SeanEZhou/slender-biped/README.md

# Slender-leg biped: can an ankle-less, footless robot leg balance and walk?

<table>
<tr>
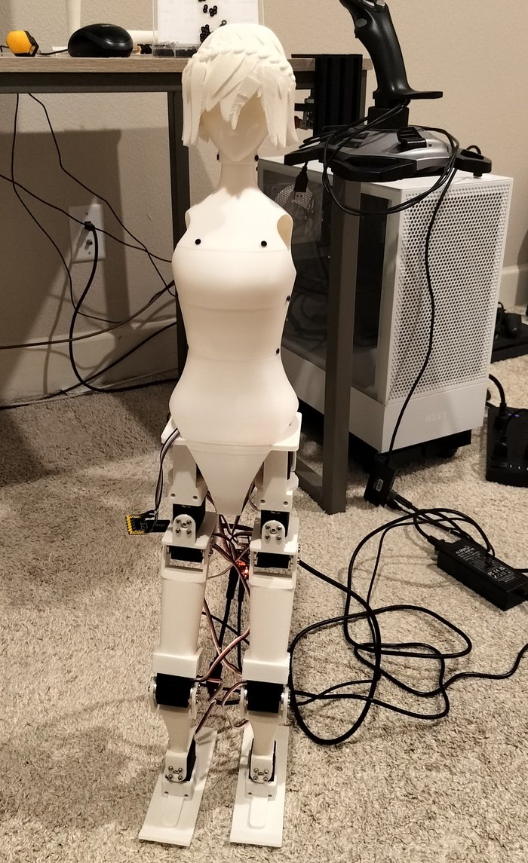
[picture p1: assets/photos/robot_standing.jpg]
The assembled robot standing on its snowboard pads
<td valign="top"><br><sub>The robot today: two printed legs with ankle roll, ten hobby servos, torso and head.</sub></td>
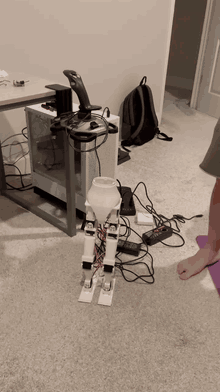
[picture p2: assets/gifs/real_legs_walk.gif]
The legs walking on their own
<td valign="top"><br><sub>First walk on the robot: legs and pelvis, policy <code>c3m_T12</code>, 10+ steps in most trials (§16).</sub></td>
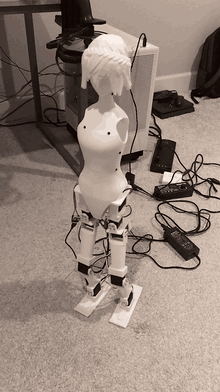
[picture p3: assets/gifs/real_full_body_1.gif]
The full robot marching under its own balance
<td valign="top"><br><sub>Full body, policy <code>c3f_T12</code>: balancing on its own while it marches, mostly in place.</sub></td>
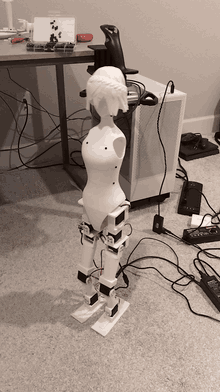
[picture p4: assets/gifs/real_full_body_2.gif]
The full robot marching, side view
<td valign="top"><br><sub>The same policy from another angle. No hand steadying it: every step is closed-loop on the IMU.</sub></td>
</tr>
</table>

### Where this project stands, and the pivot to ankles

The study began with a question: can a leg with **no ankle and no foot** (a slender shin ending in a tip) balance
and walk? **In simulation, yes.** The tip and small-pad designs stand, walk and stop on command (§3–8). **On the real
robot, no.** Every ankle-less design we built could stand, but none could walk:

- **The tip foot** (§14) stood still for minutes once set down in balance. But any step or push tipped it, because it
  balances only by correcting constantly, and the real servos react 4–9× later than the simulator first assumed.
- **Big snowboard pads without an ankle** (§15–16) stand almost passively. But each step began a sideways fall toward
  the lifted foot, even with a hip-roll weight shift first.

**The lesson: a frame that works in simulation only through precise, constant small corrections won't transfer.** The
real robot has servo lag, backlash, a slow motion profile, IMU error and a floor the model doesn't capture. A design
that needs every correction on time is flipped over by the first late one. A frame that transfers needs room for
error: a stance that holds while the controller is late or wrong.

So the design pivoted to **one ankle roll servo per leg** (§16). The hips and ankles lean both legs together, so the
weight moves over one flat board, and lifting the other foot is no longer a fall. With that, plus a calmer gait
trained by imitation and against wobble, the robot took its first real walks: 10+ steps in most trials with the legs
alone, and stable marching with the torso and head on.

Everything the project has learned, from servo modelling to reward weights to robot bring-up, is collected in
**[docs/lessons.md](docs/lessons.md)**.

**Contents**
- **The study:** [1. Concept](#1-concept) · [2. Design](#2-design-before-any-training) · [3. Training](#3-training) · [4. Results](#4-results)
- **Toward the real robot:** [5. P0 printable leg](#5-toward-hardware-the-p0-printable-leg) · [6. Training on the as-built model](#6-training-on-the-as-built-model) · [7. Real steps](#7-walking-with-real-steps-round-4) · [8. Walking on a line](#8-walking-on-a-line-round-5)
- **Building the body:** [9. Torso](#9-torso-design) · [10. Head](#10-head-design) · [11. Power delivery](#11-power-delivery) · [12. Full-body assembly and load test](#12-full-body-assembly-and-load-test) · [13. IMU](#13-imu)
- **On the robot:** [14. Sim to real: standing and recovering](#14-sim-to-real-standing-and-recovering-on-the-robot) · [15. Big feet for soft rugs](#15-big-feet-for-soft-rugs) · [16. Walking on the big pads](#16-walking-on-the-big-pads)
- **Reference:** [Lessons learned](docs/lessons.md) · [Engineering practices](#engineering-practices) · [Reproduce](#reproduce) · [Repository map](#repository-map) · [Limitations and next steps](#limitations-and-next-steps)

An end-to-end robotics design study:
1. **Concept:** a novel leg concept from character art.
2. **Physical model:** built from off-the-shelf servos with realistic mass, packaging and motor
   limits.
3. **Training:** GPU-trained reinforcement-learning policies.
4. **Validation:** an independent evaluation that tests whether the design actually works.

<table>
<tr><th></th><th>Stand (zero command)</th><th>Walk (0.15 m/s command)</th></tr>
<tr>
<th>Ball tip<br><sub>original concept</sub></th>
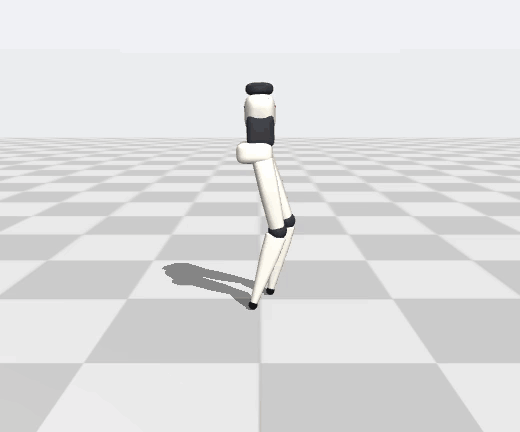
[picture p5: assets/gifs/stand.gif]
<td valign="top"><br><sub>balances by micro-stepping</sub></td>
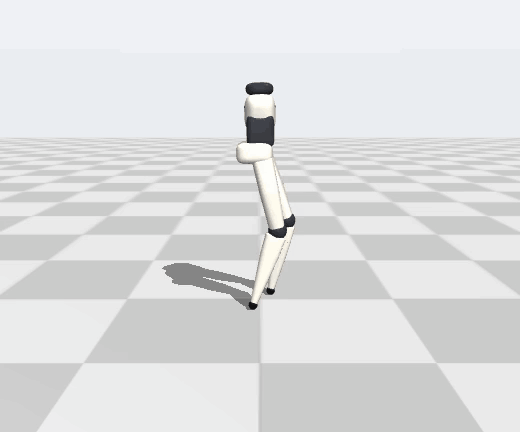
[picture p6: assets/gifs/walk.gif]
<td valign="top"></td>
</tr>
<tr>
<th>30 mm flat pad<br><sub>same leg, flat tip</sub></th>
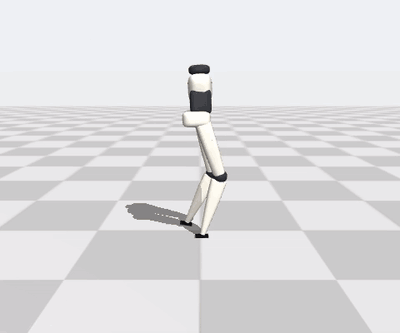
[picture p7: assets/gifs/pad30_stand.gif]
<td valign="top"><br><sub>stands still</sub></td>
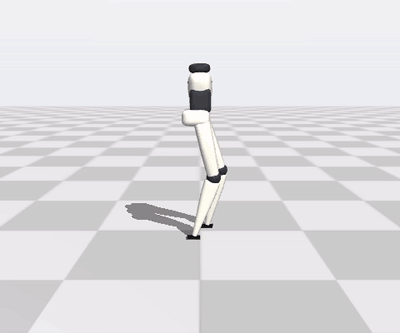
[picture p8: assets/gifs/pad30_walk.gif]
<td valign="top"></td>
</tr>
<tr>
<th>As built<br><sub>model from the printed CAD<br>and the real servos (§6)</sub></th>
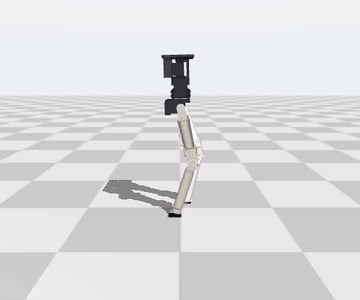
[picture p9: assets/gifs/hw_p0_stand_push.gif]
<td valign="top"><br><sub>stands still and recovers from 0.3 m/s shoves</sub></td>
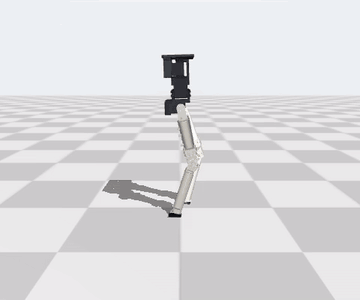
[picture p10: assets/gifs/hw_p0_walk_r5.gif]
<td valign="top"><br><sub>real steps on a straight, narrow "catwalk" line (§7–8)</sub></td>
</tr>
</table>

<p><b>Real hardware:</b> the printed P0 left leg (§5), bench-tested on a 5 V supply: sit-up on its own pad, kick, hip yaw.</p>
<p>
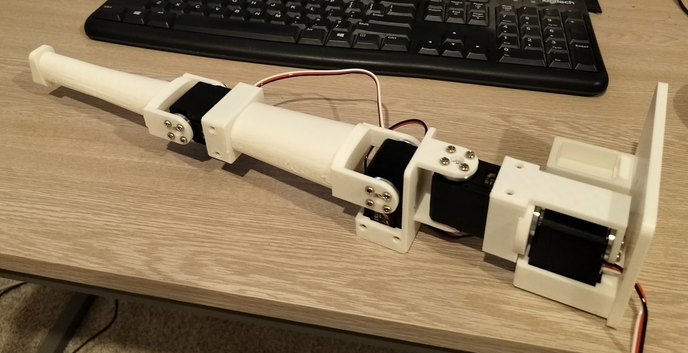
[picture p11: assets/photos/p0_leg_assembled.jpg]
Assembled P0 leg

</p>
<p>
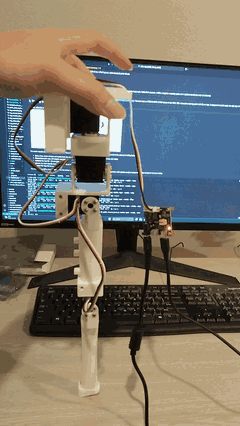
[picture p12: assets/gifs/bench_sit_up.gif]
Sit-up on the pad

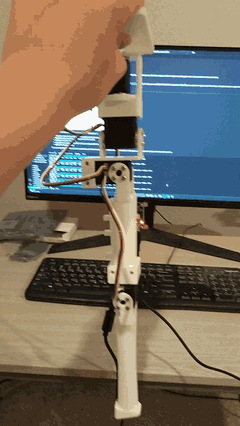
[picture p13: assets/gifs/bench_kick.gif]
Kick

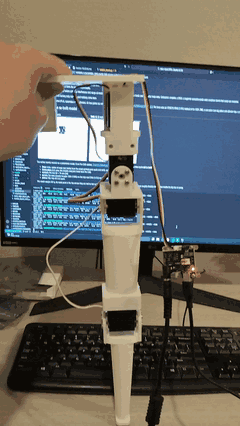
[picture p14: assets/gifs/bench_yaw.gif]
Hip yaw

</p>

**TL;DR**
- **The ball-tip design works dynamically.** A 38 cm, 0.85 kg biped on two 16 mm rubber balls,
  driven by eight off-the-shelf hobby servos (~$180 in total), stands indefinitely, walks straight and stops on command in
  simulation, with every servo inside its ratings.
- **It can never stand still.** It balances by micro-stepping about 6 times a second, under every
  reward and control variant I tried, including ideal sensors and 100 Hz control.
- **Feet are not the whole story.** Control experiments show that any flat contact removes the
  stepping. An ankle is not needed. Feet did not, however, fix the short walking steps.
- **A 30 × 18 mm flat pad at the shin tip is a viable compromise.** It keeps the silhouette and
  stood without lifting a tip in 85 % of runs. Training found that stance on 1 of 2 seeds.
- **The as-built robot works too (§6).** Retrained on a model generated from the printable CAD and the servos
  actually bought, it stands still (98 % without lifting a pad), survives shoves, and walks at 0.18 m/s while
  stopping on command 98 % of the time. Walking draws about 1.5 A at 7.4 V, with ~9 A peaks.
- **Real steps instead of a skitter (§7).** Every earlier walker took 5–7 tiny hops a second (2 cm, 60 ms in the
  air). Imitating a reference gait, with more double support, gives a walk with 6 cm steps, 160 ms of
  swing and 2 cm of foot clearance at 0.16 m/s, reproduced on 2 of 2 seeds; a curriculum narrows it into an
  elegant catwalk line. The cost: ~2.2 A instead of 1.5 A, with the hip servos at their rated torque.
- **Walking on a line, not drifting sideways (§8).** Those walkers held their heading but crabbed off it, and only
  ~20 % of walks passed 2 m within 0.2 m of the line: the policy had no way to sense sideways drift. Feeding it a
  path-offset estimate and rewarding the true offset fixes most of it. With leg odometry alone 40–78 % of walks stay on
  the line (depending on the training seed); with a ~$15 downward optical-flow sensor **100 %, with a median offset of
  4 cm**, a 61 mm catwalk track, and better stops (walk → stop → walk 98 %, no falls).

> **Status: walking on the robot, early.** With an ankle roll servo per leg (10 servos), trained walking policies run
> on the robot. The legs and pelvis take 10+ steps in most trials (`c3m_T12`). With the torso and head on, the robot
> balances and marches, mostly in place, and its servos buzz (`c3f_T12`, §16). The ankle-less designs that the
> earlier sections study work in simulation but not on the robot (§14, §16). Quiet standing on the IMU transfers (§14).
> The other standing and walking numbers come from held-out evaluation seeds in an independent simulator. Simulated
> feasibility is not validated hardware capability.

---

## 1. Concept

Android characters like [Aigis](https://hero.fandom.com/wiki/Aigis) and
[Elster](https://signalis.fandom.com/wiki/Elster_(LSTR-512)) have legs that taper to a narrow point:
no visible ankle and little or no foot. Real bipeds almost never look like this. They rely on wide
feet and ankle torque to move their centre of pressure.

<table>
<tr><th>Concept</th><th>My physical model (baseline A)</th></tr>
<tr>
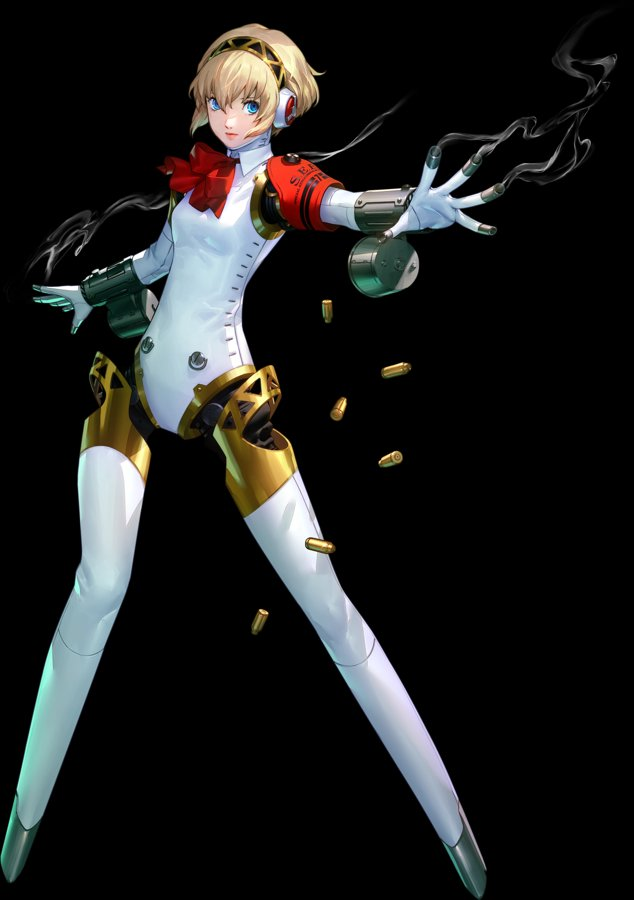
[picture p15: assets/concept/aigis_small.jpg]
<td></td>
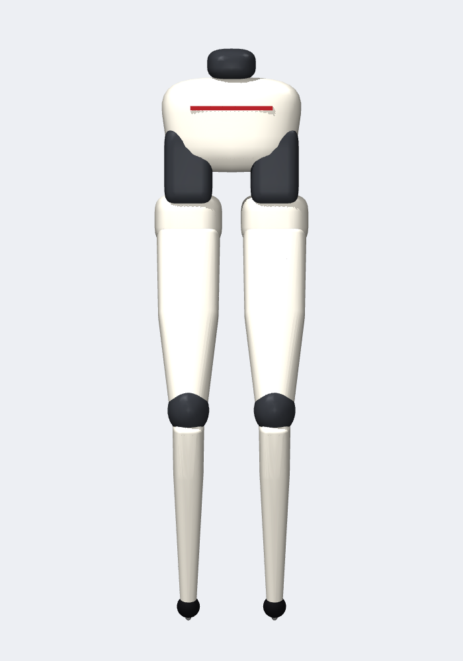
[picture p16: assets/renders/baseline_A_8dof/front_ortho.png]
<td></td>
</tr>
</table>
<sub>Concept art: Aigis, official artwork from <i>Persona 3</i> (© ATLUS), via the
<a href="https://hero.fandom.com/wiki/Aigis">Aigis wiki page</a>. Not my work; shown as design
reference for a non-commercial project and will be removed on request.</sub>
<br><br>

**The question:** can a hobby-scale biped with narrow hips, slender tubular legs, **no ankle and
no foot** learn to balance and walk, using parts anyone can buy? If not, what is the smallest
change to the silhouette that makes it work?

Why it is hard:
- **No support polygon.** A ball-tipped leg touches the floor at a single point. Two point
  contacts give no area to keep the centre of mass over, so the robot can tip about the line
  between them.
- **Weak, slow actuators.** Hobby servos are slow and torque-limited. A policy that only works with
  ideal actuators would be meaningless here.

## 2. Design (before any training)

### 2.1 Size and proportions

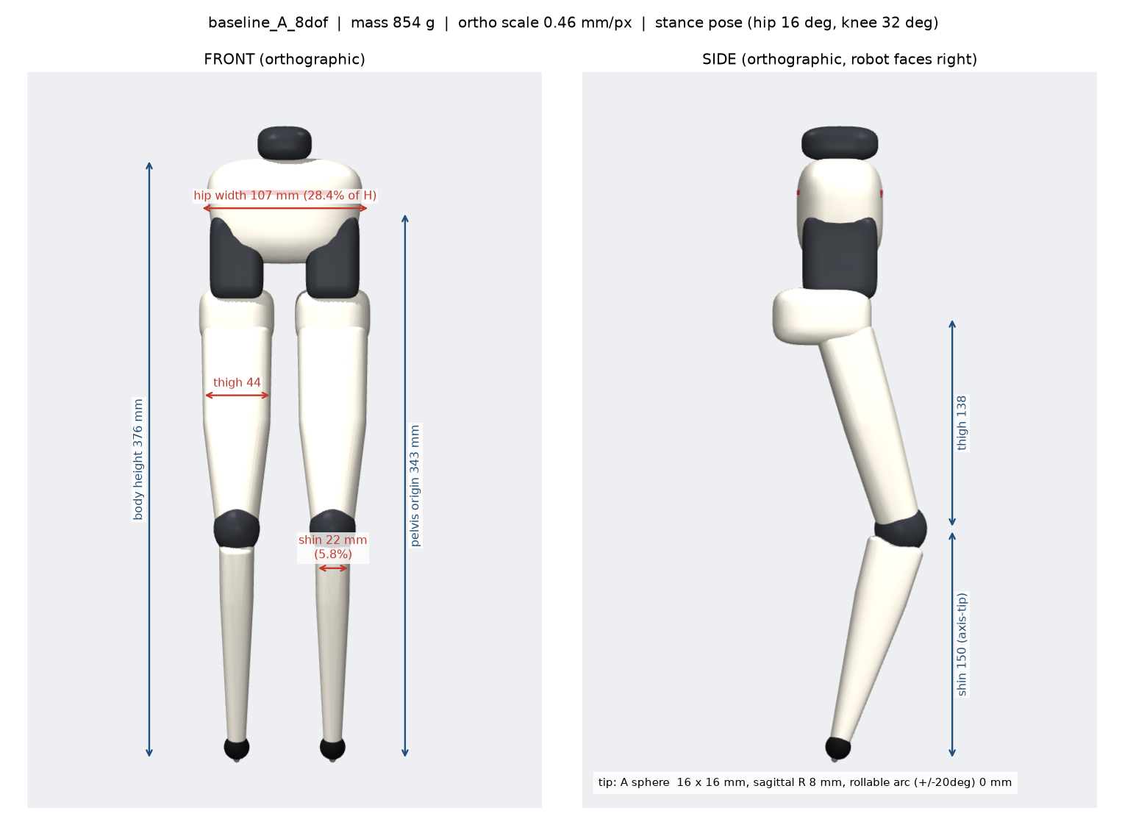
[picture p17: assets/renders/baseline_A_8dof/silhouette_dimensioned.png]


- **Scale:** I wanted a narrow pelvis and long, slim legs to get the slender, graceful form factor,
  at a hobby scale where cheap servos are credible: pelvis about 0.30–0.35 m off the ground and a
  0.6–1.0 kg lower body. The result is 38 cm tall and 0.85 kg.
- **Leg lengths:** thigh 138 mm, shin 150 mm (a long shin for the slender look).
- **Slimness targets:** hip width ≤ 24–28 % of height and shin width ≤ 9–12 %.
  - The shin reached **5.8 %**.
  - The hips reached **28.4 %**, just over the target: the 25 mm-thick servo cases set the floor.
- **Parametric generator:** the whole body comes from [`configs/geometry.yaml`](configs/geometry.yaml)
  as superellipse shells. Every part carries its real mass and inertia (servos, printed shells,
  brackets, electronics, battery), so the simulated centre of mass matches the CAD estimate.

### 2.2 Choosing off-the-shelf actuators

| candidate | stall torque | no-load speed | price | verdict |
|---|---|---|---|---|
| Feetech STS3215-C018 (12 V) | 2.94 N·m | 4.7 rad/s (45 rpm) | $32 | ✗ the knee can't swing faster than ~1 step/s |
| **Feetech STS3215-C046 (7.4 V)** | 1.41 N·m | 11.1 rad/s (106 rpm) | $25 | ✓ **roll, pitch and knee**, same 45 × 25 × 35 mm case |
| **Feetech STS3032 (6 V)** | 0.44 N·m | 11.6 rad/s | $15 | ✓ **hip yaw** (low load, small case) |
| ROBOTIS XC330 / XL330 | 0.92 / 0.52 N·m | 6.8 / 10.8 rad/s | $103 / $24 | slimmer hips, but speed-limited and ~3.4× the cost |

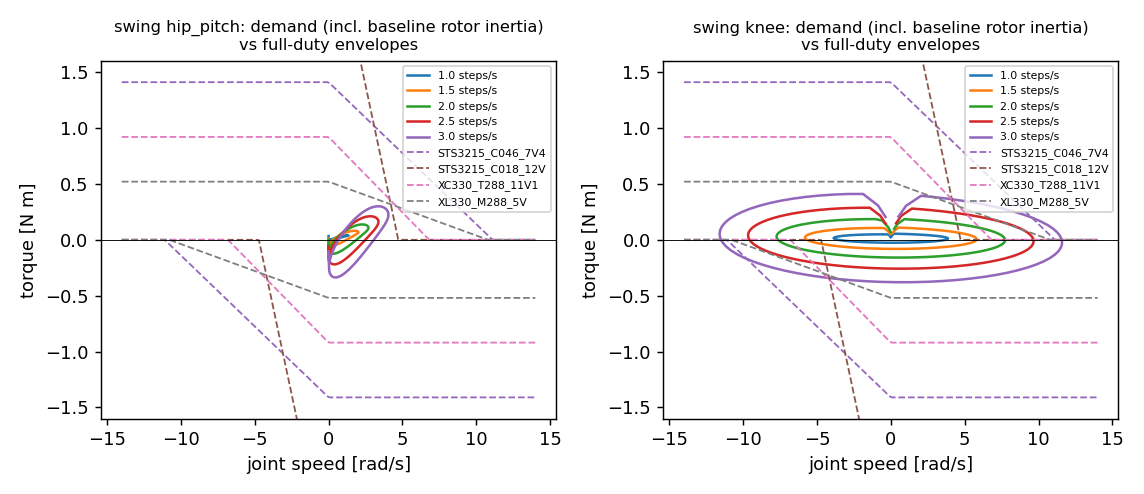
[picture p18: results/plots/swing_torque_speed_baseline_A_8dof.png]


The torque-speed audit above (`scripts/torque_audit.py`) runs before any learning. It overlays
the torque and speed that leg swing demands at 1–3 steps/s on each servo's DC-motor envelope:
- **Speed binds, not torque.** The 12 V servo has twice the torque, but its envelope collapses
  above ~4.7 rad/s, so it was rejected without spending any GPU time.
- **Choice:** the 7.4 V variant in the same case. Eight servos cost about **$180**.
- **Servo model:** every servo is simulated with its torque-speed curve, current limit, 4 ms bus
  latency, deadband, slew limit and reflected rotor inertia.

### 2.3 Servo placement and motion

<table>
<tr>
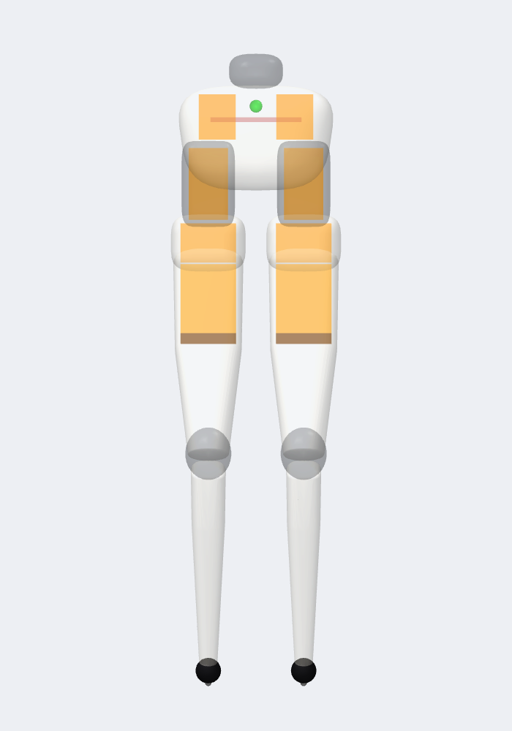
[picture p19: assets/renders/baseline_A_8dof/xray_front_ortho.png]
<td></td>
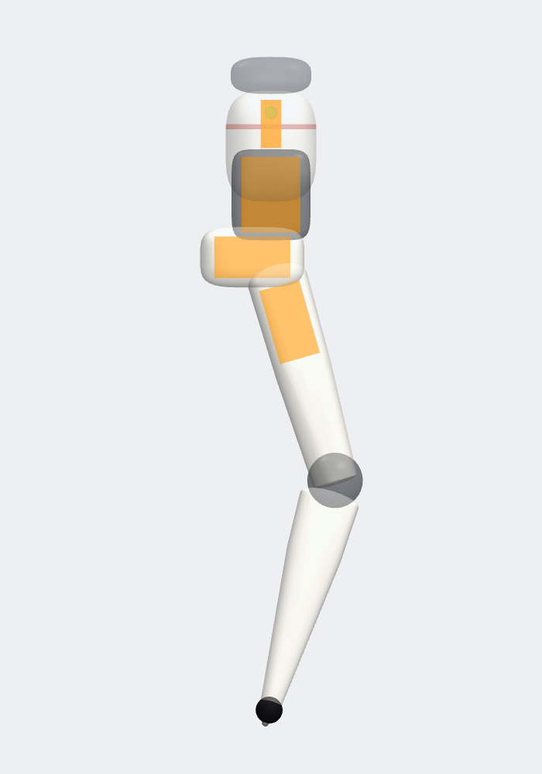
[picture p20: assets/renders/baseline_A_8dof/xray_side_ortho.png]
<td></td>
</tr>
</table>

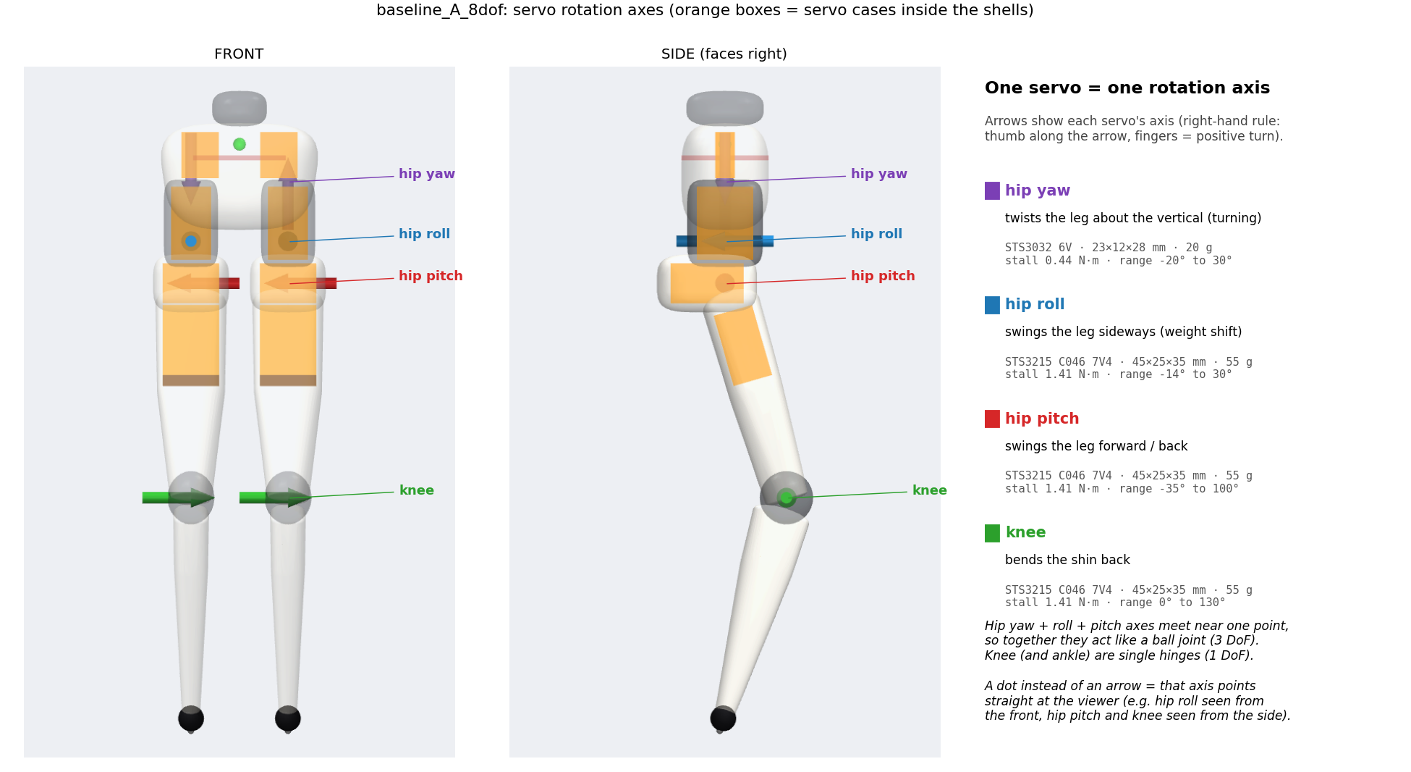
[picture p21: assets/renders/baseline_A_8dof/joint_axes.png]


- **Four servos per leg.** Hip yaw, roll and pitch sit stacked at the pelvis with their axes meeting
  near one point, so together they act like a ball joint. The knee is a single hinge.
- **Remote knee drive.** The knee servo lives in the upper thigh and drives the knee through a 1:1
  GT2 belt. That keeps the knee joint as slim as the concept art.
- **Packaging check.** It verifies that every servo case fits inside its printed shell with a
  1.2 mm wall.

### 2.4 Design candidates and pre-training screening

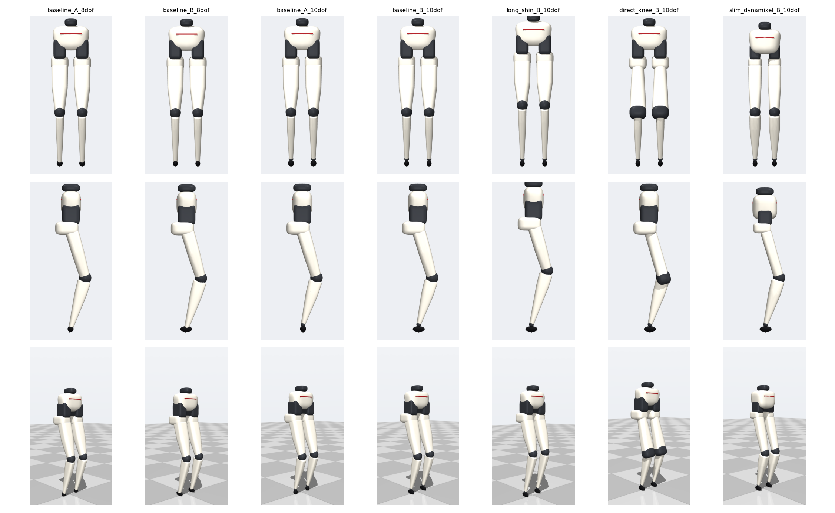
[picture p22: assets/renders/gate_A_variants.png]


Seven variants were generated and screened with three cheap checks before training:

| gate | what it checks | outcome |
|---|---|---|
| A: packaging & silhouette | servo cases inside shells, slimness ratios | `direct_knee` and `slim_dynamixel` flagged |
| B: torque/speed audit | static and swing demand vs servo envelopes | 12 V servo rejected; slim Dynamixel speed-limited |
| C: passive sanity | hold the standing pose with no balance policy | every variant falls within 0.7–1.1 s |

Two tip shapes went forward, a 16 mm ball (**A**) and a 32 × 13 mm elongated rocker (**B**), at
8 DoF. The 10-DoF ankle variant was dropped: an ankle can't shift the centre of pressure on a
point contact, so it adds mass for nothing. **Baseline A (ball tip, 8 DoF)** became the preferred
design.

## 3. Training

### 3.1 Pipeline

- **Simulation:**
  - MuJoCo 3.17 with **MJX on the GPU** for training: 4,096 parallel robots, 2 ms physics,
    50 Hz control.
  - An **independent CPU MuJoCo evaluator** for testing: full contact set, more accurate solver,
    and a NumPy re-implementation of the policy (identical to training inference).
- **Learning:** PPO (Brax) with an asymmetric actor-critic.
  - The **actor** sees only what the real robot can sense: IMU gravity and gyro, joint
    positions and velocities, last action, command and gait clock.
  - The **critic** also sees privileged state.
  - **Domain randomization:** friction, masses, CoM, rotor inertia, gear friction, servo
    strength, speed and gain, latency, and backlash.
- **Evaluation:**
  - **Acceptance gates:** stand 30 s, walk ≥ 2 m, walk → stop → walk, and servo load within
    ratings, each tested on **100 held-out seeds**.
  - **Checkpoint selection:** a rule declared in advance (highest in-training eval reward), never
    hand-picked from test results.
  - **Behaviour metrics:** lift-offs, foot sliding, step length, airborne vs sliding foot travel.

### 3.2 Iterating on the policies: challenges and fixes

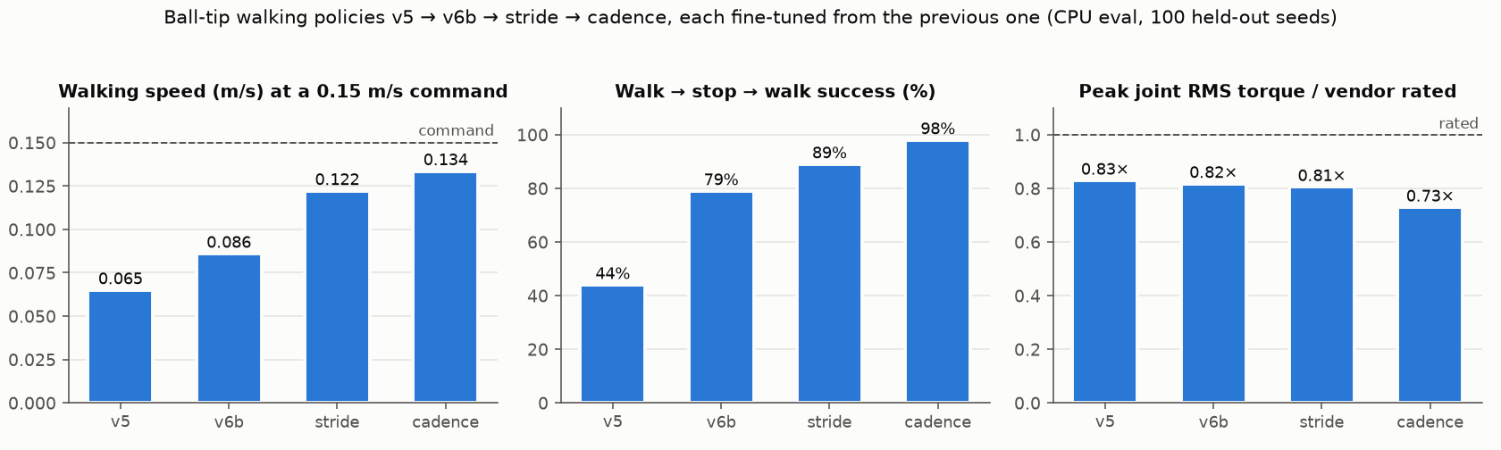
[picture p23: results/plots/policy_progression.png]


| problem I hit | diagnosis | fix |
|---|---|---|
| **Standing:** a quiet-stand reward taught the robot to *fall slowly* | with point feet, stepping is required; the reward fought the physics | reward stepping in place (v1) |
| **Standing:** v1 ran hip roll at 1.29 × rated torque | the simulator clipped torque, but nothing discouraged sustained load | sustained-torque, saturation and over-speed penalties (v2): ≤ 0.88 × rated, survival *up* 96 → 99 % |
| **Walking:** v2 stepped in place forever | reward exploit: alive + gait rewards paid more than tracking | stronger, wider velocity tracking (v3) |
| **Walking:** v3 walked but drifted 80° off course | yaw-rate tracking had no gradient through the micro-stepping jitter | heading command plus a direct heading-hold reward (v5) |
| **Walking:** v5 couldn't stop | a 0.09 m/s creep barely lost any tracking reward | sharp zero-command stop reward (v6) |
| **Walking:** v6 collapsed within 10 M steps | warm start re-initialized the **critic** at full learning rate | restore the critic, lr 1e-4 (v6b) |
| **Walking:** long runs regressed after their peak | forgetting and reward exploitation | declared checkpoint rule; short low-lr fine-tunes |
| **Walking:** speed only 57 % of command | — | stride and cadence fine-tunes: **0.134 m/s, 98 % start/stop, 0.73 × rated** |

Things I tried that **did not** work:
- **Domain-randomization fine-tune:** no robustness gain.
- **Push-recovery training:** pushes still break it.
- **Ball-tip stillness:**
  - quiet-stand fine-tunes and lift-off penalties never stopped the stepping;
  - nor did **ideal 100 Hz, zero-latency control**.
- **Strides:**
  - stride rewards from scratch: the ball falls within 3 s;
  - a hard cadence clock: the policy ignored it.
- **20 mm pad:** too small to stand still.

### 3.3 Training curves

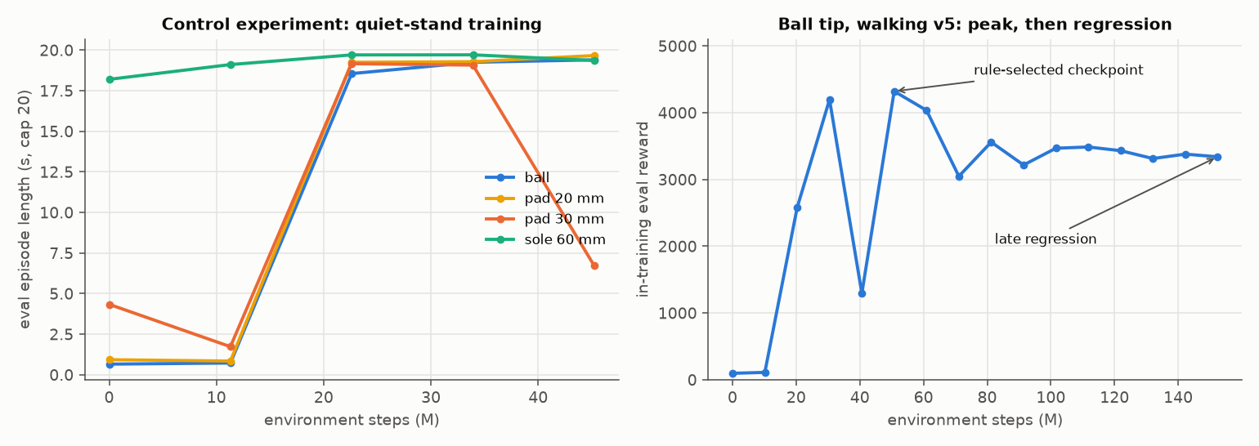
[picture p24: results/plots/training_curves.png]


- **Left:** in the control experiment, flat soles start out standing (their untrained policy
  already survives about 18 s). The ball and the small pads must first learn to step. The 30 mm
  pad run collapsed after its peak, and the declared rule picked the peak.
- **Right:** a typical walking run peaks and then regresses. This is why checkpoints are selected
  by a rule declared in advance.

### 3.4 Control experiments: is footlessness really the problem?

The ball robot never stood still. To find out whether that was the missing feet or something else
(reward, servos, control rate), I built **separate control frames**: the same legs, servos and
training recipe, but a different ground contact. Baseline A was not modified.

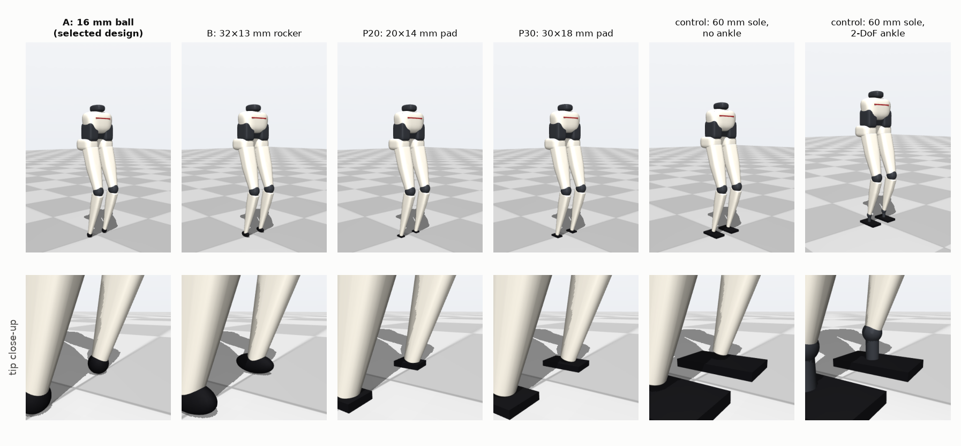
[picture p25: assets/renders/contact_candidates.png]


**Passive test, no policy** (servos hold the standing pose, clean start, 10 s):

| contact | survives |
|---|---|
| ball 16 mm | falls in **0.76 s** |
| flat pad 20 mm, pad 30 mm | **10 s** |
| flat soles 40–90 mm, with or without ankle | **10 s** |

Any flat contact has a static equilibrium; a ball has none.

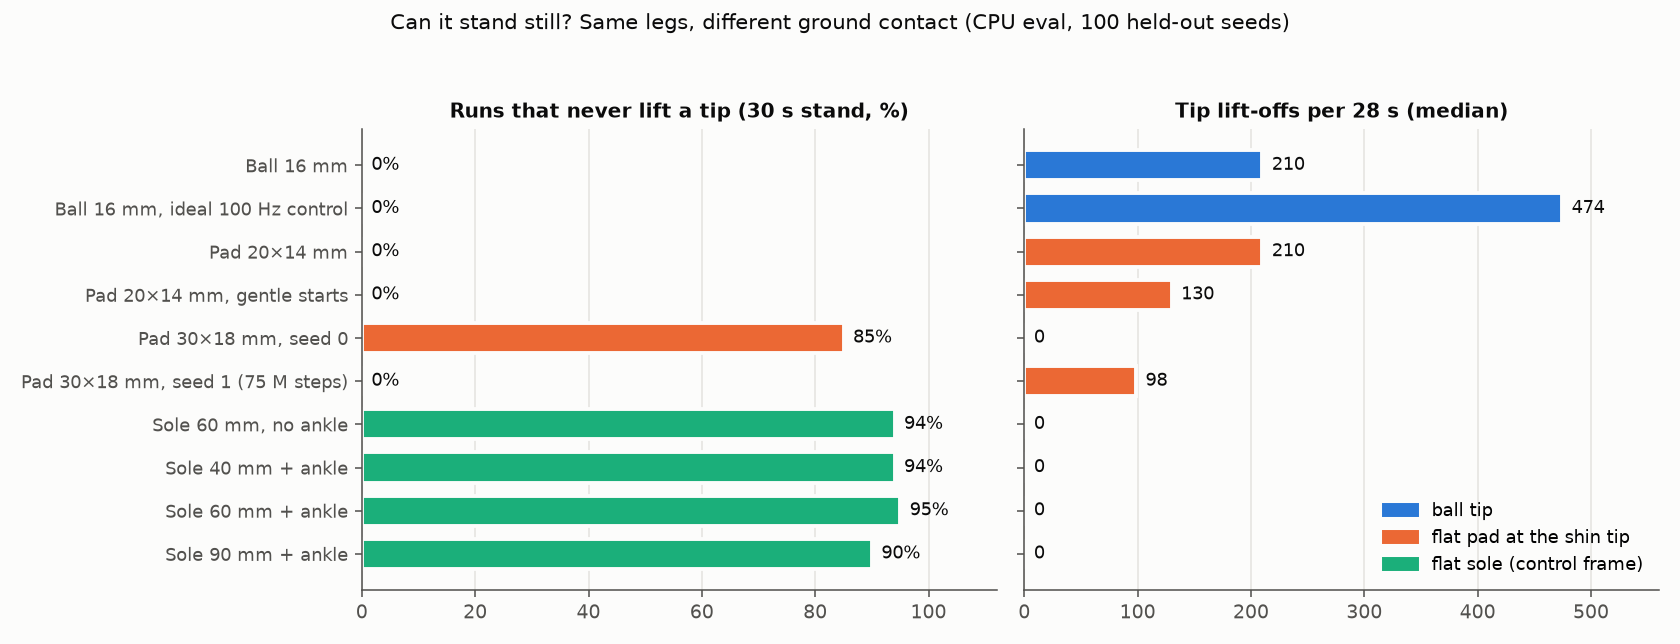
[picture p26: results/plots/contact_comparison.png]


Findings:

| contact type | stand still? | walk |
|---|---|---|
| **round ball** (16 mm) | never: ~6 steps/s, 210 lift-offs per run | dynamic, ~1.8 cm steps |
| **elongated rocker** (32 × 13 mm, round 1) | never: 7.6 steps/s | same as the ball (92 % vs 85 % reach 2 m) |
| **flat pad at the shin tip**, 20 mm | no: 5.3 steps/s | — |
| **flat pad at the shin tip**, 30 mm | **yes, 85 % no-lift** (1 of 2 seeds) | **3.6 cm steps**, 2× the ball |
| **flat soles** 40 / 60 / 90 mm with ankle | **yes, 94 / 95 / 90 %**; bigger soles slide less | skated or marched in place |
| **flat sole 60 mm without ankle** | **yes, 94 %**, the same as with an ankle | — |

What this shows:
1. **Point contacts force stepping.** Same reward, same legs: every flat contact large enough
   stops the stepping; the ball never does. Two point contacts leave a tip-over direction that no
   joint can resist.
2. **The ankle doesn't matter for standing.** A rigid sole stood as well as one on a 2-DoF ankle.
   The hip and knee can tilt a rigid flat contact well enough.
3. **Size threshold.** For this 0.86 kg robot, the threshold lies between a 20 mm pad (no) and a
   30 mm pad (yes).
4. **Feet do not fix short steps.** Under the ball's walking reward the footed robot *skated* its
   soles forward. Under a stride reward it *marched in place*. Short steps come from reward design
   and training, not the contact alone. Even so, the 30 mm pad doubled step length over the ball
   at an identical reward and initialization.

## 4. Results

### Ball tip (the original concept): balances and walks, but only dynamically

<table>
<tr><th>Stand (zero command): micro-steps</th><th>Walk (0.15 m/s command, heading hold)</th></tr>
<tr>
<td></td>
<td></td>
</tr>
<tr><th colspan="2">Walk → stop → walk</th></tr>
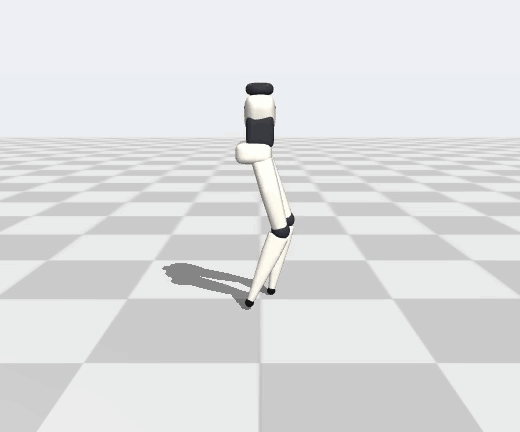
[picture p27: assets/gifs/start_stop.gif]
<tr><td colspan="2" align="center"></td></tr>
</table>

| gate (100 held-out seeds) | target | result (`cadence_A8_ft`) |
|---|---|---|
| free stand 30 s | ≥ 70 % | **100 %** |
| walk ≥ 2 m without falling | ≥ 70 % | **100 %** (40 s test, median 5.3 m, 1.5° heading drift) |
| walk → stop → walk | ≥ 50 % | **98 %** (0.14 → 0.01 → 0.14 m/s) |
| servo load | within ratings | RMS **0.46–0.73 × vendor rated**; peak joint speed 0.79 × no-load; 0 over-speed events |
| **stand still** | — | **never**: micro-steps ~6 times/s |

The ball-tip leg *can* balance and walk with cheap servos, which answers the original question.
But it can never stand still. A robot that must constantly step to stay up is not good enough for
the robot I want to build.

### 30 × 18 mm flat pad: a viable compromise

<table>
<tr><th>Stands without stepping</th><th>Walks (2× longer steps than the ball)</th></tr>
<tr>
<td></td>
<td></td>
</tr>
</table>

- **Same robot otherwise:** same 8 servos, no ankle, no foot. The pad is rigid at the shin tip, and
  the hip and knee servos keep it flat.
- **Standing:** 94 % survive 30 s, and **85 % never lift a tip**. Body motion is about 2 cm in
  30 s, in a split stance with one pad ahead of the other.
- **Walking:** 100 % reach 2 m. It reaches the full commanded speed (0.157 m/s) in **3.6 cm steps
  at 4.25 steps/s**; the ball takes 1.8 cm steps at 7 steps/s.
- **Caveats:**
  - Quiet stance was found on 1 of 2 training seeds; the second was still slowing its stepping
    after 75 M steps.
  - Standing and walking are separate policies, and the walking policy stops poorly (44 %).

### Footed control frames: why feet alone are not the answer

<table>
<tr><th>60 mm soles: stands still</th><th>Same robot "walking": skates its soles</th></tr>
<tr>
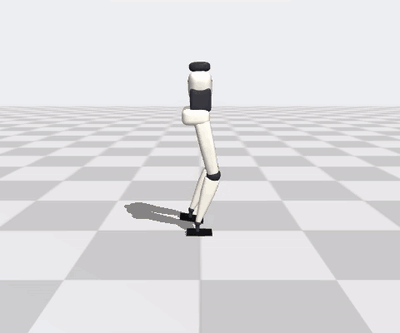
[picture p28: assets/gifs/footed60_stand.gif]
<td></td>
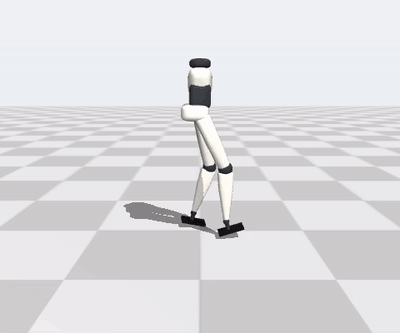
[picture p29: assets/gifs/footed60_skate.gif]
<td></td>
</tr>
</table>

### Verdict

| | ball tip | **30 mm pad** | flat feet (control) |
|---|---|---|---|
| silhouette | ✓ concept-faithful | ✓ almost unchanged | ✗ |
| balance and walk | ✓ dynamic | ✓ | ✓ stands; walking degenerate |
| stand still | ✗ never | **✓ 85 %** (1 of 2 seeds) | ✓ 90–95 % |
| step length | 1.8 cm | **3.6 cm** | skates / marches |

**The 30 mm flat pad gives up a little of the concept's needle-point look for quiet standing, and
is the design to take forward.**

## Engineering practices

- **Pre-training gates:** packaging, torque/speed and passive checks killed bad designs before any
  GPU time was spent.
- **Independent evaluation:**
  - a separate CPU simulator with the full contact model and policy re-implementation;
  - 100 held-out seeds;
  - a declared checkpoint rule, amended once and openly.
- **Honest reporting:** every run is logged in [`docs/experiments.md`](docs/experiments.md) (E0–E39,
  about 15 GPU-hours), including failures, collapses, a post-hoc pick I caught and relabelled, and a
  seed that did not reproduce.
- **Unattended GPU safety:** a one-job-at-a-time queue with a stall watchdog and a 30-minute
  health check (`scripts/queue_runner.sh`, `scripts/health_watch.sh`).
- **Tests:** 36 tests for model integrity, actuator limits, contacts and reproducibility.

## Reproduce

```bash
uv venv -p 3.12 .venv && uv pip install --python .venv/bin/python -r requirements.txt
.venv/bin/python models/generate_model.py && .venv/bin/python scripts/regen_train_models.py
.venv/bin/python -m pytest -q tests

# evaluate the included policies on CPU (100 held-out seeds)
.venv/bin/python scripts/evaluate.py cadence_A8_ft --test walk40 --params params_0020M.pkl
.venv/bin/python scripts/evaluate.py q2_stand_P30 --test stand --params params_0022M.pkl
.venv/bin/python scripts/gait_anatomy.py stride_P30_ft --params params_0020M.pkl
.venv/bin/python scripts/make_readme_figures.py   # regenerates the charts above

# train on a GPU (one job at a time)
scripts/gpu_python.sh scripts/train.py --name my_walk --model baseline_A_8dof --task walk --steps 150e6 --dr
```

## Repository map

| path | contents |
|---|---|
| `configs/` | parametric morphology including the control frames (`geometry.yaml`); servo catalogue with sources (`actuators.yaml`) |
| `models/generate_model.py` | MJCF generator: exterior shells, servo envelopes, collision primitives, training and evaluation contact sets; `models/ref/` reference-gait tables |
| `slender_biped/` | servo model, MJX training env, CPU evaluator, reference gait (`ref_gait.py`), morphology tools, renderer |
| `scripts/` | training, evaluation, gait quality and sideways drift (`drift_eval.py`, `drift_mjx.py`), walker/stander hand-over, audits, renders, figures, GPU queue and watchdogs |
| `hardware/torso_p0/` | printable torso: shape file, build script, thread test, renders, parts list |
| `hardware/head_p0/` | printable head: build script, print files, fit report, renders, paint previews |
| `hardware/head_p1/` | second head, H2, with sticker face: four design versions, each with build script, print files, fit report, renders |
| `hardware/leg_p0/power.md` | power requirements per servo, wiring layouts and component sizing |
| `hardware/leg_p0/software/` | servo bench tools: per-leg calibration configs, `feetech_bench.py` (one leg: zero, jog, sweep, routines, current), `biped_bench.py` (both legs together) |
| `hardware/imu/` | IMU test script for the RP2040 + MPU6050/6500 (MicroPython) |
| `runs/` | config and learning curve of every run; weights of the selected policies |
| `results/` | evaluation JSONs behind every number; plots |
| `docs/` | [spec](docs/project_spec.md) · [morphology](docs/morphology.md) · [actuator research](docs/actuator_research.md) · [feasibility](docs/actuator_feasibility.md) · [experiment log](docs/experiments.md) · [sim-to-real risks](docs/sim2real_risks.md) |

## 5. Toward hardware: the P0 printable leg

<br>
<sub>The assembled P0 left leg, printed in PLA: pelvis fixture and hip yaw (right), hip roll and pitch, thigh, knee and shin with the pad (left).</sub>

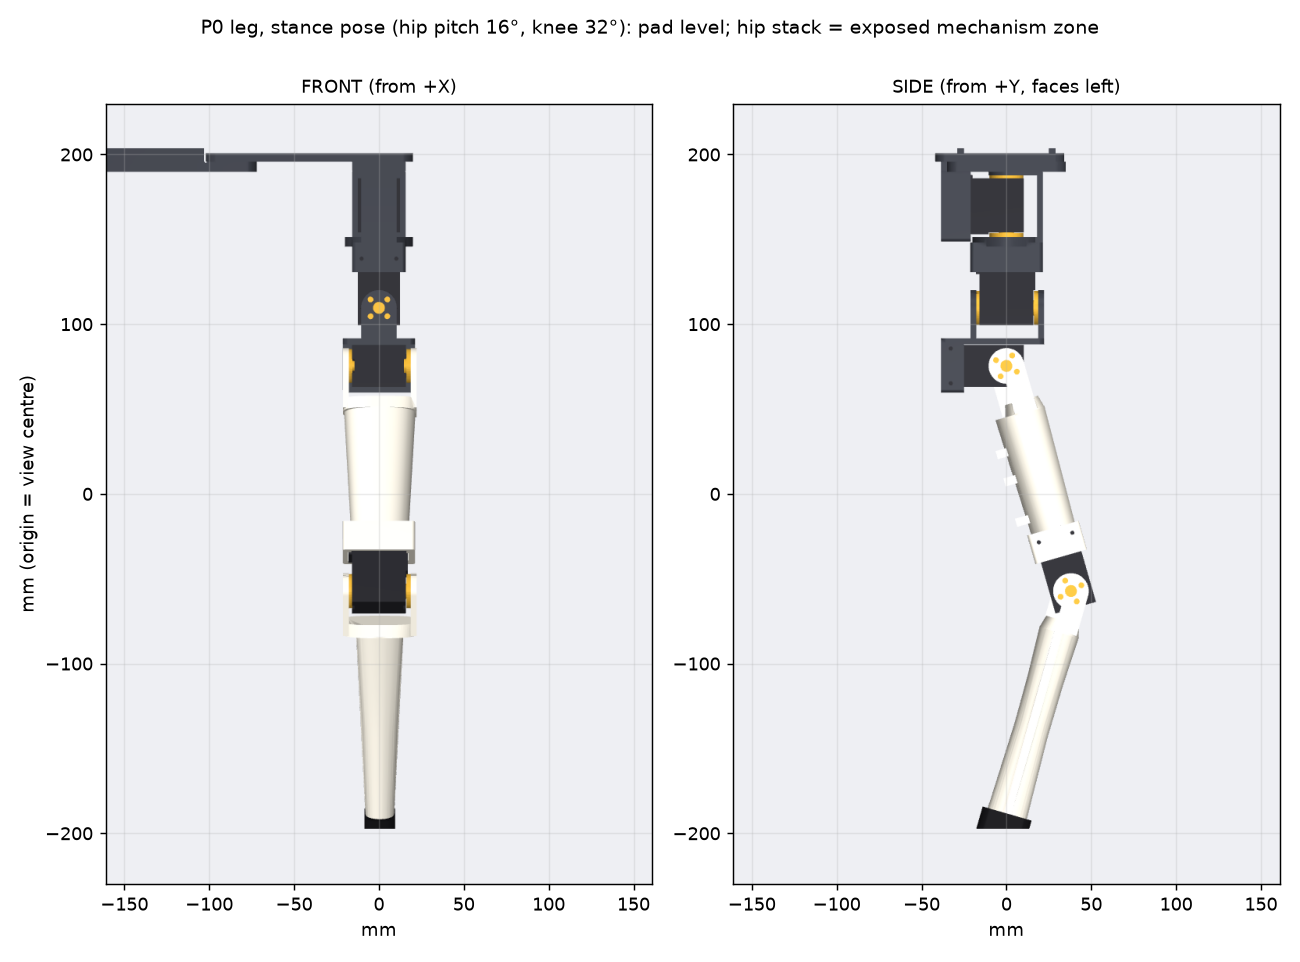
[picture p30: hardware/leg_p0/renders/leg_silhouette_dimensioned.png]


The next step is a real leg. [`hardware/leg_p0/`](hardware/leg_p0/) contains a parametric,
print-ready CAD of one 4-DoF leg on a desk-clamped pelvis fixture:
- **Build123d source:** regenerate with one command.
- **Exports:** STL, 3MF and STEP for every part, plus mirrored right-leg parts and print-oriented copies.
- **Servos:** Feetech STS3215s with a **direct-drive knee** (no belt): C001 (1:345) at the hips and a
  faster C044 (1:191) at the knee.
- **Pad:** the 30 × 18 mm flat pad from the control experiments.

The CAD is checked automatically before printing: interference and range-of-motion sweeps include
servo dummies, screw heads and connector keep-outs. Calibration coupons, a BOM, a beginner assembly
guide and a bench tool ([`software/feetech_bench.py`](hardware/leg_p0/software/feetech_bench.py)) are
included.

### 5.1 From a first print that didn't fit to a full leg

**The first test print didn't fit.** The yaw bracket was built from the servo's datasheet drawing, and:
- **Screws:** the horn screw holes were sized for M2, but the STS3215 horns take M3, so no screw went in.
- **Pocket:** the case pocket was the wrong shape. The recess for the bump around the idler horn was too
  narrow and jammed the servo.
- **Counterbores:** one bracket arm was counterbored all the way through, which left the screw heads
  nothing to bear on.

**The fix was to borrow from an arm that already works.** The open-source
[SO-101 / SO-ARM100](https://github.com/TheRobotStudio/SO-ARM100) robot arm uses the same STS3215 servo.
Its follower-arm STEP files give the real case geometry, and its build guide gives the screw sizes.
- **Pocket:** I measured the case-bump widths from that STEP (horn side 7.0 mm, idler side 9.1 mm
  half-width) and checked every joint against the real servo shape: zero overlap in all four.
- **Screws:** M3×6 horn screws through 3.4 mm holes, and M2×6 self-tappers into the case, as on the
  SO-101. Each counterbore leaves 2 mm of wall under the head.

After that one correction, every part printed afterwards (P03–P07, the pad and the P08 pelvis) fit the
servos and screws first time, and the full leg went together without rework. The only other print change
was a solid shin: the hollow version let the pad socket break into the cavity.

### 5.2 Bench tests

Each servo was zeroed with the leg square, given its direction, and then swept on its own and with its
neighbours. After that, the whole leg ran keyframe routines. In the clips below, the hand only steadies the
pelvis fixture.

<p>
Sit-up on the pad
Kick
Hip yaw
</p>

- **Sit-up (left):** the leg stands on its pad, squats and rises under its own power, without being lifted.
- **Kick (middle):** hip pitch and knee swing the shin through a kick.
- **Hip yaw (right, the `look` routine):** turns the leg to both yaw limits while it stands on the pad.

**The leg is ready to bear load.** P0 was designed for unloaded bench motion, with weak brackets as a flagged
risk. In practice the PLA parts are strong enough to stand on: in the sit-up the leg carries the hip and
pelvis fixture on its pad and pushes back up to standing by itself, with no visible flex at the brackets
and no slipping at the horns. That is on a 5 V bench supply, where the servos are slower and weaker than at their
rated 7.4 V.

**Status:**
- **Left leg:** printed in PLA, assembled, calibrated (all four joints) and load-tested.
- **P08 pelvis:** a one-piece two-leg pelvis with 80 mm hips, printed and in use.
- **Right leg:** the mirrored part set, printed, assembled and calibrated (§12).

### 5.3 Unexpected setbacks

Build problems that weren't design or training issues, and what they taught us. (The first-print misfit
in §5.1 was the earliest.)

**One pair of servo horns short.** The servos arrived one main/idler horn pair short. Rather than wait,
we tried printing replacements on a Bambu A1 (PLA, 0.4 mm nozzle).
[`cad/horns.py`](hardware/leg_p0/cad/horns.py) builds them from the horn drawing in the
[STS3215 spec sheet](https://files.seeedstudio.com/products/Feetech/108090023_STS3215-C001_Datasheet.pdf)
(section 10, Accessories). The outputs are in
[`exports/stl/print_ready/horns/`](hardware/leg_p0/exports/stl/print_ready/horns/).

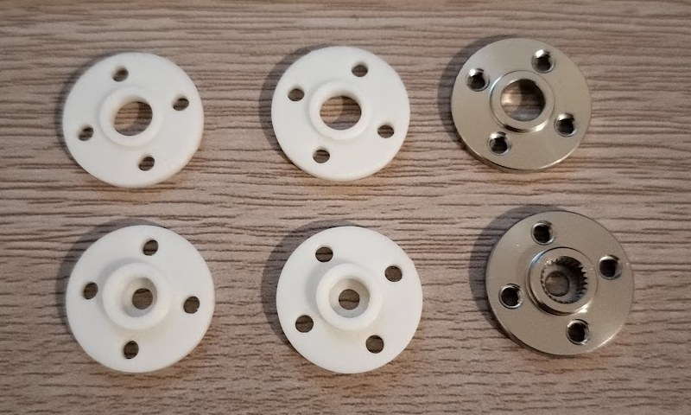
[picture p31: assets/unexpected_setbacks/3d_printed_horns_crop.jpg]
Printed and stock STS3215 horns


<sub>Top: idler horns, two printed and the stock one (right). Bottom: main horns, two printed and the stock
splined one (right).</sub>

- **Idler (passive) horn: printing worked.** The first attempt took its size from a 3D model rather than the
  drawing, and its centre hole was far too small. The drawing shows a 6.05 mm bore that turns on the servo's
  rear shaft. Printed from the drawing, the 6.25 mm variant spins freely and is in use. The M3 mounting holes
  also needed 2.8 mm instead of 2.5 mm before an M3 machine screw would thread into PLA.
- **Main (driven) horn: printing didn't work.** The output shaft has 25 teeth only about 0.3 mm tall. That is
  smaller than the 0.4 mm nozzle's line, so the slicer smooths the teeth into a plain round hole; layer
  height plays no part. Plain bores meant for the shaft's teeth to bite into (5.7 and 5.8 mm) were still too
  tight to press on. Replacement horns were ordered.

**Lesson:** a smooth bore (the idler horn) can be printed straight from the manufacturer's drawing. A fine
spline (the main horn) can't be made with teeth on an A1 with a 0.4 mm nozzle; a 0.2 mm nozzle or a resin
print might manage it, but for a load-bearing joint a stock metal horn is the right part anyway. Keep a few
spare main horns on hand.

## 6. Training on the as-built model

<table>
<tr><th>Stand, with 0.3 m/s shoves</th><th>Walk (0.15 m/s command)</th></tr>
<tr>
<td></td>
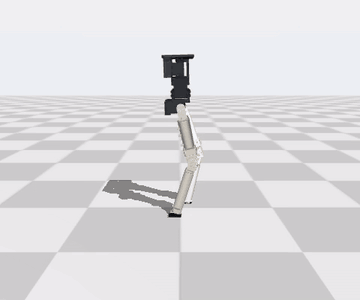
[picture p32: assets/gifs/hw_p0_walk.gif]
<td></td>
</tr>
</table>

The earlier rounds trained on a parametric model. Once the CAD existed,
[`cad/sim_model.py`](hardware/leg_p0/cad/sim_model.py) generated a MuJoCo model of the robot **as it will be
built**:
- **links:** mass, centre of mass and inertia from the actual printed parts (walls and infill), servo cases,
  horns, screws and cables;
- **kinematics:** joint axes, link lengths and joint limits from the CAD;
- **contact:** the real 30 × 18 mm pad;
- **servos:** the ones actually bought, C001 (1:345) on the hips and C044 (1:191) on the knee;
- **pelvis:** P08, hips 80 mm apart.

The result weighs 907 g. Its weak point is the hip servos: they are half as fast as the servo the earlier
rounds assumed, and their 1:345 gearbox roughly doubles the effective inertia the hip has to swing.

| as-built model, 100 held-out seeds | result |
|---|---|
| stand 30 s (`hw_stand_push2`) | 98 % up, 98 % without lifting a pad; survives 20 s of 0.3 m/s shoves |
| walk at a 0.15 m/s command (`hw_walk_scratch_stride2`) | 98 % reach 2 m, **0.178 m/s**, stops and restarts on command 98 % of the time |
| same walker, push-trained (`hw_walk_best_push`) | 87 % keep walking under 0.2 m/s shoves |
| supply current at 7.4 V | quiet stand 0.4–0.7 A; walking ~1.5 A mean, ~9 A peaks over 20 ms ([power and wiring](hardware/leg_p0/power.md)) |

What the 23 runs showed ([experiment log](docs/experiments.md), E40–E45):
- **Training mattered more than hardware.** Transferring the earlier walker capped the as-built robot at
  about 0.09 m/s. A gait learned from scratch on the new model, then refined, reached 0.178 m/s on the
  same servos. That walker was found on 1 of 2 training seeds.
- **Cheap changes didn't help.** A fully charged 8.4 V pack, 40 mm pads and 60–70 mm hips stayed within
  the seed-to-seed spread.
- **The one reliable hardware gain needs two changes together:** faster C046 servos on roll/pitch/knee
  *and* 60 mm hips (0.15–0.17 m/s on 3 of 3 seeds). Either alone did nothing: narrower hips only pay off
  once the hips are fast enough.

## 7. Walking with real steps (round 4)

<table>
<tr><th>Before: the round-3 walker</th><th>After: side</th><th>After: facing (catwalk line)</th></tr>
<tr>
<td></td>
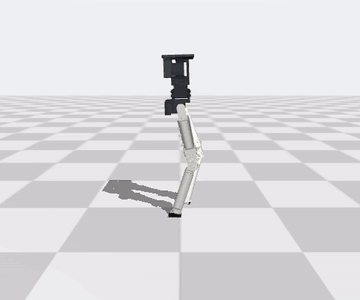
[picture p33: assets/gifs/hw_p0_walk_r4.gif]
<td></td>
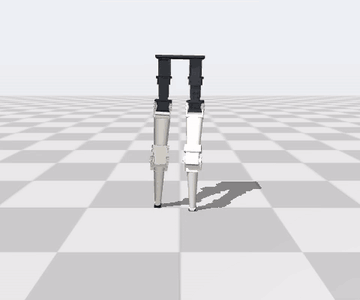
[picture p34: assets/gifs/hw_p0_walk_r4_front.gif]
<td></td>
</tr>
</table>

The round-3 walker reached 0.178 m/s, but it **skittered**: 5–7 tiny hops a second, 60 ms in the air, 2 cm per
step and ~5 mm of foot clearance. Reward shaping alone kept finding that gait. Round 4 (11 GPU-hours, 28 runs,
[E46–E56](docs/experiments.md)) gives the policy a *reference gait* to imitate instead:
[`ref_gait.py`](slender_biped/ref_gait.py) computes a walking pattern for the as-built leg by inverse kinematics on
the CAD model, and the policy outputs corrections around it.

| at a 0.15 m/s command, as-built model | round-3 best (skitter) | **round 4, catwalk** (`r4k_cat2_ft`) |
|---|---|---|
| foot travel per step | 2.4 cm | **6.2 cm** |
| time in the air per step | 60 ms | **160 ms** |
| swing clearance | 5 mm | **19 mm** |
| share of foot travel spent sliding | 22 % | **9 %** |
| step width (feet side to side) | 189 mm | **72 mm** (inside the 80 mm hips) |
| reach 2 m in 40 s / speed | 98 % / 0.178 m/s | **100 % / 0.162 m/s** |
| supply current, mean | 1.5 A | 2.2 A |
| hip servos, RMS torque / rated | 0.83 | **1.0** |

> **Correction (round 5):** "straight" in this section means the walkers *held their heading*. They still crabbed off
> it and drifted up to 2 m sideways in 20 s, which none of the round-4 metrics measured. §8 fixes most of it.

What made it work, and what didn't:
- **Imitation gives real steps; it does not move an existing gait.** From scratch, the reference produced
  real 200 ms swings within 20 M steps. Fine-tuning the skitter with the same rewards kept the skitter.
- **The "marching in place" was walking in circles.** The first imitation walkers moved forward at
  0.09 m/s but turned 3–4° a second, so they went nowhere. With 80 % of the time on one small, edge-loaded
  pad, a footless leg has almost no grip in yaw. Stronger heading rewards and freeing the hip-yaw joints
  didn't help; **more double support did** (both pads down ~30 % of the cycle), and so did a faster
  3.6–4.2 steps/s reference.
- **A modelling fix:** the pad's twisting friction was defined in the CAD-derived model but switched off by a
  contact setting. Turning it on halved stop failures and cut hip overspeed 10× for the same recipe; the
  round-3 walker is unaffected.
- **Elegance by curriculum.** A narrow track can't be learned from scratch. Narrowing the reference in stages,
  then penalizing wide feet, took the stance from 116 mm (the skitter: 189 mm) to 72 mm, with a slight pelvis
  twist and a higher swing.
- **Standing:** no walker learned to stand still at zero command. Handing over to the round-3 standing
  policy does: walk → stop → walk succeeds 85–88 % of the time with 0–5 % falls
  ([`switch_eval.py`](scripts/switch_eval.py)).
- **Didn't help:** sharper tracking or slip penalties from scratch (no learning), push training (more robust,
  but the gait reverted to a skitter), stronger torque penalties and 60 mm hips (the hip servos stay at
  their rated torque). **Real steps on the C001 hip servos mean warm hips**; see
  [power and wiring](hardware/leg_p0/power.md).

## 8. Walking on a line (round 5)

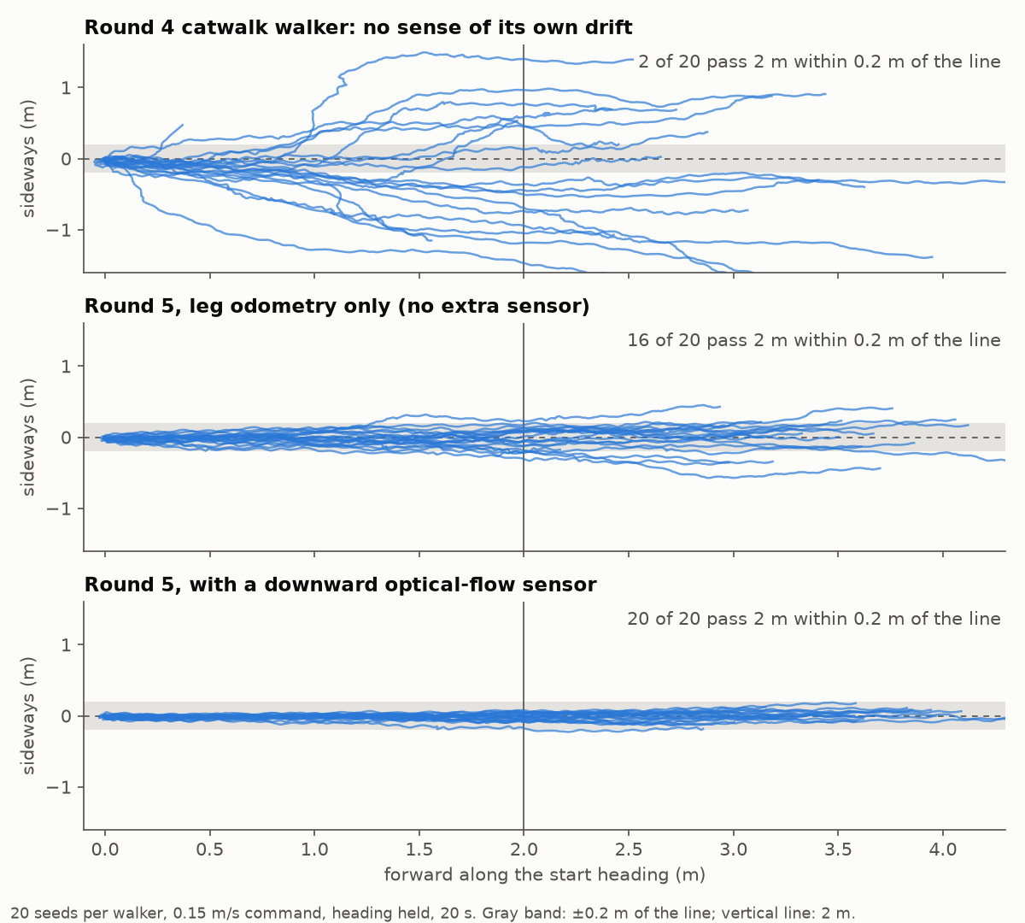
[picture p35: results/plots/walk_paths_r5.png]


<table>
<tr><th>Side</th><th>Facing (61 mm catwalk line)</th></tr>
<tr>
<td></td>
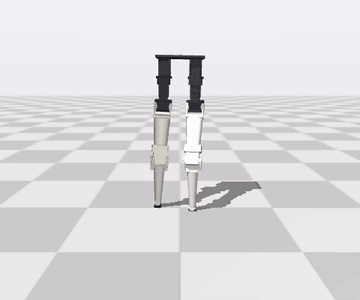
[picture p36: assets/gifs/hw_p0_walk_r5_front.gif]
<td></td>
</tr>
</table>

With the heading loop on, the round-4 catwalk walker kept facing forward but walked several degrees off that
direction, a crab, and only 22 % of runs passed 2 m within 0.2 m of the start line. It ignored sideways commands and had no
input that could tell it it was drifting. Round 5 (7 GPU-hours, 21 runs, [E57–E63](docs/experiments.md)) closed
that loop; [`drift_eval.py`](scripts/drift_eval.py) is the new measure.

| 0.15 m/s command, heading held, 50 seeds | round 4 catwalk | **leg odometry**¹ (`r5q_legs_path`) | **+ optical flow** (`r5p_flow`) |
|---|---|---|---|
| passes 2 m within 0.2 m of the line | 22 % | **78 %** | **100 %** |
| sideways offset at 2 m, median | 0.46 m | 0.12 m | **0.04 m** |
| crab angle, median | 8.5° | 3.8° | **1.9°** |
| step / air time / width | 6.4 cm / 160 ms / 72 mm | 5.8 cm / 170 ms / 63 mm | 5.3 cm / 140 ms / **61 mm** |
| walk → stop → walk (with the stander, 100 seeds) | 85 %, 5 % falls | 95 %, 1 % falls | **98 %, no falls** |
| supply current, mean | 2.2 A | 2.2 A | **1.8 A** |

¹ Seed 0. On seed 1 the same recipe gives 40 %, so 40–78 % across seeds. The flow result is also seed 0; on seed 1 the
flow walker gets much straighter (24 → 58 %, median offset 9 cm) but slows to 0.10 m/s.

What it took, and what didn't help:
- **Velocity feedback is not enough.** Giving the policy its velocity (leg odometry, accelerometer + history,
  even the true velocity) and rewarding sideways speed reached 20–42 % at best. Like a proportional-only
  controller, it leaves a small steady error that adds up to drift.
- **Position feedback works.** The policy sees its offset from the commanded path, integrated from its own
  odometry, and is rewarded on the true offset. It now follows sideways commands too (±0.05 m/s for 20 s →
  ±1.0 m).
- **Reward design mattered twice.** A sideways-speed reward that was too narrow gave no gradient at the errors
  that mattered, and a smoothed speed still contained the gait's own ±0.2 m/s sway. Averaging over exactly
  one gait cycle cancels the sway.
- **Train with the sensor you will deploy.** Swapping a better estimate into a trained policy changed little;
  fine-tuning with it did. Leg odometry jumps up to ~10 cm whenever a planted pad slides, which no encoder can see.
  A downward-facing optical-flow sensor measures the floor directly; even at twice the modelled error it keeps
  94 % of walks on the line.
- **Didn't help:** wider sideways-speed rewards alone (the gait shrank to 3 cm shuffles), mirror-symmetry
  augmentation (no gain in three runs), a normal-width stance (straighter in metres, but only because it walked at
  half speed), and simply training longer (steps shrink again after ~20–30 M steps, so checkpoints are chosen on
  gait as well as drift).

## 9. Torso design

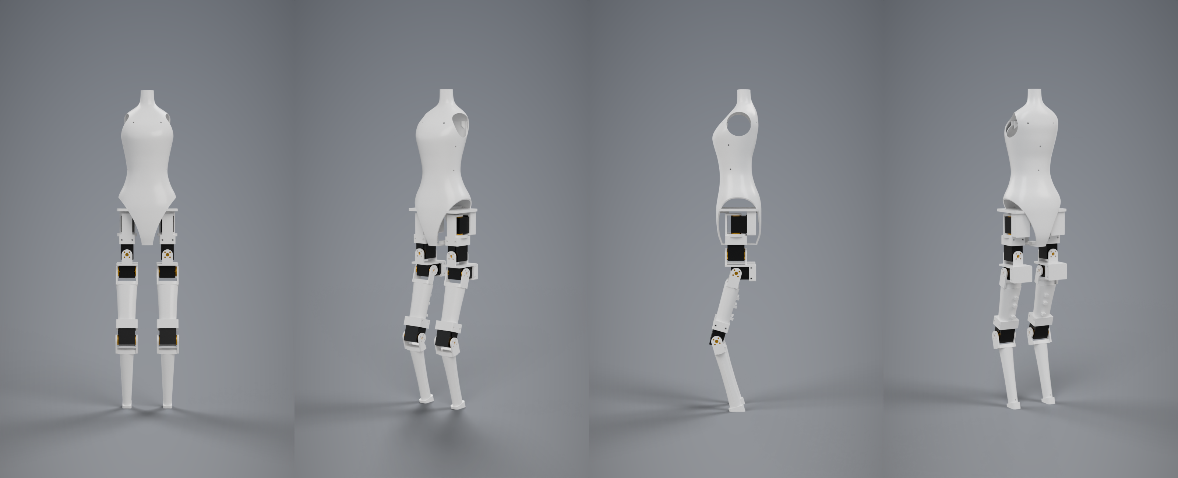
[picture p37: hardware/torso_p0/renders/torso_whole.png]


The legs needed a body. I designed a torso that carries their slender look upward, with a narrow waist, a soft rounded
chest and a slim neck in one smooth white surface, while the bare black servos stay as the only dark accents. The hard
part was mechanical: the shell had to look effortless while wrapping a wide hip plate, staying out of the way of four
moving joints per leg, and fitting on a small printer.

### 9.1 Keeping the hips slim

The legs need 80 mm between the hips to avoid colliding, which makes the hip plate 120 mm wide. A body that enclosed
the plate came out about 150 mm across the hips. It looked heavy and hid the top of the legs, working against the
long-legged look the whole project is built around.

So I stopped trying to enclose it. Below the plate, the hips narrow to a triangular panel that passes between the legs,
with a large opening on each side where the plate and hip-yaw servos stick out. That took the hips down to 115 mm and
turned the mechanism into part of the look.

### 9.2 Proving form didn't cost function

A shell this close to the joints is only useful if it never limits the legs that the walking policies depend on. I
scripted a collision check of the printable parts against the leg CAD instead of judging clearance by eye, and every
check came back with no interference (one leg tested, relying on the robot's mirror symmetry):

- 29 leg poses across the yaw, roll, pitch and knee bench ranges;
- the fixed hip plate and yaw servos;
- neighbouring torso pieces;
- the hip panels along their full slide-in path, with the legs attached.

### 9.3 Designing for the printer and for future access

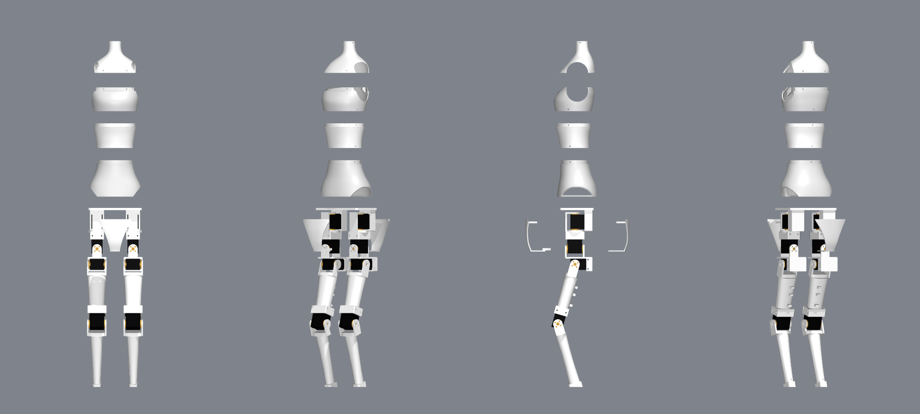
[picture p38: hardware/torso_p0/renders/torso_exploded.png]


The torso is too tall for my Bambu A1, so I split it into horizontal sections. That solved a second problem too: the
hip plate stays reachable for future electronics. Taking out a few screws and lifting off the upper sections opens up
the whole body, with no glued joints to break.

The seams follow the shape: one sits at the waist, the narrowest point, and another runs through the centre of the arm
openings, so they nearly disappear in the assembled body. The hips were the one place a simple stack
couldn't work, because a one-piece hip would trap the plate between its upper ring and the part that passes between the
legs. Splitting it into front and rear panels means they can be fitted or removed with the legs still attached.

### 9.4 Status

The torso is designed and checked in CAD and is ready to print, but hasn't been built yet, so its fits are still
unproven. It adds about 213 g, against roughly 408 g per leg, with its centre of mass about 80 mm above the plate.
That's a significant change to the robot's balance, so the walking policies will need retraining with it before
walking with the torso on.

### 9.5 Build notes

For anyone recreating this. Full assembly steps are in the [torso README](hardware/torso_p0/README.md), and the parts
list is in [`BOM.csv`](hardware/torso_p0/BOM.csv).

| part | role |
|---|---|
| T01, T02 hip panels | slide in from the front and rear; one screw joins them between the legs |
| T03 pelvis ring | bolts through a small floor to the plate's existing M3 holes, clamping the panels' ears under the plate |
| T04 midriff, T05 chest, T06 shoulders | stack on 8 mm sleeves, each held by 3–4 M3x8 screws; the arm openings are 48 mm |

- **Print first:** the [thread test plate](hardware/torso_p0/fit_tests/m3_thread_test_print.stl) (under 5 g, holes
  from 2.2 to 2.9 mm). Printed holes don't come out at their nominal size, so use it to set `M3_PILOT` in
  [`cad/torso.py`](hardware/torso_p0/cad/torso.py), then rerun the script. 2.9 mm held firm on a Bambu A1, and that's
  the current value.
- **Then:** T03 and T04, to test the sleeve fit before printing the rest.
- **Print setup:** files in [`exports/print_ready/`](hardware/torso_p0/exports/print_ready/) are already oriented for
  a 256 mm bed. Walls are 2.4 mm, and each part is at most 81 mm tall.
- **Changing the design:** [`T1_shape.json`](hardware/torso_p0/T1_shape.json) defines the shape. Arm openings and seams
  are constants at the top of `cad/torso.py`.

## 10. Head design

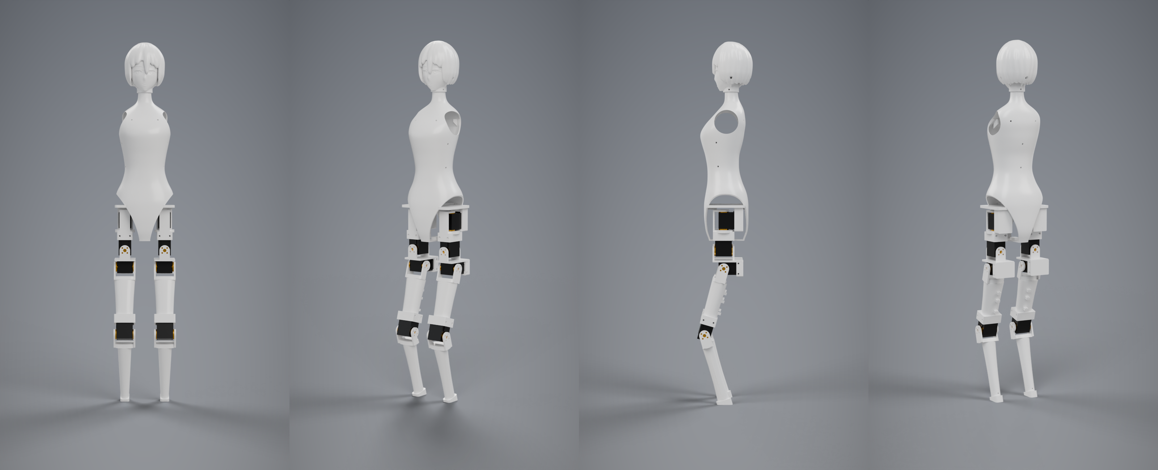
[picture p39: hardware/head_p0/renders/head_whole.png]


The robot needed a face that gave it some personality. I wanted a cute anime-style head that feels elegant and warm, with
rounded hair and a soft face that continue the body's smooth surfaces. These renders show it unpainted. It also had to be
practical: printable on the same small printer, quick to take apart, and with room inside for parts such as a micro
camera later.

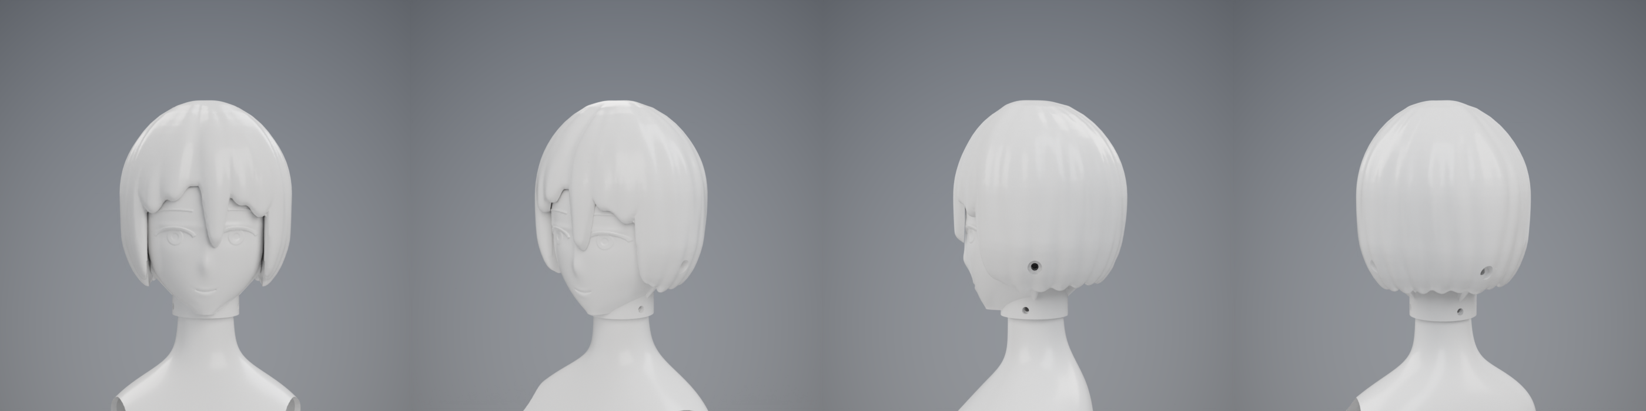
[picture p40: hardware/head_p0/renders/head_views.png]


### 10.1 Keeping it round

My early hair models came out angular, and they looked wrong against the body. So I rebuilt the hair as a blended
distance field, a round cap with soft locks melted into it, which removes hard edges by construction. Every lock starts at
the crown, which stops the sides looking bald, and the top of the head is a completely smooth dome.

The eyes, brows, nose and mouth are low relief (under 1 mm), so they read on bare plastic and also guide the paint. The
smile needed a second pass: a 0.36 mm rise at the corners of the mouth looked fine with paint in the renders, but didn't
show on the unpainted model. It's now about 0.95 mm, with a wider, deeper groove and lips that follow the curve.

### 10.2 From a hollow shell to two parts

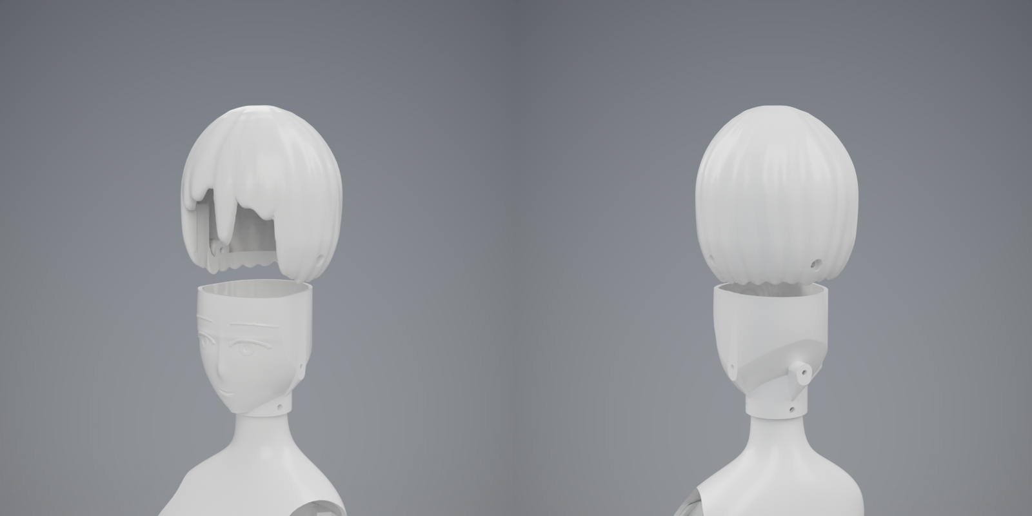
[picture p41: hardware/head_p0/renders/head_parts.png]


The first version was one hollow piece. It looked right, but a closed shell is awkward to print: any support inside
would be hard to remove, and nothing inside could be reached afterwards.

So I split the head into a face part that bolts to the neck and a hair cap that fits over it. They meet on a vertical bore,
which means the cap lifts straight off and the outer shape barely changes. The face prints as an open bowl, and the
cap's inside roofs are 45° apart from a small flat patch at the top, so neither needs supports inside. Removing three
screws opens up the head.

### 10.3 Screws as part of the look

I first tried to hide the cap's screws by angling them up from under the hair. Measuring the built parts showed what that
cost: the slanted holes left a sliver across each pilot's mouth, thread that was only partly surrounded by plastic, and just
0.1 mm of spare depth for the screw.

So I changed the question. The body already shows its screws on the connecting plates, and that helps say "robot". Three
horizontal screws at the back and sides are simpler to print and drive, give about 5.4 mm of full thread, and match the
torso. The build now measures each screw's path, thread and head seat every time it runs, so these numbers can't quietly
go stale.

### 10.4 Status

The head is designed and checked in CAD and is ready to print, but hasn't been built yet, so its fits are still unproven.
In CAD, the two parts don't overlap, the cap lifts 70 mm without touching the face, neither part touches the torso, a
driver can reach all six screws with the head on the robot, and the neck's cable opening stays clear.

It adds at most about 160 g, the model's weight if every part were solid, with its centre of mass about 55 mm above the
neck rim. Real prints should be lighter, but that's still a lot of mass at the very top of the robot, so the walking
policies will need retraining with it, as they will for the torso.

### 10.5 Build notes

For anyone recreating this. Print settings and fit details are in the [head README](hardware/head_p0/README.md), and
colour ideas are in [`renders/paint/`](hardware/head_p0/renders/paint/).

| part | role |
|---|---|
| H01 face | slides over the top 8 mm of the T06 neck and stops on a seat at the rim; 3 M3x6 screws at the back and sides |
| H02 hair | lifts on and off the face part; 3 M3x12 screws at the back and sides, with their heads recessed in the hair |

- **Print setup:** files in [`exports/print_ready/`](hardware/head_p0/exports/print_ready/) are already oriented for a
  256 mm bed. Use tree supports under the chin and hair hem, and block them inside the hair cap.
- **Screw holes:** the face part's pilots are 2.9 mm, the size set by the torso's thread test.
- **Changing the design:** the shape and screw positions are constants in
  [`cad/head.py`](hardware/head_p0/cad/head.py), which also writes the fit checks to
  [`head_report.json`](hardware/head_p0/head_report.json).

### 10.6 A second head: H2

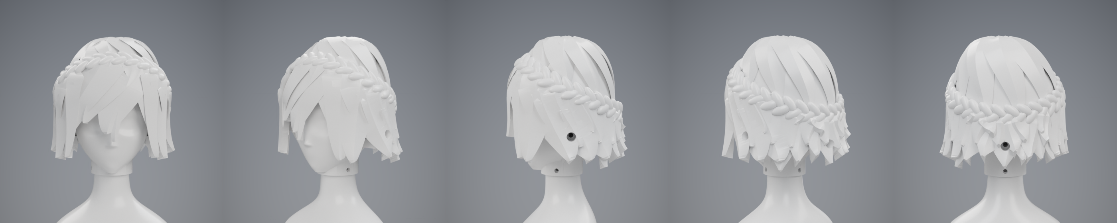
[picture p42: hardware/head_p1/versions/v4/renders/head_views.png]


H2 comes from my own "Rebel Princess" concept: short layered hair with broad, pointed locks and a braid around the crown.
It reuses H1's mounting: the face part slides over the neck, and the hair cap lifts straight off it on three screws.

This time the eyes, brows and mouth are stickers, not relief. A flat sticker on a flat face looks like a mask once you turn
the head, so the bone structure is modelled instead: brow ridge, nose bridge and tip, cheekbones and chin, with eye
sockets that have flat floors for the stickers to sit in.

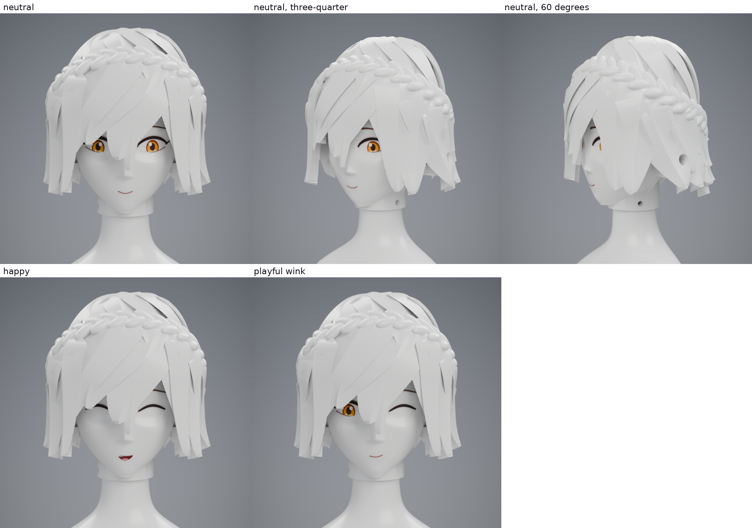
[picture p43: hardware/head_p1/versions/v4/renders/stickers.png]


The hair took four passes, all kept in [`versions/`](hardware/head_p1/versions/):

- **v1** had the concept's ear units, but they didn't look good in print.
- **v2** dropped them and covered the sides with hair. I also replaced v1's narrow locks, which read as rectangular strips
  from the front, with broad triangles. But v2's back locks drew in to a V at the nape.
- **v3** kept v2's crown and bangs and took v1's sides and back.
- **v4** has v2's broad locks at the sides and v1's straight-hanging back.

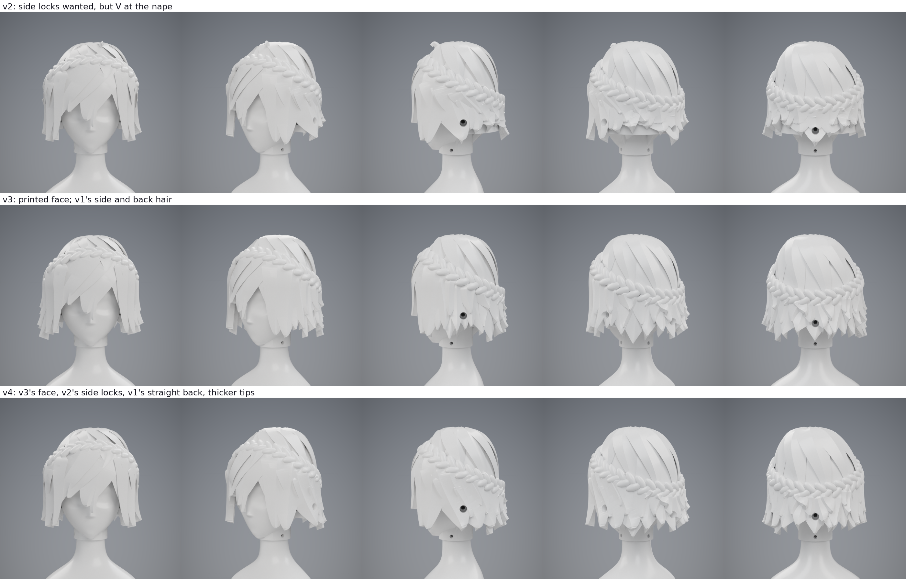
[picture p44: hardware/head_p1/versions/compare_v2_v3_v4.png]


The hanging locks are the part most likely to break when the robot falls, so v4 also raises the minimum tip width from 1.3
to 2.5 mm. A tip's weakest cross-section 3 mm above its end grew from 2.3 to 3.8 mm², and 5 mm up from 2.5 to 13 mm².

**Status:** the face part is printed. v4's face file is byte-identical to v3's, so its hair, not yet printed, fits that
face. In CAD the parts don't overlap each other or the torso, the cap lifts off cleanly, and each hair screw gets about
5.3 mm of full thread. H2 is heavier than H1: 229 g if solid, or about 134 g as printed, with its centre of mass about
50 mm above the neck rim. Print and assembly notes are in the [H2 README](hardware/head_p1/README.md).

## 11. Power delivery

Hobby serial-bus servos are designed to be daisy-chained, with power and data sharing one thin 3-pin lead. That's
convenient for a slow robot arm, but walking is different. This robot averages only about 2 A, but each step produces peaks
of 9 A or more as the knees and hips briefly reach their stall currents (2.5 A per hip servo, 3.8 A per knee).

I simulated the current through every link of the wiring, using my trained walking policies. On a single chain, the
last servo would spend more than half of a walk over 10 % below supply voltage, with drops above 3 V at the worst moments.
These servos are already speed-limited, so that matters: in simulation, a 13 % higher supply voltage made one walker 46 % faster.

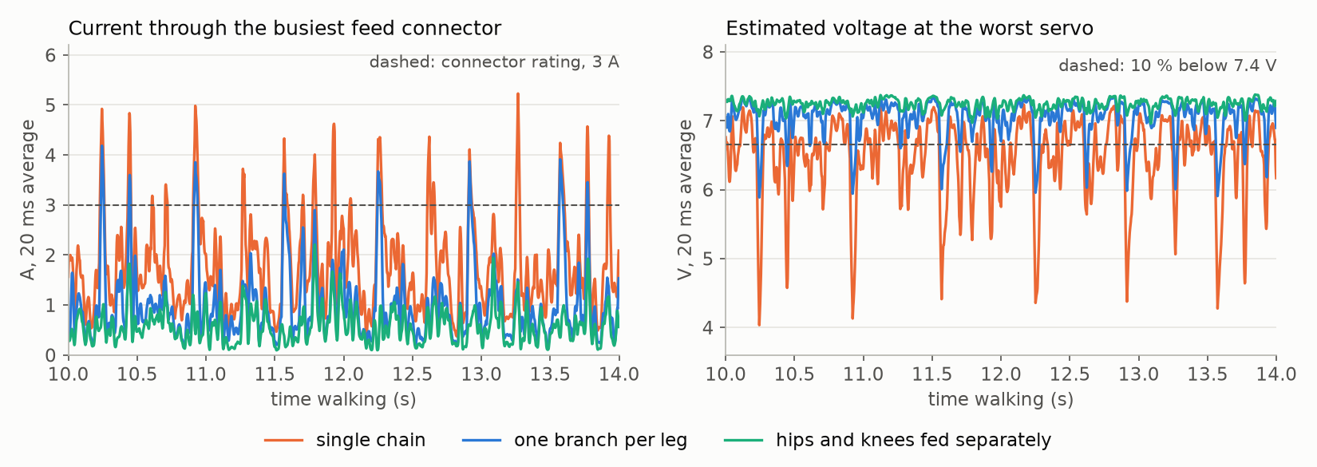
[picture p45: assets/power_wiring.png]


| layout | busiest feed, 20 ms peak | voltage drop, 99th percentile | time more than 10 % low |
|---|---|---|---|
| single daisy chain | 9–14.6 A | 3.1–3.3 V | 51–69 % |
| one branch per leg | 6.3–7.9 A | 1.4 V | 5.9–7.5 % |
| **hips and knees fed separately** | 4.0–4.7 A | 0.4–0.5 V | under 0.1 % |

The obvious fix, one branch per leg, isn't enough, because the knee is both the hungriest servo and the furthest from the
supply. So my design keeps the data on the daisy chain and takes the power off it: a pelvis power board with a 15 A supply and a bulk
capacitor feeds the hips and each knee separately.

**Status:** this is the planned design, not yet built. The currents come from simulation, and the wiring resistance (0.1 Ω
per lead) is an estimate that I'll replace with measurements on the robot. Per-servo requirements, component sizing and limits
are in [power and wiring](hardware/leg_p0/power.md).

The first currents measured on the assembled robot, standing and marching, are in §12.3.

## 12. Full-body assembly and load test

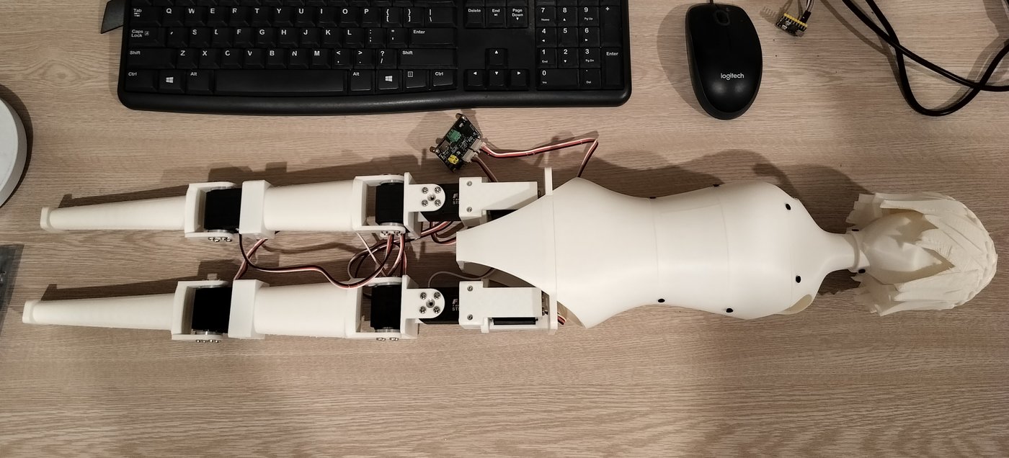
[picture p46: assets/photos/full_body_small.jpg]
The assembled robot: both legs, torso and head


Both legs are now built and hang from the P08 pelvis under the printed torso and head. This is the first time the
whole robot has been on its feet, carrying its full weight.

### 12.1 Bringing up the right leg

The right leg went up the same way as the left (§5.2), one servo on the bus at a time. Each servo got its own ID: 5–8
for yaw, roll, pitch and knee, so both legs can share one bus with the left leg's 1–4. Then each was jogged until its
joint was square and zeroed there. The mirrored pockets hold every servo turned 180°, so **all four right-leg joint
directions come out opposite to the left's**. Each was checked with a small move before any sweep, then confirmed with
a one-joint-at-a-time check routine. Keeping the same joint names and sign conventions on both legs
(yaw + = toe out, roll + = leg out to the side, pitch + = leg forward, knee + = foot back) means one routine definition
drives either leg. The right leg's calibration lives in its own
[`bench_config_right.yaml`](hardware/leg_p0/software/bench_config_right.yaml).

The left knee servo was also replaced during this round. The new one was given the old ID, zeroed straight and swept
clean before it carried load.

### 12.2 Moving both legs together

[`biped_bench.py`](hardware/leg_p0/software/biped_bench.py) runs both legs from one bus as eight joints and plays
whole-body keyframe routines, with every servo arriving at each pose at the same time. The routines are stand, squat,
sway, turn, march and an in-the-air walk. Before anything moves, every pose, and the motion between poses, is checked
against each joint's limits and against the pelvis collision rule: the legs collide if both swing inward by more than
about 5° (from the CAD check in the [leg README](hardware/leg_p0/README.md#two-leg-bench-p08)). One leg in while the other goes out is allowed, which is how the pelvis sways side to side.

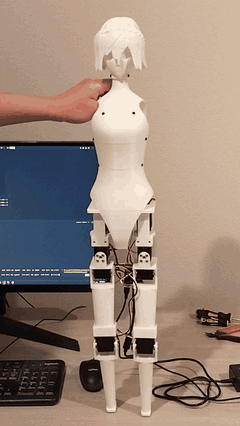
[picture p47: assets/gifs/full_body_march.gif]
The full robot marching in place


**Marching in place (`march`).** From the standing pose (hip 16°, knee 32°), each leg in turn lifts to hip 45° / knee 80°,
so the robot spends half of each cycle on one leg. The legs carry the whole robot: torso and head on top, running on a
5 V bench supply. The hand on the head only keeps it upright. These are open-loop keyframes with no balance control
yet, so nothing else would stop it tipping.

### 12.3 Measured current

Running any routine with `--current` logs every servo's current while it moves. These are full-body numbers for the
complete robot, torso and head included, on the 5 V supply: the sum over all 8 servos.

| activity | mean | peak (all 8 servos at once) | busiest servo | bus voltage |
|---|---|---|---|---|
| standing, holding the stance pose (10 s) | 55 mA | ~100 mA | right hip roll, 16 mA mean | 5.2 V |
| marching in place on the ground (27 s) | 123 mA | 273 mA | knees, 160–180 mA peak | 5.0–5.2 V |

Holding a stance and slow single-leg balance cost almost nothing: well under 0.5 A even after adding about 10–20 mA per
servo for its own electronics, which the register leaves out. As expected, the knees do the work, peaking during
single-leg stance. These numbers don't change the walking estimate in §11. Each bench move takes about a second with
gentle acceleration, while the simulated walk steps several times a second and strikes the ground. The register also
reads only in 6.5 mA steps, and sampling every ~50 ms can miss short spikes. Faster routines and a meter on the supply
are next.

### 12.4 First policy on the robot, and what the servos really do

The first stand policy run on the robot (legs and pelvis, IMU on the pelvis) fell within about a second. Step tests
showed why: the servos' firmware drives every move along a slow motion profile (about 400 deg/s^2 on the hips), so
small corrections start 4-9x later than the simulator's servo model assumed. A servo model fitted to those tests
matches the measured joints 4x better; retrained on it, stand policies hold a quiet stance in 96 % of randomized
simulated runs and ride out light (~0.05 m/s) shoves, but not yet on the robot. Simulation also says the hip servos'
profile, not the supply voltage, limits push recovery. Details: [servo identification and retraining](docs/servo_identification.md); continued in §14.

## 13. IMU

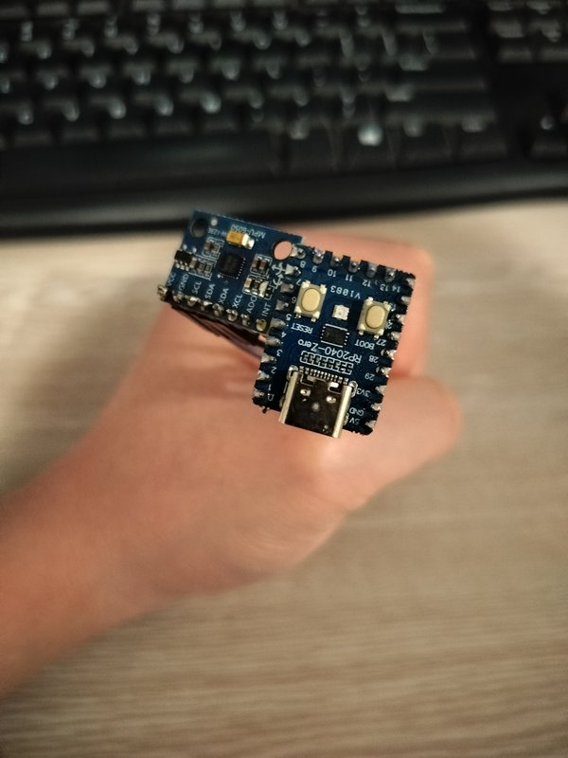
[picture p48: assets/photos/imu_small.jpg]
MPU6050 breakout soldered to an RP2040-Zero


The walking policies balance on gravity direction and turn rate from a 6-axis IMU (§8), so the next sensor on the
bench is an MPU6050-class IMU. I soldered an MPU6050 breakout to an RP2040-Zero, wired over I2C (SDA on GP0, SCL on
GP1), and tested it from MicroPython over USB.

What the first test found:
- **The chip is really an MPU6500.** It answers at address 0x68, but its ID register reads 0x70, which is an MPU6500's
  ID; a genuine MPU6050 reads 0x68. Boards sold as "MPU6050" often carry one. The accelerometer and gyro registers are
  the same, so the readings don't change.
- **The RP2040's hardware I2C fails every transfer on this wiring, but software I2C on the same pins is fully reliable.**
  That points to weak pull-ups. Adding 2.2–4.7 kΩ pull-ups to 3.3 V should bring back hardware I2C, which the faster
  sampling for balance control will need.
- **At rest it reads correctly.** Gravity measures 0.998 g. Accelerometer noise is about 0.003 g. The raw gyro
  offsets are about 1 °/s, which the script measures at startup and subtracts. Gyro noise is 0.14–0.18 °/s on two
  axes and 0.87 °/s on the third, possibly desk vibration.

[`hardware/imu/imu_live.py`](hardware/imu/imu_live.py) is the test script. It runs on the RP2040 and shows a single
live line of acceleration, rotation rate, roll, pitch and yaw (`mpremote connect /dev/ttyACM0 run
hardware/imu/imu_live.py`). Roll and pitch come from a complementary filter, which integrates the gyro and keeps
nudging the angle toward the accelerometer's gravity direction. Yaw uses the gyro alone, so it drifts: there's no
magnetometer.

**Status:** mounted on the pelvis and feeding the stand policies on the robot (§14), via a firmware that streams
gravity and turn rate at ~92 Hz with ~5 ms latency ([`imu_stream.py`](hardware/imu/imu_stream.py)). Tape doesn't hold
it steady, so a small printed slab bolts it to the hip plate instead
([`imu_slab.py`](hardware/imu/cad/imu_slab.py)). Still to do: pull-ups and hardware I2C, and measuring the gyro bias
stability that the straight-walking result depends on. That result needs the bias held to about 0.05 °/s by
re-zeroing at every stop (§8).

## 14. Sim to real: standing and recovering on the robot

The first stand policy run on the robot fell within a second. This section tracks the fixes, run on the legs and
pelvis only (no torso or head), on the 5 V supply. Full detail, with numbers and the policies kept for each phase:
[docs/sim_to_real.md](docs/sim_to_real.md).

1. **Measure what the servos really do.** Step tests showed that the servo firmware drives every move along a slow
   constant-acceleration ramp: ~400 °/s² on the 1:345 hips, ~1900 °/s² on the 1:191 knees. Small corrections
   started 4–9× later than the simulator assumed. A servo model fitted to the tests matches the hips 4× better
   ([servo identification](docs/servo_identification.md)).
2. **Retrain on the fitted model.** The original policy was fragile in exactly the ways hardware differs: in
   simulation, 1° of backlash took it from 75 % to 6 % of quiet stands. Policies retrained with the measured servo
   behaviour, randomized around it, hold a quiet stance in 96 % of simulated runs. On the robot, the retrained policy
   stood on its own for up to 5 minutes once it was in balance.
3. **Get the balance point right.** With no ankles and a 30 mm pad, ~2° of forward lean puts the weight past the
   pad's edge. The robot actually balances 1–2.5° away from where the IMU says upright, so the runner now takes a
   pitch trim.
4. **Recovering needs a step, and a step needs fast hips.** Standing with both feet down absorbs only ~0.05–0.09 m/s.
   When disturbed, the policy started steps the slow hips couldn't finish, and fell. Recovery training on the real
   hips plateaued. With both hip-pitch servos swapped to 1:191, simulated recovery from a 0.15 m/s sudden speed went
   from 0–33 % to 100 %, and from 0.1 m/s repeated shoves from 17 % to 83 %. More voltage didn't help; the ramp is the
   limit.
5. **The swap on the robot.** With the spare 1:191 servos on the hip pitches, the robot now steps in reaction to a
   fall, and sensibly. Whether the steps catch it is still open, partly because only the left new servo is fast; the
   right one ramps like the old hips and is being checked.

**Status:** quiet standing works on the robot. Recovery stepping has started but doesn't yet reliably catch a fall.

<table>
<tr><th>Tip-foot legs, released from the hand</th><th>Tip-foot legs, trying to step</th></tr>
<tr>
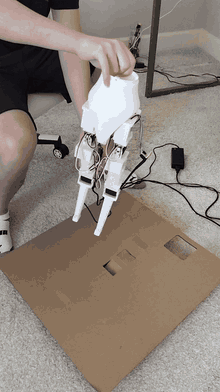
[picture p49: assets/gifs/real_fail_tip_foot_1.gif]
Tip-foot legs falling once released
<td></td>
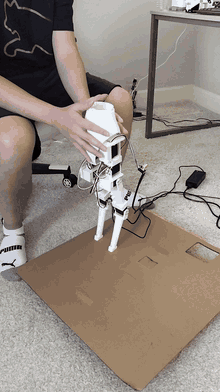
[picture p50: assets/gifs/real_fail_tip_foot_2.gif]
Tip-foot legs stumbling
<td></td>
</tr>
</table>

**What the tip foot taught us about sim to real.** In simulation the 30 × 18 mm tip pads stand, shrug off shoves and
walk (§4, §6–8). On the robot (above) the legs stumble the moment the hand lets go. The simulated balance came from
correcting all the time: a small step or a pitch nudge every fraction of a second, each one needed on time. The tip
gives almost no support area (~2° of lean puts the weight past its edge), so there is no slack: one late correction
and the frame is already past recovery. The real servos start small corrections 4–9× later than the first model
assumed, backlash and IMU error add more, so corrections arrived late, and late is a fall. Fitting the servo model
(§12.4) closed part of the gap for quiet standing, not for stepping. **A design has to leave room for error.** That
led first to the big pads (§15), then to the ankle (§16).

## 15. Big feet for soft rugs

On the furry rugs at home the robot couldn't stand at all on its 30 × 18 mm pads, even set down carefully. The
simulator agreed once it had a rug in it: with the original pads, the robot holding its stance falls over on every rug
from any tilt. This round changes only the foot pads. Full detail: [docs/foot_pads.md](docs/foot_pads.md); printable
pads: [hardware/feet_p1](hardware/feet_p1/README.md).

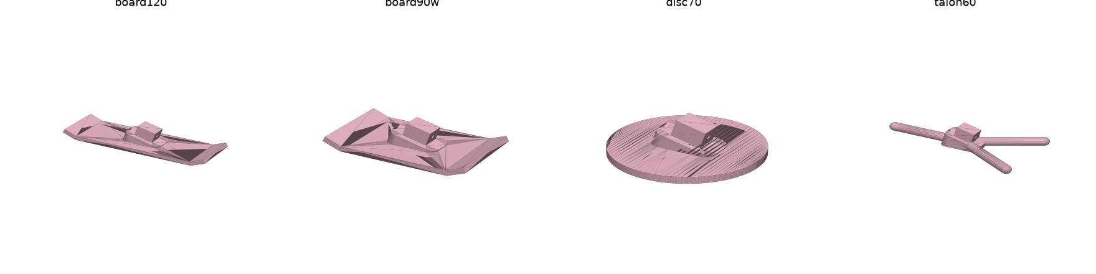
[picture p51: hardware/feet_p1/renders/pads.png]


1. **A rug in the simulator.** A soft contact tuned to sink ~3–10 mm under the original pad, softer per unit force
   for smaller pads (sinkage scales with pressure, as for real fur).
2. **Thirteen pad designs**, from snowboards to round pads, three-claw and bird feet, built on the same stem so they
   plug into the unchanged shins. Fore-aft is the weak direction (no ankles, centre of mass 27–35 cm up), so length
   matters most; width matters on deep fur. Claws and talons sink into fur; domes roll.
3. **Recommendation: `F_board150w`**, a 150 × 50 mm snowboard with upturned ends. Holding its stance with no
   balance control, the robot rights itself from 8–10° off vertical on every simulated rug, so it doesn't depend on
   the policy transferring well. For the robot as tested (legs and pelvis), its policy `pad_board150w_legs` catches
   100 % of simulated hand placements up to 7° and 95–98 % at 9°, already tipping, with the robot's IMU filter in
   the loop, and stands with 0.2° of sway. With torso and head on (1.26 kg, centre of mass 8 cm higher) it is
   ~95 % at 3° (`pad_board150w`).
4. **The IMU gap, modelled.** The robot's tilt reading was off by ~5° during its own wobble: the gyro saturated at
   ±250 °/s and the filter trusted an accelerometer that feels the pelvis accelerate. The firmware now runs the gyro
   at ±1000 °/s and ignores the accelerometer during hard motion; the simulator can emulate the filter. With big
   pads the policies barely notice it.

**Status:** printed and on the robot: it stands on the rug and takes a firm push to tip over.

## 16. Walking on the big pads

<table>
<tr><th>RL walker, legs only (simulation)</th><th>Step-and-settle walker (simulation)</th><th>Safe walker, torso and head on (simulation)</th></tr>
<tr>
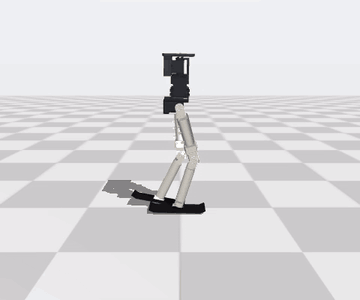
[picture p52: assets/gifs/b150_walk_L.gif]
<td></td>
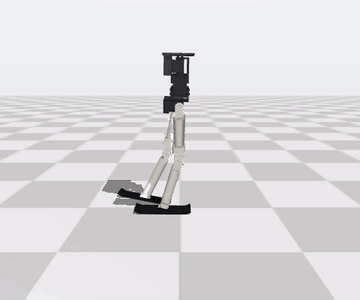
[picture p53: assets/gifs/b150_step_L.gif]
<td></td>
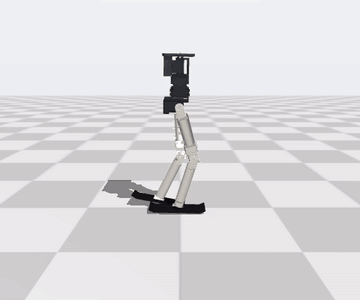
[picture p54: assets/gifs/b150_walksafe_F.gif]
<td></td>
</tr>
</table>

With the big pads, standing on a rug is nearly passive; walking is not. Simulated walkers walk (the RL walker survives
20 s on simulated rugs 80–100 % of the time at ~3 cm/s), but on the robot every approach so far falls on the first
or second step. In simulation, adding an **ankle roll servo per leg** fixes it. Full record:
[docs/walking.md](docs/walking.md); the RL walker round: [docs/walking_b150.md](docs/walking_b150.md).

<table>
<tr><th colspan="3">Big pads, no ankle, on the robot: every step starts a sideways fall</th></tr>
<tr>
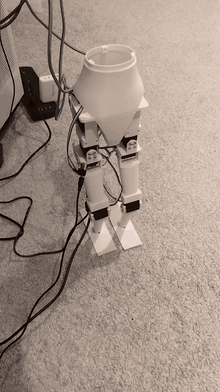
[picture p55: assets/gifs/real_fail_ankless_1.gif]
Ankle-less legs falling sideways on carpet
<td></td>
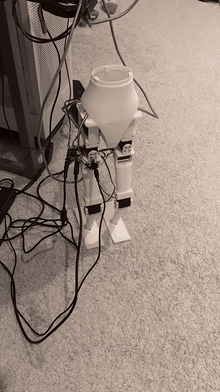
[picture p56: assets/gifs/real_fail_ankless_2.gif]
Ankle-less legs falling sideways on lifting a foot
<td></td>
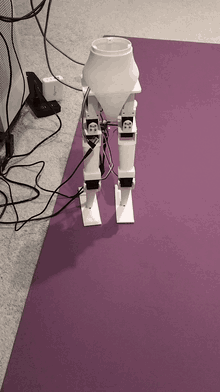
[picture p57: assets/gifs/real_fail_ankless_3.gif]
Ankle-less legs falling sideways on a mat
<td></td>
</tr>
</table>

**How we found the ankle mattered.** On the robot, the ankle-less legs couldn't get one foot off the ground without
falling toward it: ~70 % of falls came on the first step, mostly toward the lifted foot. A hip-roll weight shift
before the step was the natural fix, and it helped only partly. In 27 robot trials the shift and the step cancelled
during the swing, but the robot still fell after touchdown about half the time. The analysis showed why the shift
can't be enough. A flat board fixes its shin's sideways tilt, so rolling the hips only slides the pelvis while both
boards roll onto their edges. With both boards down, the centre of mass sits 15.5 mm outside either board's inner
edge, and no pose within the joint limits puts it over one board. Single support was a knife edge, the same lack of
slack as the tip foot. One ankle roll servo per leg removes the edge. The ankles keep the boards flat while the hips
lean both legs, so the weight moves over the stance board and the robot can stand on one foot for seconds. In
simulation that one change took the same shift-and-step RL walker from six steps in a quarter of hard-floor walks
(falling in 40 %) to six steps or more in 16 of 16, with no falls.

<table>
<tr><th>With ankle roll: one foot, scripted (simulation)</th><th>With ankle roll: six-plus steps, RL (simulation)</th></tr>
<tr>
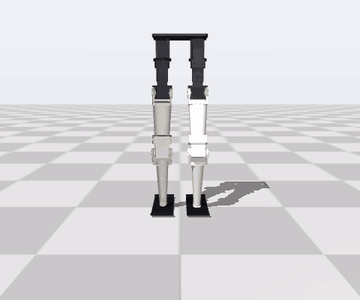
[picture p58: assets/gifs/ankle_one_foot.gif]
<td></td>
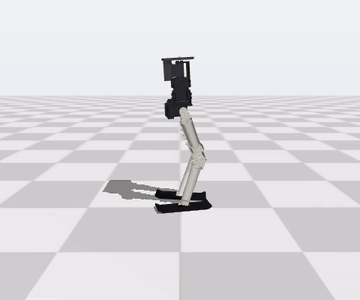
[picture p59: assets/gifs/ankle_walk.gif]
<td></td>
</tr>
</table>

**What we tried:**

1. **RL walkers on a level-sole reference gait.** Good in simulation; on the robot ~70 % of falls came on the first
   step, toward the lifted foot. Only a softer simulated rug reproduced that.
2. **Deterministic baselines.** A toy-walker side-to-side rock (floor-dependent: falls on hard floors, no lift on
   rugs); one quick step from the stance (falls on the robot before the step finishes); a hip-roll weight shift before
   the step (cancels the fall during the swing; the robot falls after touchdown, about half the time).
3. **Step-and-settle RL walkers** (short steps with a pause; a slower version leaning back and waiting for the frame
   to settle). Far fewer first-step falls in simulation; on the robot they got stuck in place.
4. **Shift and step together, slowly** (a hip-roll weight shift built into every step, a full rebalance in between),
   played open loop and as RL residuals, aiming for six steps without falling. On the frame as built the best policy
   takes six steps in a quarter of simulated hard-floor walks and falls in 40 %; one-foot balance lasts 0.2 s.
5. **An ankle roll design study** (one STS3215 1:345 servo per leg, simulation only): the robot balances on one foot
   for 2–3 s and the RL walker takes six or more steps in 16 of 16 hard-floor walks and 14 of 16 on a firm rug
   without a fall, also with torso and head on, and with the robot's IMU filter and a tilt-reading offset in the
   loop (10 of 10 on both).

**What we learned:**

- **No ankle roll is the root cause.** With both boards down the centre of mass sits 15.5 mm outside either board's
  inner edge, and a flat board can't tilt its leg sideways, so every step starts a sideways fall. It grows by e every
  0.16 s, while a swing takes ≥ 0.3–0.4 s on the servos (acceleration-limited, ~0.1 s lag). With ankle roll the hips
  and ankles lean both legs together, the weight moves over one flat board, and the step stops being a fall.
- **No static one-foot pose exists within the joint limits** (best: the centre of mass 0.3 mm outside the standing
  board). A hip-roll "parallelogram" shift moves the weight over one board but leaves both boards on edges.
- **Flat boards fix the shin angle**: no skiing, no level staggered stance without moving the pelvis 38 mm, and
  lifting a board needs far more knee travel than a quick swing allows.
- **Rewards that pay for standing still win** (velocity kernels, contact imitation); progress and foot-lift terms
  that are zero when standing fixed that.

**The ankle-roll leg as designed** ([docs/walking_ankle.md](docs/walking_ankle.md)): the servo's socket in the foot, a
straight shin with the roll fork angled 16° at its end, the usual bent stance. Retrained in simulation on that leg:

<table>
<tr><th>Quick step (0.35 s swing), 150 mm board</th><th>Slow step: lift, swing on one foot, lower slowly</th></tr>
<tr>
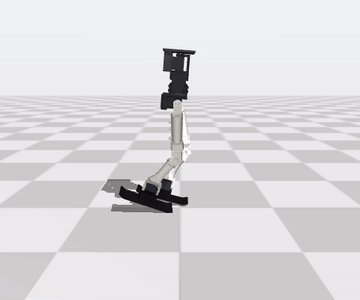
[picture p60: assets/gifs/ank3_quick_b150.gif]
<td></td>
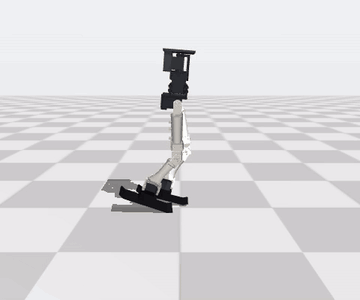
[picture p61: assets/gifs/ank3_slow_b150.gif]
<td></td>
</tr>
</table>

- Standing straight doesn't work: without ankle pitch a flat foot can't be lifted from straight legs (a singular pose).
  The fork angle keeps the bent stance, where a little hip and knee lifts a level foot.
- Long boards beat small pads: the 150 × 50 board walks six steps or more on hard floors and rugs with no falls; a
  foot-shaped 96 mm pad is next; 80 mm and smaller, and round pads, fall. Without ankle pitch the board's length is
  the fore-aft support. The feet never touched each other.
- The slow step lands at 30–90 mm/s instead of ~140 and wobbles less; its quick-step landings couldn't be softened
  with a penalty.

**Clean, steady steps** ([docs/walking_clean.md](docs/walking_clean.md), 2026-11-10): trained against body wobble,
scuffing, toe-first landings and sliding boards, with the stepping anchored by imitation (as Open Duck Mini does) and
faster, continuous steps with more lift:

<table>
<tr><th>Continuous 1.2 s steps (c3i_T12)</th><th>Calmer 1.5 s steps (c6m_T15)</th><th>Big step: 5 cm lift (c5i_big)</th></tr>
<tr>
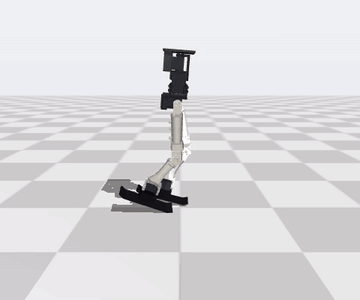
[picture p62: assets/gifs/ank3_cont_T12.gif]
<td></td>
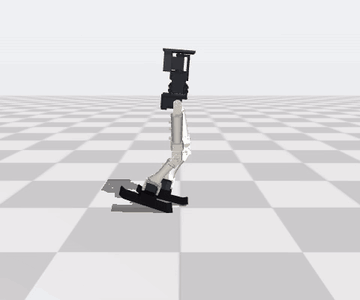
[picture p63: assets/gifs/ank3_cont_T15_steady.gif]
<td></td>
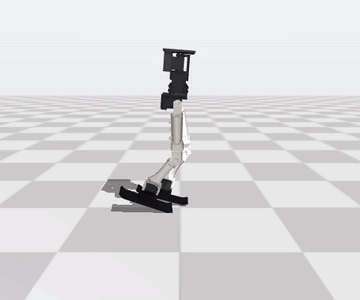
[picture p64: assets/gifs/ank3_big_step.gif]
<td></td>
</tr>
</table>

- Continuous 1.2–1.5 s steps walk 2–3× as fast as the old quick step (25–55 cm in 30 s), lift the boards 2–3 cm
  instead of ~1, slide them half as much, and don't fall on hard floors or rugs (0 of 16 walks each); the calmest
  land at ~100 mm/s with 3–4° of tilt after each landing (before: ~140 mm/s, 6–7°).
- Higher steps land more gently: the big step lifts 5 cm and lands toe-first in a few percent of steps.
- Penalties alone made the policy step less and slide; they work once the stepping is anchored by imitation.
- Every policy still falls on the softest rug; a deterministic walker with IMU feedback falls in 8 of 24 walks.

### 16.1 On the robot: the first walks (2026-11-10)

<table>
<tr><th>Legs and pelvis, <code>c3m_T12</code></th><th>Full body, <code>c3f_T12</code></th><th>Full body, <code>c3f_T12</code></th></tr>
<tr>
<td>The legs walking</td>
<td>The full robot marching</td>
<td>The full robot marching, another angle</td>
</tr>
</table>

With the A01 shins, A02 feet and two more STS3215 servos (IDs 9 and 10) printed and installed, three of the clean-step
policies went onto the robot, legs and pelvis only:

| policy | in simulation (hard floor / rug) | on the robot |
|---|---|---|
| `c6_T15` (1.5 s steps) | 0/16 falls, boards never touched | stepped on its own foot right away |
| `c5i_big` (5 cm lift, 7 cm stride) | 0/16 falls, gentlest landings | tipped about every other step |
| **`c3m_T12`** (1.2 s steps, 2 cm lift) | 0/16 falls, boards never touched | **walks: 10+ steps in most trials** |

**What changed to make it walk.** Compared with the ankle-less walkers that fell on their first robot step:

1. **The ankle roll servo** (hardware). The weight now moves over one flat board before the other lifts, so a step
   is no longer a fall. This is the change that made the rest possible.
2. **A continuous gait** (`c_T12`): a 1.2 s step where the weight shift and the swing overlap. Before, it was a 2.5 s
   step-settle-step with a 0.35 s dash of a swing. The ankle rolls keep the boards flat, and equal hip and knee bends
   lift each board level rather than toe-down.
3. **Imitation anchoring.** Contact-schedule and joint-tracking rewards (weight 3 each, as Open Duck Mini uses) keep
   the policy stepping. Without them, penalties alone made it step less and slide its boards.
4. **Training for clean steps:** penalties on scuffing, tilted landings, body wobble and angular acceleration, jerky
   actions and too little lift. `c3m` is the "steadiness ×2" variant, the sweet spot: ×4 fell or stalled.
5. **What carried over:** the fitted servo model (§12.4), the robot's IMU filter, the settle gate (the clock waits at
   each lift-off until the body turns slower than 0.3 rad/s), and randomized floors.

All three passed in simulation, so why `c3m` alone transferred isn't proven. It has the shortest time on one foot of
the three (0.45 s swing, against 0.55 s for `c6` and 0.7 s for `c5i`) and the lowest lift (2 cm, against 3 and
5 cm). The same lesson as the tip foot applies: the less time spent balancing on one board, the less a late servo
matters.

**With the torso and head (`c3f_T12`).** The legs-only `c3m` falls in 13 of 16 simulated walks once the 0.57 kg torso
and head sit on the pelvis, so it was fine-tuned on the full-body model (25 M steps, same recipe). In simulation it
doesn't fall (0/16) and walks 36–38 cm in 30 s. On the robot it is more stable than the legs alone, the extra inertia
up top damping the wobble, but it **mostly marches in place**, and its servos buzz. The robot logs show the buzz
follows the policy's step-to-step command jitter (correlation +0.7–0.8). The supply sags only a little (5.2 V at rest, 5.1 V median, brief
dips to 4.7 V), and the sag follows the shake rather than causing it: in simulation a 5.1 V supply didn't shake
more than 7.4 V. Smoother actions (stronger action-rate penalties or an action filter) are the next retraining.

**Retraining against the robot's problems (2026-11-11, simulation).** The robot logs showed the buzz is a 4.8 Hz
sideways oscillation: the policy's hip- and ankle-roll commands feed the roll rate back in phase, and the real servos
pass about twice as much 5 Hz motion as the simulated ones, so training never saw it. Nineteen fine-tunes followed:
- An action low-pass filter halves the shake: at 7.4 V the new policies shake less than `c3f_T12` did at 5 V.
- A doubled stride reward lengthens the steps, up to ~4 cm with the full body.
- Mirrored training evens out the two feet.
- Strong random pulls in training let the robot ride out a 0.5 N cable-like pull. About 1 N sideways tips the robot
  on one foot whatever the policy does, so the cables need to hang from above.

Policies to try, from calmest to most ambitious: [docs/walking_clean.md §12](docs/walking_clean.md#12-robot-feedback-round-shake-stepping-in-place-cables-2026-11-11).

**Round 3: knee twitch, feet together, leaning over (2026-11-11, simulation).** None of those policies walked more
than a step on the robot, so the robot logs were read again, with the policy replayed against them:
- The knee twitch is the policy's own command jitter, driven by noisy joint-speed readings. A Lipschitz gradient
  penalty in training ([Chen et al. 2024](https://arxiv.org/abs/2410.11825)) cut it 4× without any filter lag.
- The real hip rolls are about 2.5× stiffer than the model's. The soft model hip had done part of the weight shift
  for the policy, and the robot lifts each foot with its weight 44–59 mm inside the standing board (sim: 21–31 mm).
  Training with the stiffer hip makes the policies shift their own weight and keep their steps at 7.4 V.
- A wider gait (hips abducted 0.06 rad, ankles keeping the boards flat) keeps the boards at least 104–118 mm apart,
  against `c3m`'s 82.
- The runner now starts the policy fully engaged: most of the day's near-falls came at the first step after its
  1 s blend-in.

Policies to try: [docs/walking_clean.md §13.6](docs/walking_clean.md#136-what-to-try-on-the-robot).

**Why they fell (2026-11-11 evening).** On the robot every round-3 policy fell sideways over the standing leg within
a few steps, while `c3m_T12` walked up to 84 s at `--vx 0.015`. The logs, played open-loop into the simulator and used
as starting states for it, show the real hips give sideways under load by ~5° where the servo encoders can't see it.
With that give in the simulator, every round-3 policy falls outward and `c3m` survives, as on the robot:
[docs/walking_clean.md §14](docs/walking_clean.md#14-why-13s-policies-fell-sideways-the-legs-give-where-the-encoders-cant-see-2026-11-11-evening).

The runner ([`policy_stand.py`](hardware/leg_p0/software/policy_stand.py)) now drives 10 joints. It logs each servo's
voltage, temperature and load. On a bus or IMU error it rides through a few missed reads, then holds the stance pose
with torque on instead of going limp. Details, commands and every policy: [docs/walking_clean.md](docs/walking_clean.md)
§8 and §10–11. What led to the walk, including the techniques borrowed from Open Duck Mini and
which worked: [docs/lessons.md §2](docs/lessons.md#2-what-led-to-the-first-walk).

### 16.2 Closing the gap with measurements (2026-11-12)

After `c3m_T12` walked, about fifteen fine-tunes tried to improve on it: smoother actions, longer strides, mirrored
gaits, stiffer hips, wider stances. Every one scored as well as or better than `c3m` in simulation, and every one fell
on the robot, most within the first steps. `c3m` had been lucky: the training recipe didn't reliably produce a policy
that transfers, because the simulator was wrong where it mattered, and policies that exploited the error looked best.

So the robot was measured instead of guessed at ([docs/measuring.md](docs/measuring.md)). Tilted by hand from its
stance, it tips sideways at 6–7°; the rigid model said 14.9°. Fore-aft matched. The hips give sideways under load where
the servo encoders can't see it: the lifted leg swings inward as the robot tips, the feet slip together from 4–5°, and
each sway narrows the stance (85 → 70 → 65 mm) and lowers the next limit. The simulator had assumed rigid hips.

That give, as a spring behind each hip-roll encoder, was fitted to the tilt test (4 N·m/rad) and checked against the
robot's history: with it, the simulator passes the two policies that walk on the robot and fails the ones that don't,
for the first time. Policies trained on it, with a reward for real forward progress and a penalty for letting the
stance narrow, all walked on the robot from the first step and outlast `c3m`:

| policy | on the robot (4 trials, 0.015 m/s) | fell |
|---|---|---|
| `c3m_T12` | 7–28 s, mean 14 | 2 of 4 sideways |
| `s7_narrow` | 7–27 s, mean 18 | backward |
| `s8_push` | 8–26 s, mean 15; the longest steps | mostly backward |
| **`s10_robust`** | **19–28 s, mean 24; one walk of 93 s** | mostly backward |

The sideways falls that ended every earlier policy are mostly gone. The new failure is a slow backward lean: the
robot stands 3.7° further back than the model and drifts further back as it walks, where the simulated robot leans
slightly forward. That, and the outer-edge strips for the feet designed this round, are the next measurements to bring
into the model. Details: [docs/walking_clean.md §15–16](docs/walking_clean.md#15-robot-round-4-the-measured-give-in-training-and-outer-strips-2026-11-12-night).

## Limitations and next steps

- **Sim-to-real transfer is under way (§14, §16.1–16.2).** Quiet standing transfers. With ankle roll and the
  measured hip give in the simulator, every walking policy trained on it now transfers (legs only, 15–28 s walks),
  where before only one of ~15 did; the robot still falls backward after 15–30 s. With torso and head the robot marches mostly in
  place, its servos buzzing, and every policy still falls on the softest simulated rug. The main gaps to close:
  - The servo model is fitted to 5 V step tests on the hips and knees; 7.4 V and the swapped hip-pitch servos still
    need measuring. Rotor inertia, gear friction and thermal behaviour are estimates.
  - Real rubber pads, floor compliance and belt backlash will differ from MuJoCo's soft contacts.
- **Seeds.** Most results come from one training seed per configuration. The pad's quiet stance
  reproduced on 1 of 2; the round-4 walking and catwalk results on 2 of 2; round 5's gain in straightness on 2 of 2
  (its size, speed and step length on 1 of 2).
- **Robustness.** Large pushes (0.5 m/s) and slippery floors (μ ≤ 0.35) still break walking.
  Turning works only through an outer heading loop.
- **Staying on a line depends on sensing.** Without an extra sensor, leg odometry keeps 40–78 % of walks within 0.2 m
  of the line at 2 m; the 100 % result assumes a downward optical-flow sensor on a textured floor, and on the second
  seed that walker is just as straight but slower.
- **Torso and head.** Printed and assembled (§12). The full-body walker `c3f_T12` balances with them on but barely
  moves forward on the robot, and needs smoother actions to stop the servo buzz.
- **First, keep closing the sim-to-real gap with measurements** ([docs/measuring.md](docs/measuring.md)): fit the
  simulator to each before training on it: the backward lean (stance offsets, cable pull), the outer-edge strips, the
  hip give directly (E6), landings and foot clearance (E3–E5).
- **Next steps:**
  0. retrain the full-body walker for smoother actions and real forward progress; move to the 7.4 V supply;
  1. merge standing and walking into one policy (today: a hand-over between two);
  2. walking under pushes without losing the stepping gait (push training reverted it to a skitter);
  3. hip load: the imitation gait runs the C001 hip servos at rated torque; faster hip servos (C046) or
     shorter walking bouts with temperature monitoring;
  4. bench-test servo torque-speed curves, pad friction (including twisting friction) and IMU noise;
     add a downward optical-flow sensor (PMW3901-class) to the pelvis and measure its drift against the model.
     A 6-axis IMU (MPU6050 class, gyro-only heading) is enough if its gyro bias is re-zeroed at every stop: at
     ≤0.05 °/s the straight walkers match true-yaw results over 2 m (E64);
  5. keep step length and speed while training for straightness (late fine-tuning slowly trades them away, and the
     second seed's straight walker is slow);
  6. print P08 and the right leg, build the power wiring (§11), then measure on the real robot (knee torque, servo
     current and voltage, joint speeds under load) and refit the as-built model before trying a trained policy on it.
