SeanEZhou/slender-biped/hardware/head_p1/versions/v4/README.md

# Head P1: H2 "Rebel Princess", version 4

Version 4 keeps version 3's face part unchanged: `H11_face_print.stl` is byte for byte the version 3 file, so a face already printed from version 3 takes this hair.
The hair has version 2's broad triangular locks at the sides, swept back, with their tips on a level hem. The back keeps version 1's straight-hanging layers (no V at the nape).
Every lock tip is at least 2.5 mm wide and about 2.5 mm deep (1.3 mm wide before), so the hem is less likely to snap in a fall. The crown, bangs, face framing, braid and screws are as in version 3. The face
carries only shape (brow ridge, flat-floored eye sockets, nose bridge and tip, cheekbones, chin), because the eyes, brows
and mouth are stickers. `cad/head.py` builds both parts from parameters and writes `head_report.json`. `cad/render.py`
renders `renders/`.

Turnaround, unpainted

## Parts

| file | part | print |
|---|---|---|
| `H11_face_print.stl` | face and skull; slides over the T06 neck like H1 | upright on the socket ring; tree supports under the chin |
| `H12_hair_print.stl` | hair cap with the crown braid | upright on the hem; tree supports under the lock tips and across the face window; block them inside |

Both are already oriented for a 256 mm bed. The concept's ear units are left out: the sides are covered by hair.

## Assembly

| joint | screws |
|---|---|
| face to neck | 3 x M3x6 through the collar, as H1 |
| hair cap to face | 3 x M3x12 straight in at the back and both sides, heads recessed in the hair |

All pilots are 2.9 mm, the torso's thread-test size.

## Checks (`head_report.json`)

The parts don't overlap each other or T06, and the cap lifts 70 mm straight off the face. Each screw passes untouched
through the hair, gets about 5.3 mm of full thread with 1.1 mm spare depth, seats its whole head, and leaves a clear 60 mm
driver path. The neck's cable opening stays clear. Both saved files reload as single closed solids.

The model weighs 229 g if solid (face 30 g, hair 199 g). With three perimeters and 15 % infill the estimate is about 134 g.

Slicing the hanging locks horizontally, each tip's cross-section 3 mm above its end is at least 3.8 mm² (2.3 mm² in version 3), and 5 mm above its end at least 13 mm² (2.5 mm²).

## Not verified

- Nothing has been printed. The cap fit, the braid lobes and the lock tips are untested; the last 1-2 mm of a tip may still chip.
- Stickers need a gently curved surface: the eye sockets have flat floors for this, but sticker size and fit are untested.
- The walking policies include neither the torso nor a head.
