SeanEZhou/slender-biped/assets/renders/baseline_A_8dof/foot_closeup.png

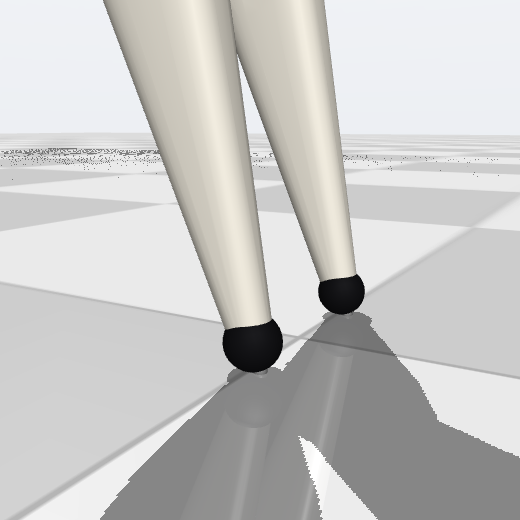
assets/renders/baseline_A_8dof/foot_closeup.png
