SeanEZhou/slender-biped/assets/renders/baseline_A_8dof/joint_motion.png

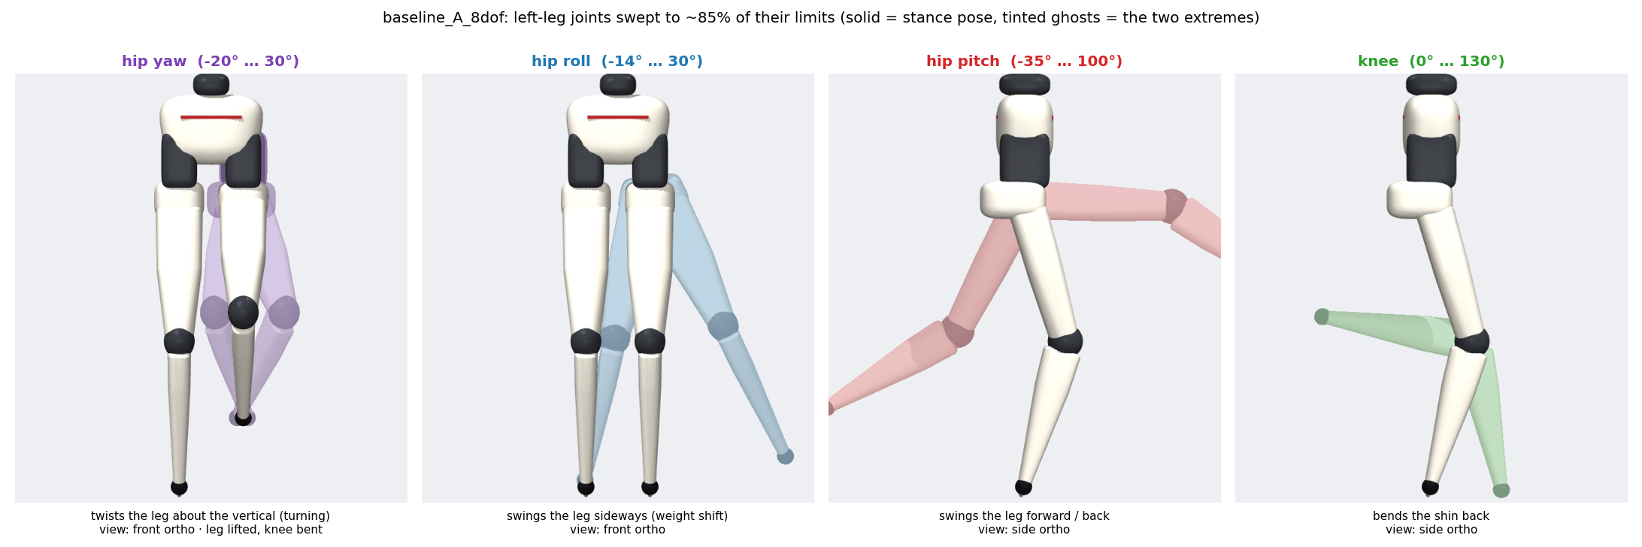
assets/renders/baseline_A_8dof/joint_motion.png
