SeanEZhou/slender-biped/assets/renders/baseline_A_8dof/three_quarter_back.png

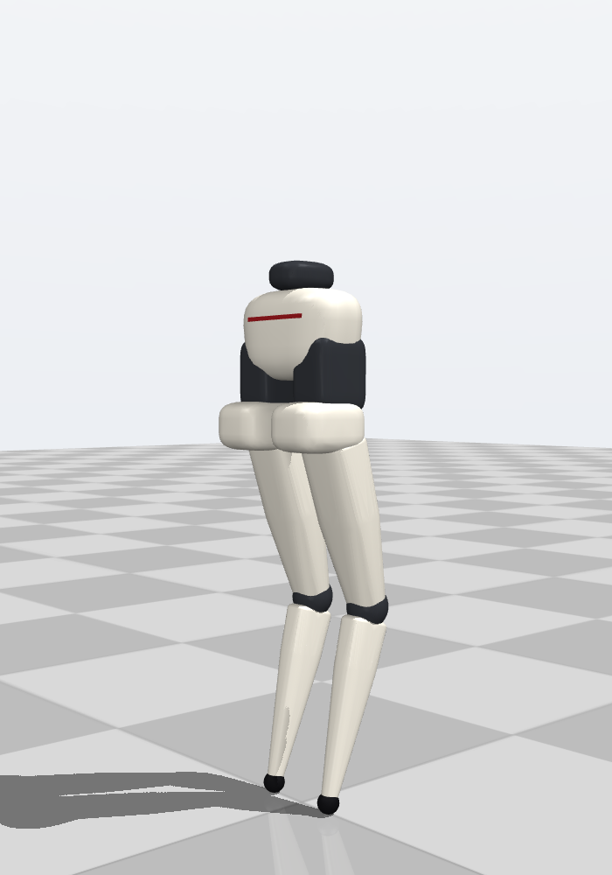
assets/renders/baseline_A_8dof/three_quarter_back.png
