SeanEZhou/slender-biped/assets/renders/baseline_A_10dof/foot_closeup.png

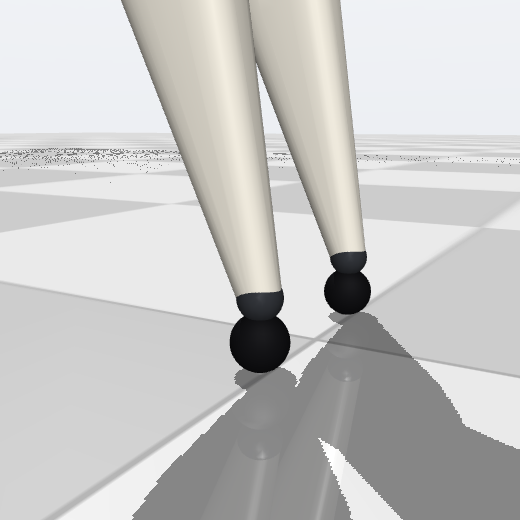
assets/renders/baseline_A_10dof/foot_closeup.png
