SeanEZhou/slender-biped/assets/renders/foot_closeups.png

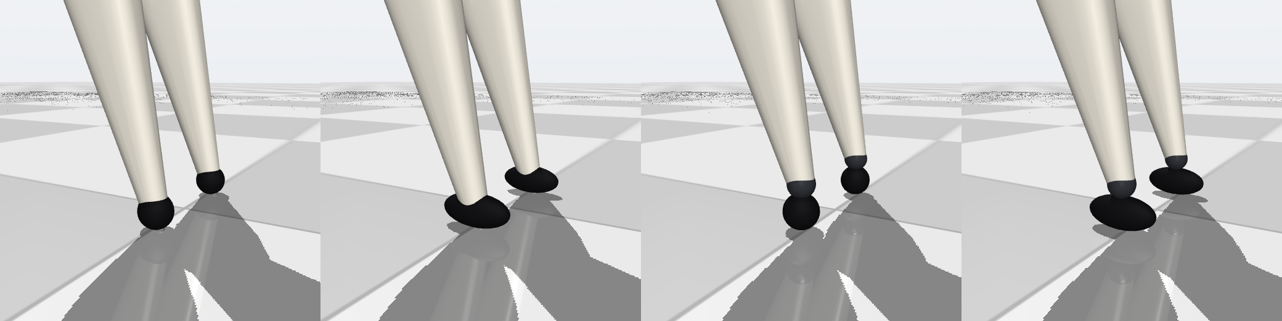
assets/renders/foot_closeups.png
