SeanEZhou/slender-biped/hardware/feet_p1/renders/outer_strip15_on_foot.png

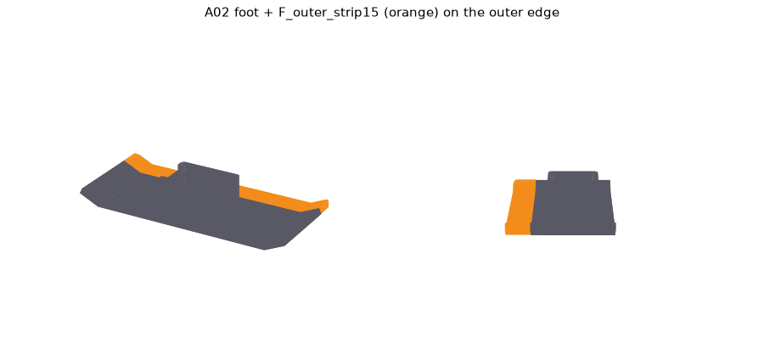
hardware/feet_p1/renders/outer_strip15_on_foot.png
