SeanEZhou/slender-biped/hardware/head_p0/renders/paint/colour_schemes.png

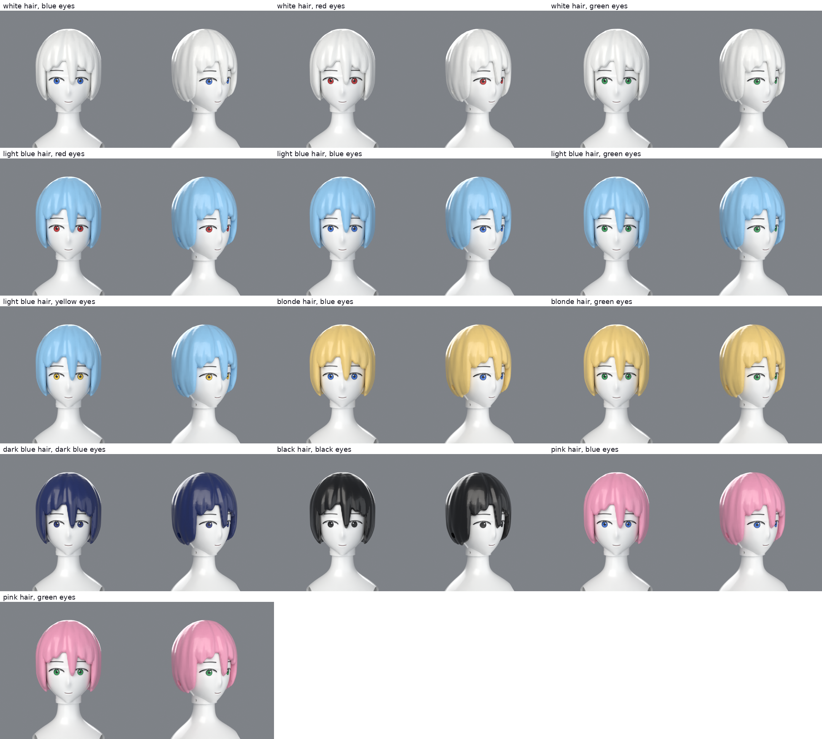
hardware/head_p0/renders/paint/colour_schemes.png
