SeanEZhou/slender-biped/hardware/head_p0/renders/paint/face_markings.png

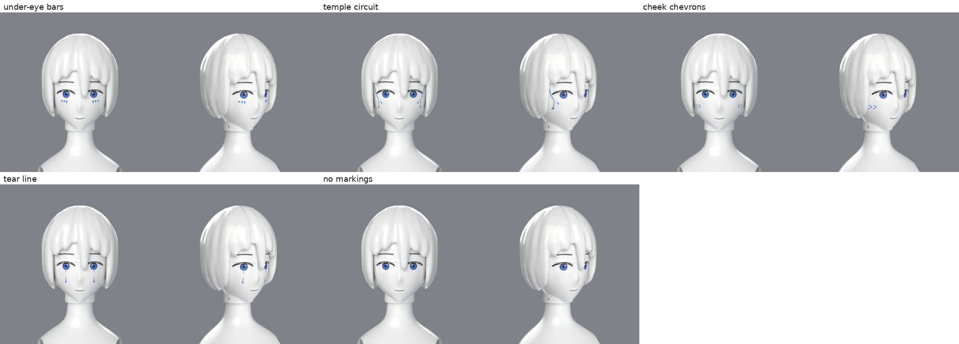
hardware/head_p0/renders/paint/face_markings.png
