SeanEZhou/slender-biped/hardware/head_p0/renders/paint/full_body.png

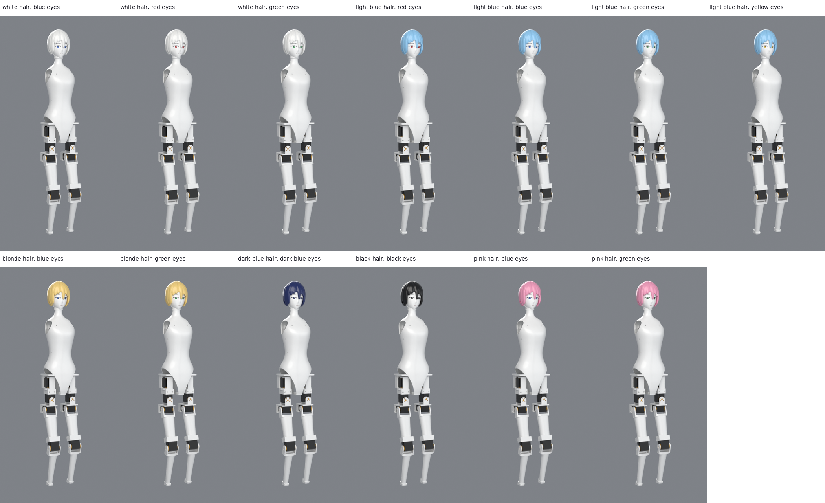
hardware/head_p0/renders/paint/full_body.png
