SeanEZhou/slender-biped/hardware/head_p1/versions/v4/renders/stickers_whole.png

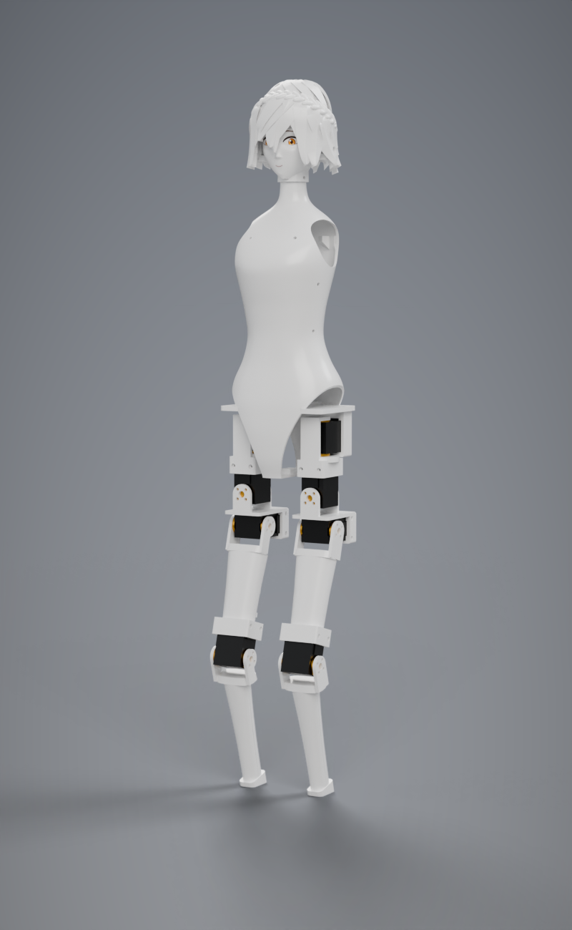
hardware/head_p1/versions/v4/renders/stickers_whole.png
