SeanEZhou/slender-biped/hardware/leg_p0/renders/biped_stance_front.png

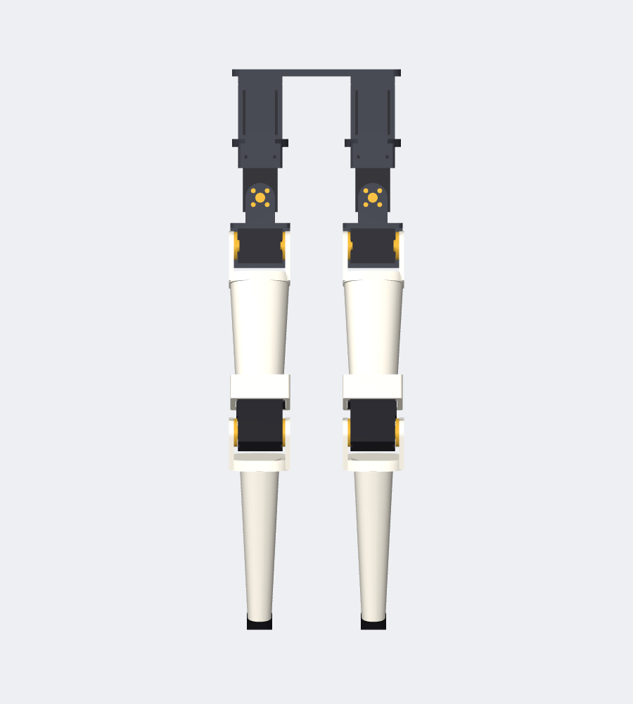
hardware/leg_p0/renders/biped_stance_front.png
