SeanEZhou/slender-biped/hardware/leg_p0/renders/biped_stance_three_quarter.png

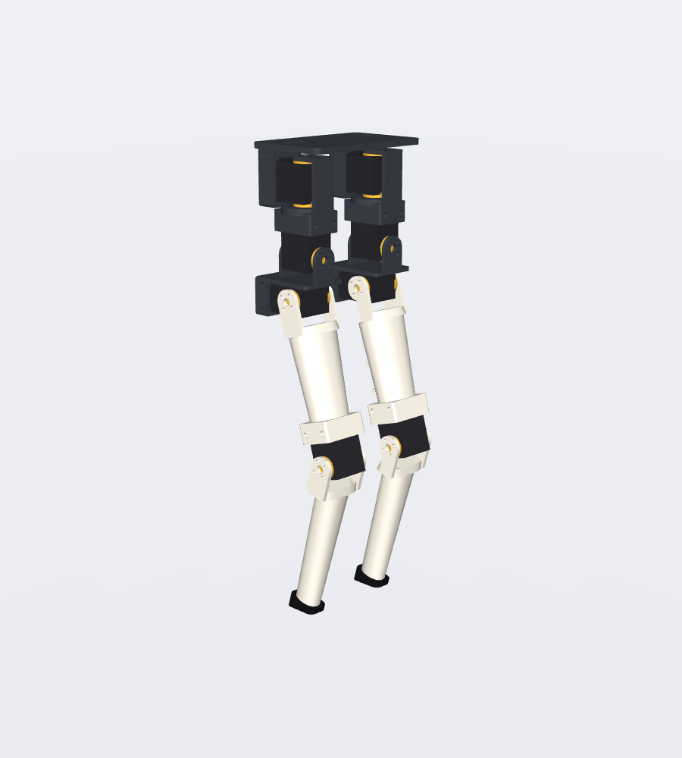
hardware/leg_p0/renders/biped_stance_three_quarter.png
