SeanEZhou/slender-biped/hardware/leg_p0/renders/leg_neutral_front.png

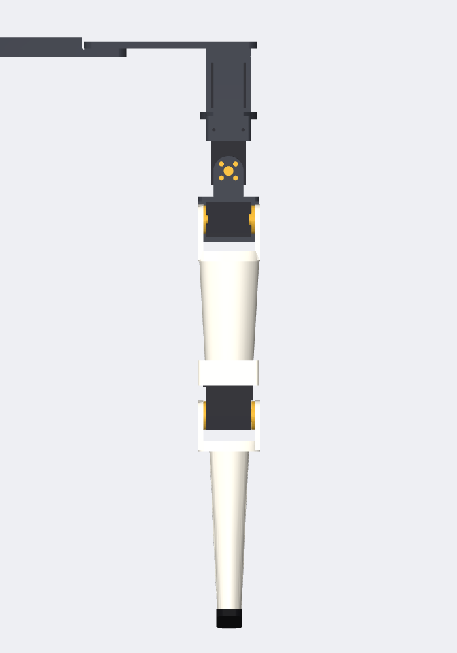
hardware/leg_p0/renders/leg_neutral_front.png
