SeanEZhou/slender-biped/hardware/leg_p0/renders/leg_neutral_side.png

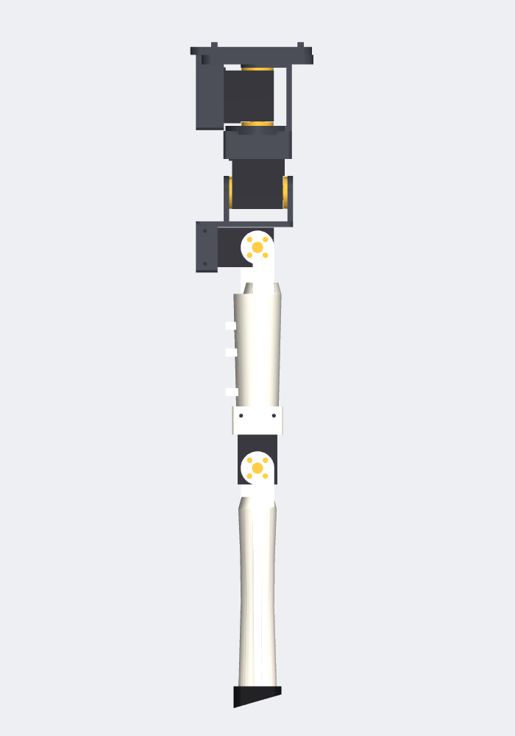
hardware/leg_p0/renders/leg_neutral_side.png
