SeanEZhou/slender-biped/hardware/leg_p0/exports/step/assembly_stance.step

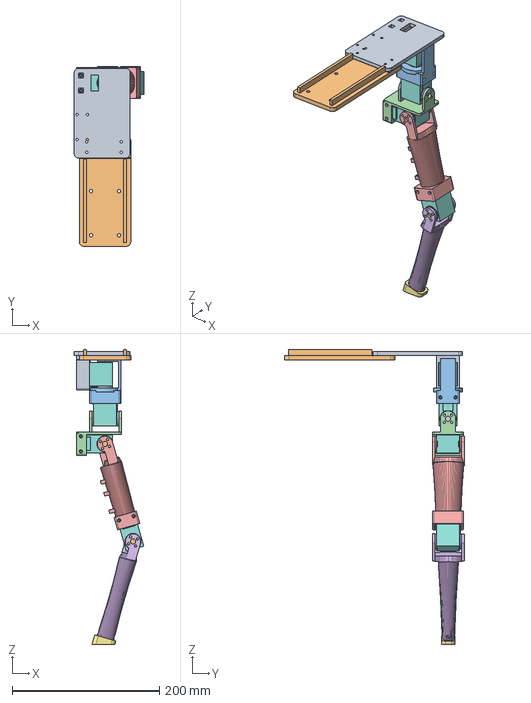
[picture p90: CAD file, 2026-11-09]
hardware/leg_p0/exports/step/assembly_stance.step
94.8 x 244.2 x 401.0 mm
