SeanEZhou/slender-biped/hardware/ankle_p1/exports/step/ankle_assembly_rest.step

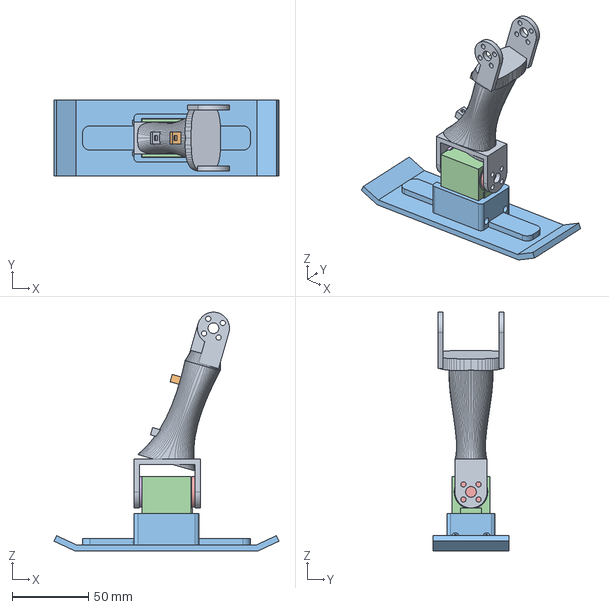
[picture p91: CAD file, 2026-11-10]
hardware/ankle_p1/exports/step/ankle_assembly_rest.step
147.2 x 50.0 x 156.2 mm
