SeanEZhou/slender-biped/hardware/leg_p0/exports/step/assembly_neutral.step

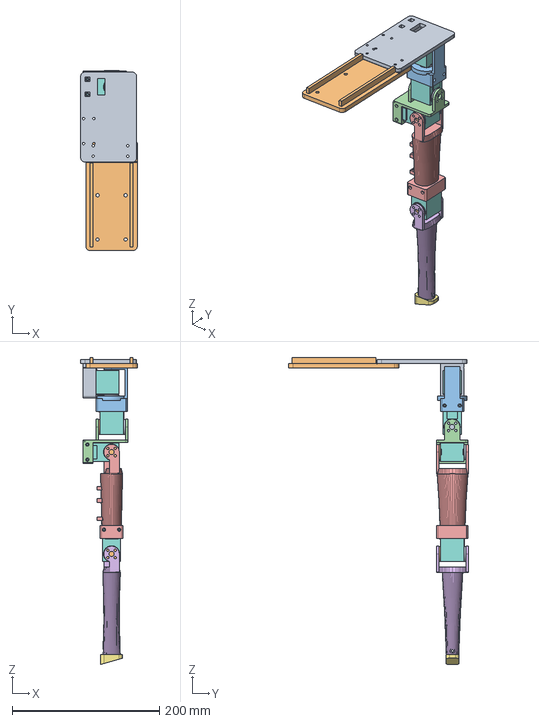
[picture p92: CAD file, 2026-11-09]
hardware/leg_p0/exports/step/assembly_neutral.step
77.0 x 244.2 x 416.3 mm
