SeanEZhou/slender-biped/hardware/ankle_p1/exports/step/A01_shin_ankle.step

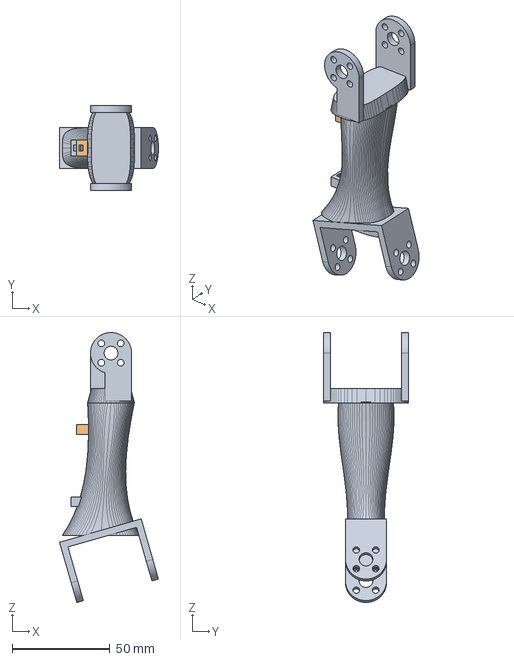
[picture p93: CAD file, 2026-11-10]
hardware/ankle_p1/exports/step/A01_shin_ankle.step
50.5 x 43.4 x 137.9 mm
