SeanEZhou/slender-biped/hardware/ankle_p1/exports/stl_right_mirror/A02_foot_ankle_RIGHT.stl

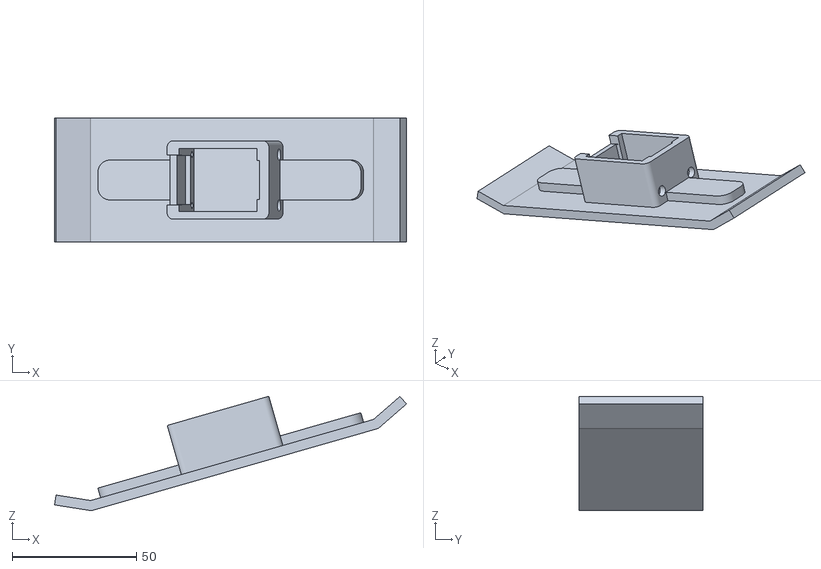
[picture p94: CAD file, 2026-11-10]
hardware/ankle_p1/exports/stl_right_mirror/A02_foot_ankle_RIGHT.stl
141.5 x 50.0 x 46.0
