SeanEZhou/slender-biped/hardware/feet_p1/exports/F_outer_strip15.3mf

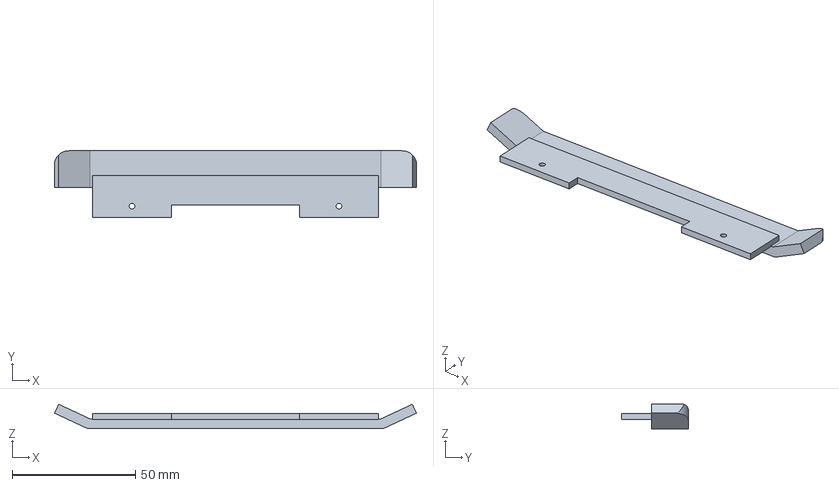
[picture p95: CAD file, 2026-11-12]
hardware/feet_p1/exports/F_outer_strip15.3mf
146.9 x 27.0 x 9.96 mm
