SeanEZhou/slender-biped/hardware/head_p0/exports/print_ready/H01_face_print.stl

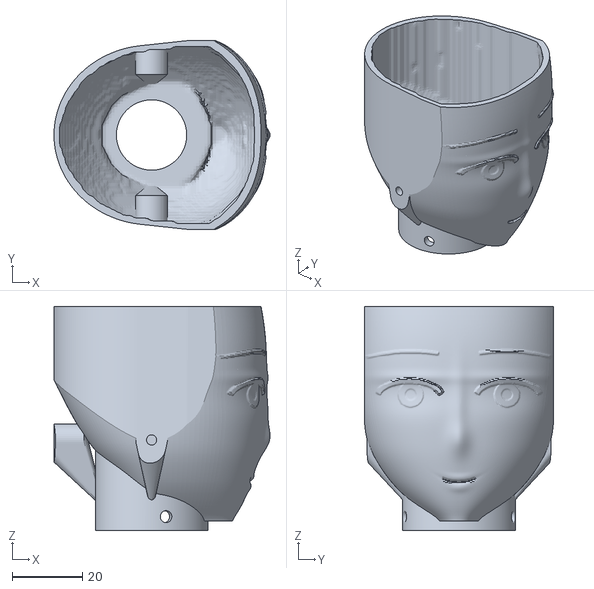
[picture p96: CAD file, 2026-11-02]
hardware/head_p0/exports/print_ready/H01_face_print.stl
61.4 x 53.7 x 63.8
