SeanEZhou/slender-biped/hardware/head_p1/versions/v4/exports/print_ready/H12_hair_print.stl

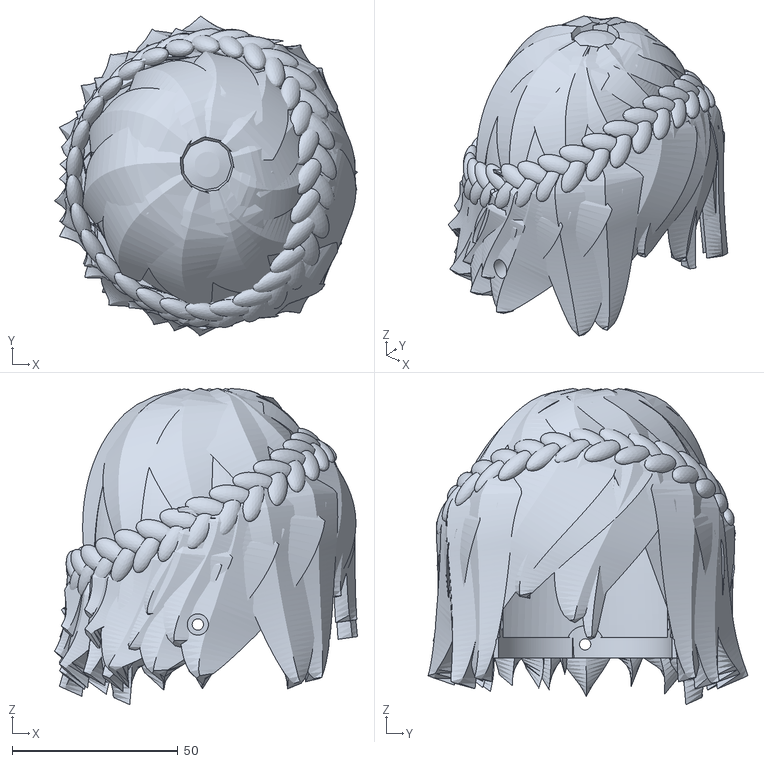
[picture p97: CAD file, 2026-11-03]
hardware/head_p1/versions/v4/exports/print_ready/H12_hair_print.stl
91.5 x 96.6 x 95.6
