SeanEZhou/slender-biped/hardware/imu/exports/imu_slab.3mf

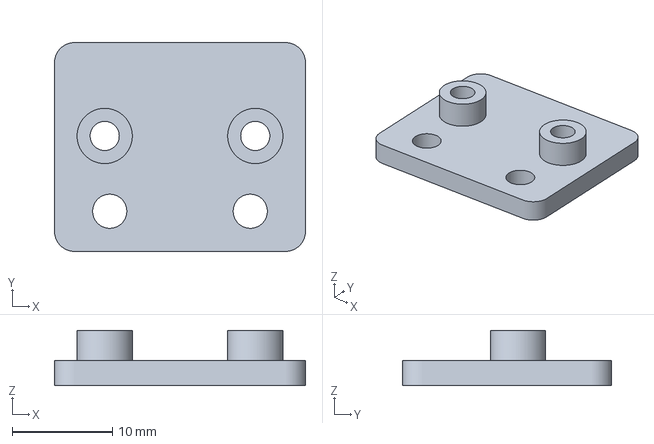
[picture p98: CAD file, 2026-11-12]
hardware/imu/exports/imu_slab.3mf
25.0 x 20.8 x 5.50 mm
