SeanEZhou/slender-biped/hardware/leg_p0/exports/step/horns/STS3215_passive_6p35.step

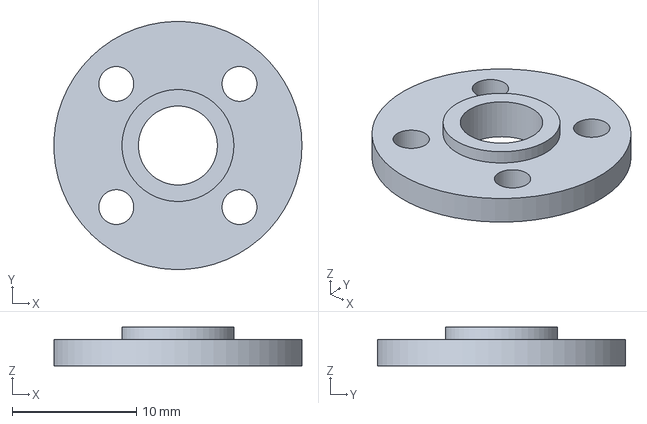
[picture p99: CAD file, 2026-10-31]
hardware/leg_p0/exports/step/horns/STS3215_passive_6p35.step
19.9 x 19.9 x 3.10 mm
