SeanEZhou/slender-biped/hardware/leg_p0/exports/step/P07_pad.step

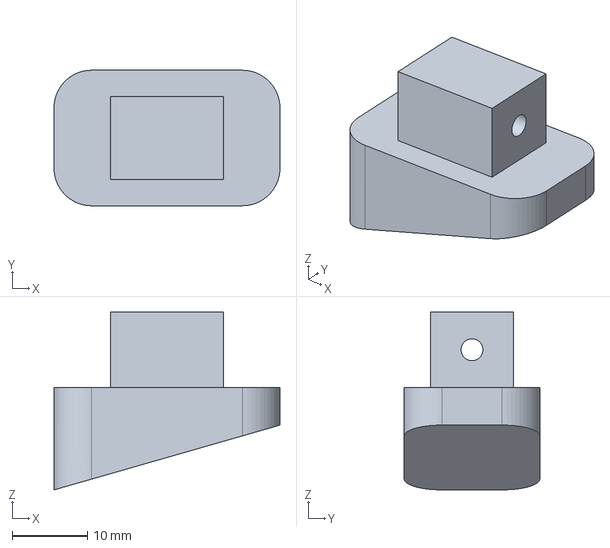
[picture p100: CAD file, 2026-11-09]
hardware/leg_p0/exports/step/P07_pad.step
30.0 x 18.0 x 23.6 mm
