SeanEZhou/slender-biped/hardware/leg_p0/exports/stl/print_ready/horns/STS3215_driven_tight.stl

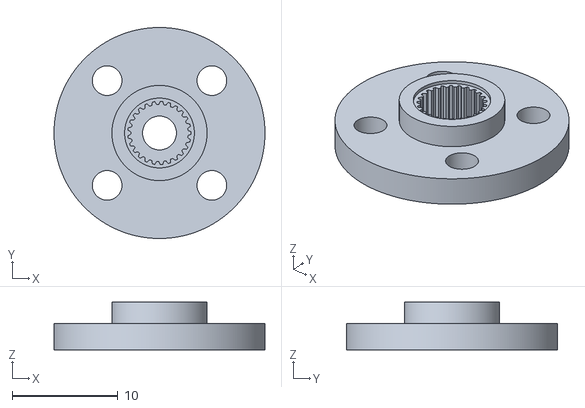
[picture p101: CAD file, 2026-10-31]
hardware/leg_p0/exports/stl/print_ready/horns/STS3215_driven_tight.stl
20.0 x 20.0 x 4.50
