SeanEZhou/slender-biped/hardware/leg_p0/exports/stl/print_ready/P07_pad_RIGHT_print.stl

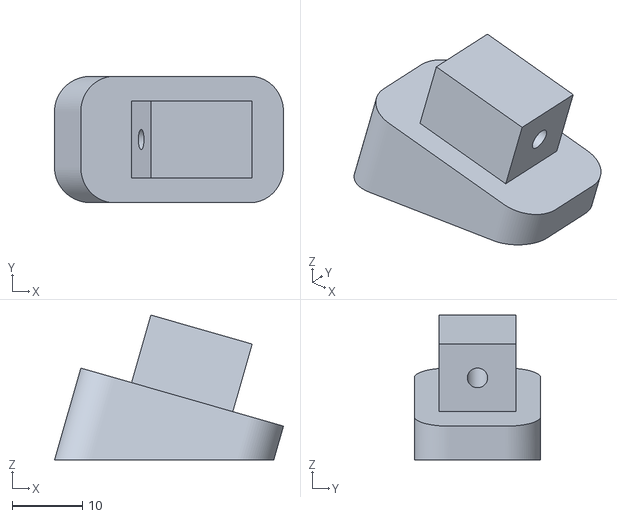
[picture p102: CAD file, 2026-11-09]
hardware/leg_p0/exports/stl/print_ready/P07_pad_RIGHT_print.stl
32.6 x 18.0 x 20.6
