SeanEZhou/slender-biped/hardware/leg_p0/exports/stl_right_mirror/P06_shin_RIGHT.stl

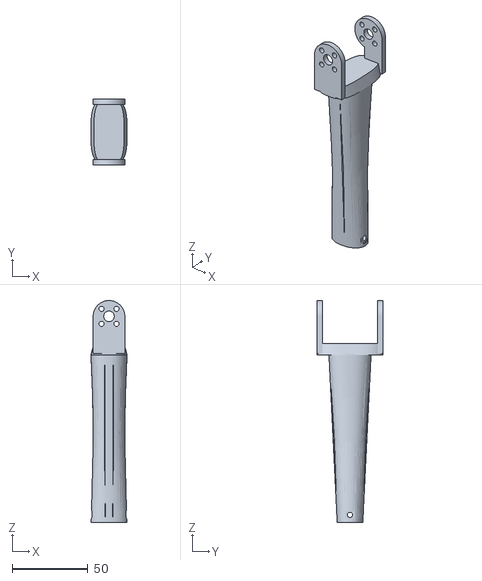
[picture p103: CAD file, 2026-11-09]
hardware/leg_p0/exports/stl_right_mirror/P06_shin_RIGHT.stl
24.0 x 43.4 x 146.9
