SeanEZhou/slender-biped/hardware/leg_p0/fit_tests/E_pad_socket_coupon.step

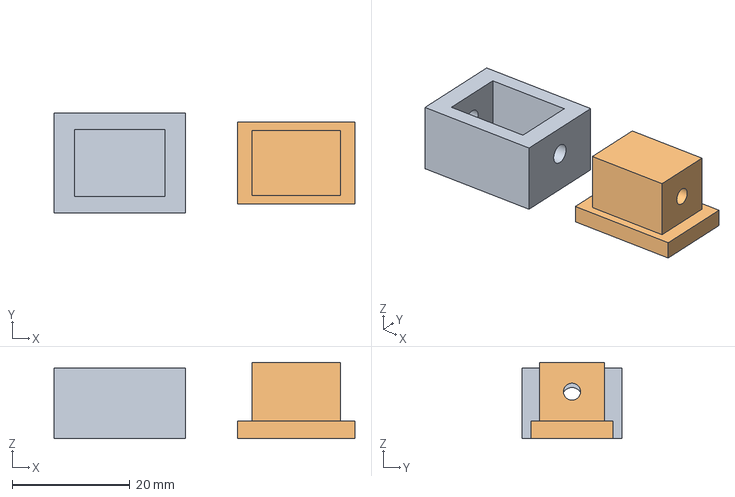
[picture p104: CAD file, 2026-11-09]
hardware/leg_p0/fit_tests/E_pad_socket_coupon.step
51.2 x 17.0 x 13.0 mm
