SeanEZhou/slender-biped/hardware/torso_p0/exports/print_ready/T01_hip_front_print.stl

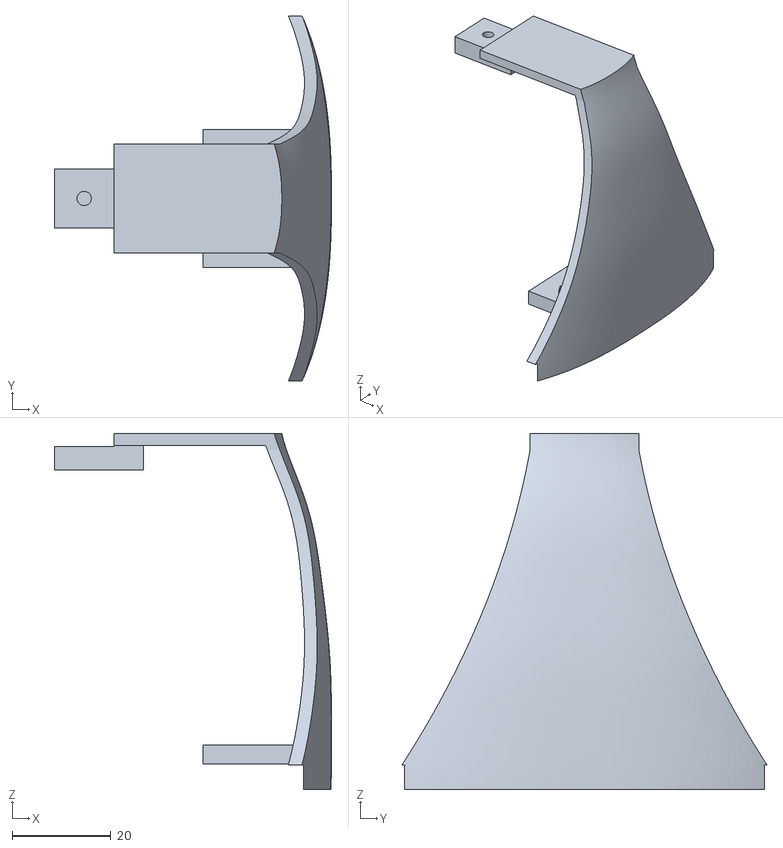
[picture p105: CAD file, 2026-11-01]
hardware/torso_p0/exports/print_ready/T01_hip_front_print.stl
56.0 x 73.8 x 72.0
