SeanEZhou/slender-biped/hardware/torso_p0/fit_tests/m3_thread_test_print.stl

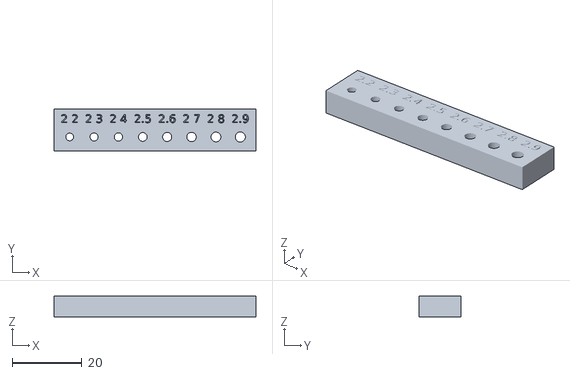
[picture p106: CAD file, 2026-10-31]
hardware/torso_p0/fit_tests/m3_thread_test_print.stl
58.0 x 12.0 x 6.00
