SeanEZhou/slender-biped/models/meshes/ankle2/R_foot.stl

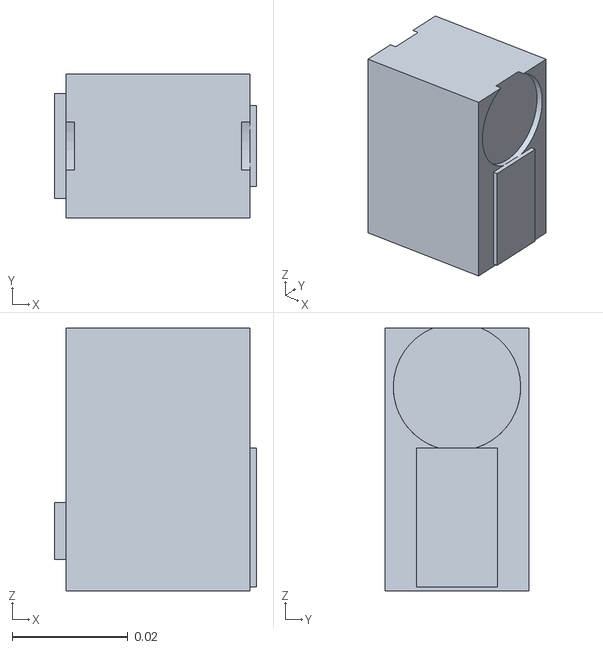
[picture p107: CAD file, 2026-11-10]
models/meshes/ankle2/R_foot.stl
0.0349 x 0.0248 x 0.0454
