SeanEZhou/slender-biped/models/meshes/hw_p0_60mm/R_yaw.stl

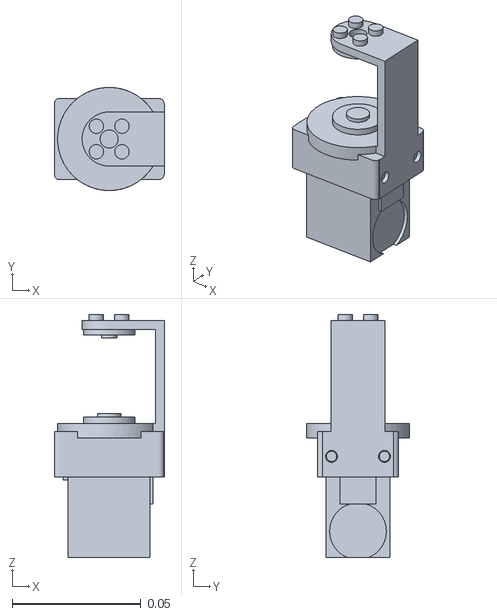
[picture p108: CAD file, 2026-10-30]
models/meshes/hw_p0_60mm/R_yaw.stl
0.0428 x 0.04 x 0.0942
