SeanEZhou/slender-biped/models/meshes/hw_p0_70mm/L_thigh.stl

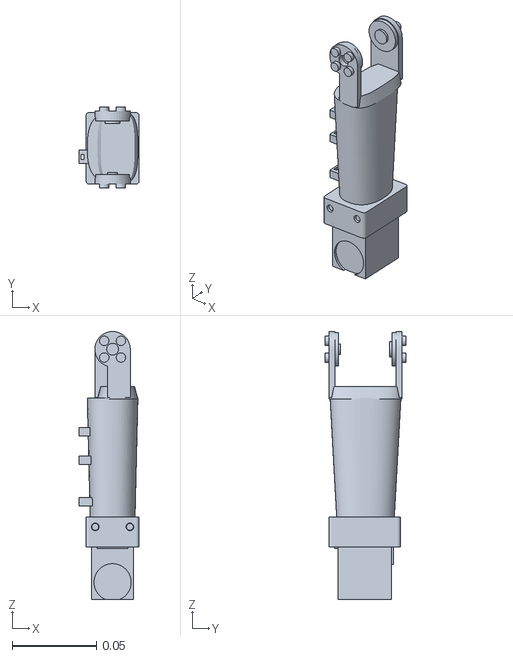
[picture p109: CAD file, 2026-10-30]
models/meshes/hw_p0_70mm/L_thigh.stl
0.0357 x 0.0482 x 0.159
