SeanEZhou/slender-biped/hardware/feet_p1/exports/F_outer_strip25.3mf

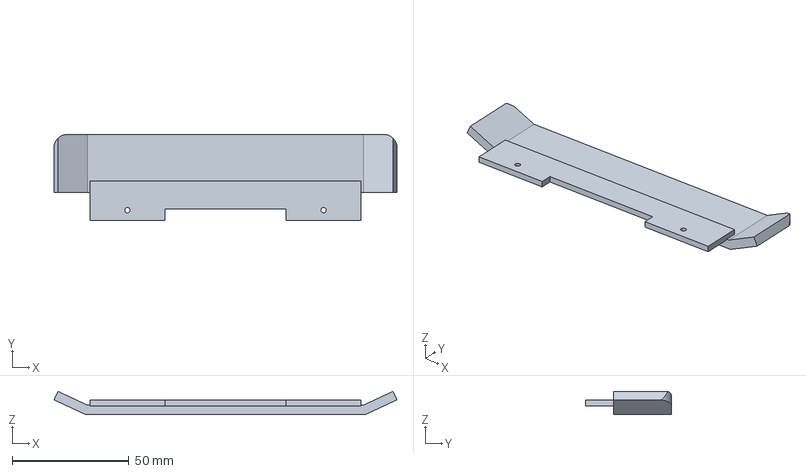
[picture p110: CAD file, 2026-11-12]
hardware/feet_p1/exports/F_outer_strip25.3mf
146.9 x 37.0 x 9.96 mm
