SeanEZhou/slender-biped/hardware/head_p0/exports/print_ready/H02_hair_print.stl

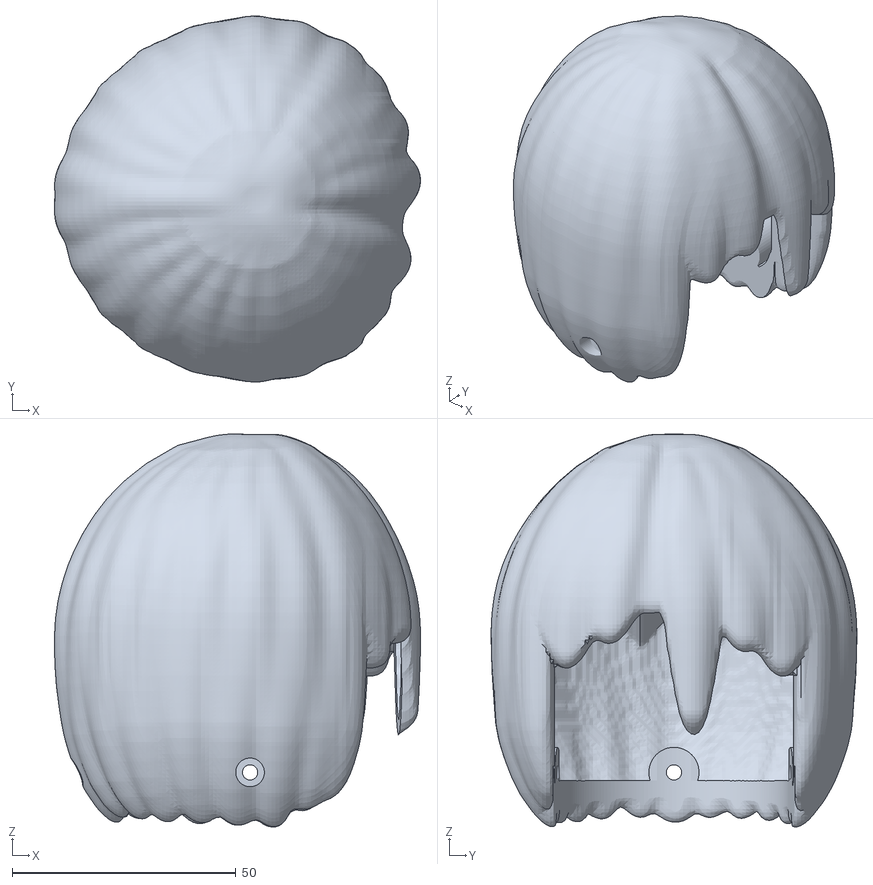
[picture p111: CAD file, 2026-11-02]
hardware/head_p0/exports/print_ready/H02_hair_print.stl
81.8 x 81.7 x 87.8
