SeanEZhou/slender-biped/hardware/leg_p0/fit_tests/B_C_horn_and_idler_arms.step

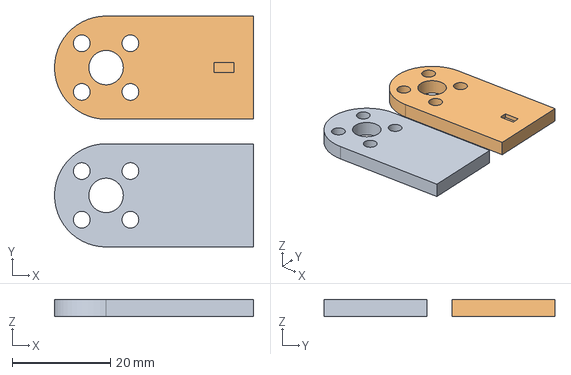
[picture p112: CAD file, 2026-10-27]
hardware/leg_p0/fit_tests/B_C_horn_and_idler_arms.step
40.5 x 47.0 x 3.50 mm
