SeanEZhou/slender-biped/hardware/torso_p0/exports/print_ready/T04_midriff_print.stl

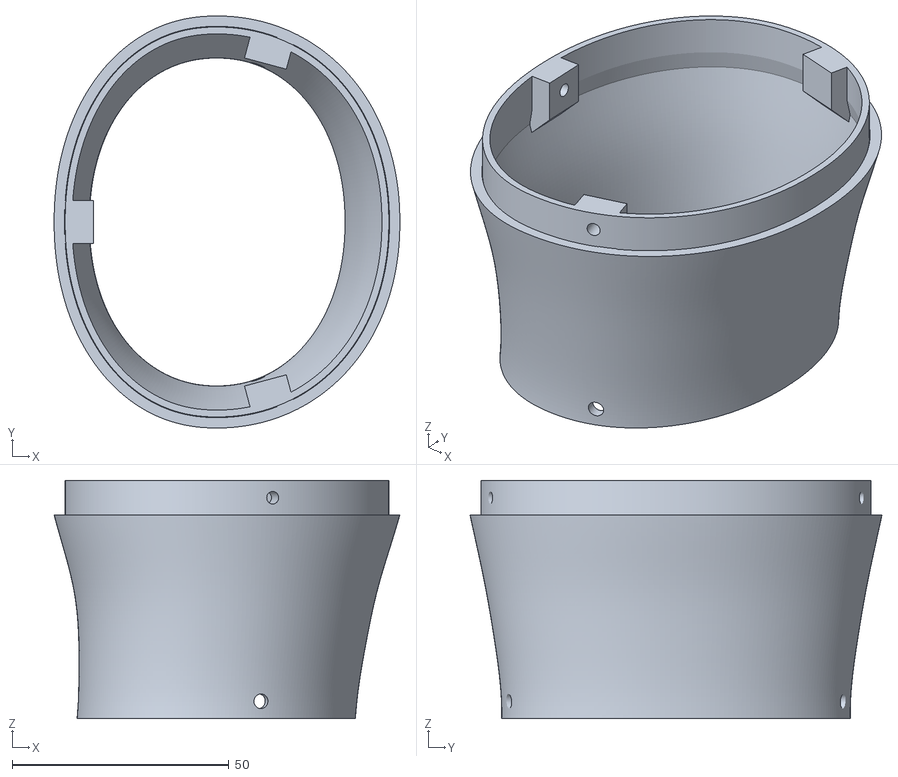
[picture p113: CAD file, 2026-11-01]
hardware/torso_p0/exports/print_ready/T04_midriff_print.stl
79.8 x 95.1 x 55.0
