SeanEZhou/slender-biped/models/meshes/ankle2/L_shin.stl

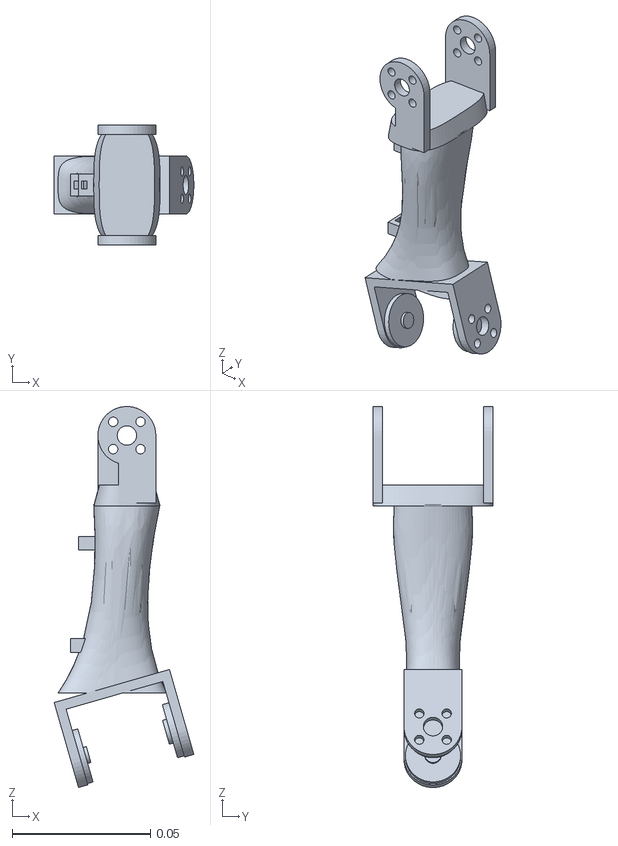
[picture p114: CAD file, 2026-11-10]
models/meshes/ankle2/L_shin.stl
0.0505 x 0.0434 x 0.138
