SeanEZhou/slender-biped/models/meshes/hw_p0_60mm/R_roll.stl

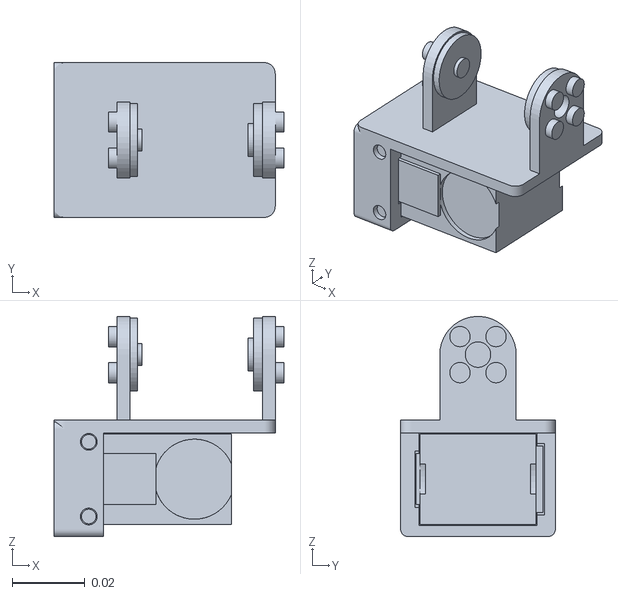
[picture p115: CAD file, 2026-10-30]
models/meshes/hw_p0_60mm/R_roll.stl
0.0632 x 0.0425 x 0.0604
