SeanEZhou/slender-biped/models/meshes/hw_p0_80mm_pad40/R_shin.stl

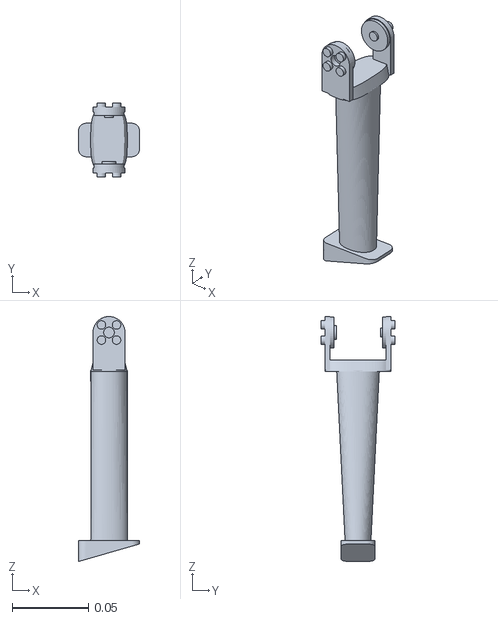
[picture p116: CAD file, 2026-10-30]
models/meshes/hw_p0_80mm_pad40/R_shin.stl
0.04 x 0.0482 x 0.16
