SeanEZhou/slender-biped/hardware/ankle_p1/exports/stl/print_ready/A02_foot_ankle_print.stl

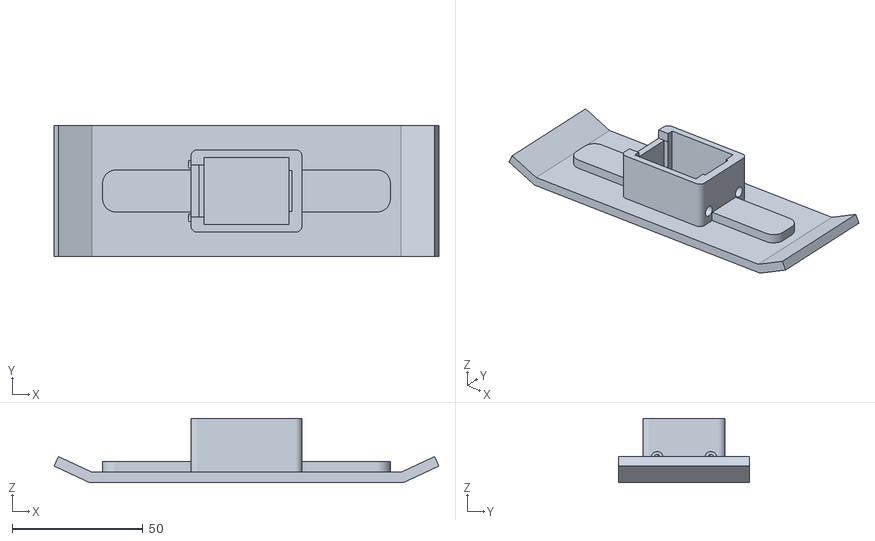
[picture p117: CAD file, 2026-11-10]
hardware/ankle_p1/exports/stl/print_ready/A02_foot_ankle_print.stl
147.2 x 50.0 x 24.6
