SeanEZhou/slender-biped/hardware/feet_p1/exports/F_claw60.3mf

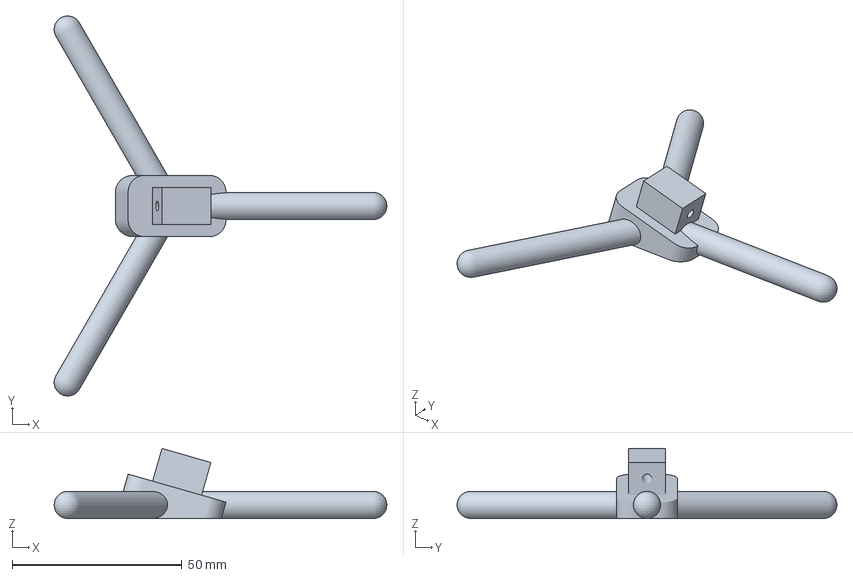
[picture p118: CAD file, 2026-11-09]
hardware/feet_p1/exports/F_claw60.3mf
98.0 x 111.9 x 20.6 mm
