SeanEZhou/slender-biped/hardware/leg_p0/exports/step/horns/STS3215_driven_round_5p8.step

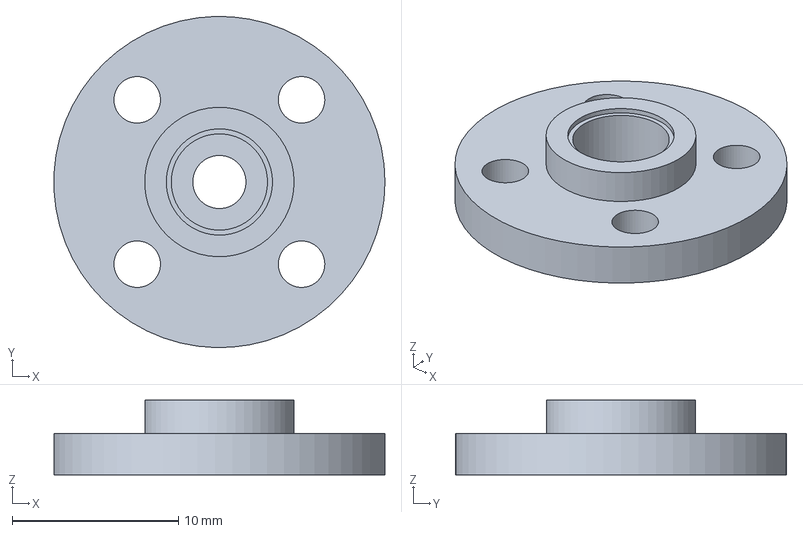
[picture p119: CAD file, 2026-10-31]
hardware/leg_p0/exports/step/horns/STS3215_driven_round_5p8.step
19.9 x 19.9 x 4.50 mm
