SeanEZhou/slender-biped/hardware/leg_p0/exports/stl_right_mirror/P04_roll_bracket_RIGHT.stl

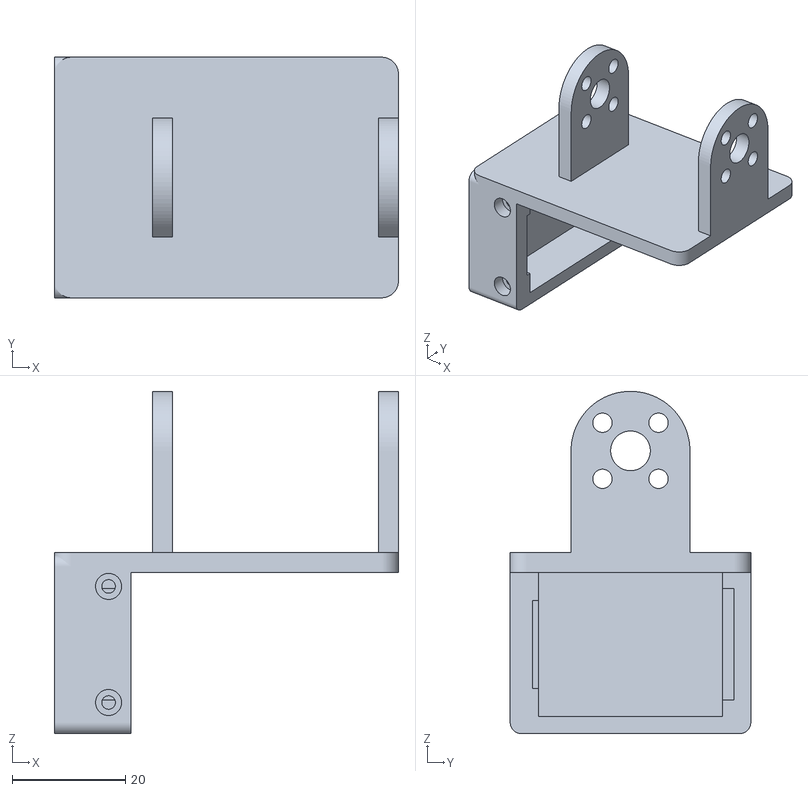
[picture p120: CAD file, 2026-10-27]
hardware/leg_p0/exports/stl_right_mirror/P04_roll_bracket_RIGHT.stl
60.8 x 42.5 x 60.4
