SeanEZhou/slender-biped/hardware/torso_p0/exports/print_ready/T05_chest_print.stl

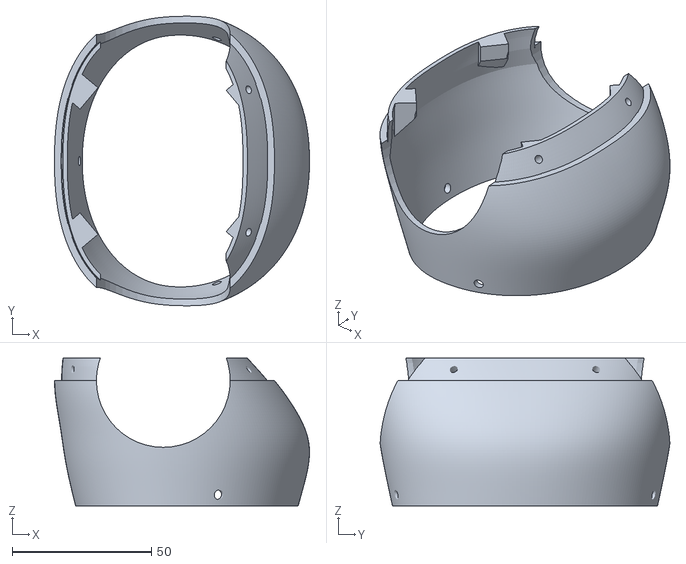
[picture p121: CAD file, 2026-11-01]
hardware/torso_p0/exports/print_ready/T05_chest_print.stl
91.5 x 103.9 x 53.0
