SeanEZhou/slender-biped/models/meshes/hw_p0_70mm/R_shin.stl

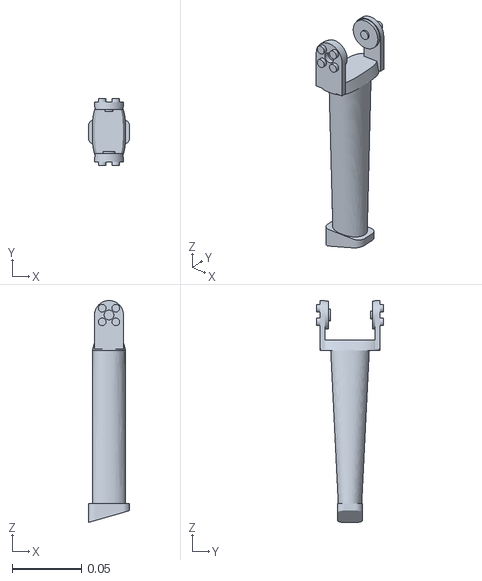
[picture p122: CAD file, 2026-10-30]
models/meshes/hw_p0_70mm/R_shin.stl
0.03 x 0.0482 x 0.16
