SeanEZhou/slender-biped/hardware/feet_p1/exports/F_board60.3mf

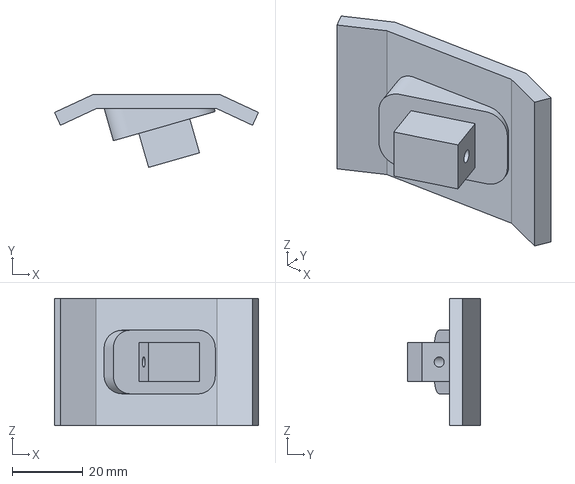
[picture p123: CAD file, 2026-11-09]
hardware/feet_p1/exports/F_board60.3mf
57.8 x 20.6 x 36.0 mm
