SeanEZhou/slender-biped/hardware/leg_p0/exports/stl_right_mirror/P05_thigh_RIGHT.stl

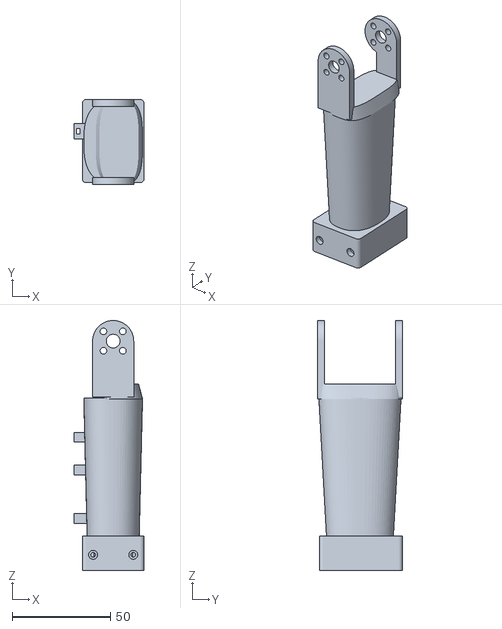
[picture p124: CAD file, 2026-10-27]
hardware/leg_p0/exports/stl_right_mirror/P05_thigh_RIGHT.stl
35.8 x 43.5 x 127.5
