SeanEZhou/slender-biped/hardware/leg_p0/fit_tests/A_case_pocket_gauge.step

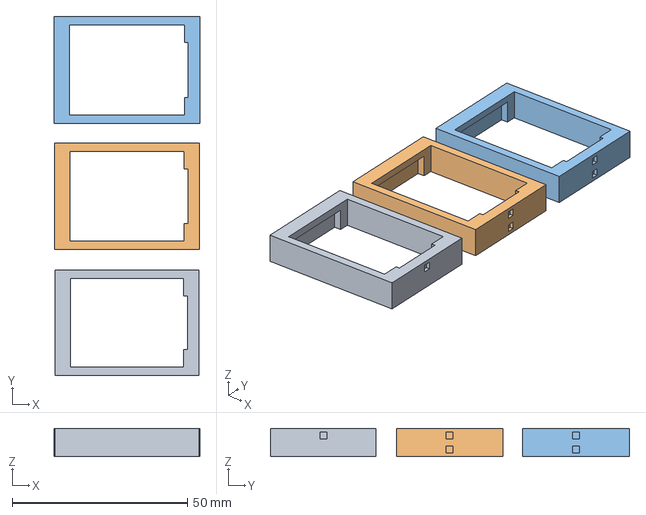
[picture p125: CAD file, 2026-10-27]
hardware/leg_p0/fit_tests/A_case_pocket_gauge.step
41.5 x 102.3 x 8.00 mm
