SeanEZhou/slender-biped/hardware/torso_p0/exports/print_ready/T03_pelvis_ring_print.stl

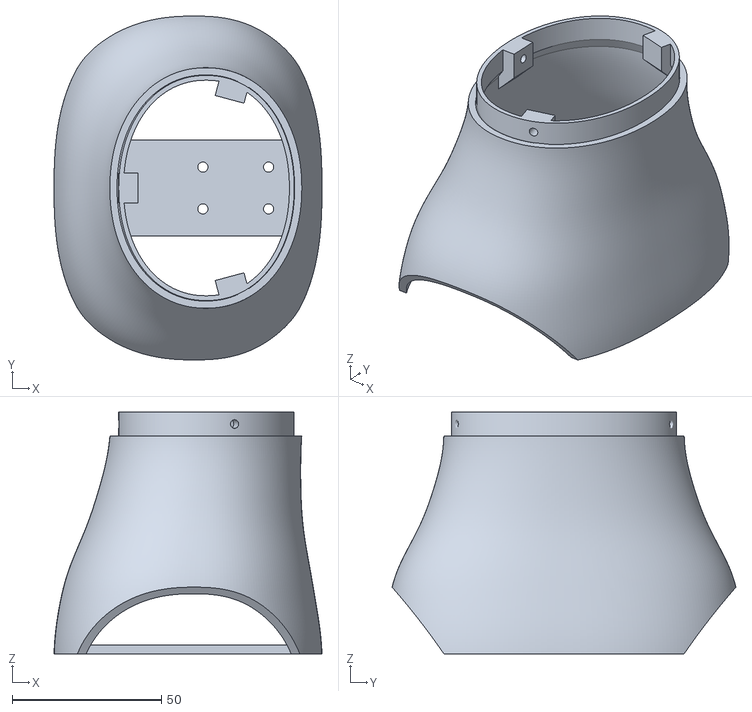
[picture p126: CAD file, 2026-11-01]
hardware/torso_p0/exports/print_ready/T03_pelvis_ring_print.stl
89.8 x 115.2 x 81.0
