SeanEZhou/slender-biped/models/meshes/hw_p0_60mm/L_pelvis.stl

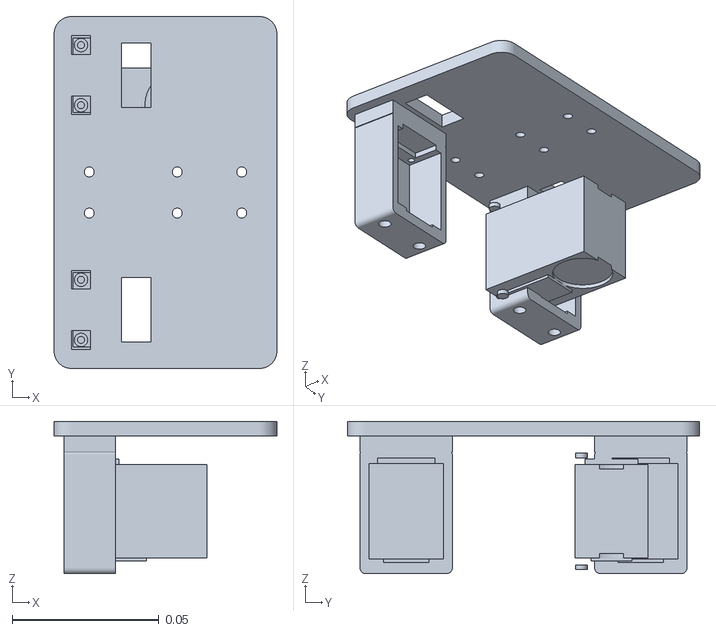
[picture p127: CAD file, 2026-10-30]
models/meshes/hw_p0_60mm/L_pelvis.stl
0.076 x 0.12 x 0.052
