SeanEZhou/slender-biped/hardware/leg_p0/exports/step/P08_pelvis_biped.step

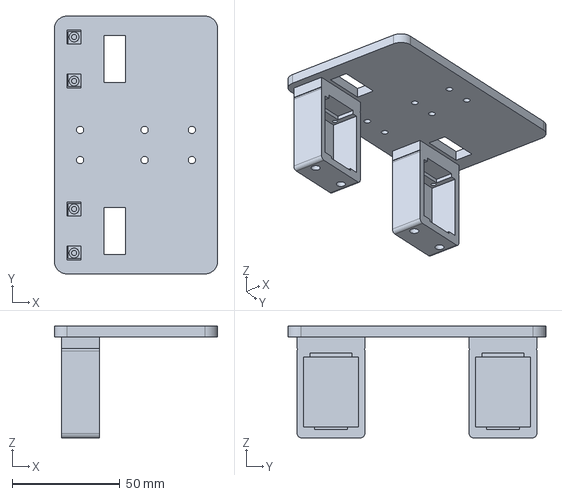
[picture p129: CAD file, 2026-10-30]
hardware/leg_p0/exports/step/P08_pelvis_biped.step
76.0 x 120.0 x 52.0 mm
