SeanEZhou/slender-biped/hardware/leg_p0/exports/stl/print_ready/P03_yaw_bracket_RIGHT_print.stl

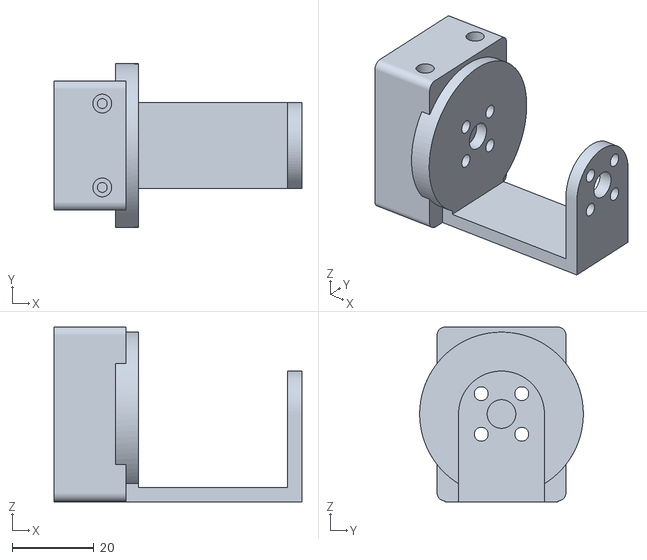
[picture p130: CAD file, 2026-10-30]
hardware/leg_p0/exports/stl/print_ready/P03_yaw_bracket_RIGHT_print.stl
60.6 x 40.0 x 42.8
