SeanEZhou/slender-biped/hardware/torso_p0/exports/print_ready/T06_shoulders_print.stl

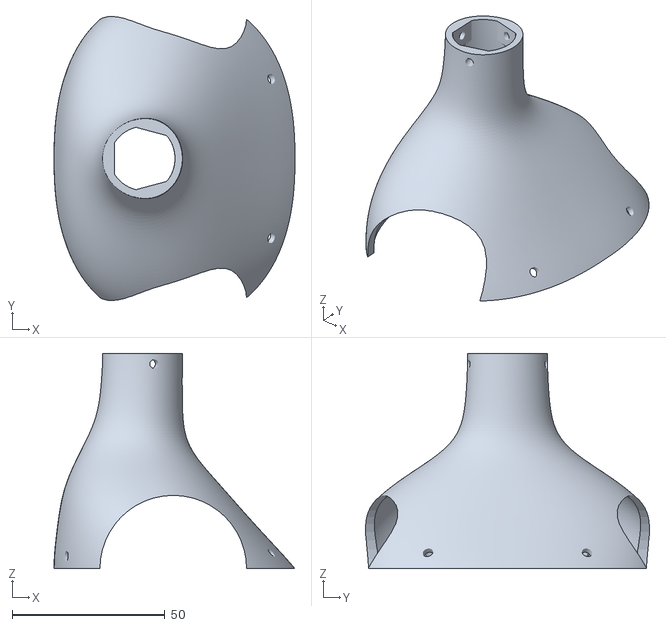
[picture p131: CAD file, 2026-11-01]
hardware/torso_p0/exports/print_ready/T06_shoulders_print.stl
78.9 x 93.0 x 70.5
