SeanEZhou/slender-biped/hardware/feet_p1/exports/F_talon45.3mf

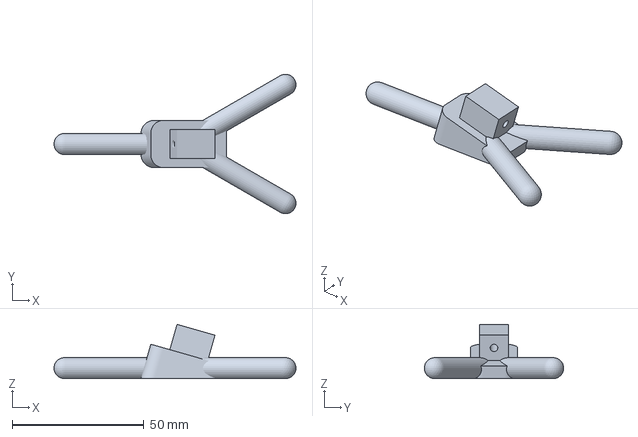
[picture p132: CAD file, 2026-11-09]
hardware/feet_p1/exports/F_talon45.3mf
92.0 x 53.0 x 20.6 mm
