SeanEZhou/slender-biped/hardware/leg_p0/exports/stl_right_mirror/P01_pelvis_plate_RIGHT.stl

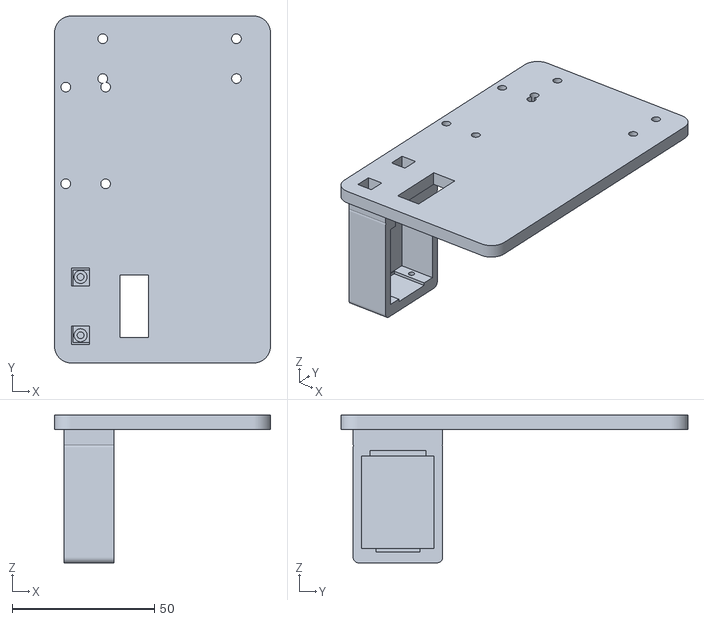
[picture p133: CAD file, 2026-10-27]
hardware/leg_p0/exports/stl_right_mirror/P01_pelvis_plate_RIGHT.stl
76.0 x 122.0 x 52.0
