SeanEZhou/slender-biped/hardware/torso_p0/exports/print_ready/T02_hip_rear_print.stl

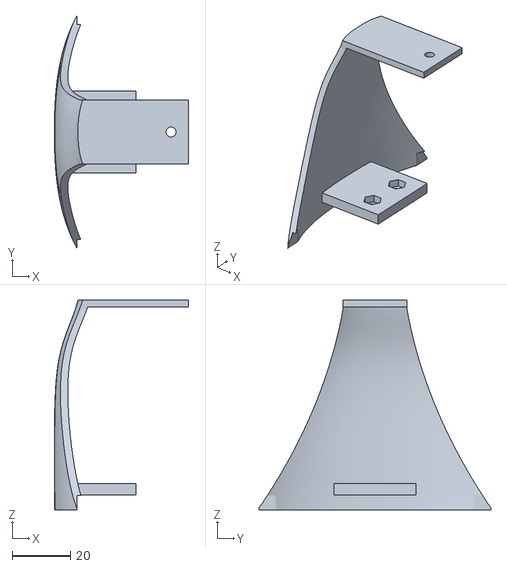
[picture p134: CAD file, 2026-10-31]
hardware/torso_p0/exports/print_ready/T02_hip_rear_print.stl
46.0 x 79.5 x 72.0
