SeanEZhou/slender-biped/hardware/feet_p1/exports/F_talon60.3mf

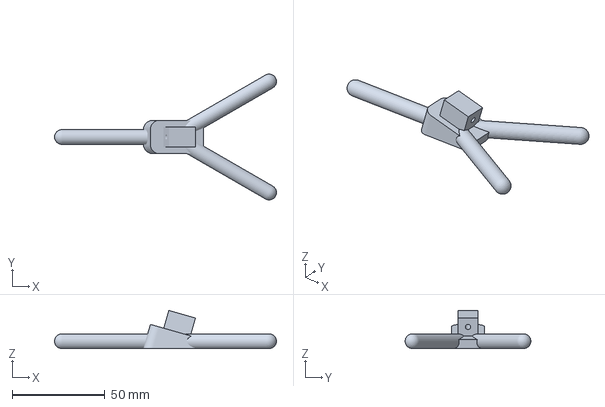
[picture p135: CAD file, 2026-11-09]
hardware/feet_p1/exports/F_talon60.3mf
120.0 x 68.0 x 20.6 mm
