SeanEZhou/slender-biped/hardware/feet_p1/exports/F_disc50.3mf

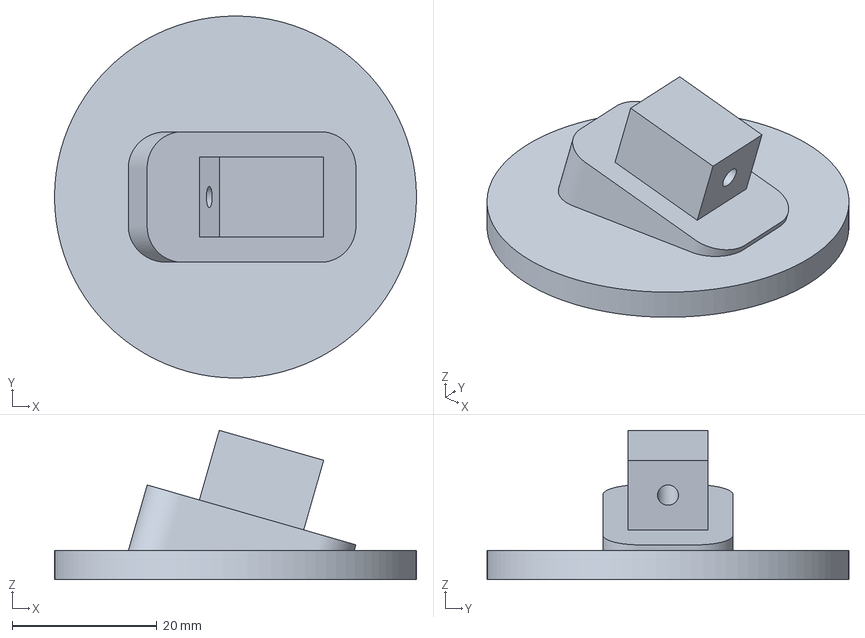
[picture p137: CAD file, 2026-11-09]
hardware/feet_p1/exports/F_disc50.3mf
50.0 x 50.0 x 20.6 mm
