SeanEZhou/slender-biped/hardware/leg_p0/exports/step/P05_thigh.step

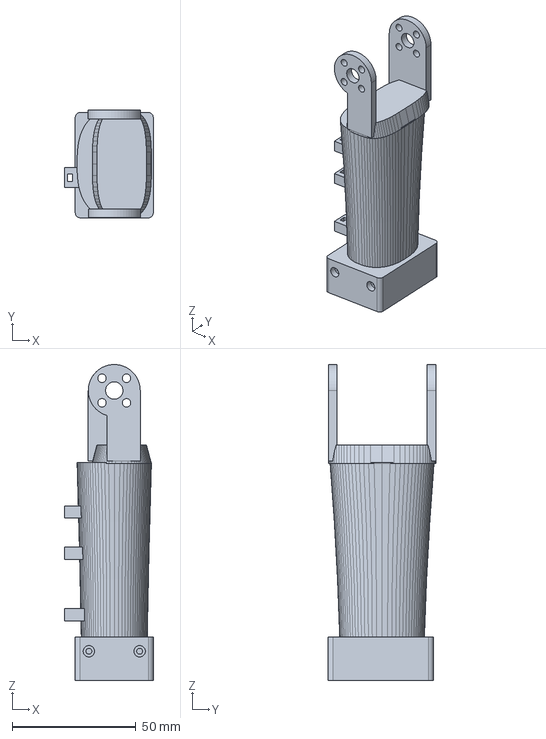
[picture p138: CAD file, 2026-10-29]
hardware/leg_p0/exports/step/P05_thigh.step
35.8 x 43.5 x 127.5 mm
