SeanEZhou/slender-biped/hardware/leg_p0/exports/stl/print_ready/P02_clamp_tongue_print.stl

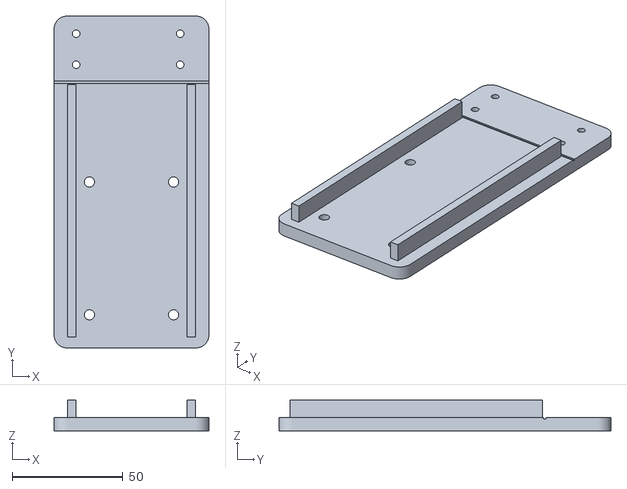
[picture p139: CAD file, 2026-10-30]
hardware/leg_p0/exports/stl/print_ready/P02_clamp_tongue_print.stl
70.0 x 150.0 x 14.0
