SeanEZhou/slender-biped/hardware/feet_p1/exports/F_claw45.3mf

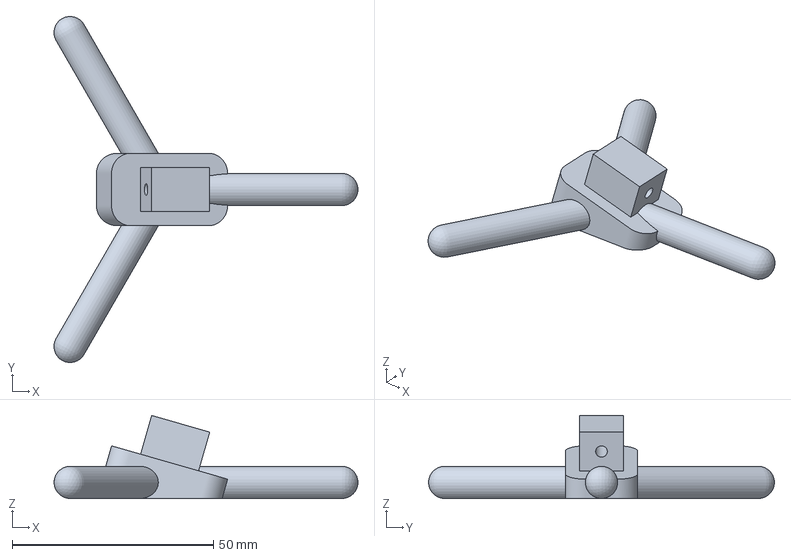
[picture p140: CAD file, 2026-11-09]
hardware/feet_p1/exports/F_claw45.3mf
75.5 x 85.9 x 20.6 mm
