SeanEZhou/slender-biped/hardware/leg_p0/exports/step/NOT_PRINTABLE_servo_dummy_STS3215.step

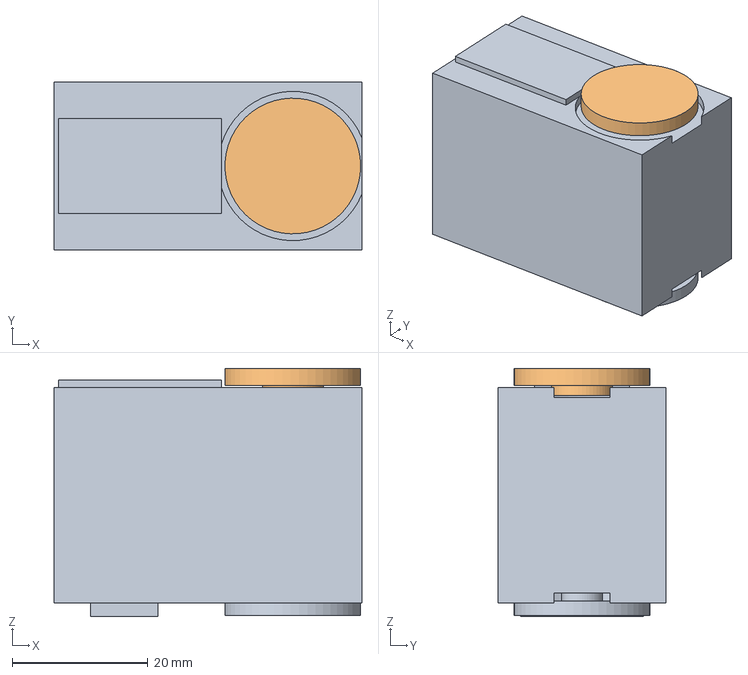
[picture p141: CAD file, 2026-10-29]
hardware/leg_p0/exports/step/NOT_PRINTABLE_servo_dummy_STS3215.step
45.4 x 24.8 x 36.6 mm
