SeanEZhou/slender-biped/hardware/feet_p1/exports/F_disc70.3mf

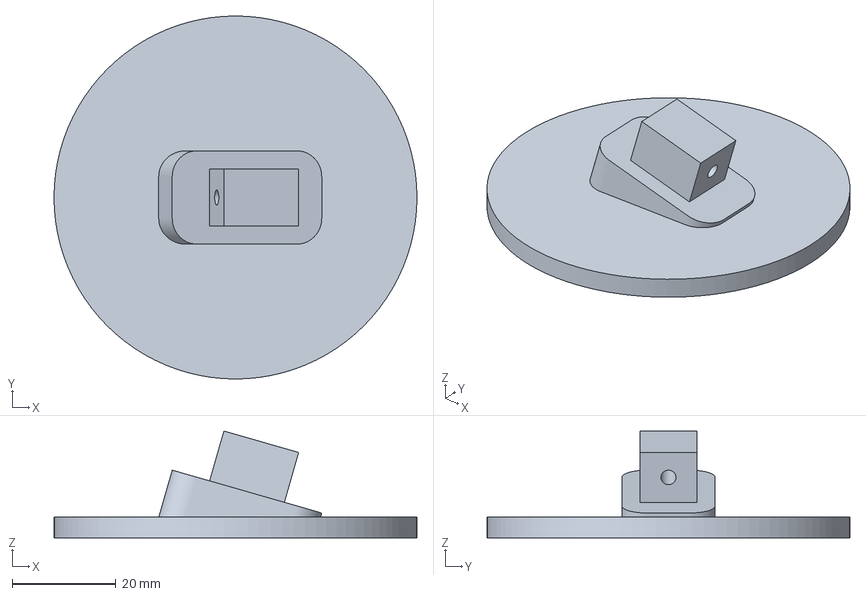
[picture p142: CAD file, 2026-11-09]
hardware/feet_p1/exports/F_disc70.3mf
70.0 x 70.0 x 20.6 mm
