SeanEZhou/slender-biped/hardware/feet_p1/exports/F_board120w.3mf

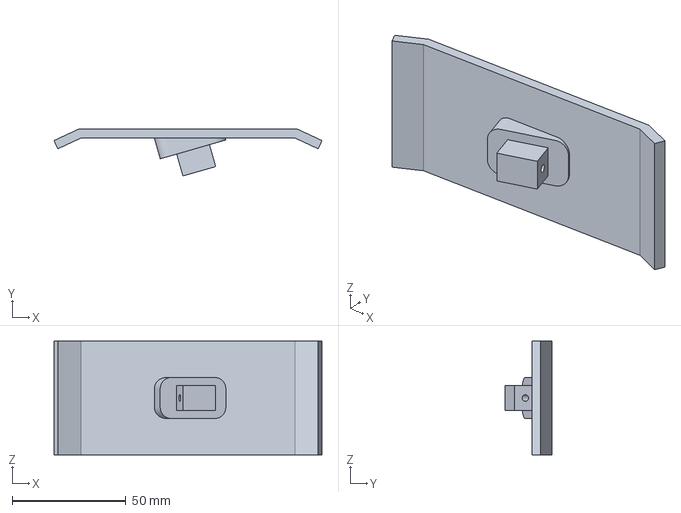
[picture p143: CAD file, 2026-11-09]
hardware/feet_p1/exports/F_board120w.3mf
117.8 x 20.6 x 50.0 mm
