SeanEZhou/slender-biped/hardware/feet_p1/exports/F_board150.3mf

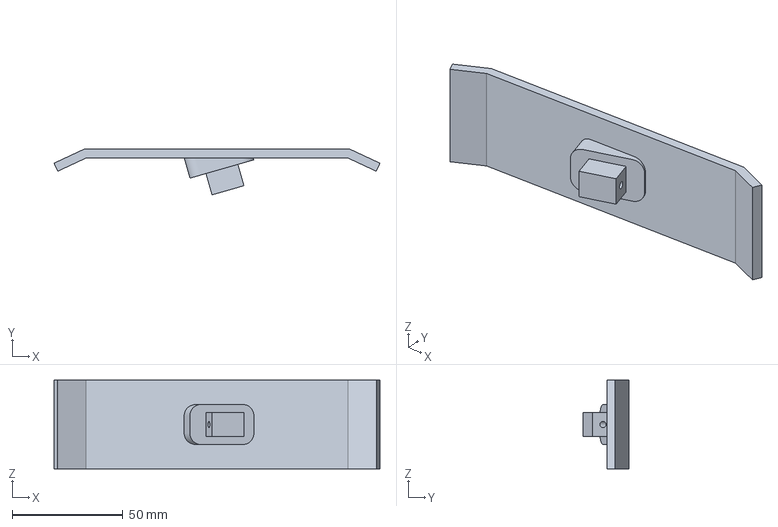
[picture p145: CAD file, 2026-11-09]
hardware/feet_p1/exports/F_board150.3mf
147.2 x 20.6 x 40.0 mm
