SeanEZhou/slender-biped/hardware/feet_p1/exports/F_board90w.3mf

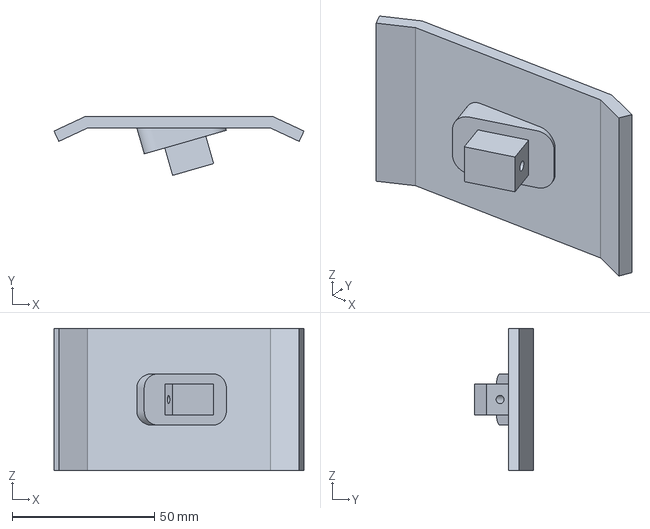
[picture p146: CAD file, 2026-11-09]
hardware/feet_p1/exports/F_board90w.3mf
87.8 x 20.6 x 50.0 mm
