SeanEZhou/slender-biped/hardware/feet_p1/exports/F_board150w.3mf

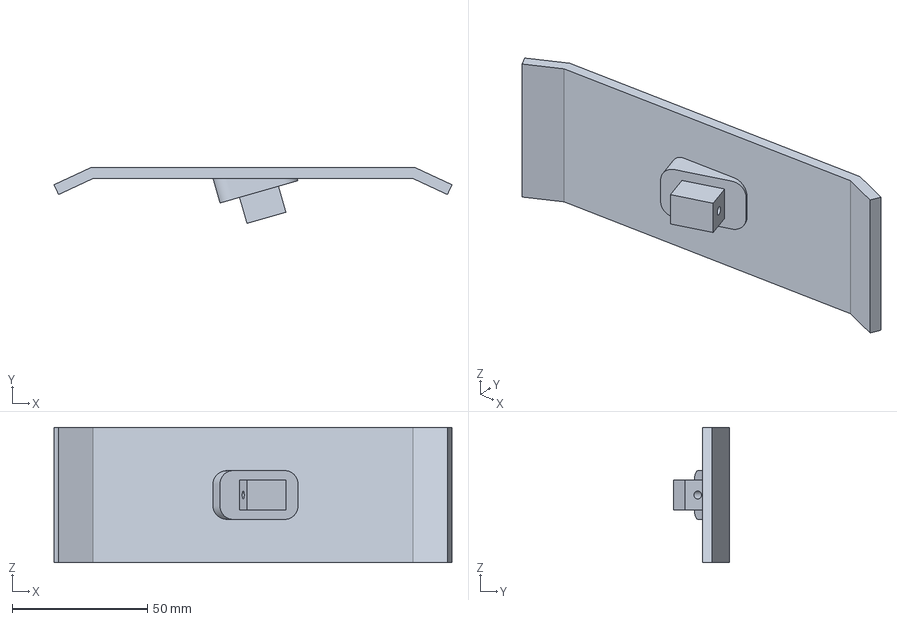
[picture p147: CAD file, 2026-11-09]
hardware/feet_p1/exports/F_board150w.3mf
147.2 x 20.6 x 50.0 mm
