SeanEZhou/slender-biped/(list of files, cad)

Other CAD files:
hardware/ankle_p1/exports/stl/print_ready/A01_shin_ankle_RIGHT_print.stl
models/meshes/hw_p0_80mm/R_thigh.stl
models/meshes/hw_p0_80mm_pad40/R_thigh.stl
hardware/ankle_p1/exports/step/A02_foot_ankle.step
hardware/ankle_p1/exports/stl/print_ready/A01_shin_ankle_print.stl
hardware/ankle_p1/exports/stl_right_mirror/A01_shin_ankle_RIGHT.stl
hardware/head_p1/versions/v4/exports/print_ready/H11_face_print.stl
hardware/leg_p0/exports/step/horns/STS3215_passive_6p15.step
hardware/leg_p0/exports/stl/print_ready/horns/STS3215_passive_6p05.stl
hardware/leg_p0/exports/stl/print_ready/P06_shin_RIGHT_print.stl
hardware/leg_p0/exports/stl_right_mirror/P07_pad_RIGHT.stl
models/meshes/hw_p0_70mm/L_yaw.stl
hardware/leg_p0/exports/step/P06_shin.step
hardware/leg_p0/exports/stl/print_ready/horns/STS3215_driven_loose.stl
hardware/leg_p0/exports/stl/print_ready/P07_pad_print.stl
models/meshes/ankle2/R_shin.stl
models/meshes/hw_p0_60mm/L_roll.stl
models/meshes/hw_p0_80mm/L_shin.stl
hardware/ankle_p1/exports/stl/print_ready/A02_foot_ankle_RIGHT_print.stl
hardware/leg_p0/exports/step/horns/STS3215_driven_nominal.step
hardware/leg_p0/exports/stl/print_ready/horns/STS3215_driven_round_5p7.stl
hardware/leg_p0/exports/stl/print_ready/P06_shin_print.stl
models/meshes/ankle2/L_foot.stl
models/meshes/hw_p0_70mm/L_pelvis.stl
models/meshes/hw_p0_80mm/L_pelvis.stl
hardware/leg_p0/exports/step/horns/STS3215_driven_loose.step
hardware/leg_p0/exports/stl/print_ready/horns/STS3215_passive_6p15.stl
hardware/leg_p0/exports/stl_right_mirror/P03_yaw_bracket_RIGHT.stl
models/meshes/hw_p0_60mm/L_yaw.stl
models/meshes/hw_p0_70mm/L_shin.stl
models/meshes/hw_p0_80mm_pad40/L_shin.stl
hardware/leg_p0/exports/step/horns/STS3215_passive_6p05.step
hardware/leg_p0/exports/step/P03_yaw_bracket.step
hardware/leg_p0/exports/stl/print_ready/horns/STS3215_passive_6p35.stl
hardware/leg_p0/exports/stl/print_ready/P04_roll_bracket_RIGHT_print.stl
models/meshes/hw_p0_70mm/R_thigh.stl
models/meshes/hw_p0_80mm_pad40/L_roll.stl
hardware/leg_p0/exports/step/P04_roll_bracket.step
hardware/leg_p0/exports/stl/print_ready/horns/STS3215_driven_nominal.stl
hardware/leg_p0/exports/stl/print_ready/P01_pelvis_plate_print.stl
models/meshes/hw_p0_60mm/R_thigh.stl
models/meshes/hw_p0_70mm/L_roll.stl
models/meshes/hw_p0_80mm_pad40/L_yaw.stl
hardware/leg_p0/exports/step/horns/STS3215_driven_tight.step
hardware/leg_p0/exports/stl/print_ready/horns/STS3215_passive_6p25.stl
models/meshes/hw_p0_60mm/L_shin.stl
models/meshes/hw_p0_80mm/L_roll.stl
models/meshes/hw_p0_80mm_pad40/L_pelvis.stl
hardware/leg_p0/exports/step/horns/STS3215_passive_6p25.step
hardware/leg_p0/exports/stl/print_ready/horns/STS3215_driven_round_5p8.stl
hardware/leg_p0/exports/stl/print_ready/P08_pelvis_biped_print.stl
models/meshes/hw_p0_80mm/L_yaw.stl
hardware/leg_p0/exports/step/P01_pelvis_plate.step
hardware/leg_p0/exports/stl/print_ready/P05_thigh_RIGHT_print.stl
hardware/leg_p0/exports/step/P02_clamp_tongue.step
hardware/leg_p0/exports/stl/print_ready/P05_thigh_print.stl
hardware/leg_p0/exports/stl/print_ready/P04_roll_bracket_print.stl
hardware/leg_p0/exports/stl/print_ready/P03_yaw_bracket_print.stl
hardware/ankle_p1/exports/3mf/A01_shin_ankle.3mf
hardware/ankle_p1/exports/3mf/A02_foot_ankle.3mf
hardware/ankle_p1/exports/stl/A01_shin_ankle.stl
hardware/ankle_p1/exports/stl/A02_foot_ankle.stl
hardware/feet_p1/exports/F_board120.stl
hardware/feet_p1/exports/F_board120w.stl
hardware/feet_p1/exports/F_board150.stl
hardware/feet_p1/exports/F_board150w.stl
hardware/feet_p1/exports/F_board60.stl
hardware/feet_p1/exports/F_board90.stl
hardware/feet_p1/exports/F_board90w.stl
hardware/feet_p1/exports/F_claw45.stl
hardware/feet_p1/exports/F_claw60.stl
hardware/feet_p1/exports/F_disc50.stl
hardware/feet_p1/exports/F_disc70.stl
hardware/feet_p1/exports/F_outer_strip15.stl
hardware/feet_p1/exports/F_outer_strip25.stl
hardware/feet_p1/exports/F_talon45.stl
hardware/feet_p1/exports/F_talon60.stl
hardware/head_p1/versions/v1/exports/print_ready/H11_face_print.stl
hardware/head_p1/versions/v1/exports/print_ready/H12_hair_print.stl
hardware/head_p1/versions/v1/exports/print_ready/H13_ear_left_print.stl
hardware/head_p1/versions/v1/exports/print_ready/H13_ear_right_print.stl
hardware/head_p1/versions/v2/exports/print_ready/H11_face_print.stl
hardware/head_p1/versions/v2/exports/print_ready/H12_hair_print.stl
hardware/head_p1/versions/v3/exports/print_ready/H11_face_print.stl
hardware/head_p1/versions/v3/exports/print_ready/H12_hair_print.stl
hardware/imu/exports/imu_slab.stl
hardware/leg_p0/exports/3mf/P01_pelvis_plate.3mf
hardware/leg_p0/exports/3mf/P02_clamp_tongue.3mf
hardware/leg_p0/exports/3mf/P03_yaw_bracket.3mf
hardware/leg_p0/exports/3mf/P04_roll_bracket.3mf
hardware/leg_p0/exports/3mf/P05_thigh.3mf
hardware/leg_p0/exports/3mf/P06_shin.3mf
hardware/leg_p0/exports/3mf/P07_pad.3mf
hardware/leg_p0/exports/3mf/P08_pelvis_biped.3mf
hardware/leg_p0/exports/stl/NOT_PRINTABLE_servo_dummy_STS3215.stl
hardware/leg_p0/exports/stl/P01_pelvis_plate.stl
hardware/leg_p0/exports/stl/P02_clamp_tongue.stl
hardware/leg_p0/exports/stl/P03_yaw_bracket.stl
hardware/leg_p0/exports/stl/P04_roll_bracket.stl
hardware/leg_p0/exports/stl/P05_thigh.stl
hardware/leg_p0/exports/stl/P06_shin.stl
hardware/leg_p0/exports/stl/P07_pad.stl
hardware/leg_p0/exports/stl/P08_pelvis_biped.stl
hardware/leg_p0/fit_tests/A_case_pocket_gauge.stl
hardware/leg_p0/fit_tests/B_C_horn_and_idler_arms.stl
hardware/leg_p0/fit_tests/D_hole_and_nut_gauge.step
hardware/leg_p0/fit_tests/D_hole_and_nut_gauge.stl
hardware/leg_p0/fit_tests/E_pad_socket_coupon.stl
