SeanEZhou/slender-biped/assets/unexpected_setbacks/3d_printed_horns.jpg

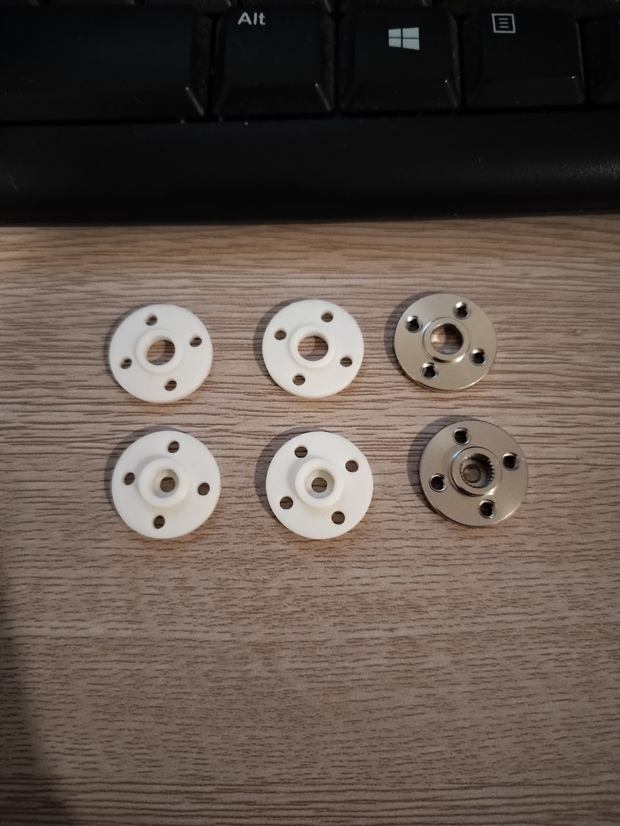
assets/unexpected_setbacks/3d_printed_horns.jpg
