SeanEZhou/slender-biped/results/compare_stand_v2.md

### stand

| metric | stand_A8_v2_nodr_s0 | stand_B8_v2_nodr_s0 |
|---|---|---|
| alive @15 s | 99% | 100% |
| alive @30 s | 99% | 99% |
| median survival [s] | 30.0 | 30.0 |
| steps / s | 7.9 | 8.3 |
| stationary (0 steps) | 0% | 0% |
| drift [m] | 0.71 | 1.02 |
| mean vx [m/s] | 0.065 | -0.040 |
| duty saturation frac | 0.007 | 0.011 |
| over-speed events | 1 | 0 |
| median peak tilt [deg] | 7.7 | 8.3 |

`stand_A8_v2_nodr_s0` peak |τ|/stall per joint [0.89, 1.0, 1.0, 1.0, 1.0, 1.0, 1.0, 1.0], RMS |τ| [N·m] [0.078, 0.396, 0.375, 0.412, 0.077, 0.373, 0.381, 0.396], RMS/rated [0.529, 0.842, 0.798, 0.876, 0.522, 0.793, 0.811, 0.843], peak speed / no-load [0.718, 0.872, 0.937, 1.003, 0.699, 0.867, 0.868, 0.968]

`stand_B8_v2_nodr_s0` peak |τ|/stall per joint [1.0, 1.0, 1.0, 1.0, 1.0, 1.0, 1.0, 1.0], RMS |τ| [N·m] [0.083, 0.413, 0.362, 0.446, 0.071, 0.398, 0.371, 0.401], RMS/rated [0.561, 0.88, 0.77, 0.95, 0.482, 0.846, 0.79, 0.853], peak speed / no-load [0.702, 0.914, 0.887, 0.996, 0.618, 0.904, 0.863, 0.906]
