SeanEZhou/slender-biped/results/compare_walk_v5.md

### walk_best

| metric | walk_A8_v5_dr_s0 | walk_B8_v5_dr_s0 |
|---|---|---|
| alive @15 s | 99% | 99% |
| alive @30 s | 0% | 0% |
| median survival [s] | 20.0 | 20.0 |
| steps / s | 5.0 | 6.8 |
| stationary (0 steps) | 0% | 0% |
| drift [m] | 1.39 | 1.51 |
| walk ≥1 m | 79% | 86% |
| walk ≥2 m | 0% | 6% |
| mean vx [m/s] | 0.065 | 0.073 |
| duty saturation frac | 0.003 | 0.007 |
| over-speed events | 1 | 3 |
| median peak tilt [deg] | 9.1 | 10.6 |

`walk_A8_v5_dr_s0` peak |τ|/stall per joint [0.847, 1.0, 1.0, 1.0, 0.888, 1.0, 1.0, 1.0], RMS |τ| [N·m] [0.091, 0.365, 0.322, 0.366, 0.117, 0.335, 0.303, 0.391], RMS/rated [0.621, 0.776, 0.685, 0.778, 0.797, 0.713, 0.644, 0.832], peak speed / no-load [0.735, 0.832, 0.902, 1.008, 0.769, 0.829, 0.799, 0.943]

`walk_B8_v5_dr_s0` peak |τ|/stall per joint [1.0, 1.0, 1.0, 1.0, 0.949, 1.0, 1.0, 1.0], RMS |τ| [N·m] [0.114, 0.341, 0.328, 0.406, 0.077, 0.35, 0.307, 0.375], RMS/rated [0.773, 0.727, 0.698, 0.864, 0.523, 0.745, 0.654, 0.798], peak speed / no-load [0.761, 0.807, 0.841, 1.164, 0.638, 0.84, 0.824, 1.047]

### startstop_best

| metric | walk_A8_v5_dr_s0 | walk_B8_v5_dr_s0 |
|---|---|---|
| alive @15 s | 100% | 100% |
| alive @30 s | 0% | 0% |
| median survival [s] | 18.0 | 18.0 |
| steps / s | 4.6 | 6.5 |
| stationary (0 steps) | 0% | 0% |
| drift [m] | 0.69 | 1.13 |
| mean vx [m/s] | 0.034 | 0.061 |
| start/stop ok | 44% | 38% |
| duty saturation frac | 0.003 | 0.006 |
| over-speed events | 1 | 0 |
| median peak tilt [deg] | 9.5 | 10.3 |

`walk_A8_v5_dr_s0` peak |τ|/stall per joint [0.892, 1.0, 1.0, 1.0, 0.888, 1.0, 1.0, 1.0], RMS |τ| [N·m] [0.092, 0.349, 0.314, 0.352, 0.116, 0.328, 0.302, 0.39], RMS/rated [0.629, 0.742, 0.667, 0.749, 0.791, 0.697, 0.642, 0.829], peak speed / no-load [0.735, 0.81, 0.891, 1.091, 0.776, 0.85, 0.702, 0.943]

`walk_B8_v5_dr_s0` peak |τ|/stall per joint [0.943, 1.0, 1.0, 1.0, 0.949, 1.0, 1.0, 1.0], RMS |τ| [N·m] [0.114, 0.343, 0.321, 0.404, 0.078, 0.346, 0.304, 0.369], RMS/rated [0.779, 0.73, 0.684, 0.859, 0.528, 0.737, 0.646, 0.785], peak speed / no-load [0.759, 0.807, 0.809, 0.933, 0.688, 0.867, 0.809, 0.881]

### stand_best

| metric | walk_A8_v5_dr_s0 | walk_B8_v5_dr_s0 |
|---|---|---|
| alive @15 s | 99% | 100% |
| alive @30 s | 99% | 98% |
| median survival [s] | 30.0 | 30.0 |
| steps / s | 4.7 | 5.5 |
| stationary (0 steps) | 0% | 0% |
| drift [m] | 0.30 | 0.36 |
| mean vx [m/s] | -0.019 | 0.000 |
| duty saturation frac | 0.003 | 0.005 |
| over-speed events | 0 | 4 |
| median peak tilt [deg] | 9.7 | 10.2 |

`walk_A8_v5_dr_s0` peak |τ|/stall per joint [0.88, 1.0, 1.0, 1.0, 0.957, 1.0, 1.0, 1.0], RMS |τ| [N·m] [0.093, 0.341, 0.333, 0.34, 0.117, 0.334, 0.318, 0.41], RMS/rated [0.636, 0.726, 0.708, 0.723, 0.794, 0.711, 0.676, 0.873], peak speed / no-load [0.726, 0.8, 0.895, 0.819, 0.742, 0.829, 0.751, 0.992]

`walk_B8_v5_dr_s0` peak |τ|/stall per joint [0.999, 1.0, 1.0, 1.0, 0.965, 1.0, 1.0, 1.0], RMS |τ| [N·m] [0.115, 0.346, 0.308, 0.396, 0.075, 0.341, 0.288, 0.36], RMS/rated [0.783, 0.735, 0.656, 0.842, 0.511, 0.727, 0.614, 0.765], peak speed / no-load [0.73, 0.744, 0.756, 0.886, 0.726, 0.907, 0.849, 1.462]
