SeanEZhou/slender-biped/results/compare_stand_v1.md

### stand

| metric | stand_A8_step_nodr_s0 | stand_B8_step_nodr_s0 |
|---|---|---|
| alive @15 s | 98% | 94% |
| alive @30 s | 96% | 85% |
| median survival [s] | 30.0 | 30.0 |
| steps / s | 11.1 | 10.5 |
| stationary (0 steps) | 0% | 0% |
| drift [m] | 1.53 | 2.51 |
| mean vx [m/s] | 0.033 | 0.119 |
| duty saturation frac | 0.041 | 0.047 |
| over-speed events | 85 | 62 |
| median peak tilt [deg] | 15.0 | 15.9 |

`stand_A8_step_nodr_s0` peak |τ|/stall per joint [1.0, 1.0, 1.0, 1.0, 1.0, 1.0, 1.0, 1.0], RMS |τ|/stall [0.085, 0.608, 0.5, 0.463, 0.097, 0.625, 0.508, 0.482], peak speed / no-load [0.658, 1.086, 0.974, 1.29, 0.747, 1.087, 0.998, 1.062]

`stand_B8_step_nodr_s0` peak |τ|/stall per joint [1.0, 1.0, 1.0, 1.0, 1.0, 1.0, 1.0, 1.0], RMS |τ|/stall [0.091, 0.644, 0.507, 0.491, 0.08, 0.661, 0.498, 0.475], peak speed / no-load [1.023, 1.056, 0.984, 1.104, 0.694, 1.052, 0.967, 1.117]
