SeanEZhou/slender-biped/results/compare_stand_v1.png

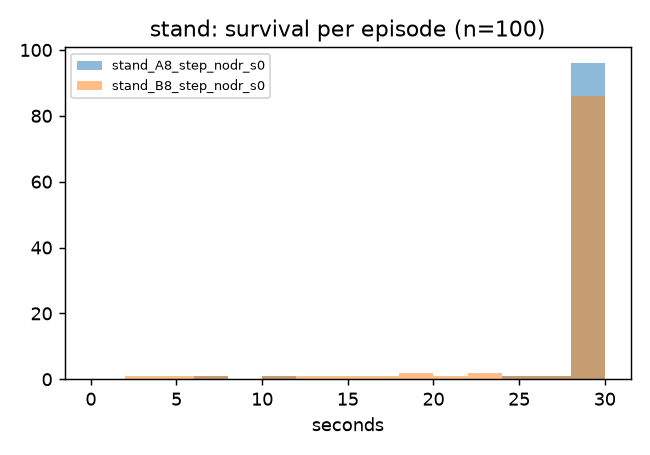
results/compare_stand_v1.png
