SeanEZhou/slender-biped/results/compare_walk_v5.png

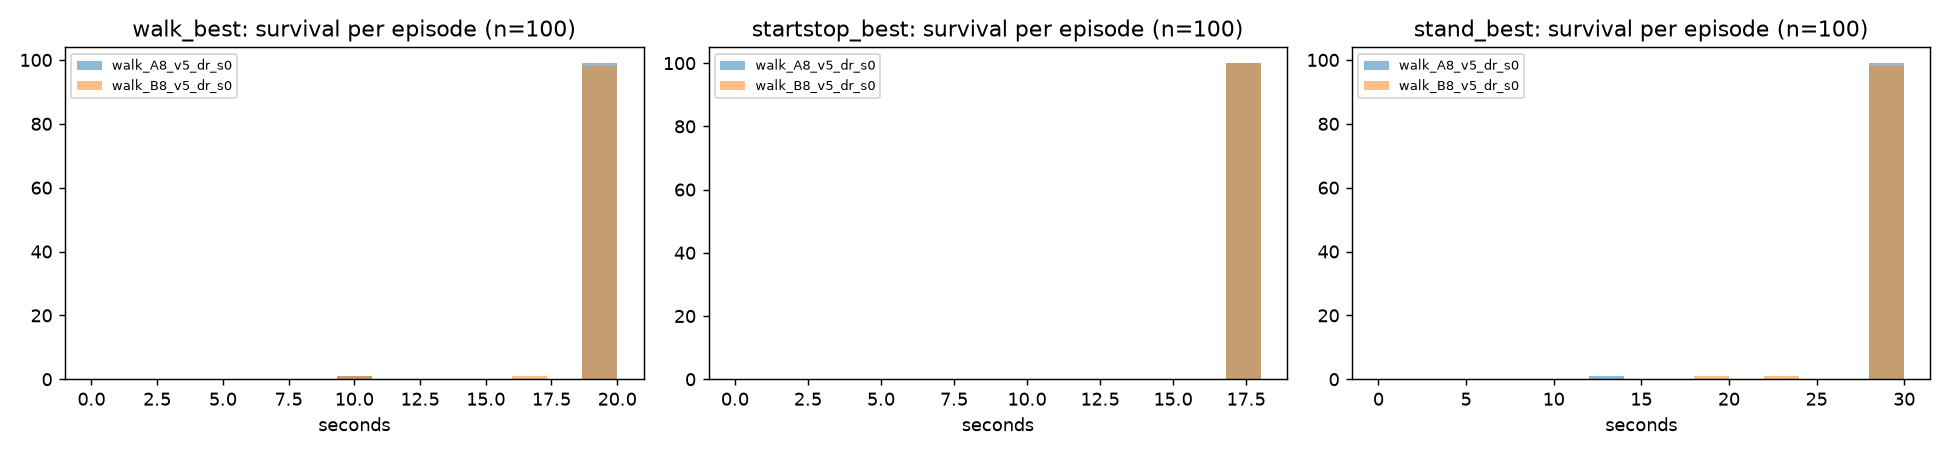
results/compare_walk_v5.png
