SeanEZhou/slender-biped/results/plots/curves_stand.png

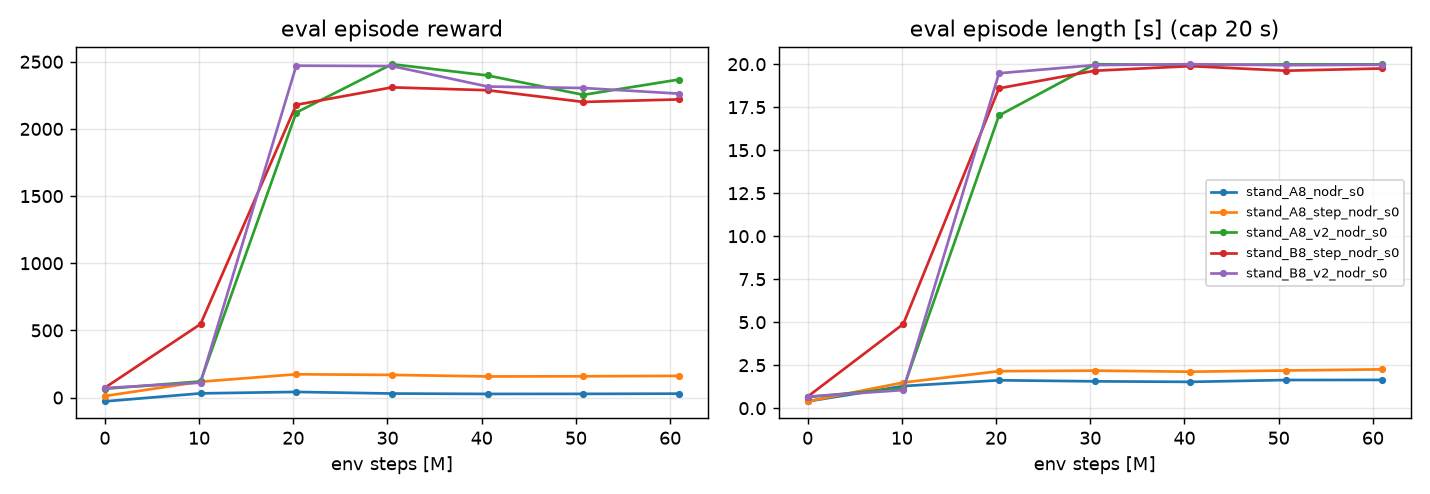
results/plots/curves_stand.png
