SeanEZhou/slender-biped/results/plots/curves_walk.png

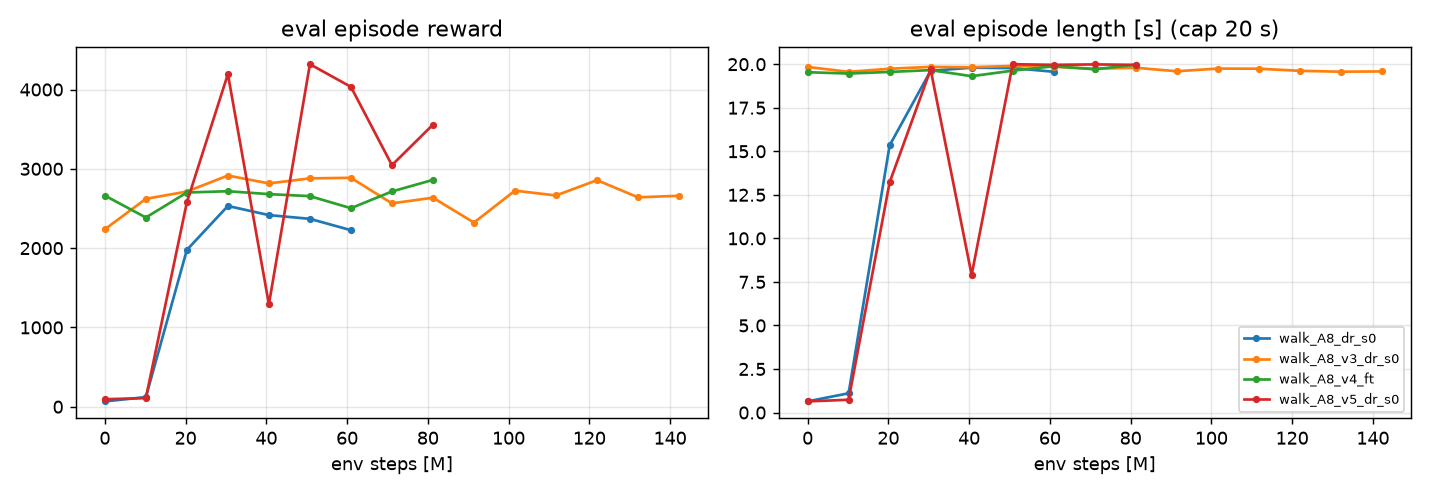
results/plots/curves_walk.png
