SeanEZhou/slender-biped/results/plots/rig_crouch_to_stand_baseline_A_10dof_xl330_only.png

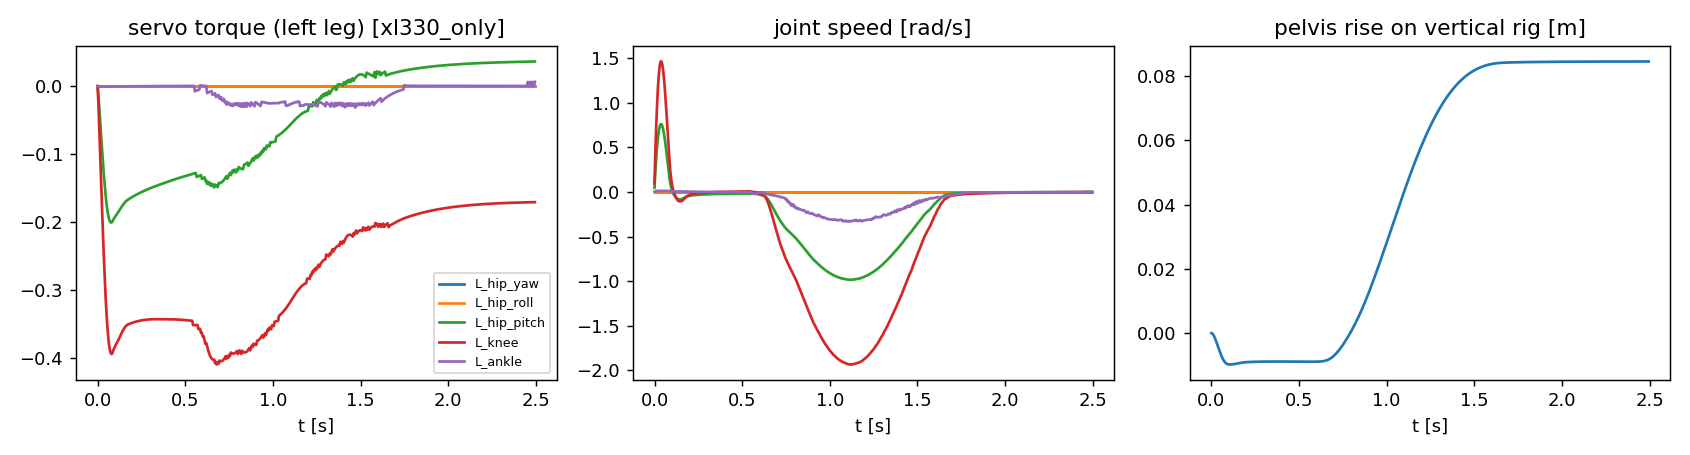
results/plots/rig_crouch_to_stand_baseline_A_10dof_xl330_only.png
