SeanEZhou/slender-biped/results/plots/rig_crouch_to_stand_baseline_B_8dof_torque_feetech_12v.png

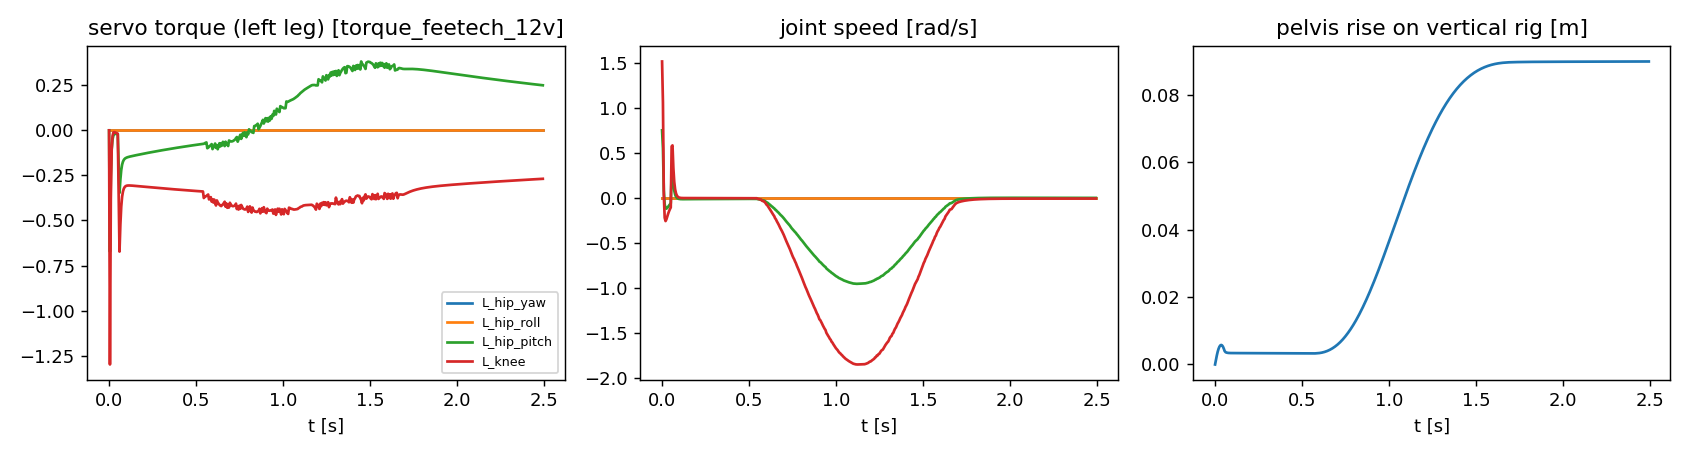
results/plots/rig_crouch_to_stand_baseline_B_8dof_torque_feetech_12v.png
