SeanEZhou/slender-biped/results/plots/robustness_stand.png

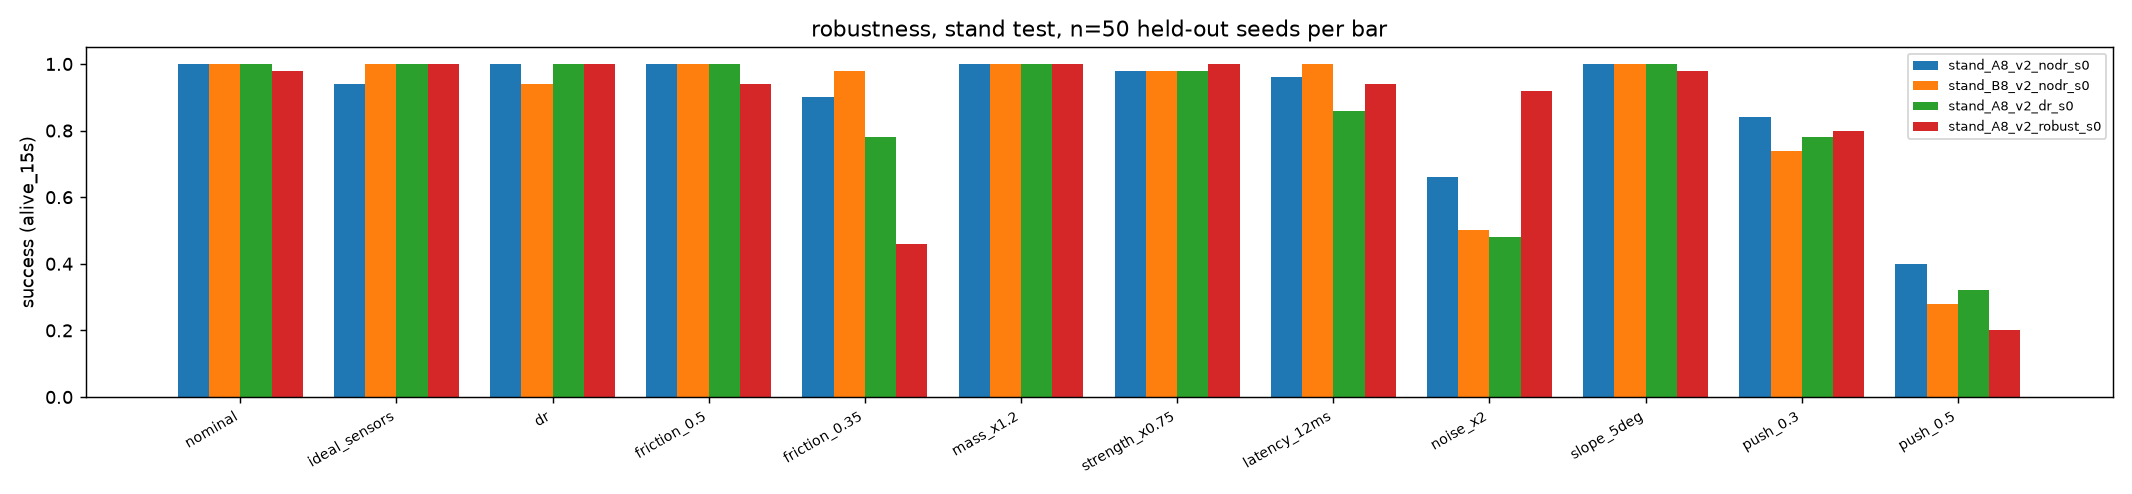
results/plots/robustness_stand.png
