SeanEZhou/slender-biped/results/plots/robustness_walk.png

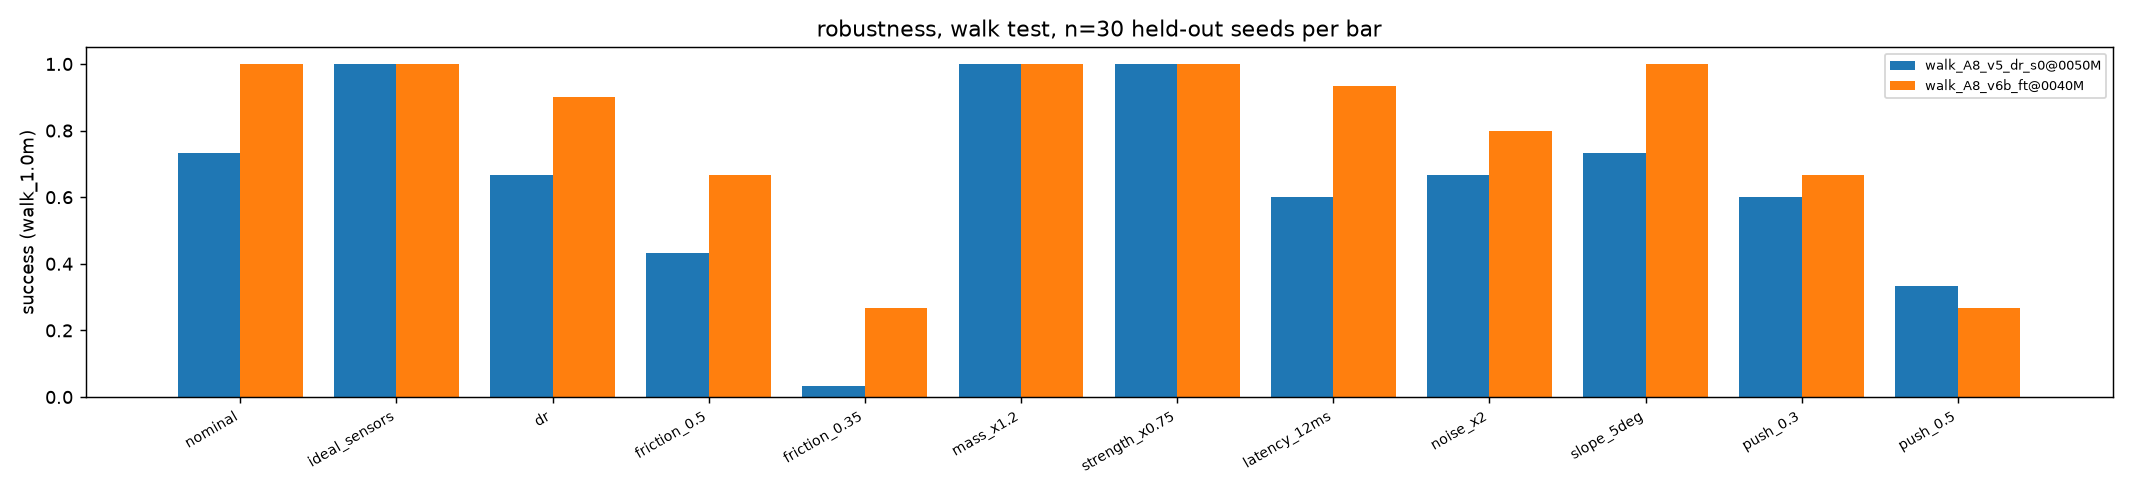
results/plots/robustness_walk.png
