SeanEZhou/slender-biped/results/plots/static_torque_baseline_A_10dof.png

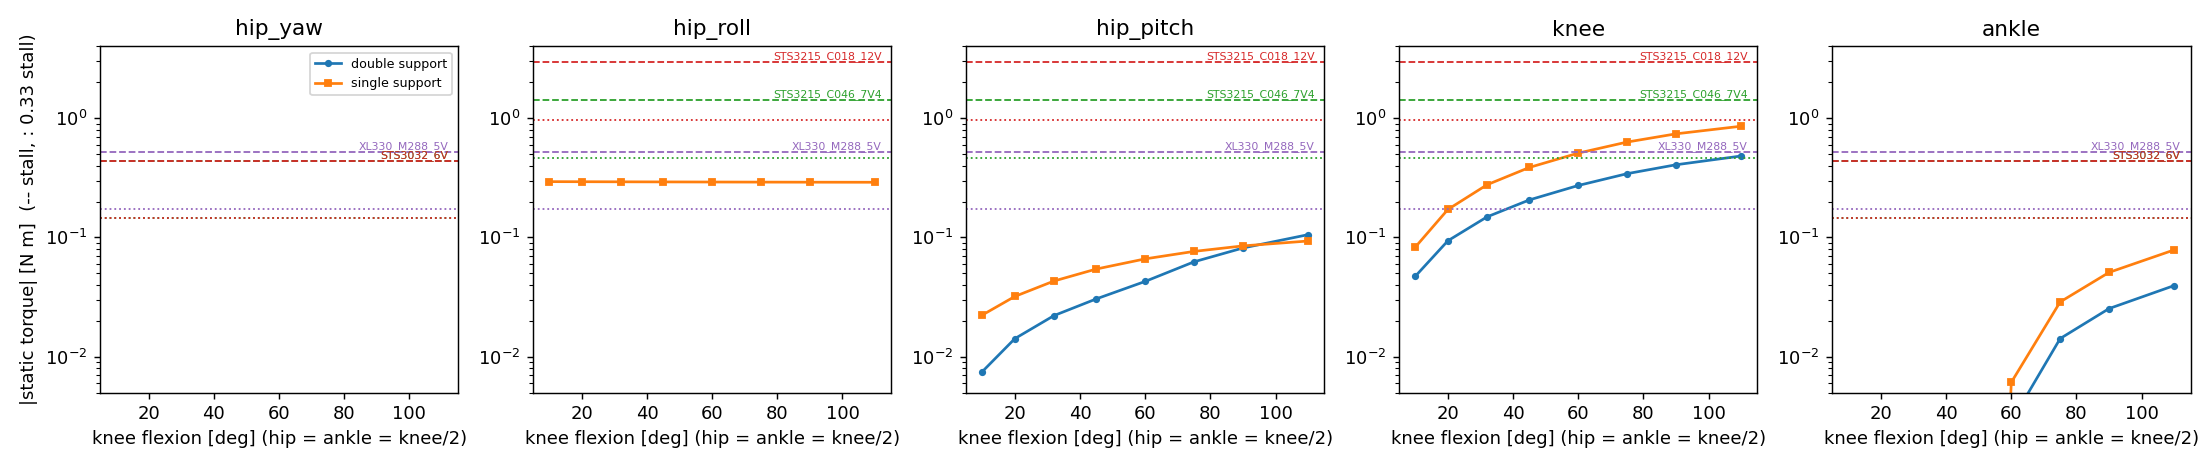
results/plots/static_torque_baseline_A_10dof.png
