SeanEZhou/slender-biped/results/plots/swing_torque_speed_baseline_A_10dof.png

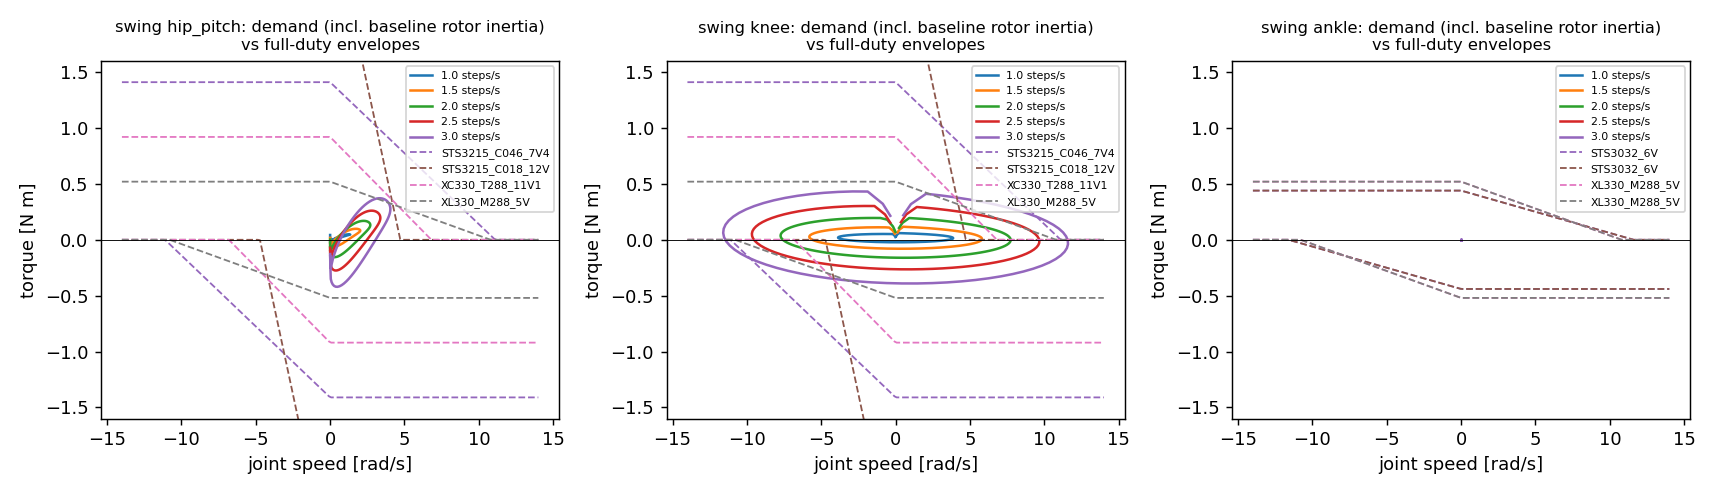
results/plots/swing_torque_speed_baseline_A_10dof.png
