SeanEZhou/slender-biped/results/power/hw_stand_ft__stand.png

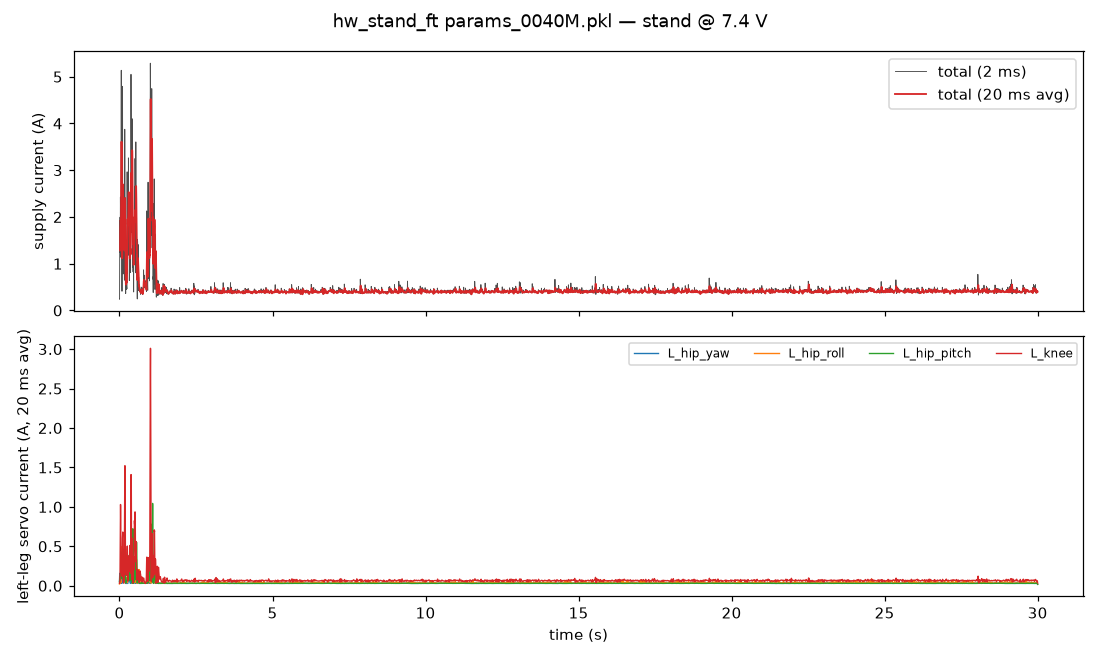
results/power/hw_stand_ft__stand.png
