SeanEZhou/slender-biped/results/power/hw_stand_push2__stand.png

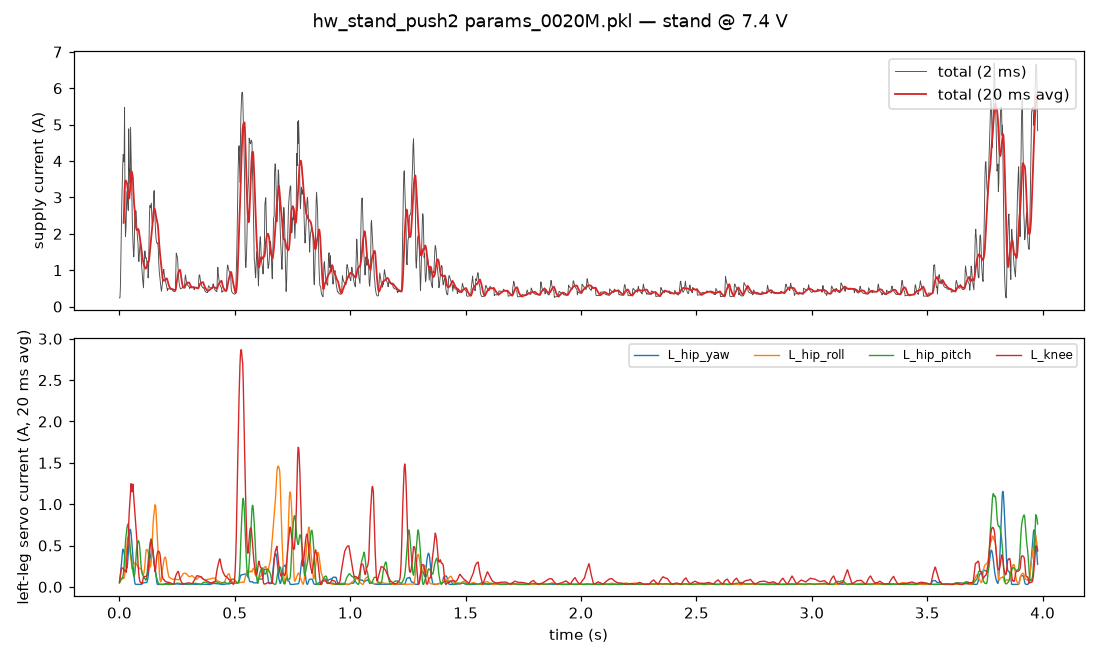
results/power/hw_stand_push2__stand.png
