SeanEZhou/slender-biped/results/power/hw_stand_push__stand.png

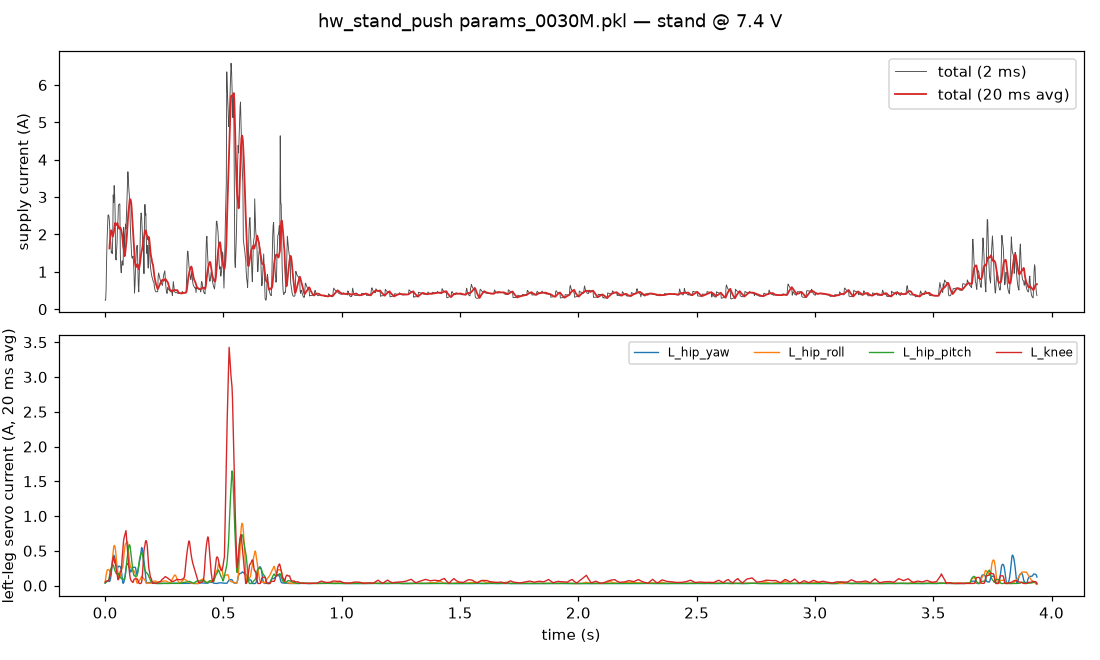
results/power/hw_stand_push__stand.png
