SeanEZhou/slender-biped/results/power/hw_stand_scratch__stand.png

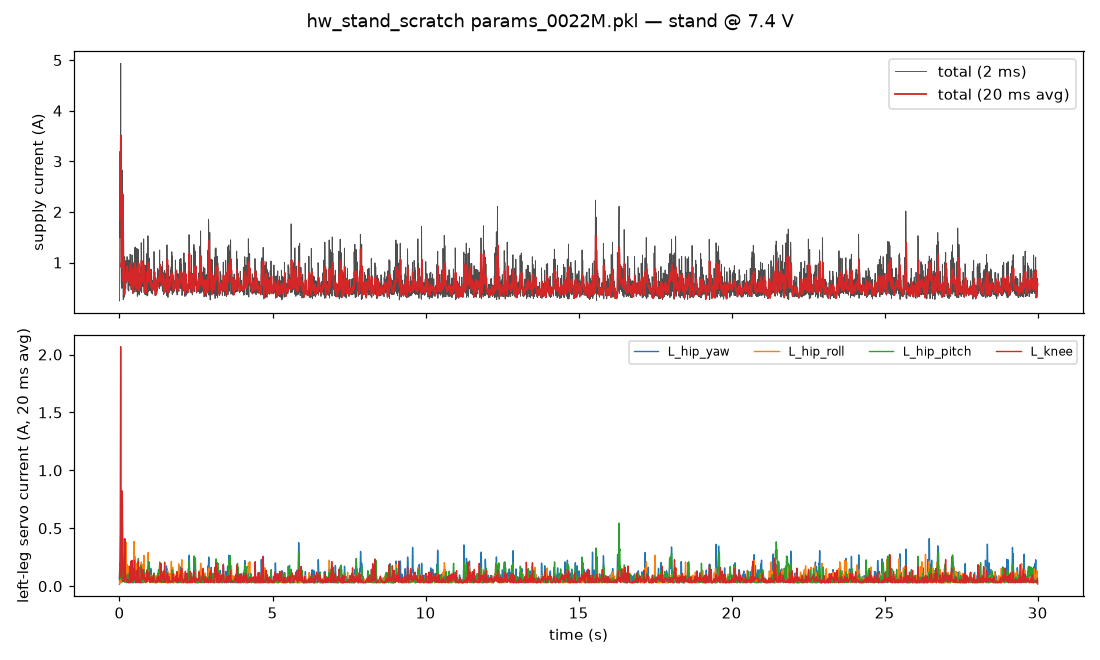
results/power/hw_stand_scratch__stand.png
