SeanEZhou/slender-biped/results/power/hw_walk_best_push__stand.png

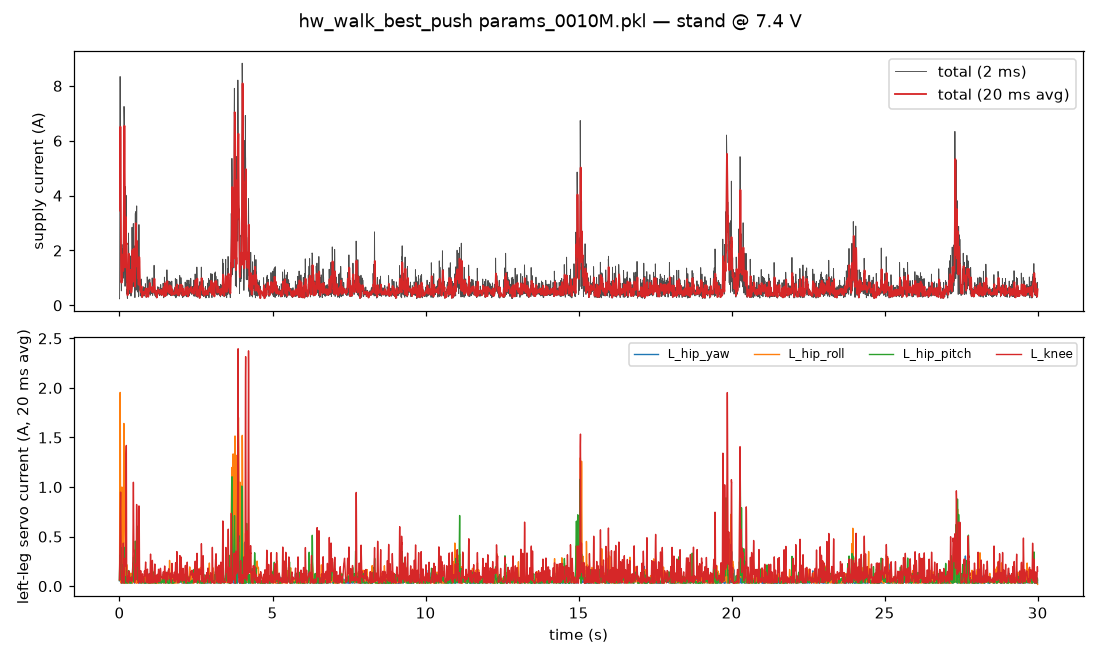
results/power/hw_walk_best_push__stand.png
