SeanEZhou/slender-biped/results/power/hw_walk_best_push__walk40.png

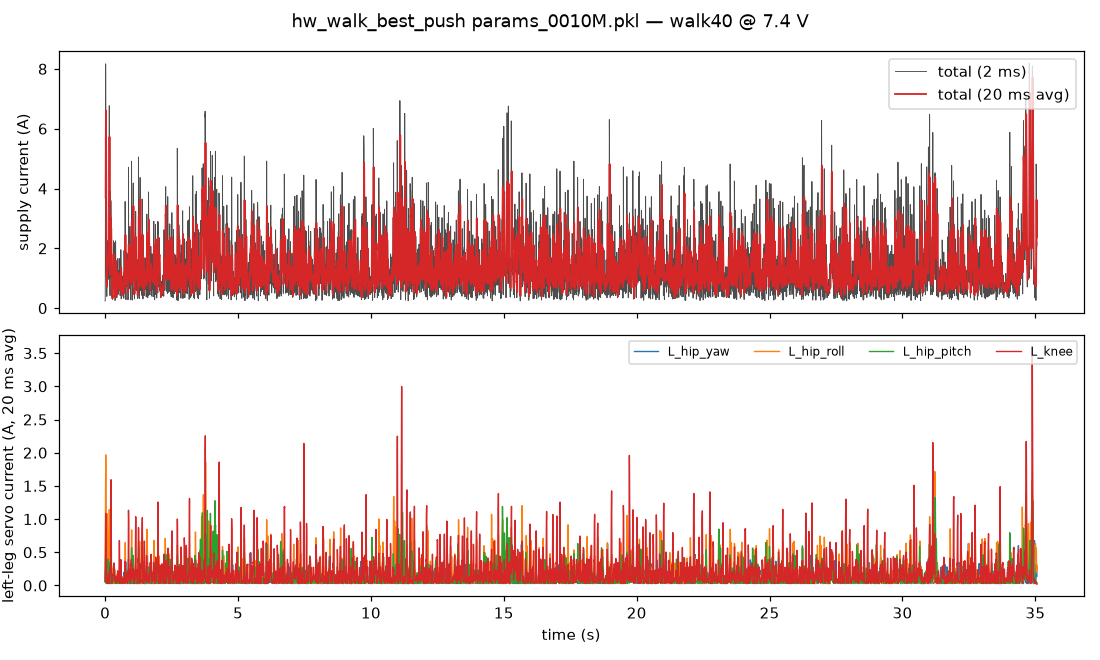
results/power/hw_walk_best_push__walk40.png
