SeanEZhou/slender-biped/results/power/hw_walk_c044_ft__stand.png

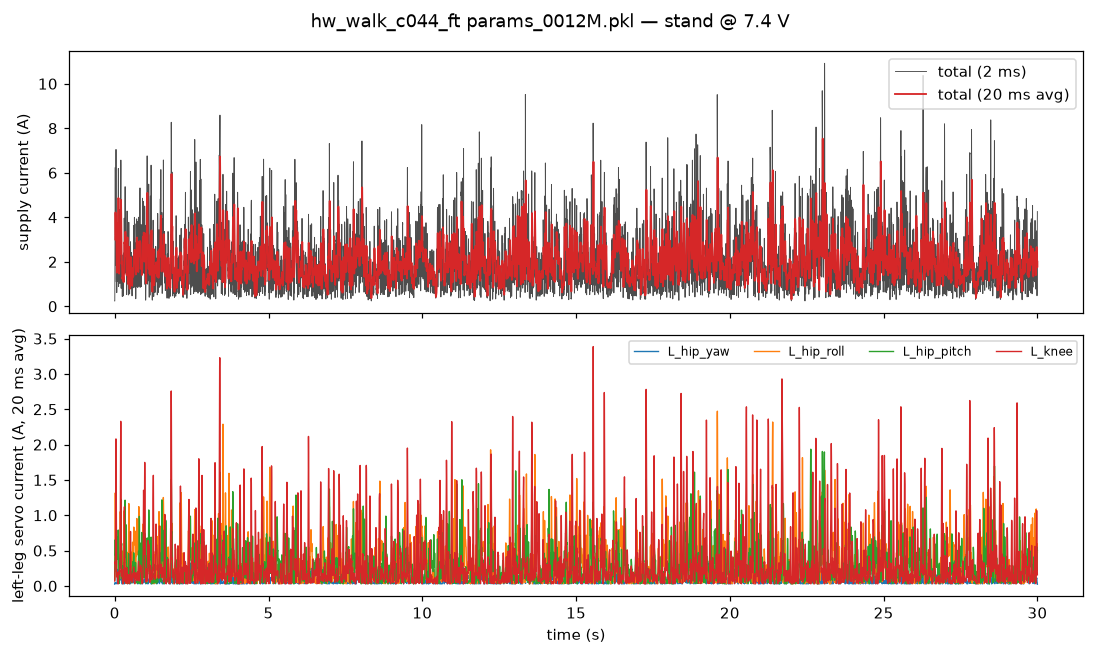
results/power/hw_walk_c044_ft__stand.png
