SeanEZhou/slender-biped/results/power/hw_walk_c044_ft__walk40.png

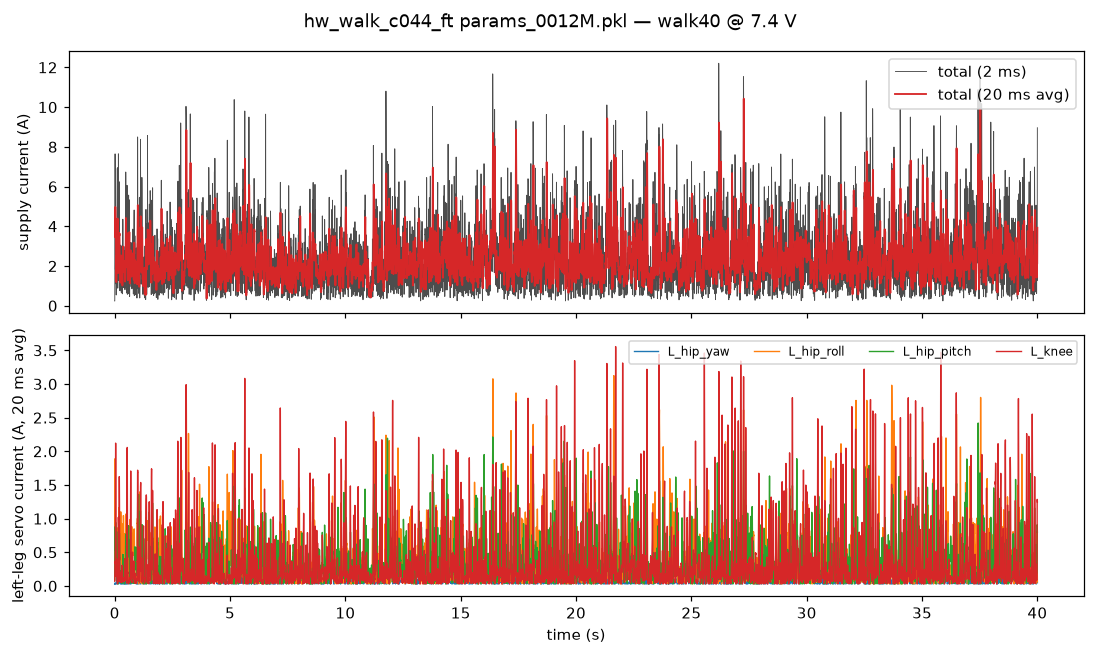
results/power/hw_walk_c044_ft__walk40.png
