SeanEZhou/slender-biped/results/power/hw_walk_c046_ft__stand.png

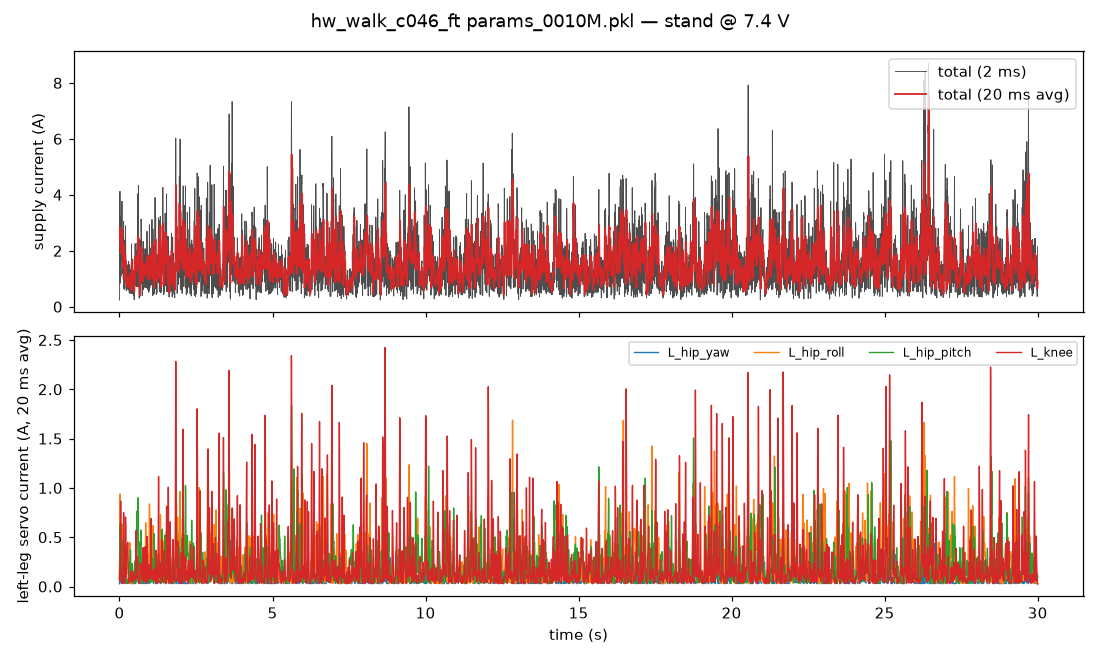
results/power/hw_walk_c046_ft__stand.png
