SeanEZhou/slender-biped/results/power/hw_walk_c046_ft__walk40.png

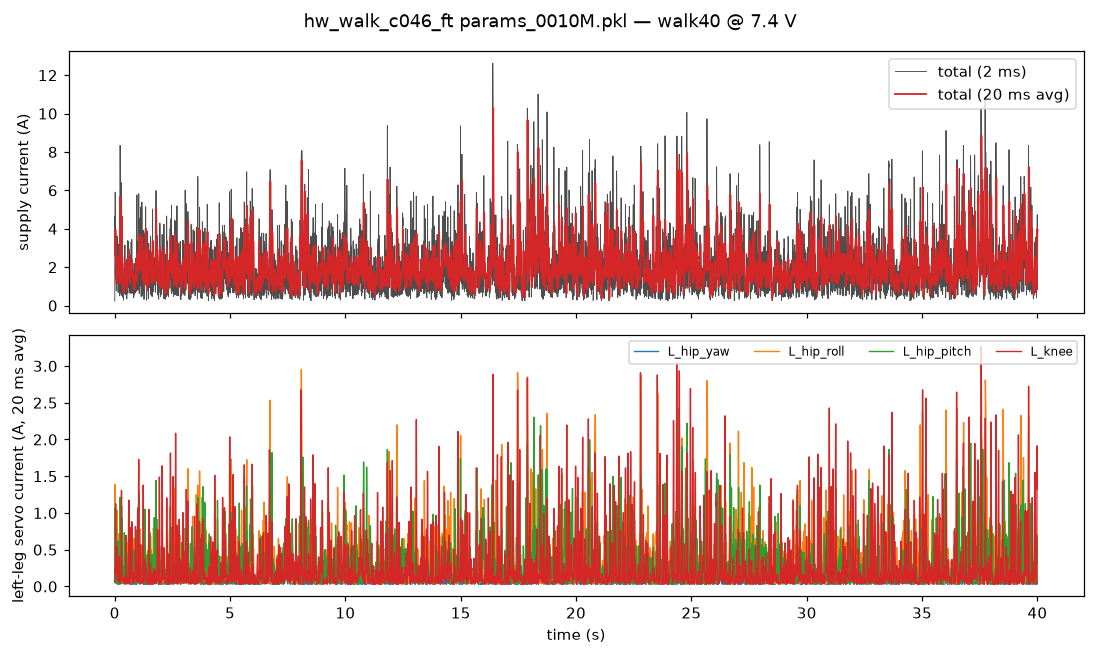
results/power/hw_walk_c046_ft__walk40.png
