SeanEZhou/slender-biped/results/power/hw_walk_c046s60_ft_s1__walk40.png

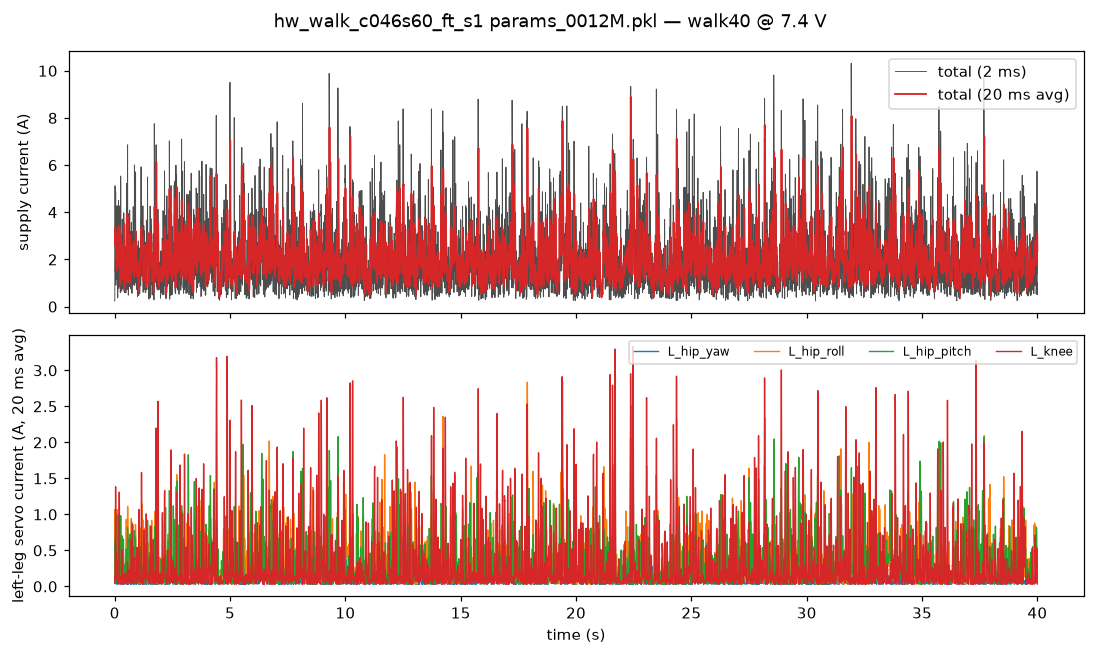
results/power/hw_walk_c046s60_ft_s1__walk40.png
