SeanEZhou/slender-biped/results/power/hw_walk_c046s60_ft_s2__stand.png

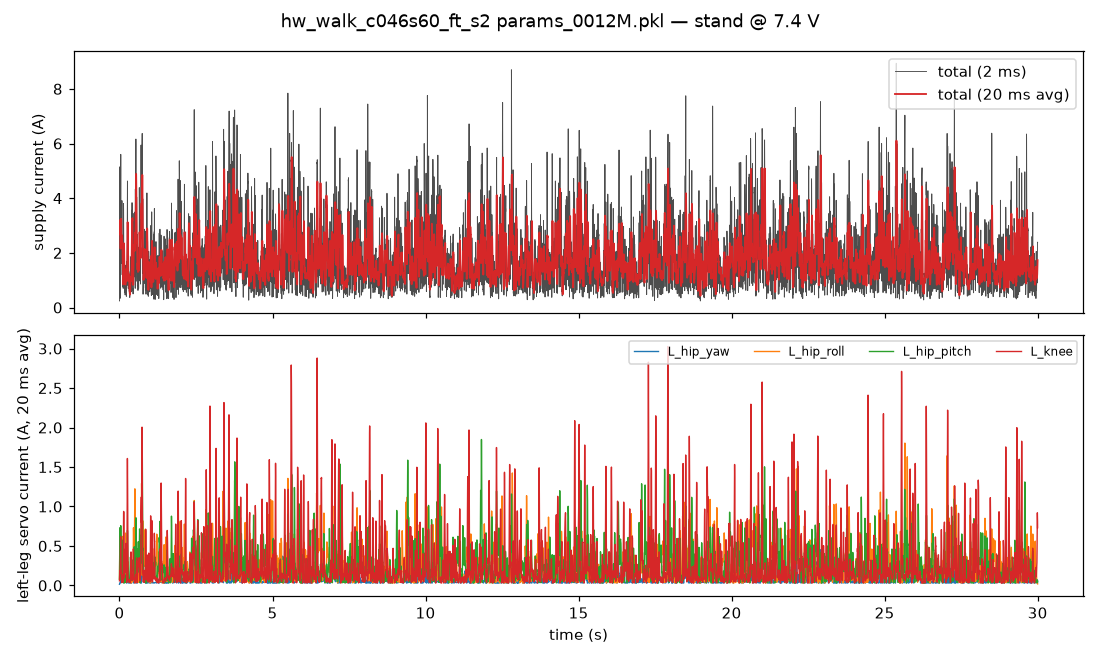
results/power/hw_walk_c046s60_ft_s2__stand.png
