SeanEZhou/slender-biped/results/power/hw_walk_c046s60_ft_s2__walk40.png

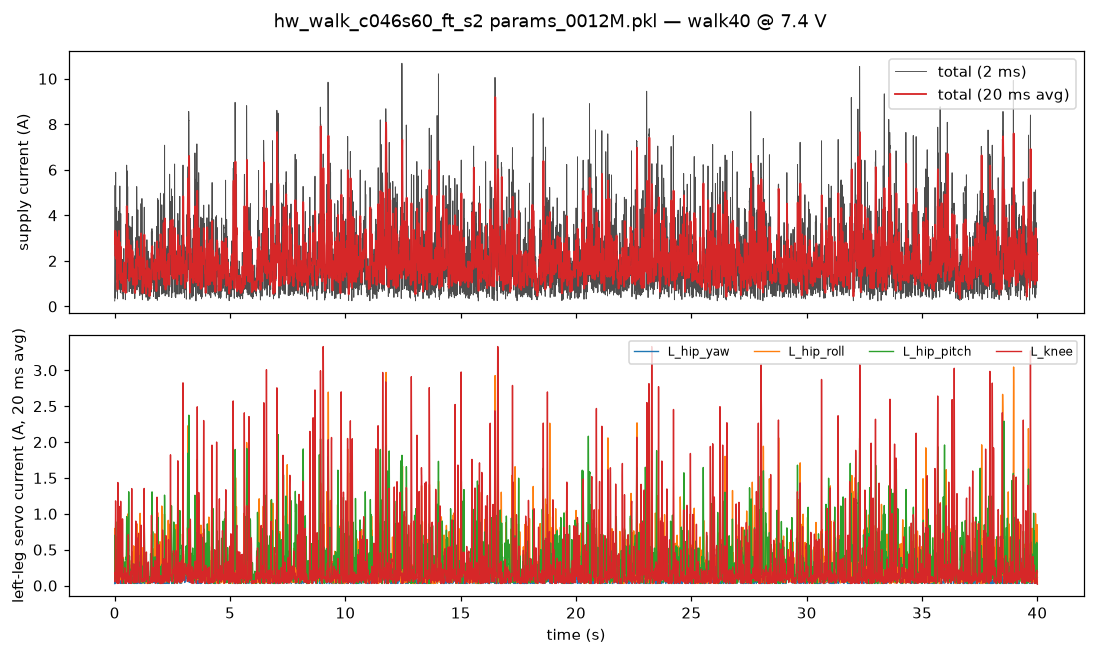
results/power/hw_walk_c046s60_ft_s2__walk40.png
