SeanEZhou/slender-biped/results/power/hw_walk_cad__stand.png

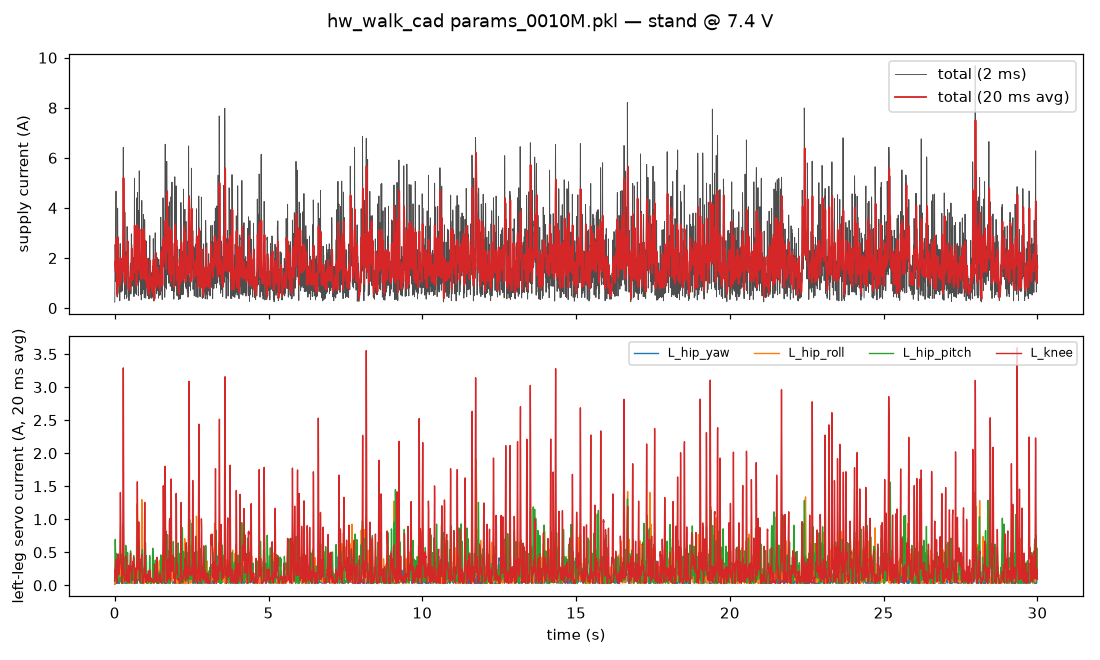
results/power/hw_walk_cad__stand.png
