SeanEZhou/slender-biped/results/power/hw_walk_cad__walk05.png

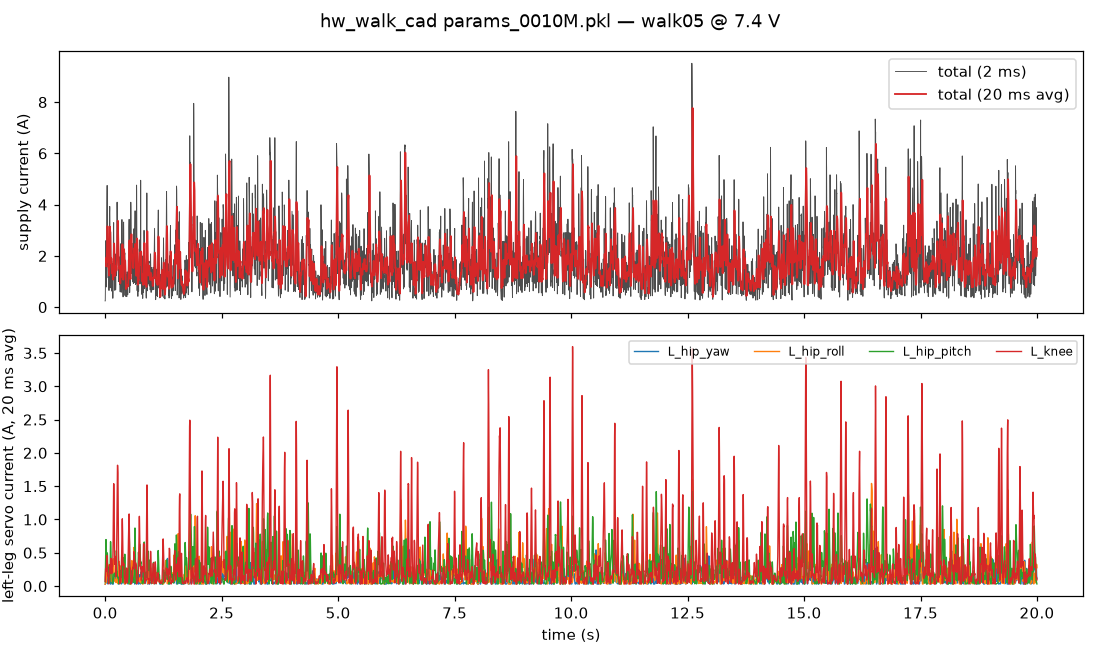
results/power/hw_walk_cad__walk05.png
