SeanEZhou/slender-biped/results/power/hw_walk_cad__walk10.png

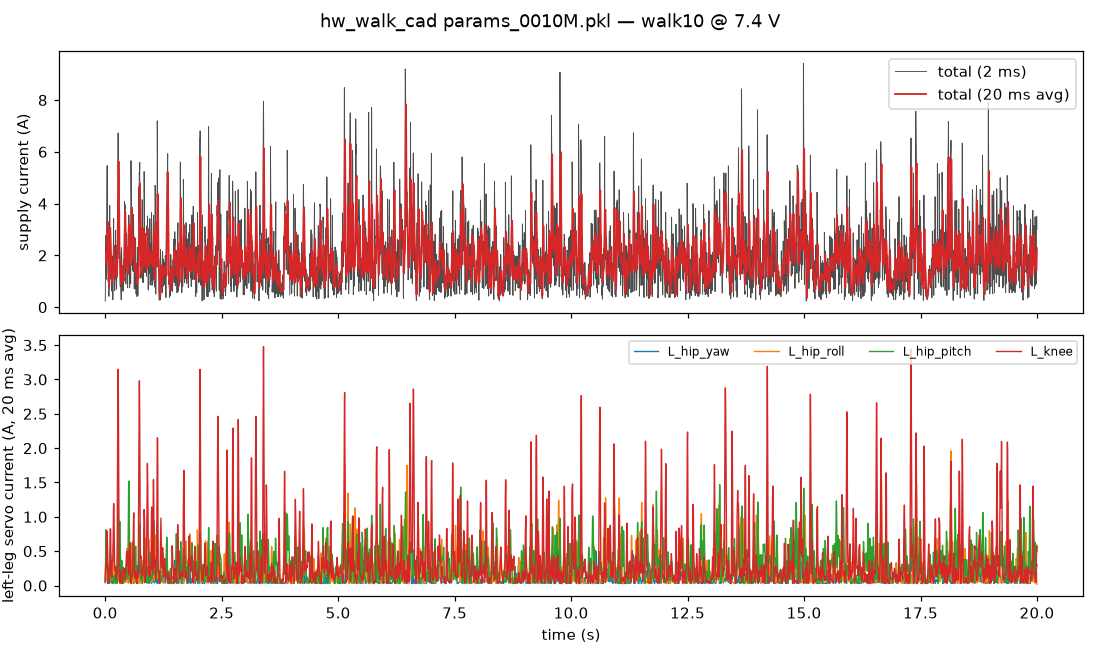
results/power/hw_walk_cad__walk10.png
