SeanEZhou/slender-biped/results/power/hw_walk_cad__walk20.png

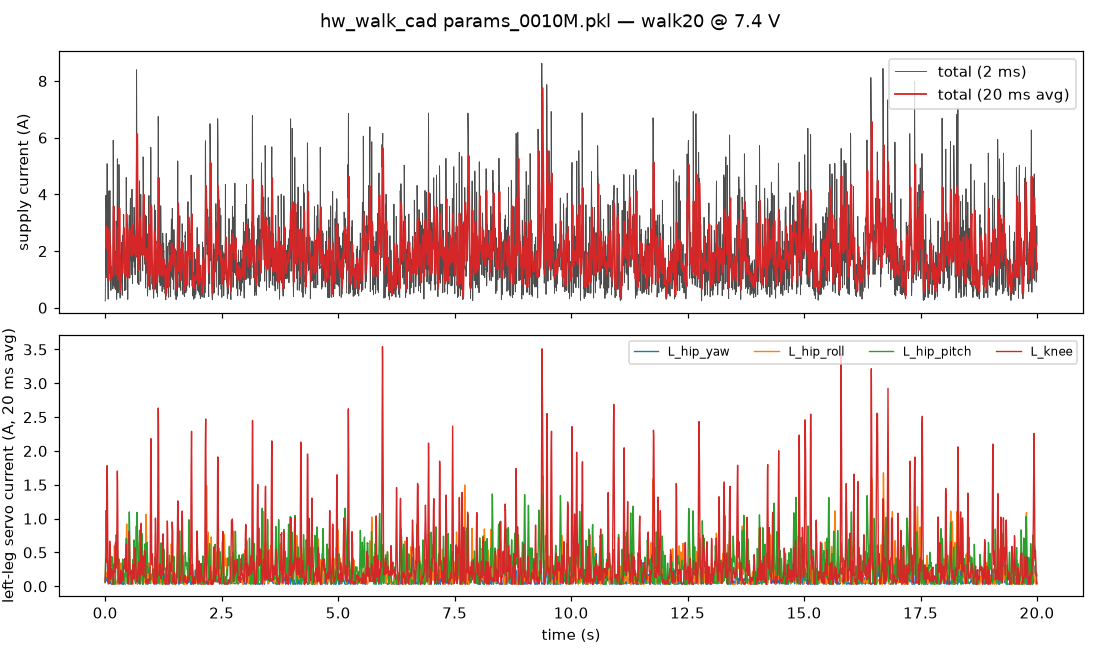
results/power/hw_walk_cad__walk20.png
