SeanEZhou/slender-biped/results/power/hw_walk_cad__walk40.png

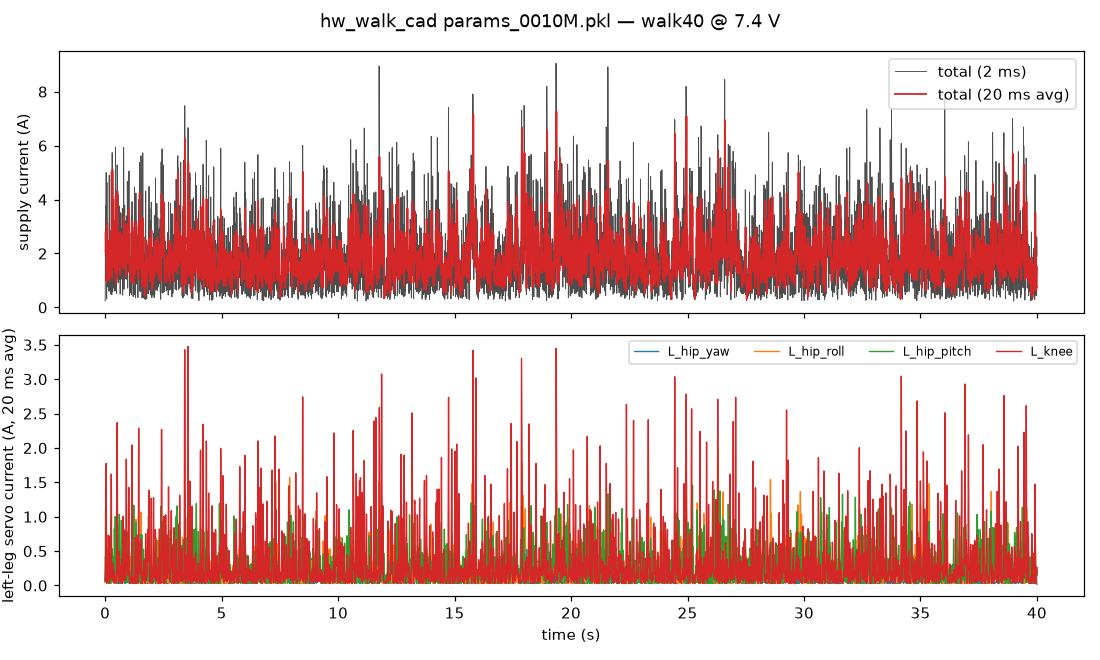
results/power/hw_walk_cad__walk40.png
