SeanEZhou/slender-biped/results/power/hw_walk_pad40_ft__stand.png

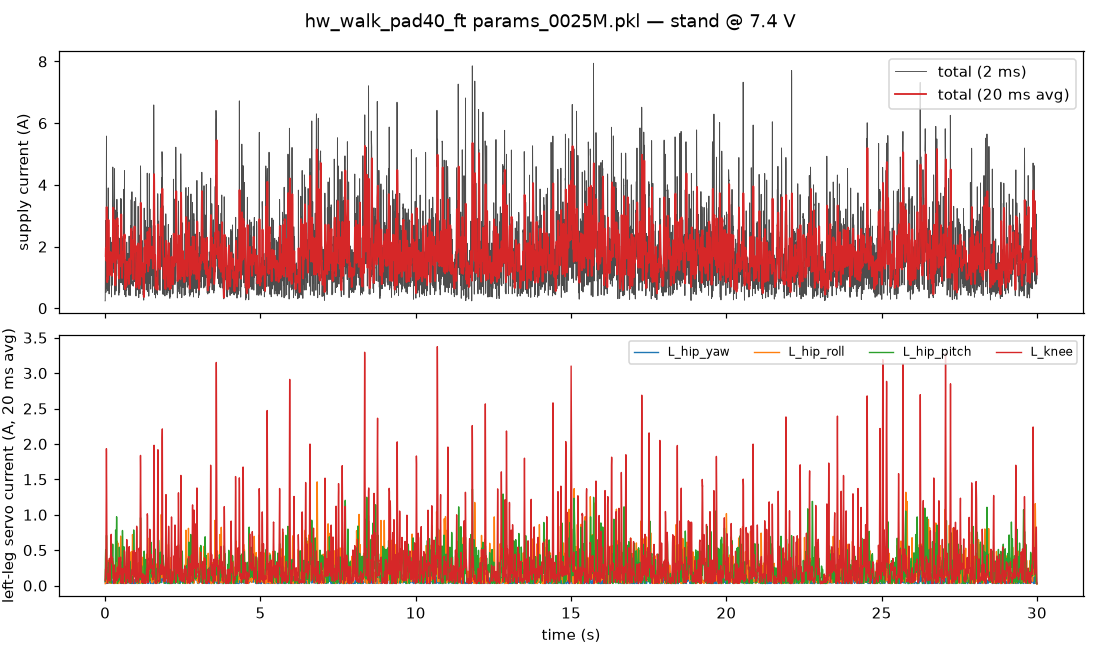
results/power/hw_walk_pad40_ft__stand.png
