SeanEZhou/slender-biped/results/power/hw_walk_pad40_ft__walk40.png

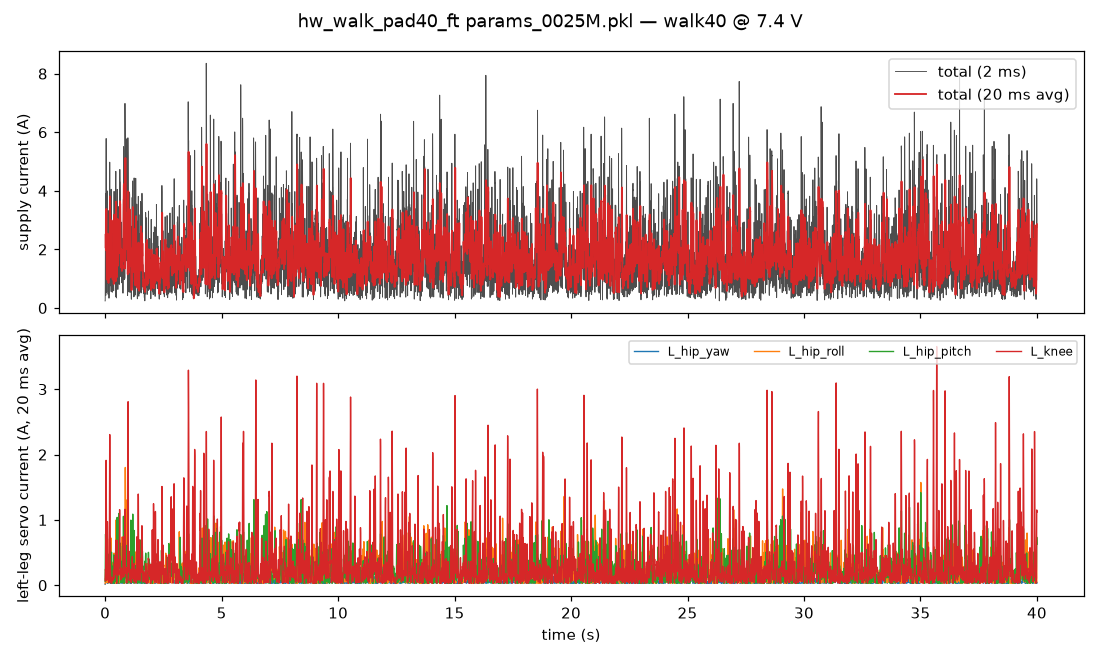
results/power/hw_walk_pad40_ft__walk40.png
