SeanEZhou/slender-biped/results/power/hw_walk_s60_ft__stand.png

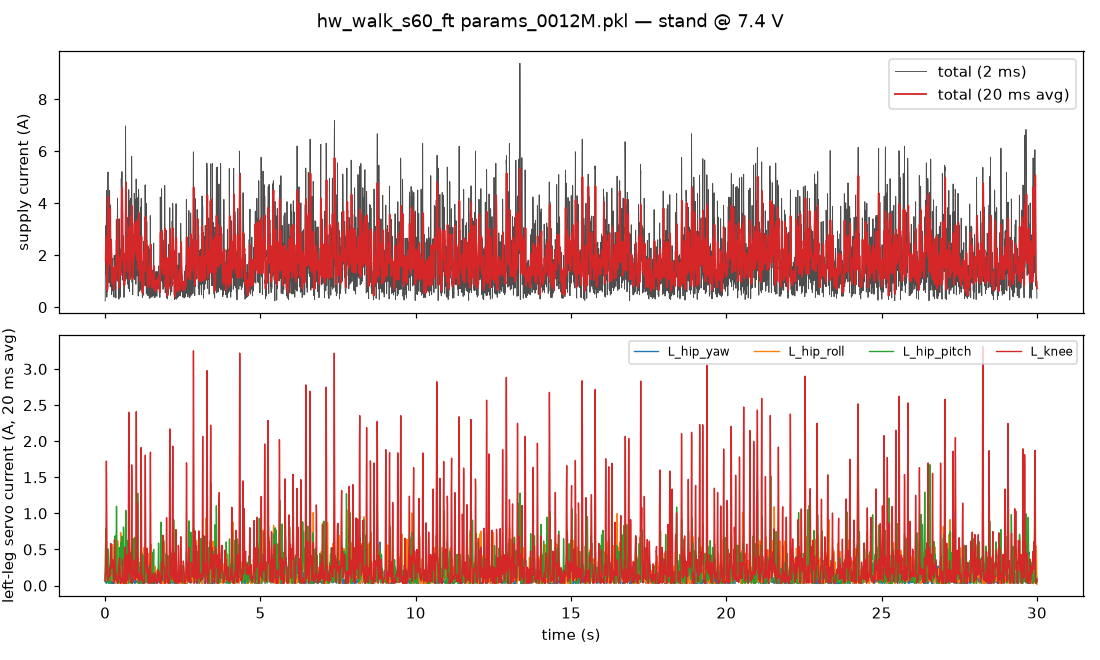
results/power/hw_walk_s60_ft__stand.png
