SeanEZhou/slender-biped/results/power/hw_walk_s60_ft__walk40.png

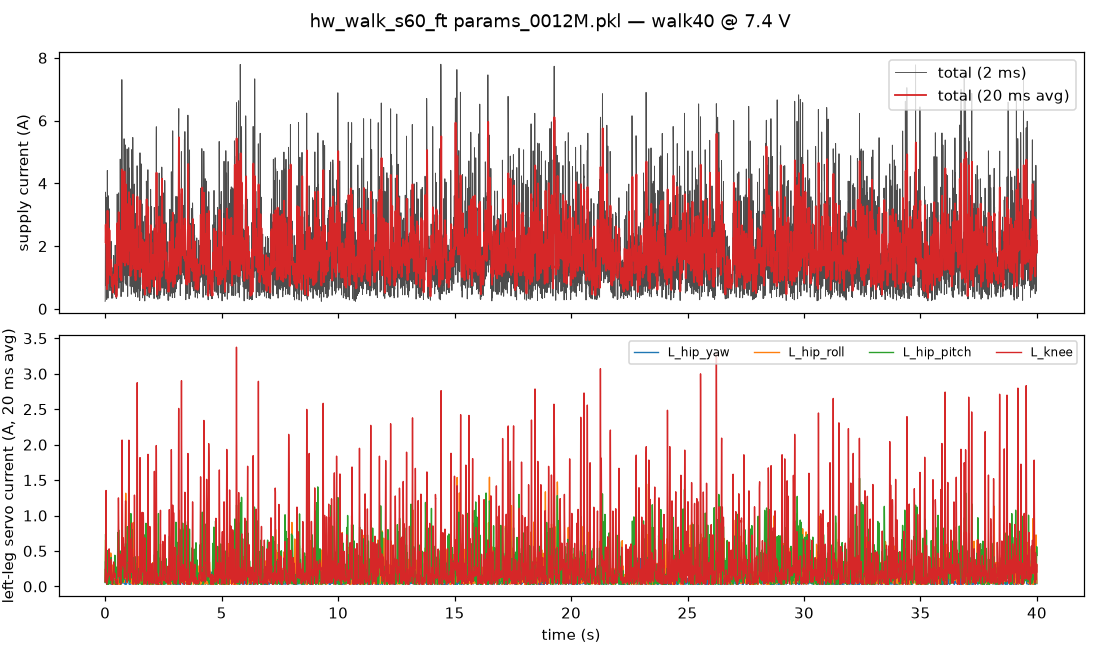
results/power/hw_walk_s60_ft__walk40.png
