SeanEZhou/slender-biped/results/power/hw_walk_s70_ft__stand.png

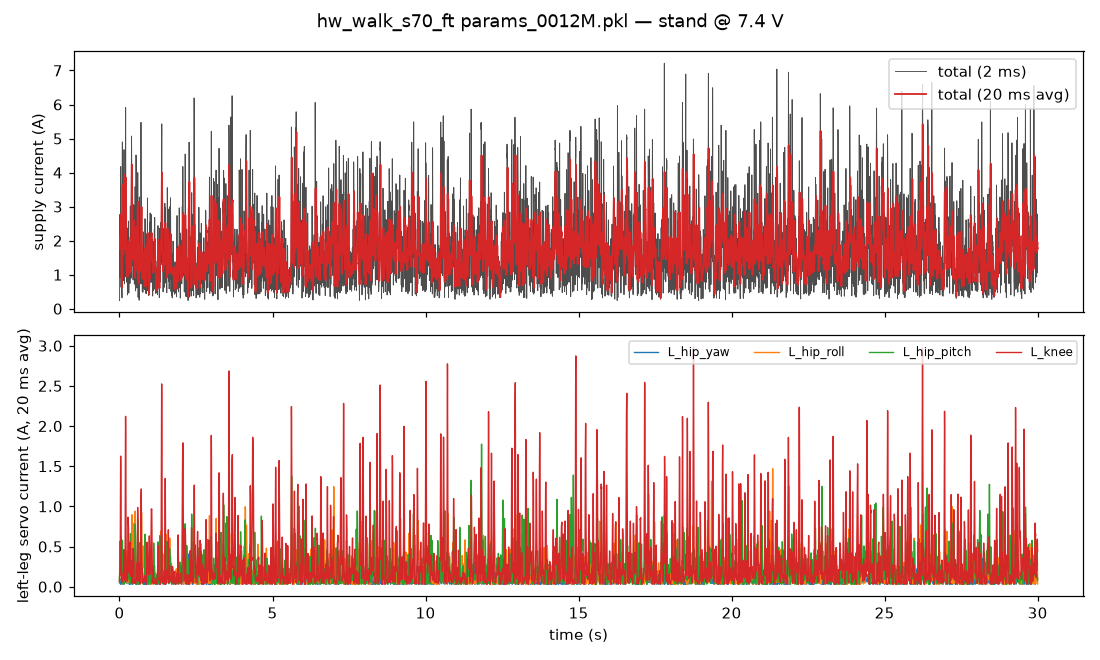
results/power/hw_walk_s70_ft__stand.png
