SeanEZhou/slender-biped/results/power/hw_walk_s70_ft__walk40.png

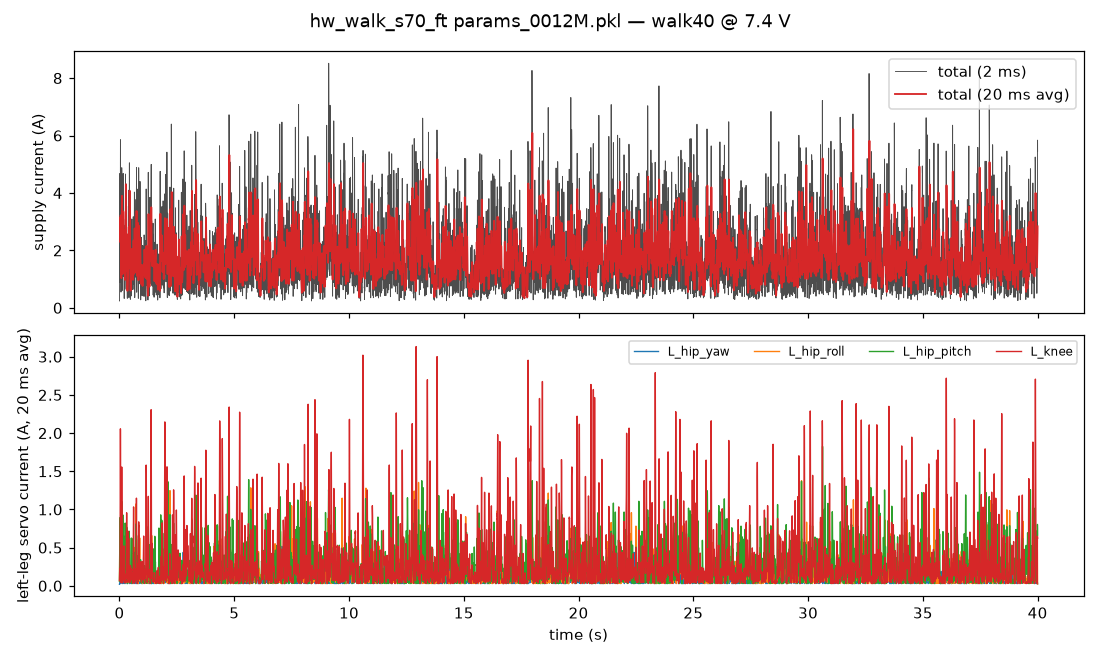
results/power/hw_walk_s70_ft__walk40.png
