SeanEZhou/slender-biped/results/power/hw_walk_scratch__stand.png

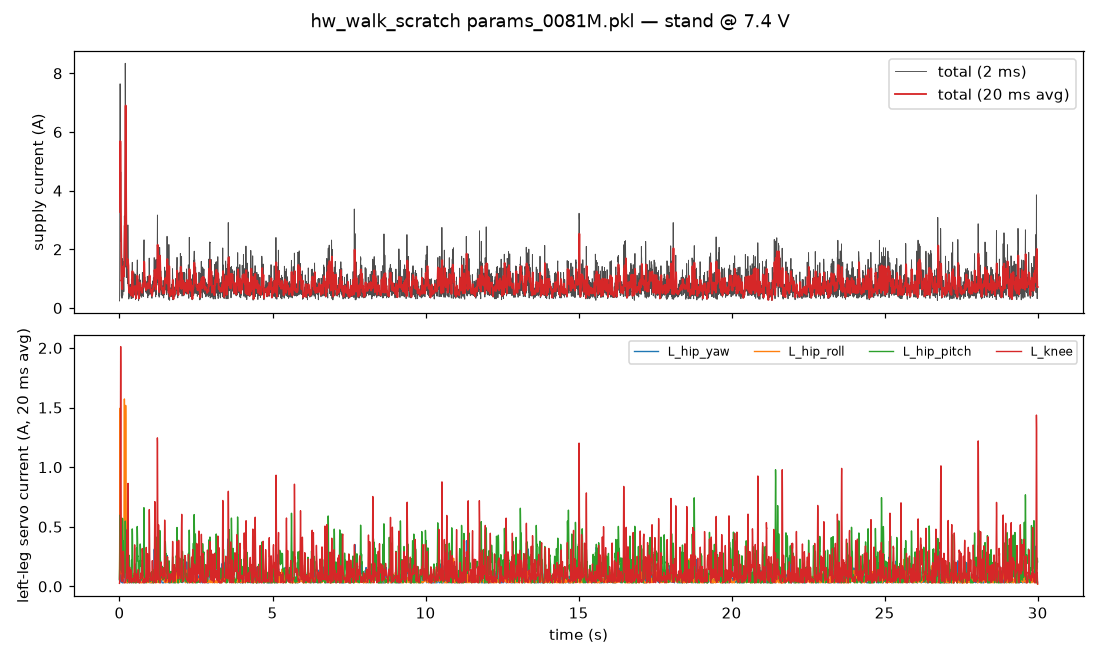
results/power/hw_walk_scratch__stand.png
