SeanEZhou/slender-biped/results/power/hw_walk_scratch__walk40.png

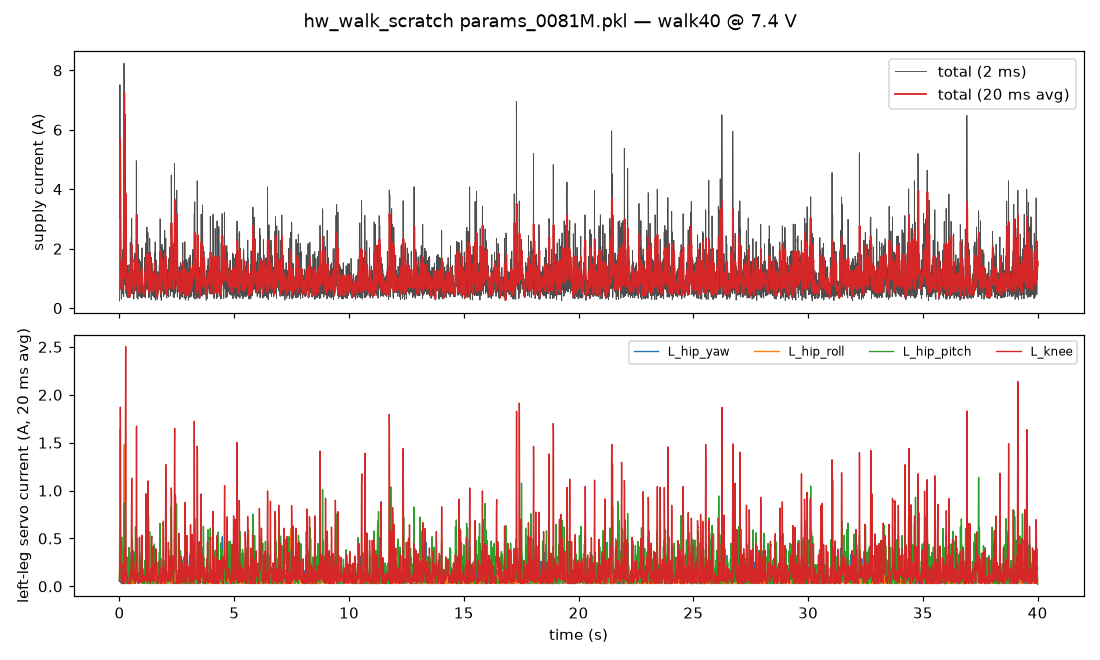
results/power/hw_walk_scratch__walk40.png
