SeanEZhou/slender-biped/results/power/hw_walk_scratch_s1__stand.png

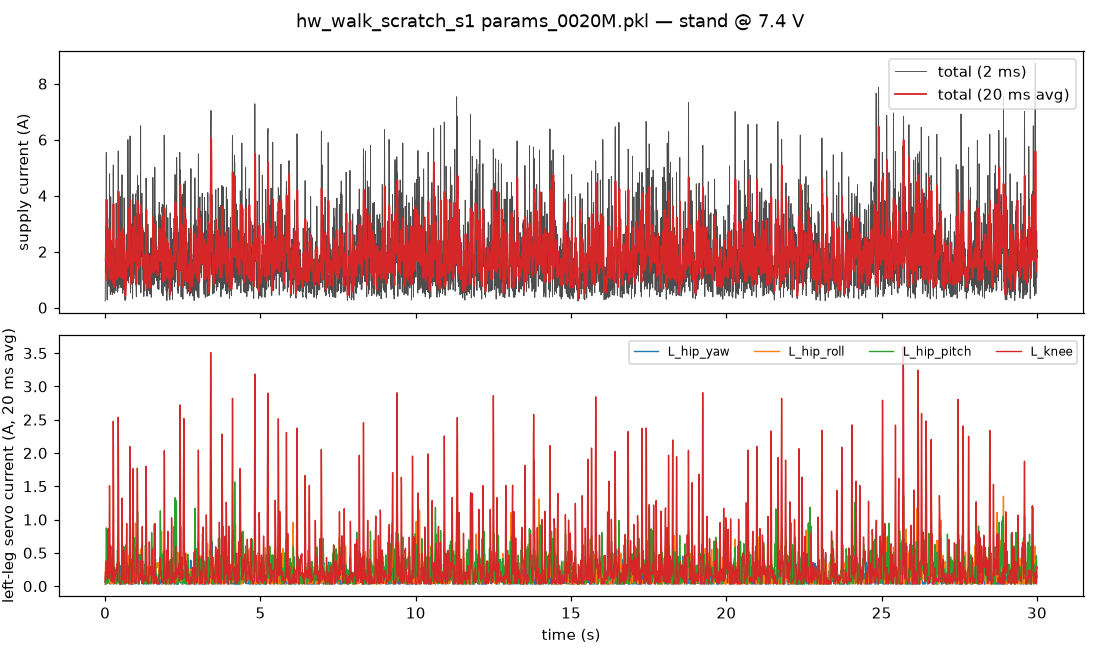
results/power/hw_walk_scratch_s1__stand.png
