SeanEZhou/slender-biped/results/power/hw_walk_scratch_stride2__stand.png

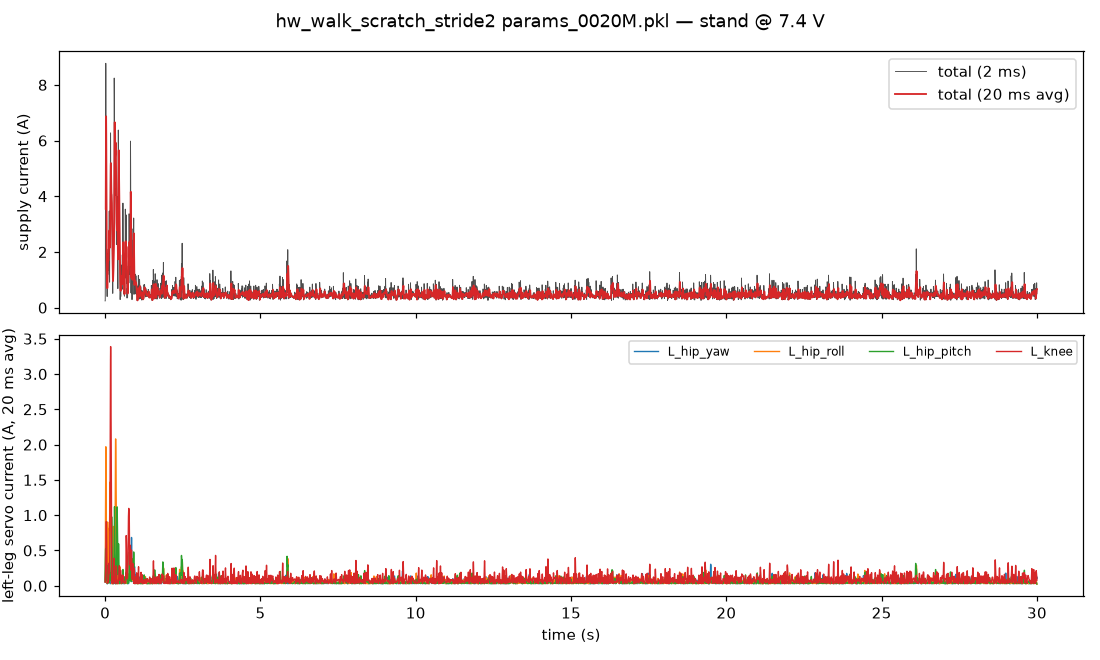
results/power/hw_walk_scratch_stride2__stand.png
