SeanEZhou/slender-biped/results/power/hw_walk_scratch_stride2__walk40.png

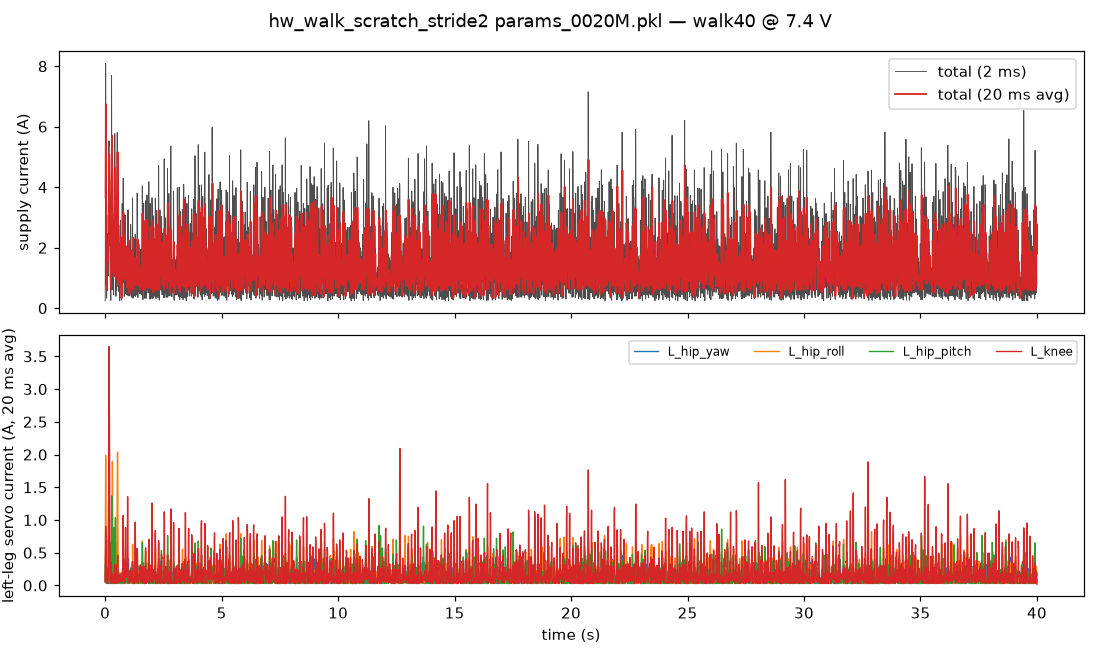
results/power/hw_walk_scratch_stride2__walk40.png
