SeanEZhou/slender-biped/results/power/hw_walk_scratch_stride__stand.png

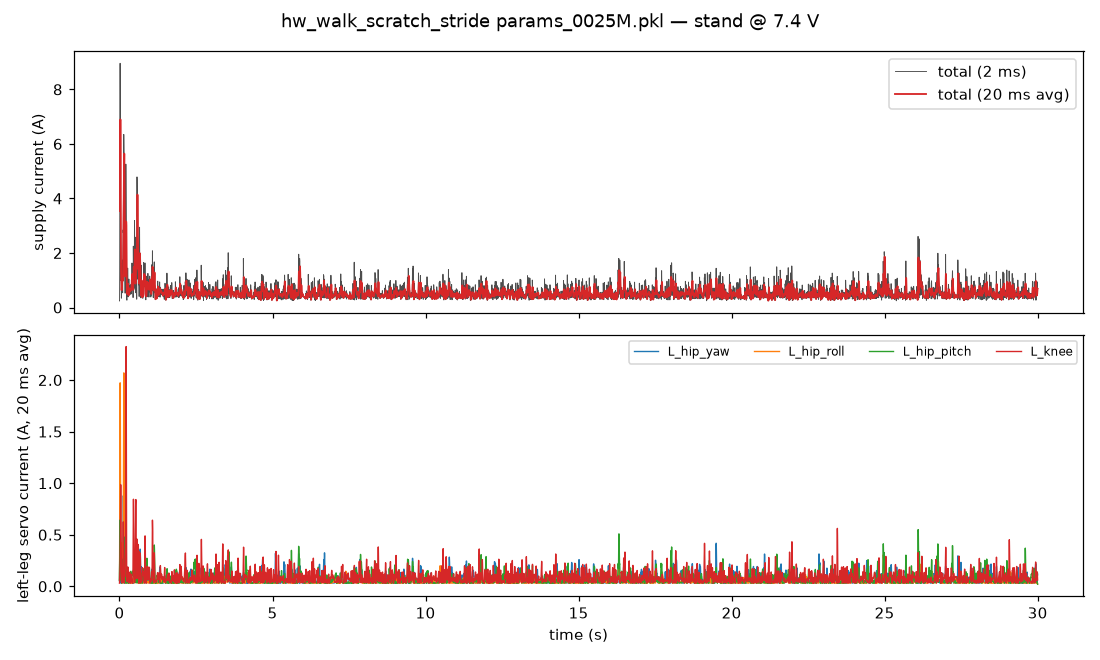
results/power/hw_walk_scratch_stride__stand.png
