SeanEZhou/slender-biped/results/power/hw_walk_scratch_stride__walk10.png

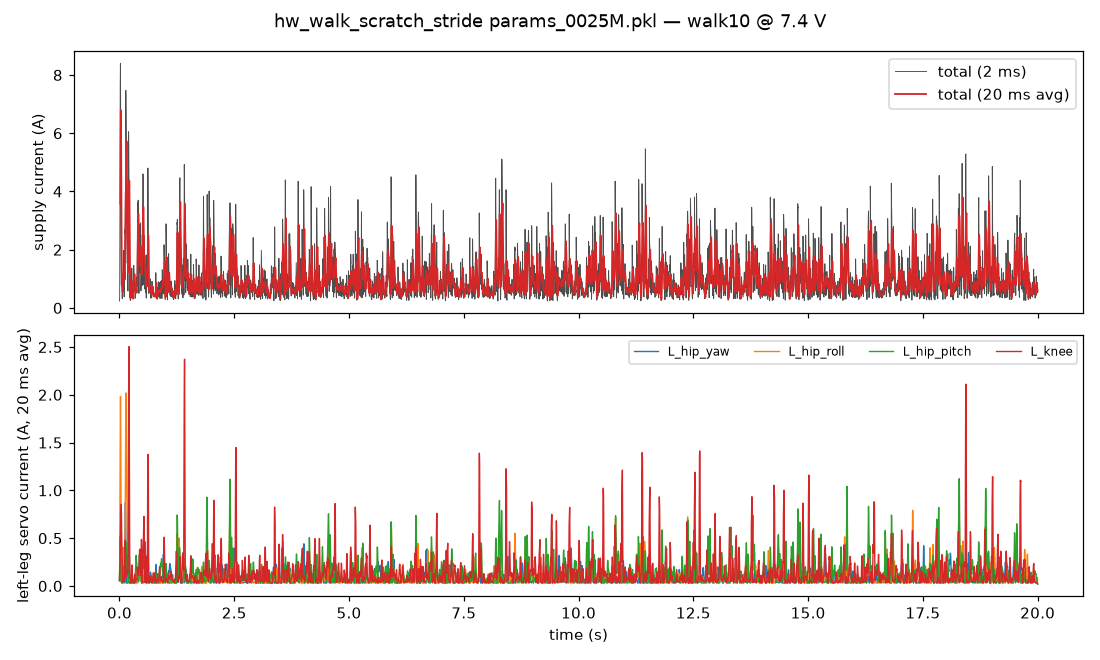
results/power/hw_walk_scratch_stride__walk10.png
