SeanEZhou/slender-biped/results/power/hw_walk_scratch_stride__walk20.png

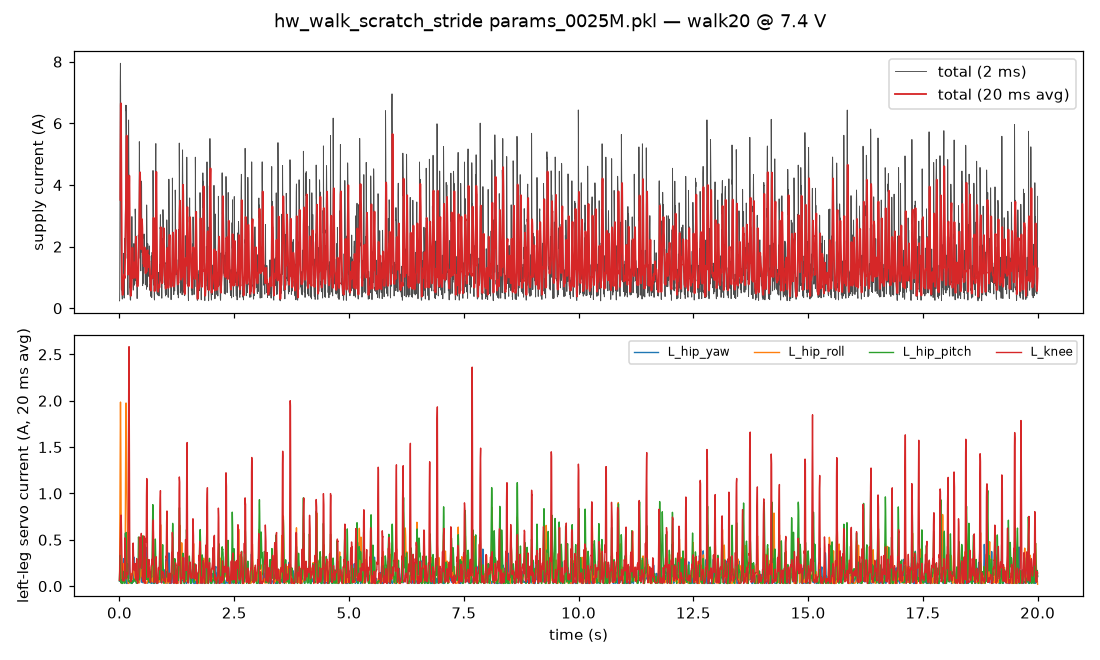
results/power/hw_walk_scratch_stride__walk20.png
