SeanEZhou/slender-biped/results/power/hw_walk_v84_ft_s1__stand.png

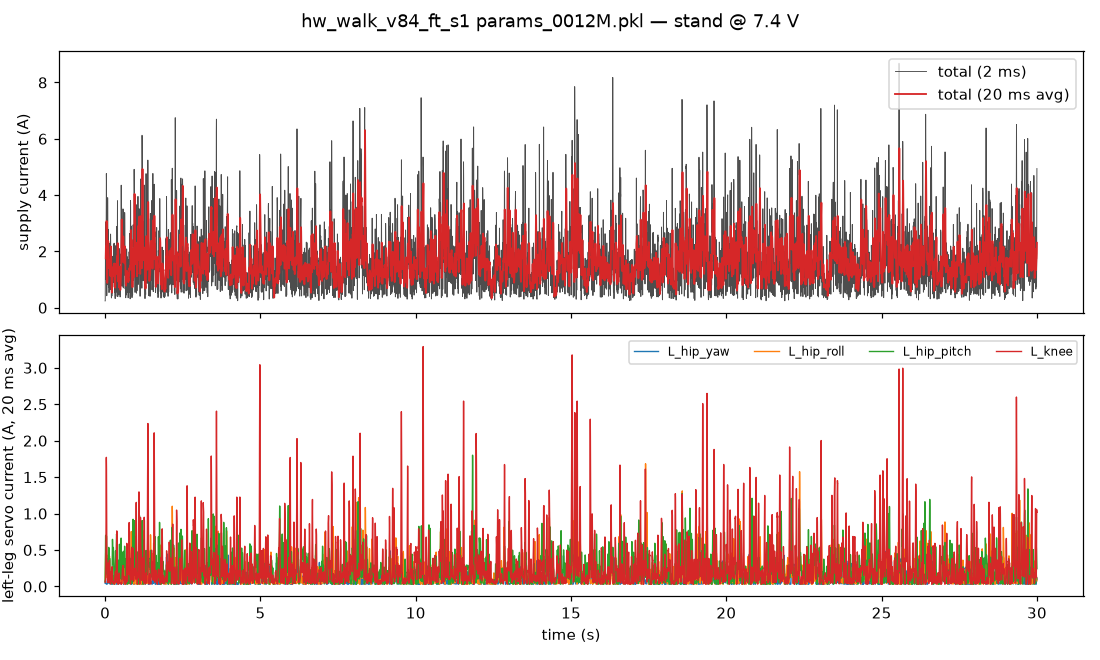
results/power/hw_walk_v84_ft_s1__stand.png
