SeanEZhou/slender-biped/results/power/r4j_d65_c4_cont__walk40.png

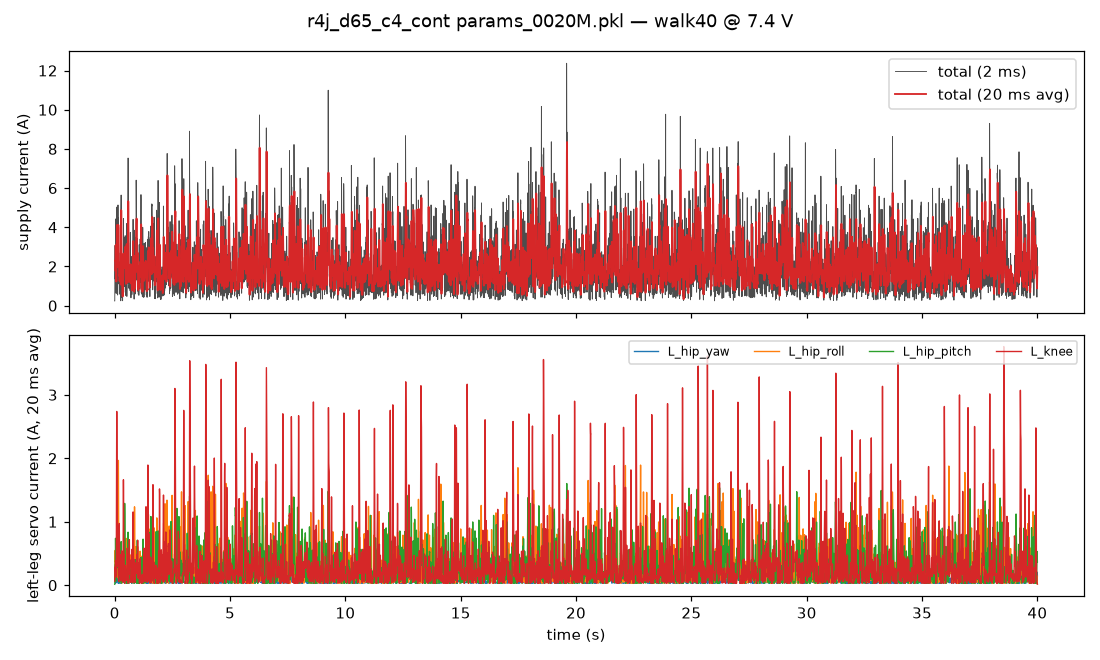
results/power/r4j_d65_c4_cont__walk40.png
