SeanEZhou/slender-biped/results/power/r4k_cat2_ft__walk40.png

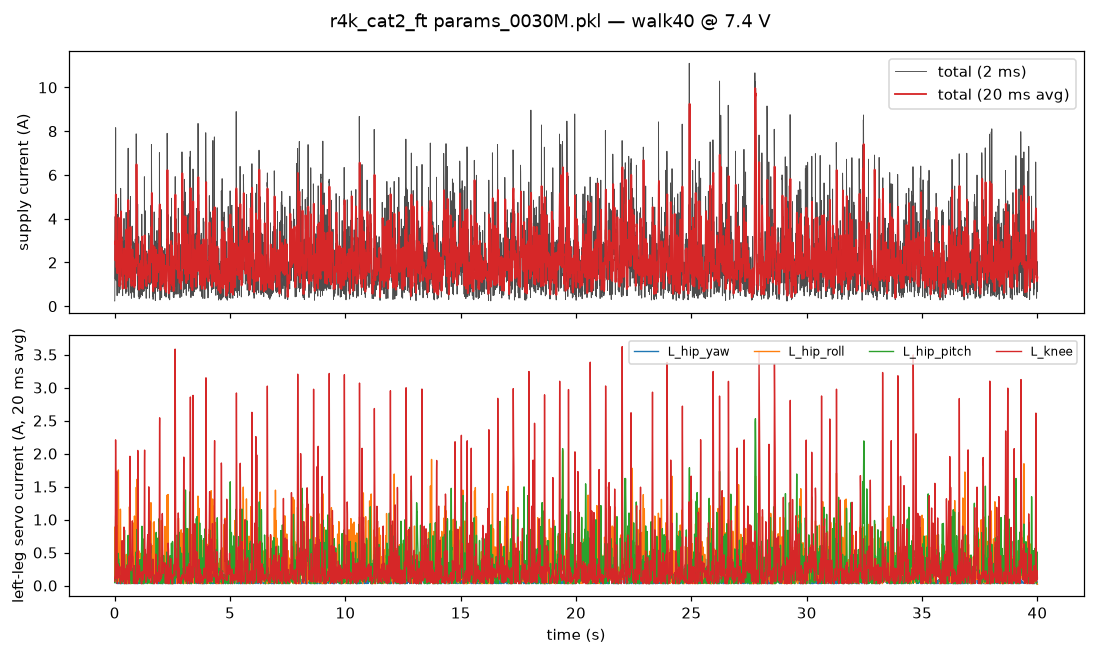
results/power/r4k_cat2_ft__walk40.png
