SeanEZhou/slender-biped/results/power/r4l_polish__walk40.png

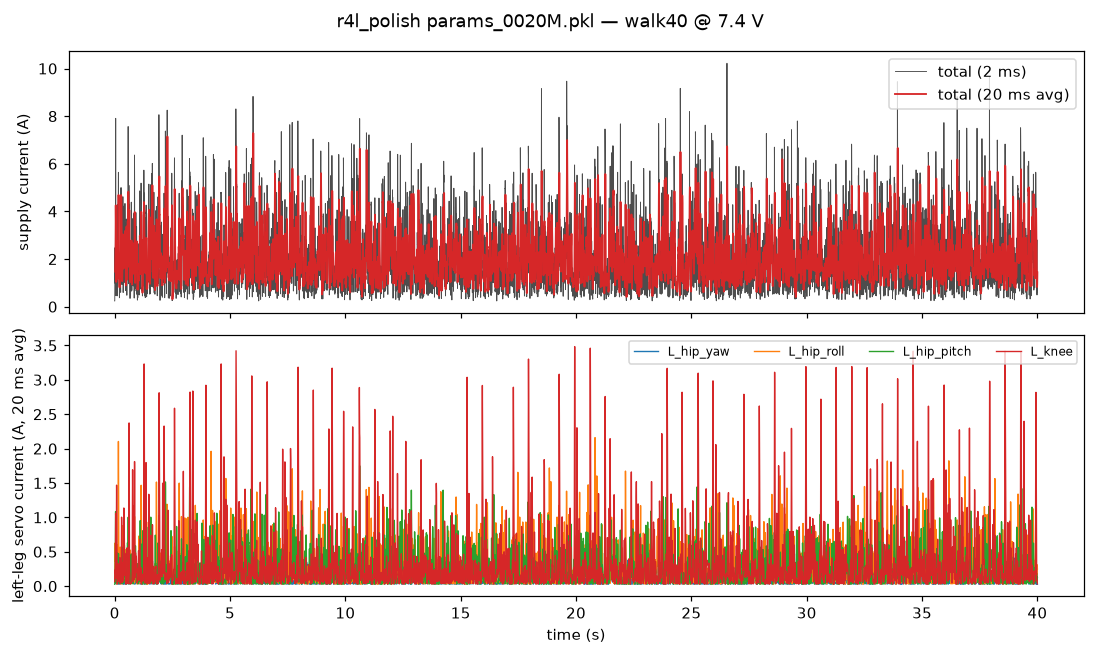
results/power/r4l_polish__walk40.png
