SeanEZhou/slender-biped/results/power/r4n_s60_d65__walk40.png

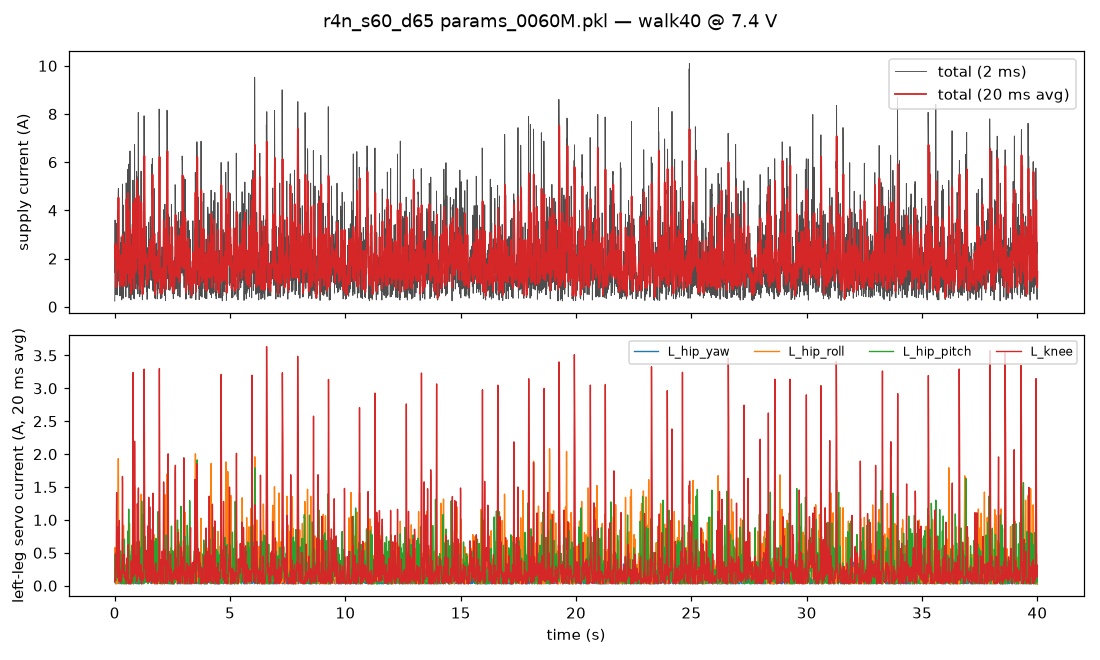
results/power/r4n_s60_d65__walk40.png
