SeanEZhou/slender-biped/results/power/r5p_flow__walk40.png

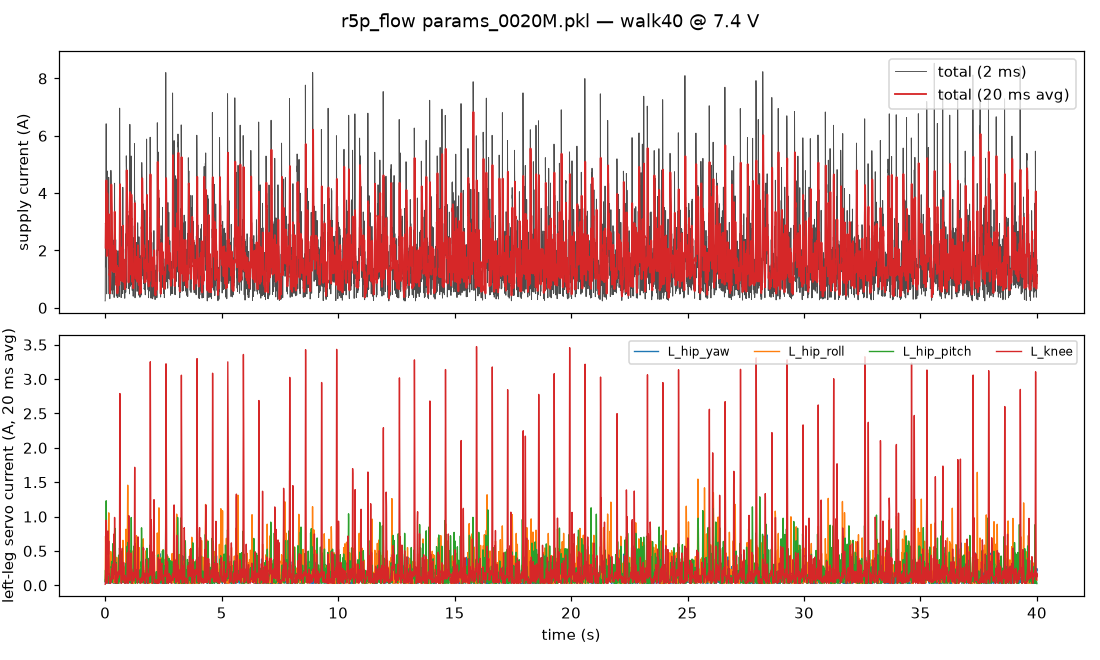
results/power/r5p_flow__walk40.png
