SeanEZhou/slender-biped/results/power/r5q_legs_path__walk40.png

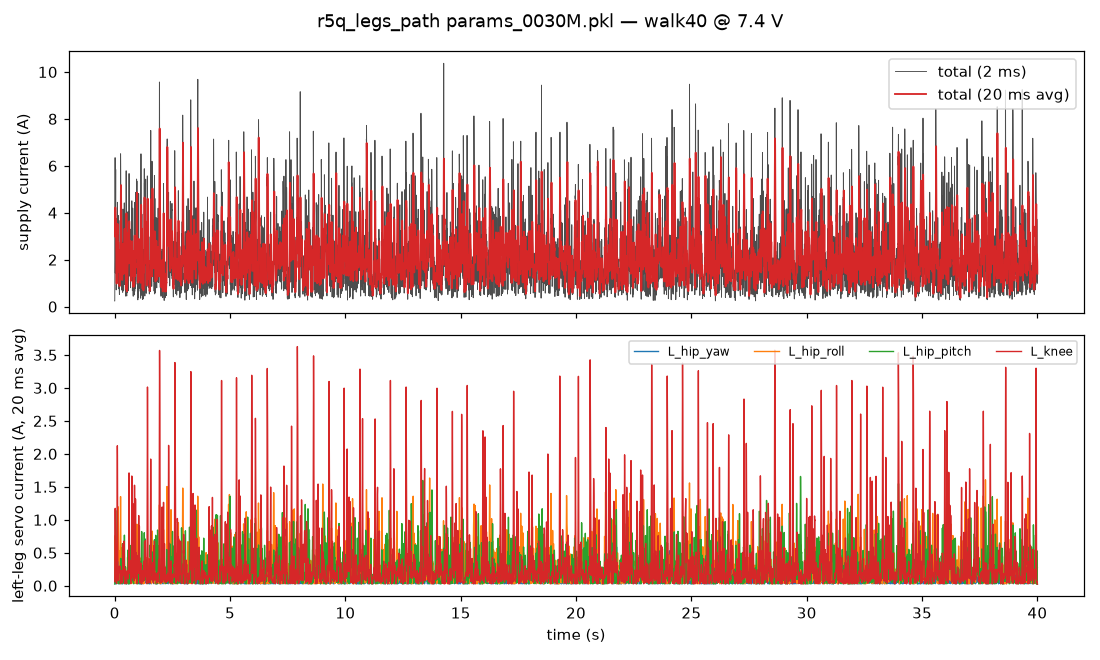
results/power/r5q_legs_path__walk40.png
