SeanEZhou/slender-biped/results/power/stride_P30_ft__walk40.png

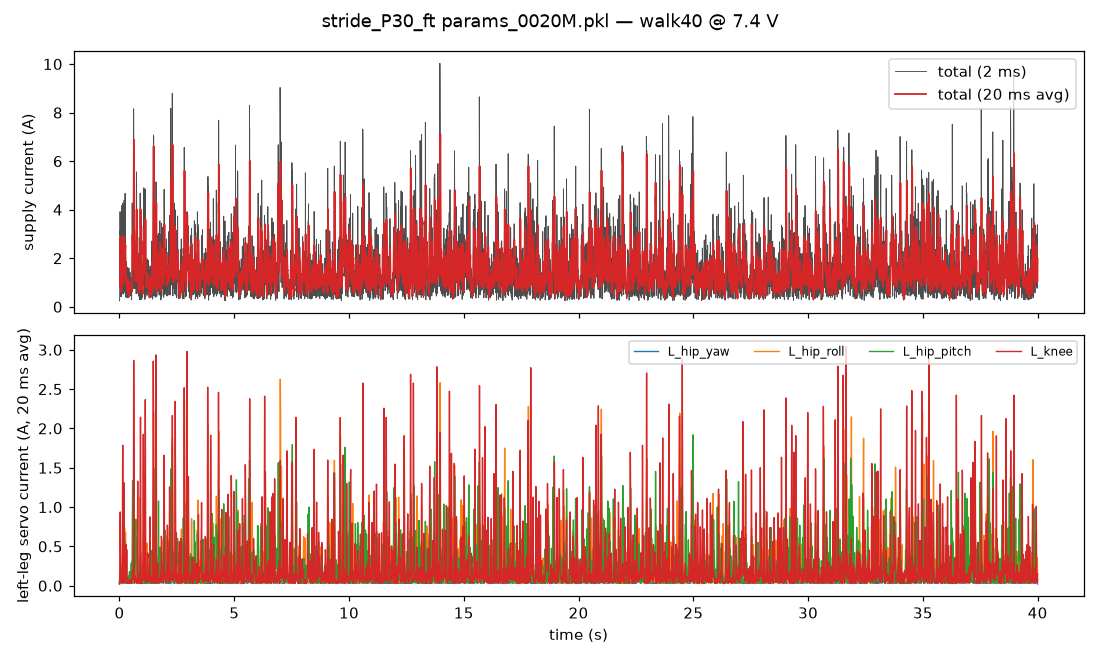
results/power/stride_P30_ft__walk40.png
