SeanEZhou/slender-biped/results/servo_fit.png

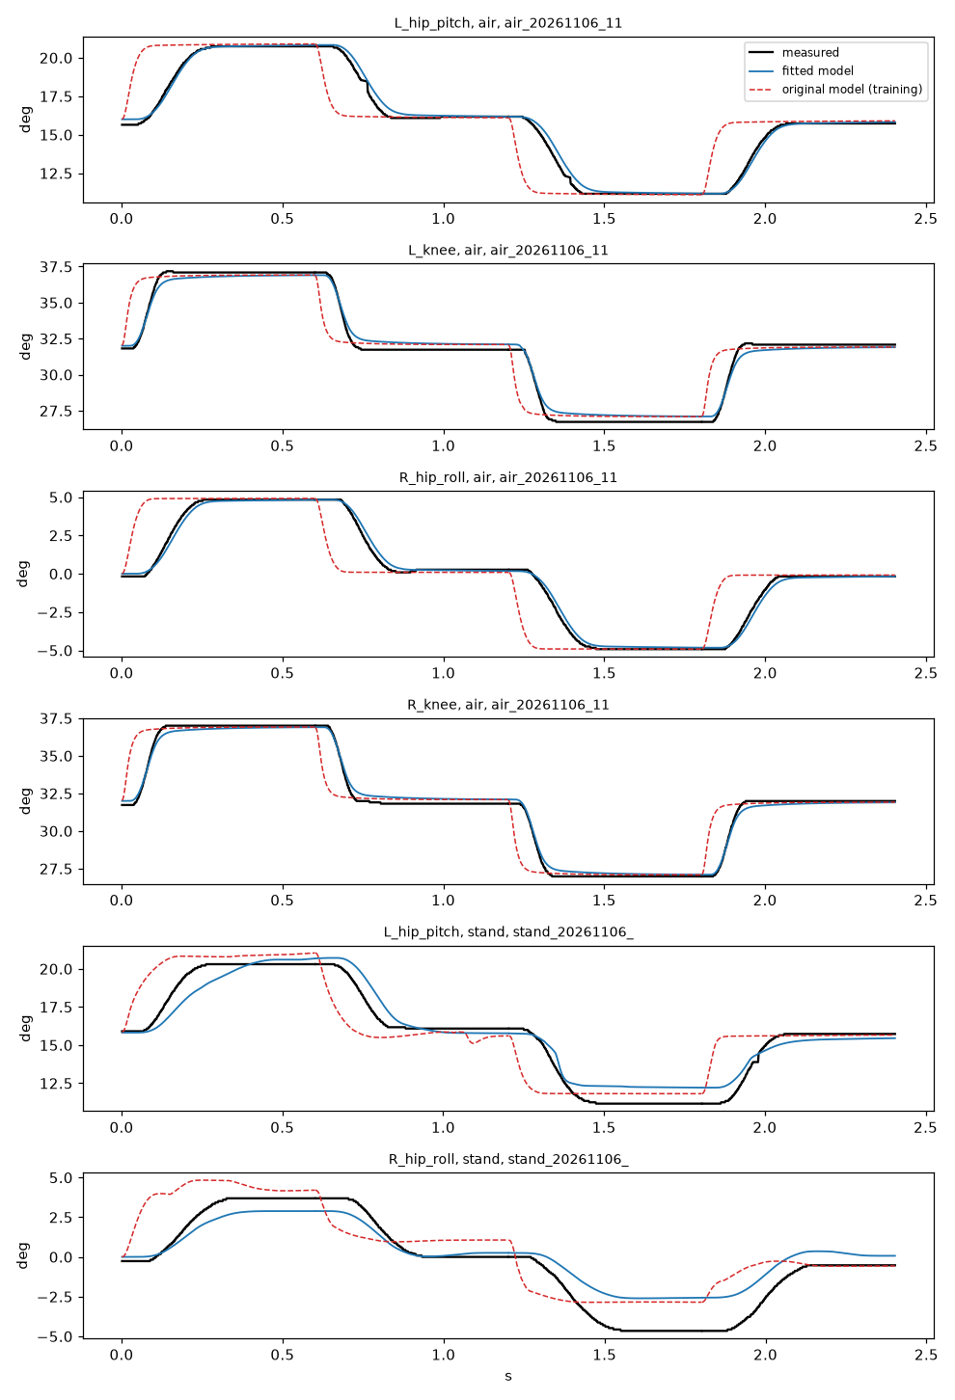
results/servo_fit.png
