SeanEZhou/slender-biped/hardware/leg_p0/params.yaml

# P0 single-leg CAD parameters (mm, deg). Regenerate everything with:
#   .venv-cad/bin/python hardware/leg_p0/cad/build.py
# Values marked MEASURE are taken from vendor CAD/datasheet and must be checked with calipers on the
# real servos (see verification.md, "caliper checklist"); edit them here and rebuild.

side: left                     # this leg is the LEFT leg (+Y side). Mirrored right-leg STLs are exported too.

# --- Feetech STS3215-C001 (1:345). Source: Feetech datasheet (Seeed, 2023-06-23) and the
#     SO-ARM100 STS3215_03a STEP model (Apache-2.0). Servo frame: origin = case centre,
#     X = length (output end at +X), Z = output axis (main horn at +Z, idler horn at -Z).
servo:
  case_len: 45.4               # MEASURE (datasheet 45.23)
  case_wid: 24.8               # MEASURE (datasheet 24.73)
  case_face_z: 15.9            # MEASURE: case faces at +-15.9 (31.8 thick between mounting faces)
  output_x: 12.5               # MEASURE: output axis from case centre (10.2 mm from the output end)
  # raised areas on the two big faces (STEP height map, 0.1 mm grid). They are NOT symmetric: the horn-face
  # bump is long and narrow, the idler-face bump short and wide. v1 had the widths swapped-ish (8.5 / 7.0), so the
  # idler bump jammed in its recess. idler z 17.9: the SO-101 assembly's servo model is 0.2 mm prouder than the STEP.
  horn_bump: {x0: -22.0, x1: 2.0, half_w: 7.0, z: 17.0}      # horn (driven) face
  idler_bump: {x0: -17.3, x1: -7.4, half_w: 9.1, z: 17.9}    # idler (passive) face
  horn_d: 20.0                 # MEASURE: horn disc diameter (both horns)
  horn_face_z: 18.7            # MEASURE: main-horn outer face height above case centre
  idler_face_z: 17.7           # MEASURE: idler-horn outer face height (below case centre)
  horn_hole_offset: 4.95       # 4 horn holes at (+-4.95, +-4.95) around the axis (14 mm circle)
  horn_hole_d: 2.5             # horn holes take M3x6 screws (SO-101 assembly guide), both horns
  horn_center_screw_head_d: 6.0  # M3x6 horn screw head; arms get an access hole
  mount_holes_top: [[4.2, 10.25], [4.2, -10.25], [-16.5, 10.25], [-16.5, -10.25]]   # MEASURE: horn face
  mount_holes_bot: [[4.2, 10.25], [4.2, -10.25], [-20.3, 10.25], [-20.3, -10.25]]   # MEASURE: idler face
  mount_hole_pilot_d: 1.5      # pilot holes in the case for self-tapping screws (datasheet: PA2.0)
  connector_x: -1.55           # 5264 connectors on the idler face
  connector_keepout: {x0: -4.5, x1: 1.5, half_w: 9.5, depth: 12.0}   # plug + cable bend allowance
  mass_g: 55
  # printed replacement horns (cad/horns.py). Baseline = Feetech STS3215 spec sheet, section 10 Accessories (p. 7):
  # both horns 19.95 OD, 4-M3 on a 14 mm circle, 9 mm hub. Driven: 4.5 total, 2.5 plate, 25T spline (5.9 OD,
  # copper-gear shaft) 3.6 deep, 3.2 centre hole. Passive: 3.1 total, 2.1 plate, 6.05 bore.
  # Tooth height / flank shape are not on the drawing (ESTIMATE). Printer-side choices are the *_variants lists.
  # Tested on a Bambu A1, PLA, 0.4 nozzle: passive 6.25 fits and turns freely (in use); the driven spline teeth
  # don't print and the 5.7/5.8 round bores were too tight, so driven horns were bought instead (README 5.3).
  horn_print:
    outer_d: 19.95
    bolt_circle_d: 14.0
    mount_hole_d: 2.8          # M3 machine screw threads itself into PLA (2.5 printed too tight); drawing: tapped M3 in 6061
    hub_d: 9.0
    driven: {total_t: 4.5, plate_t: 2.5, spline_depth: 3.6, center_d: 3.2}
    passive: {total_t: 3.1, plate_t: 2.1, bore_d: 6.05}
    spline_teeth: 25
    spline_nominal_d: 5.9      # shaft OD (drawing)
    spline_tooth_h: 0.3        # ESTIMATE
    spline_clear: 0.2          # diametral, bore valleys = nominal + clear + fit offset
    spline_fit_offsets: {tight: -0.1, nominal: 0.0, loose: 0.1}   # -> bore valleys 6.0 / 6.1 / 6.2
    round_bore_variants: [5.7, 5.8]   # 0.4 mm nozzle: plain bore the shaft teeth press into (teeth do not print)
    passive_bore_variants: [6.05, 6.15, 6.25, 6.35]
    lead_in: 0.3

# --- printing / fit
fit:
  pocket_clearance: 0.35       # per side, servo case in printed pockets (tune with coupon A)
  bump_margin: 0.4             # extra per side around the raised face areas (they only need to clear, not locate)
  # screws, cross-checked against the SO-101 follower (same servo): horn-to-bracket M3x6 through a 3.5 mm arm
  # (~2.5 mm into the horn); case screws M2x6 through ~2.0 mm of printed wall (~2.5-3 mm into the case)
  horn_screw: {clear_d: 3.4, head_d: 5.6, head_h: 2.4, len: 6.0}
  case_screw: {clear_d: 2.4, head_d: 4.0, head_h: 1.6, len: 6.0, grip: 2.0, seat_d: 4.6}   # grip = wall under the head
  horn_face_gap: 0.0           # arms sit flat on the horn faces
  m2_clear_d: 2.4              # M2 clearance
  m3_clear_d: 3.4
  m3_pilot_d: 2.9              # M3 self-tapping into print (torso_p0 thread test on the A1)
  pad_screw: {len: 10.0, grip: 3.5, seat_d: 6.4}   # 2 x M3x10, front and back of the shin tip into the pad stem;
                               # grip = shin wall left under the head (flat spot face), tips stop ~2.4 mm apart
  m3_nut_af: 5.7               # M3 nut across flats + clearance (captive nut traps)
  m3_nut_h: 2.6
  min_wall: 2.4

# --- joint chain (left leg, world frame: X forward, Y left, Z up; origin on the pelvis centreline at
#     the yaw-servo centre height). Neutral CAD pose = all joints 0 = straight leg.
chain:
  hip_y: 30.0                  # yaw axis 30 mm from the centreline (hip spacing 60, as in the sim)
  arm_t: 3.5                   # U-bracket arm thickness (on the horns)
  arm_disc_r: 10.5             # arm disc radius around the axis (horn r = 10)
  web_r: 18.0                  # U-bracket web inner distance from its axis (servo end corner r = 16.1)
  web_t: 3.5
  stack_gap: 0.3               # gap between a bracket and the next servo end face
  roll_drop: 3.0               # extra drop of the roll stage so the yaw bracket clears the pelvis cup when yawing
  inner_arm_back: 3.0          # inner (idler-side) fork arms extend only this far behind the axis: the servo
                               # connectors sit ~14 mm behind the axis on that face (E: hip extension, knee flexion)
  pitch_web_r: 22.0            # thigh crotch below the pitch axis (deeper than web_r: clears the servo on extension)
  thigh_crotch: {d: 24.0, x_offset: 3.0}   # crotch shallower at the back (servo body is behind the axis)
  thigh_len: 138.0             # hip-pitch axis to knee axis (sim value kept)
  shin_len: 150.0              # knee axis to pad underside, straight leg (sim value kept)
  cheek_t: 3.0                 # servo-case cheek walls
  cheek_clear_r: 21.0          # case cheeks only grip the servo beyond this distance from its axis

# --- slender exterior (the visual pass/fail part). Sections are superellipses: w = lateral (Y),
#     d = fore-aft (X), n = exponent (2 = ellipse, higher = squarer).
thigh:
  top: {w: 42.0, d: 30.0, n: 2.6}      # just below the hip fork
  mid: {w: 37.0, d: 28.0, n: 2.4}
  bot: {w: 34.0, d: 26.5, n: 2.4}      # just above the knee cradle
  wall: 2.4
  knee_cradle_round: 6.0               # corner radius of the exposed knee cradle
shin:
  top: {w: 28.0, d: 24.0, n: 2.4}      # just below the knee fork
  mid: {w: 22.0, d: 21.0, n: 2.2}
  bot: {w: 17.0, d: 24.0, n: 2.2}      # flares fore-aft into the pad
  mid_frac: 0.45
  wall: null                 # modelled solid; the slicer's walls + infill hollow it. A modelled 2.2 mm shell let the
                               # pad socket break into the cavity (stem loose) and, printed lying, trapped tree supports inside
pad:
  length: 30.0                 # fore-aft (sim P30)
  width: 18.0                  # lateral
  thickness: 5.0
  corner_r: 5.0
  stem: {w: 11.0, d: 15.0, h: 10.0}    # plugs into the shin tip
  stance_pitch: 16.0           # pad rotated so it is flat at the sim stance pose (hip 16, knee 32)

# --- bench fixture
pelvis:
  plate_t: 5.0
  x0: -42.0                    # plate extent (world X)
  x1: 34.0
  y_outer: 50.0                # left edge
  y_inner: -72.0               # right edge (overhangs the desk side)
  cup_wall: 3.0
  biped_hip_spacing: 80.0      # P08 two-leg pelvis, yaw axis to yaw axis. Wider than the sim's 60 mm: at 60 the real
                               # legs sit 12.8 mm apart (knee servo + horns), can only adduct ~2 deg together and the
                               # roll brackets collide when both legs yaw while scissoring. 80 clears the full yaw
                               # range and allows ~5 deg of simultaneous adduction (biped_report.json)
tongue:
  length: 150.0                # lies on the desk, clamped with two C-clamps
  width: 70.0
  t: 6.0
  overlap: 30.0

# --- joint ranges for P0 bench tests (deg). Sim ranges: yaw -20..30, roll -14..30, pitch -35..100, knee 0..130.
rom_targets: {hip_yaw: [-20, 30], hip_roll: [-14, 30], hip_pitch: [-35, 100], knee: [0, 120]}

print:
  density_g_cm3: 1.24          # PLA/PETG ~1.24-1.27
  fill_factor: 0.55            # rough solid fraction for 3-4 perimeters + 25 % infill on thin parts
