SeanEZhou/slender-biped/slender_biped/mjx_env.py

"""GPU (MJX) training environment for the slender biped, Brax-compatible.

Control: 50 Hz joint-position targets -> servo model (slender_biped/actuator.py equations,
re-implemented in JAX) evaluated at every 2 ms physics substep:
    u_req = kp * deadzone(q_tgt - q) - kd * qd ;  u = clip(u_req, -1, 1)
    tau   = clip(tau_stall * s_str * (u - qd / (omega0 * s_spd)), +-tau_stall * s_str)
with command latency (whole substeps), target slew limiting and a deadzone standing in
for gear backlash. Saturation (|u_req| > 1) and over-speed are logged as metrics and
penalized, never hidden.

Observations
  state (policy, hardware-plausible): IMU gravity direction + gyro, joint pos/vel,
      previous action, velocity command, gait clock. Noise added.
  privileged_state (critic only): state + true base lin. velocity, pelvis height,
      tip contacts/positions, randomization parameters.
"""
from __future__ import annotations

import json
from dataclasses import dataclass, field
from pathlib import Path

import jax
import jax.numpy as jp
import mujoco
import numpy as np
from brax.envs.base import Env, State
from mujoco import mjx

from . import feet
from .config import MODEL_DIR, load_actuators


def _tilt_obs(g, off):
    """Gravity direction as read by an IMU mounted off by (roll, pitch) = off rad: rotate about x, then y."""
    cr, sr, cp, sp = jp.cos(off[0]), jp.sin(off[0]), jp.cos(off[1]), jp.sin(off[1])
    g = jp.array([g[0], cr * g[1] - sr * g[2], sr * g[1] + cr * g[2]])
    return jp.array([cp * g[0] + sp * g[2], g[1], -sp * g[0] + cp * g[2]])



def series_give(tau0, damp, f, kinv, tau0_lim, kinv2, tc, ts, xp):
    """The give as a spring + damper behind the servo (2026-11-13). tau0: servo torque with the shaft moving as the
    link; damp: its slope in shaft velocity; f: the give. Returns the transmitted torque and the give's rate."""
    a = xp.abs(f); f1 = tau0_lim * kinv                       # give where the soft range starts
    soft = a > f1
    k_loc = xp.where(kinv > 0, 1.0 / xp.where(soft, kinv2, kinv).clip(1e-9), 0.0)
    t_spring = xp.sign(f) * xp.where(soft, tau0_lim + (a - f1) * k_loc, a * k_loc)
    cdamp = k_loc * tc
    fd = xp.where(kinv > 0, (tau0 - t_spring) / (cdamp + damp), 0.0)
    return xp.clip(tau0 - damp * fd, -ts, ts), fd

@dataclass
class EnvConfig:
    model: str = "baseline_A_8dof"
    task: str = "stand"               # stand | walk
    ctrl_dt: float = 0.02
    sim_dt: float = 0.002
    solver_iterations: int = 4
    action_scale: float = 0.35         # rad per unit action around the nominal pose
    # servo
    kp: float = 8.0
    kd: float = 0.05
    slew: float = 8.0
    latency_sub: int = 2               # nominal command latency in physics substeps (4 ms)
    deadzone: float = 0.0015
    strength_scale: float = 1.0        # global torque scale (actuator-strength ablation; 5 V on 7.4 V servos ~ 0.68)
    speed_scale: float = 1.0           # global no-load-speed scale (supply voltage: 5 V on 7.4 V servos ~ 0.68)
    # measured servo firmware behaviour (hardware step tests 2026-11-06, docs/servo_identification.md). Defaults keep
    # the original idealized servo, so older runs evaluate unchanged.
    prof_acc: tuple = (0.0, 0.0)       # optional 3rd entry: hip pitch; (hip, knee) rad/s^2 of the firmware motion profile the internal target follows
                                       # (accelerate, then brake to stop on the command); 0 = off (slew-limited target)
    delay_steps: int = 0               # extra command dead time in whole control steps, on top of latency_sub
    dr_prof_acc: tuple = (1.0, 1.0)    # per-joint multiplier on prof_acc when dr
    dr_delay_steps: tuple = (0, 0)     # dead-time range (control steps) when dr; replaces delay_steps
    dr_volt: tuple = (1.0, 1.0)        # per-episode supply factor on strength and speed together (sag, 5 V vs 7.4 V)
    # domain randomization
    dr: bool = False
    dr_strength: tuple = (0.8, 1.05)
    dr_speed: tuple = (0.8, 1.05)
    dr_kp: tuple = (0.75, 1.25)
    kp_hip_roll: float = 1.0           # 2026-11-11: hip-roll servo stiffness factor. Robot logs: the standing hip roll sags
                                       # 1.4 deg under load vs the model's 3.5 (knees match), and the pelvis lifts the other
                                       # foot 44-59 mm inside the standing board vs 21-31 in sim; 2.5 reproduces both
    # 2026-11-12: encoder-invisible give (walking_clean.md §14, measuring.md E1): the servo and the observation see
    # q + f, the physics moves q, f -> tau / k with a 10 ms lag. ((joint suffix, k N*m/rad), ...); dr_flex scales k per
    # episode (log-uniform). The sim tilt test (scripts/tilt_test_sim.py) matches the robot's 6-7 deg sideways tip and
    # 4-5 deg slip onset at hip_roll k ~3.5-5.
    hidden_flex: tuple = ()
    dr_flex: tuple = (1.0, 1.0)
    # 2026-11-13 (measuring.md E7, full body): entries may be (suffix, k, tau0, k2): k up to |tau| = tau0, k2 beyond.
    # flex_series: the servo damps its shaft (link + give), so the body can ring on the give; flex_tc: the give's time
    # constant, per episode U(dr_flex_tc) when set (structural damping c = k * tc)
    flex_series: bool = False
    flex_tc: float = 0.01
    # round 7 (2026-11-13) frame mode: the robot's pelvis rings at ~4.2 Hz (pitch) / ~5 Hz (roll) when the hip servos
    # move (measuring.md E8 wiggle); the rigid model doesn't. Per entry (axis pitch / roll / yaw, f_hz, zeta, gain,
    # inertia): a damped oscillator driven by the servo targets along the pattern that excites it (high-passed over
    # ring_hp, delayed ring_delay), its acceleration x inertia applied to the pelvis as a torque. dr_ring: per-episode
    # scale ranges (freq lo, hi, zeta lo, hi, gain lo, hi).
    ring: tuple = ()
    ring_hp: float = 0.3
    ring_delay: float = 0.0
    dr_ring: tuple = (0.85, 1.15, 0.6, 1.6, 0.6, 1.5)
    gyro_lpf: float = 0.0              # Hz: first-order low-pass on the gyro the policy sees (robot: policy_stand --gyro-lpf); 0 = off
    flex_dscale: float = 1.0           # share of the servo's damping acting on the give (round 7: small = structural flex outside the servo, rings)
    dr_flex_tc: tuple = ()
    # 2026-11-12 round 5 (walking_clean.md §17): encoder zero errors the servo can't see. ((joint suffix, lo, hi, spread),
    # ...): per episode one common offset U(lo, hi) for the matching joints plus U(-spread, spread) per joint (the legs
    # differ); the servo and the observation read q + off. The robot stands 3.7 deg further back than the model with its
    # boards flat; a knee offset of -0.045 rad reproduces it and the robot's walking pitch.
    hidden_off: tuple = ()
    # backward pull on the pelvis growing with the distance walked (a cable from above): per episode U(0, drag_back) N
    # per m, capped at drag_back_max N
    drag_back: float = 0.0
    drag_back_max: float = 0.0
    tilt_lim: float = 0.06             # rad: `tilt_lim` penalizes (deg^2) tilt past this, roll and backward pitch (forward pitch
                                       # counts half): leaning back-sideways tips the full body over a board corner (2026-11-13)
    roll_lim: float = 0.07             # rad: pelvis roll above which `roll_lim` penalizes (deg^2); the robot's feet slip
                                       # inward from ~4-5 deg of sideways tilt and it tips at 6-7 (measuring.md E1)
    dr_latency_sub: tuple = (0, 6)     # 0-12 ms
    dr_deadzone: tuple = (0.0, 0.015)  # up to ~0.9 deg backlash-like play
    obs_noise: float = 1.0             # multiplier on nominal sensor noise (0 = ideal sensors)
    noise_q: float = 0.005             # rad, joint-angle noise std (x obs_noise); Open Duck trains with 0.03-0.08
    noise_qd: float = 0.3              # rad/s, joint-speed noise std (x obs_noise); Open Duck 2.5 (2026-11-11 robot round 3:
                                       # the policies' actions follow the servos' quantized speed readings -> knee twitch)
    # resets / disturbances
    reset_joint_noise: float = 0.08
    reset_tilt: float = 0.04
    # hand-placement starts (2026-11-07): with probability reset_hard_prob the tilt magnitude is instead uniform in
    # reset_hard_tilt (rad, random direction), and the robot starts already tipping at reset_angvel (rad/s std per
    # horizontal axis, pivoting about the feet). 0 = off (older runs unchanged)
    reset_hard_prob: float = 0.0
    reset_hard_tilt: tuple = (0.0, 0.0)
    reset_angvel: float = 0.0
    # floor randomization when dr: tip-floor friction, and contact softness as the solref time constant (s) and
    # damping ratio. 0.004 / 1 is the hard floor; larger time constants let the pads sink in and rock (mats, carpet)
    dr_friction: tuple = (0.5, 1.2)
    dr_floor_tc: tuple = (0.004, 0.004)
    dr_floor_damp: tuple = (1.0, 1.0)
    push_interval_s: tuple = (2.0, 4.0)
    push_vel: float = 0.0              # m/s std of random base velocity kicks (0 = off)
    # commands
    cmd_vx: tuple = (0.0, 0.0)
    cmd_vy: tuple = (0.0, 0.0)
    cmd_wz: tuple = (0.0, 0.0)
    cmd_zero_prob: float = 1.0
    cmd_resample_s: tuple = (3.0, 6.0)
    cmd_vx_slew: float = 0.0           # m/s^2: the forward command the policy sees (and the reference uses) ramps toward
                                       # the sampled one at this rate (0 = jumps); from rest the first steps are short
    reset_ref_pose: bool = False       # start in the reference's zero-speed pose instead of the stance pose
    # settle gate (2026-11-08, step-and-settle): the gait clock stops at these phases (cycle fractions, the lift-offs)
    # while the body still rotates faster than settle_gate_w rad/s (roll/pitch gyro), for at most settle_gate_max s
    # IMU mounting / calibration error (2026-11-09: the robot reads ~+2 deg roll standing level): the observed gravity
    # direction is rotated by a fixed (roll, pitch) bias plus a per-episode uniform offset of +-dr_imu_tilt rad
    imu_tilt_bias: tuple = (0.0, 0.0)
    dr_imu_tilt: float = 0.0
    settle_gate_u: tuple = ()
    settle_gate_w: float = 0.3
    settle_gate_max: float = 0.5
    heading_cmd: bool = False          # yaw-rate command = clip(k * heading error) (legged-gym style)
    heading_gain: float = 1.0
    gait_hz: float = 1.6               # clock frequency (full gait cycle)
    phase_when_still: bool = False     # apply gait-phase shaping at zero command too (stepping in place)
    # termination
    max_tilt: float = 0.7
    min_height_frac: float = 0.6
    # reward weights
    rw: dict = field(default_factory=lambda: dict(
        track_lin=1.0, track_ang=0.5, upright=1.0, height=0.5, lin_vel_z=-1.0, ang_vel_xy=-0.05,
        torque=-0.02, saturation=-0.5, overspeed=-0.5, action_rate=-0.02, joint_vel=-0.0005,
        over_rated=0.0, heading=0.0, stop=0.0, pose=-0.3, slip=-4.0, feet_air_time=0.0, contact_phase=0.0, swing_height=0.0,
        both_feet=0.0, touchdown=0.0, liftoff=0.0, stride=0.0, ref_q=0.0, ref_tip=0.0, ref_contact=0.0, width=0.0,
        track_vy=0.0, line=0.0, airborne=0.0, settle=0.0, progress=0.0, ref_swing=0.0, land_v=0.0, scuff=0.0, foot_tilt=0.0, ang_acc=0.0, action_acc=0.0,
        clear=0.0, roll_lim=0.0, tilt_lim=0.0, narrow=0.0, board_yaw=0.0, alive=0.5,
        termination=-20.0))
    rated_frac: float = 0.33           # sustained-torque cap as a fraction of stall (vendor rated ~1/3)
    track_sigma: float = 0.01          # velocity-tracking kernel width (m/s)^2
    track_ang_sigma: float = 0.05      # yaw-rate tracking kernel width (rad/s)^2
    heading_sigma: float = 0.1         # heading-hold kernel width rad^2 (only with heading_cmd)
    stop_sigma: float = 0.002          # zero-command "stand still" velocity kernel (m/s)^2
    height_sigma: float = 0.03
    upright_sigma: float = 0.02        # upright kernel exp(-tilt^2 / sigma); 2026-11-11: 0.003 = Open Duck-style torso
                                       # imitation (the shift references keep the pelvis level: tilt 3 deg pays 0.4)
    swing_height: float = 0.025
    air_time_target: float = 0.2
    stride_target: float = 0.06        # m, forward tip travel per step rewarded up to this (stride term)
    # reference gait (round 4, slender_biped/ref_gait.py): imitation terms and optional residual action
    ref_table: str = ""                # models/ref/<name>.npz; "" = off
    ref_residual: bool = False         # q_cmd = q_ref(phase, vx cmd) + action_scale * action
    ref_sigma_q: float = 0.1           # joint-tracking kernel width (rad^2, summed over joints)
    ref_sigma_tip: float = 0.0002      # tip-height tracking kernel width (m^2, summed over tips)
    ref_yaw_weight: float = 1.0        # weight of the hip-yaw joints in ref_q (0 = free for steering)
    ref_swing_h: float = 0.008         # m: lift at which the ref_swing term is fully paid
    width_target: float = 0.08         # m, lateral tip separation (body frame) above which the width term penalizes
    airborne_h: float = 0.0015         # m: a foot counts as off the floor for the airborne (skiing) term above this
    land_h: float = 0.006              # m: land_v penalizes a foot's downward speed below this height (soft touchdown)
    # 2026-11-10 clean steps: scuff = horizontal foot speed^2 within scuff_h of the floor while not planted (scraping,
    # toe catching); foot_tilt = pad tilt (sin^2 pitch + roll) within tilt_h of the floor (flat landings and lift-offs);
    # clear = shortfall of a scheduled swing foot below the reference lift, cm^2
    scuff_h: float = 0.004
    narrow_min: float = 0.065          # m: lateral board-centre separation (body frame) below which `narrow` penalizes (cm^2);
                                       # the 50 mm boards touch at 0.05
    tilt_h: float = 0.02
    tip_condim: int = 3                # tip-floor contact dims; 4 adds the pad's torsional (yaw) friction, which the
                                       # model specifies (0.004) but condim 3 ignores
    # sideways drift (round 5). Extra policy inputs go in FRONT of the 35-dim base state, so the base layout (and
    # obs[-5:-2] = cmd) is unchanged and train.py can widen an older checkpoint's first layer with zero rows.
    obs_vel: str = ""                  # "" | "oracle" (true heading-frame vx, vy) | "odo" (stance-leg odometry estimate)
    obs_accel: bool = False            # accelerometer specific force (body frame, in g) with per-episode bias
    obs_hist: int = 0                  # past control steps of [gravity, gyro, q, qd, action] stacked in front
    odo_noise: float = 0.002           # m, per-step tip-position noise from joint encoders (0.005 rad x ~0.35 m)
    odo_bias: float = 0.01             # m/s, per-episode velocity bias (calibration) std
    odo_scale: float = 0.1             # per-episode scale error (leg-length / kinematics) half-range
    odo_alpha: float = 0.15            # low-pass on the odometry velocity (per 20 ms step)
    odo_contact: str = "sched"         # which tips count as stance: "sched" (reference timing) | "sensed" (foot switch /
                                       # load estimate: contact on this and the previous step, odo_flip reading errors)
    odo_flip: float = 0.03
    odo_src: str = "legs"              # velocity source for obs_vel="odo" and obs_line: "legs" (stance-leg kinematics) |
                                       # "flow" (downward optical-flow sensor: ground velocity x scale error + bias + noise;
                                       # immune to foot slip)
    flow_noise: float = 0.02           # m/s per-sample noise of the flow sensor
    acc_noise: float = 0.01            # g, white noise per sample
    acc_bias: float = 0.03             # g, per-episode bias half-range per axis
    # IMU as on the robot (2026-11-08): the policy's gravity input is the RP2040 firmware's complementary filter
    # (gyro-propagated, pulled toward the accelerometer, which also feels the pelvis accelerating) instead of the true
    # gravity direction. imu_gate: the accelerometer is only used while its magnitude is within this many g of 1 g
    # (0 = always, the original firmware). gyro_range: rad/s clip (0 = none; 4.36 = the original +-250 dps).
    imu_filter: bool = False
    imu_alpha: float = 0.0776          # accelerometer weight per 20 ms (firmware: 0.02 per 5 ms step)
    imu_gate: float = 0.15
    gyro_range: float = 0.0
    vy_avg_tau: float = 0.67           # s, low-pass on heading-frame velocity for track_vy (~ one gait cycle)
    vy_avg_sigma: float = 0.0004       # (m/s)^2 kernel of the cycle-averaged lateral-velocity reward
    vy_avg_mode: str = "ema"           # "ema" (tau above; leaves ~+-0.035 m/s of the gait sway) | "box" (mean over
                                       # exactly one gait cycle: the sway cancels)
    obs_line: bool = False             # policy input: sideways offset from the commanded path, integrated from the
                                       # odometry (odo_v) since the last command change (drifts with the odometry bias)
    line_frame: str = "heading"        # integrate the offset estimate with the odometry in the current-heading frame
                                       # ("heading": a heading error leaks forward speed into it) or projected on the
                                       # path normal using the IMU yaw ("path")
    line_sigma: float = 0.01           # m^2 kernel of the "line" reward on the TRUE offset from the commanded path
    mirror_aug: bool = False           # half the episodes run the mirror image: the policy sees mirrored inputs and its
                                       # action and the reference are mirrored back (exact left-right symmetry data)
    # 2026-11-11 (robot: 4.8 Hz sideways shake, cables pulling the robot over)
    act_lpf: float = 0.0               # action low-pass: a = act_lpf * a_prev + (1 - act_lpf) * a_policy; the filtered action
                                       # is what is commanded, observed as the last action and penalized (robot runner: same)
    tug_force: float = 0.0             # N, max steady horizontal pull on the pelvis (a tense cable); 0 = off
    tug_prob: float = 0.5              # share of the time a pull is on
    tug_s: tuple = (1.0, 4.0)          # s, how long each pull (or pause) lasts
    tug_ramp_s: float = 0.0            # s for a pull to build from 0 to tug_force (a cable tightening); 0 = a step


def _quat_rot_t(q, v):
    """Rotate world vector v into the body frame of quaternion q (w, x, y, z)."""
    w, x, y, z = q
    R = jp.array([[1 - 2 * (y * y + z * z), 2 * (x * y - z * w), 2 * (x * z + y * w)],
                  [2 * (x * y + z * w), 1 - 2 * (x * x + z * z), 2 * (y * z - x * w)],
                  [2 * (x * z - y * w), 2 * (y * z + x * w), 1 - 2 * (x * x + y * y)]])
    return R.T @ v


class SlenderBipedEnv(Env):
    def __init__(self, cfg: EnvConfig):
        self.cfg = cfg
        xml = (MODEL_DIR / f"{cfg.model}_train.xml")
        if not xml.exists():
            xml = MODEL_DIR / f"{cfg.model}.xml"
        self.meta = json.loads((MODEL_DIR / f"{cfg.model}.json").read_text())
        m = mujoco.MjModel.from_xml_path(str(xml))
        m.opt.timestep = cfg.sim_dt
        m.opt.iterations = cfg.solver_iterations
        m.opt.ls_iterations = 2 * cfg.solver_iterations
        if cfg.tip_condim != 3:
            for i in range(m.npair):
                names = {mujoco.mj_id2name(m, mujoco.mjtObj.mjOBJ_GEOM, m.pair_geom1[i]),
                         mujoco.mj_id2name(m, mujoco.mjtObj.mjOBJ_GEOM, m.pair_geom2[i])}
                if names in ({"floor", "L_tip"}, {"floor", "R_tip"}):
                    m.pair_dim[i] = cfg.tip_condim
        self.mj_model = m
        self.sys = mjx.put_model(m)
        self.n_sub = int(round(cfg.ctrl_dt / cfg.sim_dt))
        self.nj = m.nu
        self.joints = self.meta["joints"]
        act = load_actuators()
        specs = [act["catalog"][act["assignments"][self.meta["cfg"]["actuator_set"]][j.split("_", 1)[1]]]
                 for j in self.joints]
        self.ts = jp.array([s["stall_torque"] for s in specs]) * cfg.strength_scale
        self.w0 = jp.array([s["noload_speed"] for s in specs]) * cfg.speed_scale
        self.prof_acc = jp.array([cfg.prof_acc[1] if j.endswith("knee") else
                                   cfg.prof_acc[2] if j.endswith("hip_pitch") and len(cfg.prof_acc) > 2 else
                                   cfg.prof_acc[0] for j in self.joints])
        self.max_delay = max(cfg.delay_steps, cfg.dr_delay_steps[1] if cfg.dr else 0)
        self.q_nom = jp.array(self.meta["nominal_q"])
        lo = np.array([m.jnt_range[m.actuator_trnid[i, 0]][0] for i in range(self.nj)])
        hi = np.array([m.jnt_range[m.actuator_trnid[i, 0]][1] for i in range(self.nj)])
        self.q_lo, self.q_hi = jp.array(lo), jp.array(hi)
        self.base_z = float(self.meta["stand_base_z"])
        sid = lambda n: mujoco.mj_name2id(m, mujoco.mjtObj.mjOBJ_SITE, n)  # noqa: E731
        bid = lambda n: mujoco.mj_name2id(m, mujoco.mjtObj.mjOBJ_BODY, n)  # noqa: E731
        gid = lambda n: mujoco.mj_name2id(m, mujoco.mjtObj.mjOBJ_GEOM, n)  # noqa: E731
        fg, ft, fs = feet.foot_geoms(m)                     # (2, K): every primitive of each foot pad
        self.foot_gid, self.foot_typ, self.foot_size = fg, jp.array(ft), jp.array(fs)
        self.tip_gid = fg[:, 0]                             # pad centre geom
        self.knee_bid = np.array([bid("L_shin"), bid("R_shin")])
        self.pelvis_bid = bid("pelvis")
        self.knee_r = float(m.geom_size[gid("L_knee_col")][0])
        self.left_idx = np.array([i for i, j in enumerate(self.joints) if j.startswith("L_")])
        self.right_idx = np.array([i for i, j in enumerate(self.joints) if j.startswith("R_")])
        kid = mujoco.mj_name2id(m, mujoco.mjtObj.mjOBJ_KEY, "stand")
        self.qpos0 = jp.array(m.key_qpos[kid])
        self._data0 = mjx.make_data(m)
        global TIP_PAIRS
        self.tip_pairs = np.array([i for i in range(m.npair)
                                   if {mujoco.mj_id2name(m, mujoco.mjtObj.mjOBJ_GEOM, m.pair_geom1[i]),
                                       mujoco.mj_id2name(m, mujoco.mjtObj.mjOBJ_GEOM, m.pair_geom2[i])} in
                                   [{"floor", n} for n in feet.foot_names(m)]])
        assert len(self.tip_pairs) == fg.size, self.tip_pairs
        TIP_PAIRS = jp.array(self.tip_pairs)
        global FLOOR_DR
        # a larger sole sinks less into the same rug: MuJoCo's soft-contact sinkage ~ timeconst^2 and doesn't see
        # the area, so the time constant is scaled by sqrt(reference area / pad area) (reference: the 31 x 18 mm pad)
        tc_scale = float(np.sqrt(PAD_AREA_REF / self.meta["pad_area"])) if "pad_area" in self.meta else 1.0
        FLOOR_DR = dict(friction=tuple(cfg.dr_friction), tc=tuple(cfg.dr_floor_tc), damp=tuple(cfg.dr_floor_damp),
                        tc_scale=tc_scale)
        self.ref = None
        if cfg.ref_table:
            from .ref_gait import load
            self.ref = load(cfg.ref_table, jp)
            self.ref_w = jp.array([cfg.ref_yaw_weight if j.endswith("hip_yaw") else 1.0 for j in self.joints])
            assert abs(self.ref["gait_hz"] - cfg.gait_hz) < 1e-6, (self.ref["gait_hz"], cfg.gait_hz)
        self._reset_pitch = 0.0
        if cfg.reset_ref_pose and self.ref is not None:
            from .ref_gait import level_pitch, lookup
            self._reset_pitch = level_pitch(self.mj_model, self.joints, np.asarray(lookup(self.ref, 0.0, 0.0, jp)[0]))
        self._cycle_n = int(round(1.0 / (cfg.gait_hz * cfg.ctrl_dt)))  # control steps per gait cycle
        W = np.zeros((3, self.nj))                                      # frame-mode drive (evaluation.ring_weights)
        for i, j in enumerate(self.joints):
            sg = 1.0 if j.startswith("L") else -1.0
            if j.endswith("hip_pitch"): W[1, i] = 0.5
            if j.endswith("hip_roll"): W[0, i] = -0.5 * sg
            if j.endswith("hip_yaw"): W[2, i] = 0.5
        self._ring_W = jp.array(W)
        self._ring_nbuf = int(np.ceil(cfg.ring_delay * 1.3 / cfg.sim_dt)) + 2
        rp = np.zeros((3, 4))
        for e in cfg.ring:
            rp[{"pitch": 1, "roll": 0, "yaw": 2}[e[0]]] = [2 * np.pi * e[1], e[2], e[3], e[4]]
        self._ring_p = jp.array(rp)
        # obs sizes
        self._frame_size = 3 + 3 + 3 * self.nj                       # history frame: gravity, gyro, q, qd, action
        self._base_size = self._frame_size + 3 + 2
        self._extra_size = ({"": 0, "oracle": 2, "odo": 2}[cfg.obs_vel] + 3 * cfg.obs_accel + int(cfg.obs_line)
                            + cfg.obs_hist * self._frame_size)
        self._state_size = self._extra_size + self._base_size
        # critic extras: averaged velocity + odometry estimate (track_vy), true and estimated path offset (line)
        self._priv_extra = 6 if cfg.rw.get("line", 0.0) else 4 if cfg.rw.get("track_vy", 0.0) else 0
        self._priv_size = self._priv_extra + self._base_size + 3 + 1 + 2 + 6 + 2 + 4 + 3 * self.nj

    # ------------------------------------------------------------------ brax API
    @property
    def observation_size(self):
        return {"state": (self._state_size,), "privileged_state": (self._priv_size,)}

    def _swap(self, x):
        """Left/right joint swap. The hip-yaw and hip-roll axes of the right leg are mirrored in the model, so the
        mirror image of a joint vector is the plain swap (no sign changes)."""
        return jp.concatenate([x[self.right_idx], x[self.left_idx]])

    def extra_obs_stats(self, base_mean, base_std):
        """Initial normalizer (mean, std) for the extra front inputs when widening an older checkpoint."""
        c = self.cfg
        m, s = [], []
        if c.obs_vel:
            m += [0.12, 0.0]; s += [0.08, 0.05]
        if c.obs_accel:
            m += [0.0, 0.0, 1.0]; s += [0.2, 0.2, 0.2]
        if c.obs_line:
            m += [0.0]; s += [0.15]
        for _ in range(c.obs_hist):
            m += list(base_mean[:self._frame_size]); s += list(base_std[:self._frame_size])
        return np.array(m), np.array(s)

    def priv_extra_stats(self):
        return (np.array([0.12, 0.0, 0.12, 0.0, 0.0, 0.0])[:self._priv_extra],
                np.array([0.08, 0.05, 0.08, 0.05, 0.15, 0.15])[:self._priv_extra])

    @property
    def action_size(self):
        return self.nj

    @property
    def backend(self):
        return "mjx"

    # ------------------------------------------------------------------ helpers
    def _tip_low(self, data):
        """Lowest world point of each tip (support function along -z) and the tip centre."""
        low = feet.lowest(jp, data.geom_xpos[self.foot_gid], data.geom_xmat[self.foot_gid], self.foot_typ,
                          self.foot_size)
        return low, data.geom_xpos[self.tip_gid]

    def _sample_servo(self, rng):
        c = self.cfg
        k = jax.random.split(rng, 8)
        u = lambda kk, lohi, n=self.nj: jax.random.uniform(kk, (n,), minval=lohi[0], maxval=lohi[1])  # noqa: E731
        kp_j = jp.array([c.kp_hip_roll if j.endswith("hip_roll") else 1.0 for j in self.joints])
        fk = {e[0]: tuple(e[1:]) for e in c.hidden_flex}
        sel = [next((x for x in fk if j.endswith(x)), None) for j in self.joints]
        kinv0 = jp.array([1.0 / fk[x][0] if x else 0.0 for x in sel])
        tau0 = jp.array([fk[x][1] if x and len(fk[x]) > 2 else 1e9 for x in sel])
        kinv2 = jp.array([1.0 / fk[x][2] if x and len(fk[x]) > 2 else (1.0 / fk[x][0] if x else 0.0) for x in sel])
        tc = (jax.random.uniform(jax.random.fold_in(k[5], 5), (), minval=c.dr_flex_tc[0], maxval=c.dr_flex_tc[1])
              if (c.dr and c.dr_flex_tc) else jp.array(c.flex_tc))
        fx = dict(flex_tau0=tau0, flex_tc=tc)
        if not c.dr:
            return dict(strength=jp.ones(self.nj), speed=jp.ones(self.nj), kp=kp_j, flex_kinv=kinv0, flex_kinv2=kinv2, **fx,
                        latency=jp.array(c.latency_sub, jp.int32), deadzone=jp.full(self.nj, c.deadzone),
                        acc=self.prof_acc, delay=jp.array(c.delay_steps, jp.int32))
        volt = jax.random.uniform(k[5], (), minval=c.dr_volt[0], maxval=c.dr_volt[1])
        lf = jax.random.uniform(jax.random.fold_in(k[5], 3), (), minval=np.log(c.dr_flex[0]), maxval=np.log(c.dr_flex[1]))
        return dict(flex_kinv=kinv0 / jp.exp(lf), flex_kinv2=kinv2 / jp.exp(lf), **fx, strength=u(k[0], c.dr_strength) * volt, speed=u(k[1], c.dr_speed) * volt, kp=u(k[2], c.dr_kp) * kp_j,
                    latency=jax.random.randint(k[3], (), c.dr_latency_sub[0], c.dr_latency_sub[1] + 1),
                    deadzone=u(k[4], c.dr_deadzone), acc=self.prof_acc * u(k[6], c.dr_prof_acc),
                    delay=jax.random.randint(k[7], (), c.dr_delay_steps[0], c.dr_delay_steps[1] + 1))

    def _sample_cmd(self, rng):
        c = self.cfg
        k = jax.random.split(rng, 4)
        cmd = jp.array([jax.random.uniform(k[0], minval=c.cmd_vx[0], maxval=c.cmd_vx[1]),
                        jax.random.uniform(k[1], minval=c.cmd_vy[0], maxval=c.cmd_vy[1]),
                        jax.random.uniform(k[2], minval=c.cmd_wz[0], maxval=c.cmd_wz[1])])
        zero = jax.random.uniform(k[3]) < c.cmd_zero_prob
        return jp.where(zero, jp.zeros(3), cmd)

    def _steps(self, rng, lohi):
        return jax.random.randint(rng, (), int(lohi[0] / self.cfg.ctrl_dt), int(lohi[1] / self.cfg.ctrl_dt) + 1)

    # ------------------------------------------------------------------ reset
    def reset(self, rng):
        c = self.cfg
        rng, k1, k2, k3, k4, k5, k6, k7 = jax.random.split(rng, 8)
        qpos = self.qpos0
        q0 = self.q_nom
        if c.reset_ref_pose and self.ref is not None:
            from .ref_gait import lookup
            q0 = lookup(self.ref, jp.array(0.0), jp.array(0.0), jp)[0]
        q_off = jp.zeros(self.nj)
        for n_, (suf, lo, hi, spr) in enumerate(c.hidden_off):
            ko = jax.random.split(jax.random.fold_in(k1, 100 + n_), 2)
            msk = jp.array([1.0 if j.endswith(suf) else 0.0 for j in self.joints])
            q_off = q_off + msk * (jax.random.uniform(ko[0], (), minval=lo, maxval=hi)
                                   + jax.random.uniform(ko[1], (self.nj,), minval=-spr, maxval=spr))
        qj = q0 - q_off + c.reset_joint_noise * jax.random.normal(k1, (self.nj,))
        qj = jp.clip(qj, self.q_lo, self.q_hi)
        qe = qj + q_off                                      # what the encoders read
        k2, k2h, k2p, k2a, k2w = jax.random.split(k2, 5)
        tilt = c.reset_tilt * jax.random.normal(k2, (2,))
        ang = jax.random.uniform(k2a, minval=-np.pi, maxval=np.pi)
        hard = jax.random.uniform(k2p) < c.reset_hard_prob
        mag = jax.random.uniform(k2h, minval=c.reset_hard_tilt[0], maxval=c.reset_hard_tilt[1])
        tilt = jp.where(hard, mag * jp.array([jp.cos(ang), jp.sin(ang)]), tilt)
        w_tip = jp.where(hard, c.reset_angvel * jax.random.normal(k2w, (2,)), jp.zeros(2))
        yaw = jax.random.uniform(k3, minval=-np.pi, maxval=np.pi)
        # small-angle quaternion from roll/pitch then yaw
        q_rp = jp.array([1.0, tilt[0] / 2, tilt[1] / 2, 0.0])
        q_rp = q_rp / jp.linalg.norm(q_rp)
        if self._reset_pitch:                               # start pose with the pelvis leaned (boards level)
            a = self._reset_pitch
            w1, x1, y1, z1 = q_rp
            q_rp = jp.array([w1 * np.cos(a / 2) - y1 * np.sin(a / 2), x1 * np.cos(a / 2) + z1 * np.sin(a / 2),
                             w1 * np.sin(a / 2) + y1 * np.cos(a / 2), z1 * np.cos(a / 2) - x1 * np.sin(a / 2)])
        q_y = jp.array([jp.cos(yaw / 2), 0, 0, jp.sin(yaw / 2)])
        w1, x1, y1, z1 = q_y
        w2, x2, y2, z2 = q_rp
        quat = jp.array([w1 * w2 - x1 * x2 - y1 * y2 - z1 * z2, w1 * x2 + x1 * w2 + y1 * z2 - z1 * y2,
                         w1 * y2 - x1 * z2 + y1 * w2 + z1 * x2, w1 * z2 + x1 * y2 - y1 * x2 + z1 * w2])
        qpos = qpos.at[3:7].set(quat).at[7:7 + self.nj].set(qj)
        data = self._data0.replace(qpos=qpos, qvel=jp.zeros(self.sys.nv))
        data = mjx.kinematics(self.sys, data)
        low, _ = self._tip_low(data)
        qpos = qpos.at[2].add(-jp.min(low) + 0.0005)
        data = data.replace(qpos=qpos)
        data = mjx.forward(self.sys, data)
        if c.reset_angvel > 0:                              # already tipping: rotation about the feet
            w = jp.array([w_tip[0], w_tip[1], 0.0])         # world frame
            r = jp.array([0.0, 0.0, qpos[2]])               # base above the floor contact
            qvel = jp.zeros(self.sys.nv).at[0:3].set(jp.cross(w, r)).at[3:6].set(data.xmat[1].T @ w)
            data = mjx.forward(self.sys, data.replace(qvel=qvel))
        servo = self._sample_servo(k4)
        kr = jax.random.split(jax.random.fold_in(k4, 77), 4)
        rp = self._ring_p
        if c.dr and c.ring:
            d_ = c.dr_ring
            rp = rp * jp.stack([jax.random.uniform(kr[0], (3,), minval=d_[0], maxval=d_[1]),
                                jax.random.uniform(kr[1], (3,), minval=d_[2], maxval=d_[3]),
                                jax.random.uniform(kr[2], (3,), minval=d_[4], maxval=d_[5]), jp.ones(3)], 1)
        nd = (jp.round(c.ring_delay * jax.random.uniform(kr[3], (), minval=0.7, maxval=1.3) / c.sim_dt) if c.dr
              else jp.round(c.ring_delay / c.sim_dt)).astype(jp.int32)
        servo = dict(servo, ring_p=rp, ring_nd=nd)
        cmd_goal = self._sample_cmd(k5)
        cmd = cmd_goal.at[0].set(0.0) if c.cmd_vx_slew > 0 else cmd_goal
        low, centre = self._tip_low(data)
        rng, kb1, kb2, kb3, kb4 = jax.random.split(rng, 5)
        g0 = _quat_rot_t(data.qpos[3:7], jp.array([0.0, 0.0, -1.0]))
        info = dict(
            g_est=g0,
            rng=rng, servo=servo, cmd=cmd, cmd_goal=cmd_goal, heading=yaw + cmd[2] * 2.0, cmd_timer=self._steps(k6, c.cmd_resample_s),
            push_timer=self._steps(k7, c.push_interval_s), last_act=jp.zeros(self.nj), last_act2=jp.zeros(self.nj),
            w_prev=jp.zeros(2),
            flex=jp.zeros(self.nj), flex_v=jp.zeros(self.nj), prev_cmd=qe, q_tgt=qe, v_tgt=jp.zeros(self.nj), cmd_buf=jp.tile(qe, (self.max_delay + 1, 1)),
            q_off=q_off, drag_x0=qpos[0:2], drag_dir=jp.array([jp.cos(yaw), jp.sin(yaw)]),
            drag_k=c.drag_back * jax.random.uniform(jax.random.fold_in(kb3, 9), ()),
            phase=jp.array(0.0), air_time=jp.zeros(2), gate_held=jp.array(0, jp.int32),
            imu_off=jp.array(c.imu_tilt_bias, dtype=float) + c.dr_imu_tilt * jax.random.uniform(jax.random.fold_in(kb3, 7), (2,), minval=-1.0, maxval=1.0),
            contact_prev=low < 0.0015, tip_prev=centre, lift_pos=centre, step=jp.array(0, jp.int32),
            # round 5: cycle-averaged heading-frame velocity (reward), odometry and accelerometer state, history
            line_p0=qpos[0:2], line_yc=jp.array(0.0), y_est=jp.array(0.0), y_true=jp.array(0.0),
            v_avg=jp.zeros(2), v_buf=jp.zeros((self._cycle_n, 2)), odo_v=jp.zeros(2), odo_p=centre - qpos[0:3],
            odo_bias=c.odo_bias * jax.random.normal(kb1, (2,)),
            odo_scale=1.0 + jax.random.uniform(kb2, minval=-c.odo_scale, maxval=c.odo_scale),
            acc_bias=jax.random.uniform(kb3, (3,), minval=-c.acc_bias, maxval=c.acc_bias),
            acc=jp.array([0.0, 0.0, 1.0]), v_prev=data.qvel[0:3], hist=jp.zeros((c.obs_hist, self._frame_size)),
            mirror=(jax.random.uniform(kb4) < 0.5) & c.mirror_aug,
            tug=jp.zeros(3), tug_goal=jp.zeros(3), tug_timer=self._steps(jax.random.fold_in(kb4, 3), c.tug_s),
            ring=dict(r=jp.zeros(3), rd=jp.zeros(3), us=self._ring_W @ qe, buf=jp.tile(self._ring_W @ qe, (self._ring_nbuf, 1)),
                      i=jp.array(0, jp.int32)),
            w_f=jp.zeros(3),
        )
        metrics = {k: jp.array(0.0) for k in self._metric_keys()}
        obs, frame = self._obs(data, info, jp.zeros(self.nj), jp.zeros((self.nj,)), rng)
        info["hist"] = jp.tile(frame, (c.obs_hist, 1))
        obs, _ = self._obs(data, info, jp.zeros(self.nj), jp.zeros((self.nj,)), rng)
        return State(data, obs, jp.array(0.0), jp.array(0.0), metrics, info)

    def _metric_keys(self):
        return ["r_" + k for k in self.cfg.rw] + ["sat_frac", "overspeed_frac", "peak_tau_frac", "touchdowns",
                                                   "both_contact", "vx", "height", "vy_avg_abs", "air_frac", "swing_clear"]

    # ------------------------------------------------------------------ step
    def step(self, state: State, action):
        c, s_ = self.cfg, state.info["servo"]
        action = jp.clip(action, -1, 1)
        if c.act_lpf > 0:
            action = c.act_lpf * state.info["last_act"] + (1.0 - c.act_lpf) * action
        mir = state.info["mirror"]
        act_real = jp.where(mir, self._swap(action), action)
        phase_next = jp.mod(state.info["phase"] + 2 * jp.pi * c.gait_hz * c.ctrl_dt, 2 * jp.pi)
        if self.ref is not None:
            from .ref_gait import lookup
            # mirrored episode: the mirror image of the reference half a cycle later (identical for symmetric tables)
            q_ref, z_ref, st_ref = lookup(self.ref, jp.maximum(state.info["cmd"][0], 0.0),
                                          phase_next + jp.pi * mir, jp)
            q_ref = jp.where(mir, self._swap(q_ref), q_ref)
            z_ref = jp.where(mir, z_ref[::-1], z_ref)
            st_ref = jp.where(mir, st_ref[::-1], st_ref)
        q_base = q_ref if (self.ref is not None and c.ref_residual) else self.q_nom
        q_cmd = jp.clip(q_base + c.action_scale * act_real, self.q_lo, self.q_hi)
        ts = self.ts * s_["strength"]
        w0 = self.w0 * s_["speed"]
        kp = c.kp * s_["kp"]
        dt = c.sim_dt
        # dead time: commands wait s_["delay"] whole control steps in a FIFO (delay 0 = the original model)
        old_buf = state.info["cmd_buf"]
        new_buf = jp.concatenate([q_cmd[None], old_buf[:-1]], 0)
        cmd_now, cmd_prev = new_buf[s_["delay"]], old_buf[s_["delay"]]
        a_prof = s_["acc"]

        def target_update(q_tgt, v_tgt, cmd):
            """Slew-limited target (original), or the firmware motion profile where a_prof > 0: the target
            accelerates at a_prof toward the command and brakes in time to stop on it, speed capped at slew."""
            slewed = q_tgt + jp.clip(cmd - q_tgt, -c.slew * dt, c.slew * dt)
            e = cmd - q_tgt
            v_des = jp.sign(e) * jp.minimum(c.slew, jp.sqrt(2.0 * a_prof * jp.abs(e)))
            v_new = v_tgt + jp.clip(v_des - v_tgt, -a_prof * dt, a_prof * dt)
            step = v_new * dt
            arrive = (jp.sign(step) == jp.sign(e)) & (jp.abs(step) >= jp.abs(e))   # would pass the command: land on it
            prof_q = jp.where(arrive, cmd, q_tgt + step)
            prof_v = jp.where(arrive, 0.0, v_new)
            on = a_prof > 0
            return jp.where(on, prof_q, slewed), jp.where(on, prof_v, 0.0)

        def ring_sub(data, q_tgt, rs):
            """Frame mode (round 7, evaluation.CpuBiped.ring_step)."""
            u_now = self._ring_W @ q_tgt
            buf = rs["buf"].at[rs["i"]].set(u_now)
            i_n = (rs["i"] + 1) % self._ring_nbuf
            u = buf[(rs["i"] - jp.minimum(s_["ring_nd"], self._ring_nbuf - 1)) % self._ring_nbuf]
            us = rs["us"] + (u - rs["us"]) * min(1.0, dt / c.ring_hp)
            w, z, g, inertia = s_["ring_p"][:, 0], s_["ring_p"][:, 1], s_["ring_p"][:, 2], s_["ring_p"][:, 3]
            rdd = w ** 2 * (g * (u - us) - rs["r"]) - 2 * z * w * rs["rd"]
            rd = rs["rd"] + rdd * dt
            r = rs["r"] + rd * dt
            tq = data.xmat[1] @ (inertia * rdd)
            data = data.replace(xfrc_applied=data.xfrc_applied.at[1, 3:6].set(tq))
            return data, dict(r=r, rd=rd, us=us, buf=buf, i=i_n)

        def sub(carry, i):
            data, q_tgt, v_tgt, acc, flex, flex_v, rs = carry
            cmd = jp.where(i < s_["latency"], cmd_prev, cmd_now)
            q_tgt, v_tgt = target_update(q_tgt, v_tgt, cmd)
            q = data.qpos[7:7 + self.nj] + flex + state.info["q_off"]
            qd = data.qvel[6:6 + self.nj]
            e = q_tgt - q
            e = jp.sign(e) * jp.maximum(jp.abs(e) - s_["deadzone"], 0.0)
            u_req = kp * e - c.kd * qd
            u = jp.clip(u_req, -1, 1)
            tau = jp.clip(ts * (u - qd / w0), -ts, ts)
            if c.hidden_flex and c.flex_series:   # the give as a spring + damper behind the servo (evaluation.series_give)
                tau, flex_v = series_give(tau, ts * (c.kd + 1.0 / w0) * c.flex_dscale, flex, s_["flex_kinv"], s_["flex_tau0"],
                                          s_["flex_kinv2"], s_["flex_tc"], ts, jp)
                flex = flex + flex_v * dt
            if c.ring:
                data, rs = ring_sub(data, q_tgt, rs)
            data = mjx.step(self.sys, data.replace(ctrl=tau))
            if c.hidden_flex and not c.flex_series:
                flex = flex + (tau * s_["flex_kinv"] - flex) * min(1.0, dt / 0.01)
            acc = dict(tau2=acc["tau2"] + jp.sum((tau / self.ts) ** 2) / self.n_sub,
                       over_rated=acc["over_rated"] + jp.sum(jp.maximum(jp.abs(tau) / self.ts - c.rated_frac, 0.0) ** 2) / self.n_sub,
                       sat=jp.maximum(acc["sat"], jp.mean(jp.abs(u_req) > 1.0)),
                       over=jp.maximum(acc["over"], jp.mean(jp.abs(qd) > w0)),
                       peak=jp.maximum(acc["peak"], jp.max(jp.abs(tau) / self.ts)),
                       tau=tau)
            return (data, q_tgt, v_tgt, acc, flex, flex_v, rs), None

        acc0 = dict(tau2=0.0, over_rated=0.0, sat=0.0, over=0.0, peak=0.0, tau=jp.zeros(self.nj))
        data0 = state.pipeline_state
        if c.tug_force > 0 or c.drag_back > 0:
            f_ext = state.info["tug"] if c.tug_force > 0 else jp.zeros(3)
            if c.drag_back > 0:                 # cable from above: pulls back harder the further the robot has walked
                i_ = state.info
                dist = jp.maximum((data0.qpos[0:2] - i_["drag_x0"]) @ i_["drag_dir"], 0.0)
                f_ext = f_ext.at[0:2].add(-i_["drag_dir"] * jp.minimum(i_["drag_k"] * dist, c.drag_back_max))
            data0 = data0.replace(xfrc_applied=jp.zeros_like(data0.xfrc_applied).at[1, :3].set(f_ext))
        (data, q_tgt, v_tgt, acc, flex, flex_v, rs), _ = jax.lax.scan(
            sub, (data0, state.info["q_tgt"], state.info["v_tgt"], acc0, state.info["flex"], state.info["flex_v"],
                  state.info["ring"]), jp.arange(self.n_sub))

        info = dict(state.info)
        info["ring"] = rs
        info["flex"] = flex
        info["flex_v"] = flex_v
        rng, k_cmd, k_ct, k_push, k_pt, k_obs, k_odo, k_acc = jax.random.split(info["rng"], 8)
        cmd_vy_prev = info["cmd"][1]
        if c.tug_force > 0:                     # steady pull: on / off, new direction and size at each switch
            kt = jax.random.split(jax.random.fold_in(k_push, 11), 4)
            info["tug_timer"] = info["tug_timer"] - 1
            sw_t = info["tug_timer"] <= 0
            ang = jax.random.uniform(kt[0], (), minval=0.0, maxval=2 * jp.pi)
            mag = c.tug_force * jax.random.uniform(kt[1], ()) * (jax.random.uniform(kt[2], ()) < c.tug_prob)
            if c.tug_ramp_s > 0:                # pull builds toward its target at tug_force / tug_ramp_s
                info["tug_goal"] = jp.where(sw_t, jp.array([jp.cos(ang), jp.sin(ang), 0.0]) * mag, info["tug_goal"])
                dF = c.tug_force / c.tug_ramp_s * c.ctrl_dt
                info["tug"] = info["tug"] + jp.clip(info["tug_goal"] - info["tug"], -dF, dF)
            else:
                info["tug"] = jp.where(sw_t, jp.array([jp.cos(ang), jp.sin(ang), 0.0]) * mag, info["tug"])
            info["tug_timer"] = jp.where(sw_t, self._steps(kt[3], c.tug_s), info["tug_timer"])
        # pushes
        info["push_timer"] = info["push_timer"] - 1
        do_push = (info["push_timer"] <= 0) & (c.push_vel > 0)
        kick = c.push_vel * jax.random.normal(k_push, (2,))
        qvel = data.qvel.at[0:2].add(jp.where(do_push, kick, 0.0))
        data = data.replace(qvel=qvel)
        info["push_timer"] = jp.where(do_push, self._steps(k_pt, c.push_interval_s), info["push_timer"])

        # ---- kinematic quantities
        quat = data.qpos[3:7]
        g_body = _quat_rot_t(quat, jp.array([0.0, 0.0, -1.0]))
        v_world = data.qvel[0:3]
        v_body = _quat_rot_t(quat, v_world)
        w_body = data.qvel[3:6]
        z = data.qpos[2]
        low, centre = self._tip_low(data)
        contact = low < 0.0015
        tip_v = (centre - info["tip_prev"]) / c.ctrl_dt
        slip = jp.sum(jp.where(contact & info["contact_prev"], jp.sum(tip_v[:, :2] ** 2, -1), 0.0))
        touchdown = contact & ~info["contact_prev"]
        liftoff = ~contact & info["contact_prev"]
        lift_pos = jp.where(liftoff[:, None], centre, info["lift_pos"])
        air = info["air_time"] + c.ctrl_dt
        air_rew = jp.sum(jp.where(touchdown, jp.clip(air - c.air_time_target, -0.3, 0.3), 0.0))
        air = jp.where(contact, 0.0, air)
        if c.settle_gate_u:
            u0, u1 = state.info["phase"] / (2 * jp.pi), phase_next / (2 * jp.pi)
            cross = jp.zeros((), bool)
            for g in c.settle_gate_u:
                cross = cross | (jp.mod(u0 - g, 1.0) > jp.mod(u1 - g, 1.0))
            moving_now = jp.linalg.norm(info["cmd"]) > 1e-3
            hold = (cross & moving_now & (jp.sum(data.qvel[3:5] ** 2) > c.settle_gate_w ** 2)
                    & (info["gate_held"] < int(c.settle_gate_max / c.ctrl_dt)))
            info["gate_held"] = jp.where(hold, info["gate_held"] + 1, 0)
            phase_next = jp.where(hold, state.info["phase"], phase_next)
        info["phase"] = phase_next
        # left stance when sin(phase) >= 0, right when < 0
        s = jp.sin(info["phase"])
        want_contact = jp.array([s >= 0, s < 0])
        cmd = info["cmd"]
        moving = jp.linalg.norm(cmd) > 1e-3
        stepping = moving | c.phase_when_still  # gait-phase shaping active
        swing_target = c.swing_height * jp.abs(s)
        swing_err = jp.sum(jp.where(~want_contact, (low - swing_target) ** 2, 0.0))

        yaw_cur = jp.arctan2(2 * (quat[0] * quat[3] + quat[1] * quat[2]), 1 - 2 * (quat[2] ** 2 + quat[3] ** 2))
        head_err = jp.mod(info["heading"] - yaw_cur + jp.pi, 2 * jp.pi) - jp.pi
        # heading-frame velocity for command tracking (yaw-only frame)
        yaw_fwd = _quat_rot_t(quat, jp.array([1.0, 0.0, 0.0]))
        # ---- round 5: cycle-averaged heading-frame velocity (reward), stance-leg odometry, accelerometer
        cy, sy = jp.cos(yaw_cur), jp.sin(yaw_cur)
        to_head = lambda v: jp.array([cy * v[0] + sy * v[1], -sy * v[0] + cy * v[1]])  # noqa: E731
        if c.vy_avg_mode == "box":
            info["v_buf"] = jp.concatenate([info["v_buf"][1:], to_head(v_world)[None]], 0)
            v_avg = jp.mean(info["v_buf"], 0)
        else:
            v_avg = info["v_avg"] + (c.ctrl_dt / c.vy_avg_tau) * (to_head(v_world) - info["v_avg"])
        # tip positions relative to the pelvis as the joint encoders + IMU attitude would give them (noisy FK); the
        # pelvis moves opposite to the scheduled stance tip(s). On hardware the stance schedule is the same table.
        p_meas = centre - data.qpos[0:3] + c.odo_noise * jax.random.normal(k_odo, (2, 3))
        if c.odo_contact == "sensed" or self.ref is None:
            flip = jax.random.uniform(jax.random.fold_in(k_odo, 1), (2,)) < c.odo_flip
            st_w = ((contact & info["contact_prev"]) ^ flip).astype(float)
        else:
            st_w = st_ref.astype(float)
        st_w = jp.where(jp.sum(st_w) > 0, st_w, jp.ones(2))
        v_leg = -jp.sum(st_w[:, None] * (p_meas - info["odo_p"])[:, :2], 0) / (jp.sum(st_w) * c.ctrl_dt)
        if c.odo_src == "flow":
            b = info["odo_bias"]
            v_flow = (info["odo_scale"] * v_world[:2] + jp.array([cy * b[0] - sy * b[1], sy * b[0] + cy * b[1]])
                      + c.flow_noise * jax.random.normal(jax.random.fold_in(k_odo, 2), (2,)))
            odo_v = info["odo_v"] + c.odo_alpha * (to_head(v_flow) - info["odo_v"])
        else:
            odo_v = info["odo_v"] + c.odo_alpha * (info["odo_scale"] * to_head(v_leg) + info["odo_bias"] - info["odo_v"])
        f_imu = (_quat_rot_t(quat, (v_world - info["v_prev"]) / c.ctrl_dt + jp.array([0.0, 0.0, 9.81])) / 9.81
                 + info["acc_bias"] + c.acc_noise * jax.random.normal(k_acc, (3,)))
        info.update(v_avg=v_avg, odo_v=odo_v, odo_p=p_meas, acc=f_imu, v_prev=v_world)
        if c.imu_filter:
            w_g = data.qvel[3:6]
            if c.gyro_range > 0:
                w_g = jp.clip(w_g, -c.gyro_range, c.gyro_range)
            g_e = info["g_est"]
            g_p = g_e - jp.cross(w_g, g_e) * c.ctrl_dt
            fn = jp.linalg.norm(f_imu)
            use = (jp.abs(fn - 1.0) < c.imu_gate) if c.imu_gate > 0 else jp.array(True)
            al = c.imu_alpha * use
            g_n = (1 - al) * g_p + al * (-f_imu / jp.maximum(fn, 1e-3))
            info["g_est"] = g_n / jp.linalg.norm(g_n)
        # path: line through line_p0 along the commanded heading, shifted sideways by the integrated vy command
        hc, hs = jp.cos(info["heading"]), jp.sin(info["heading"])
        rel = data.qpos[0:2] - info["line_p0"]
        info["line_yc"] = info["line_yc"] + cmd_vy_prev * c.ctrl_dt
        y_true = -hs * rel[0] + hc * rel[1] - info["line_yc"]
        if c.line_frame == "path":
            b = info["odo_bias"]
            vw = info["odo_scale"] * v_leg + jp.array([cy * b[0] - sy * b[1], sy * b[0] + cy * b[1]])
            if c.odo_src == "flow":
                vw = v_flow
            info["y_est"] = info["y_est"] + (-hs * vw[0] + hc * vw[1] - cmd_vy_prev) * c.ctrl_dt
        else:
            info["y_est"] = info["y_est"] + (odo_v[1] - cmd_vy_prev) * c.ctrl_dt
        info["y_true"] = y_true
        # stride: forward (heading-direction) travel of a tip between its lift-off and touchdown
        fwd = jp.array([jp.cos(yaw_cur), jp.sin(yaw_cur)])
        step_len = (centre[:, :2] - lift_pos[:, :2]) @ fwd
        stride = jp.sum(jp.where(touchdown, jp.clip(step_len, 0.0, c.stride_target) / c.stride_target, 0.0))
        rw = c.rw
        tilt2 = jp.sum(g_body[:2] ** 2)
        clear_err = 0.0
        pad_sp, pad_sr = data.geom_xmat[self.tip_gid][:, 2, 0], data.geom_xmat[self.tip_gid][:, 2, 1]  # sin pitch (toe-up +), roll
        if self.ref is not None:
            clear_err = jp.where(moving, jp.sum(jp.where(st_ref, 0.0, jp.maximum(z_ref - jp.maximum(low, 0.0), 0.0) ** 2)) * 1e4, 0.0)
            ref_terms = dict(
                ref_q=jp.exp(-jp.sum(self.ref_w * (data.qpos[7:7 + self.nj] - q_ref) ** 2) / c.ref_sigma_q),
                ref_tip=jp.exp(-jp.sum((jp.maximum(low, 0.0) - z_ref) ** 2) / c.ref_sigma_tip),
                ref_contact=jp.mean(contact == st_ref),
                # step-and-settle (2026-11-08): body rotation rate while the reference has both boards down
                settle=jp.where(moving & jp.all(st_ref), jp.sum(w_body[:2] ** 2), 0.0),
                # the scheduled foot is up during its swing (lowest point, up to ref_swing_h): standing earns nothing
                ref_swing=jp.where(moving, jp.sum(jp.where(st_ref, 0.0, jp.clip(low, 0.0, c.ref_swing_h) / c.ref_swing_h)), 0.0))
        else:
            ref_terms = dict(ref_q=0.0, ref_tip=0.0, ref_contact=0.0, settle=0.0, ref_swing=0.0)
        terms = dict(
            track_lin=jp.exp(-jp.sum((cmd[:2] - v_body[:2]) ** 2) / c.track_sigma),
            track_ang=jp.exp(-(cmd[2] - w_body[2]) ** 2 / c.track_ang_sigma),
            heading=jp.exp(-head_err ** 2 / c.heading_sigma),
            stop=jp.where(moving, 0.0, jp.exp(-jp.sum(v_body[:2] ** 2) / c.stop_sigma)),
            upright=jp.exp(-tilt2 / c.upright_sigma),
            height=jp.exp(-((z - self.base_z) / c.height_sigma) ** 2),
            lin_vel_z=v_world[2] ** 2,
            ang_vel_xy=jp.sum(w_body[:2] ** 2),
            torque=acc["tau2"],
            over_rated=acc["over_rated"],
            saturation=acc["sat"],
            overspeed=acc["over"],
            action_rate=jp.sum((action - info["last_act"]) ** 2),
            joint_vel=jp.sum(data.qvel[6:6 + self.nj] ** 2),
            pose=jp.sum((data.qpos[7:7 + self.nj] - self.q_nom) ** 2),
            slip=slip,
            feet_air_time=air_rew * stepping,
            contact_phase=jp.where(stepping, jp.mean(contact == want_contact), 0.0),
            swing_height=jp.where(stepping, swing_err, 0.0),
            both_feet=jp.where(moving, 0.0, jp.all(contact).astype(float)),
            touchdown=jp.sum(touchdown).astype(float) * (1 - moving),
            liftoff=jp.sum(liftoff).astype(float) * (1 - moving),
            stride=stride * moving,
            **ref_terms,
            width=jp.where(moving, jp.maximum(jp.abs(_quat_rot_t(quat, centre[0] - centre[1])[1]) - c.width_target, 0.0) ** 2
                           * 1e4, 0.0),
            track_vy=jp.exp(-(cmd[1] - v_avg[1]) ** 2 / c.vy_avg_sigma),
            # 2026-11-08: forward progress over the last gait cycle as a fraction of the command (0 for standing still,
            # unlike the velocity kernel, which pays standing ~half at small commands); use vy_avg_mode="box"
            progress=jp.where(moving & (cmd[0] > 0.005), jp.clip(v_avg[0] / jp.maximum(cmd[0], 0.005), -1.0, 1.2), 0.0),
            line=jp.where(moving, jp.exp(-y_true ** 2 / c.line_sigma), 0.0),
            # skiing (2026-11-08): feet lifted off the floor while moving (penalized: both boards stay on the snow)
            airborne=jp.where(moving, jp.sum(low > c.airborne_h).astype(float), 0.0),
            # 2026-11-09: soft touchdown: downward foot speed (m/s)^2 while the foot is off the floor but close to it
            land_v=jp.sum(jp.where(~contact & (low < c.land_h), jp.minimum(tip_v[:, 2], 0.0) ** 2, 0.0)),
            scuff=jp.sum(jp.where((low < c.scuff_h) & ~(contact & info["contact_prev"]), jp.sum(tip_v[:, :2] ** 2, -1), 0.0)),
            # feet off the floor or landing (within tilt_h): pitch (toe-down x2: the toe catches) and roll; planted
            # feet: roll only (a staggered stance without ankle pitch tilts the boards fore-aft by design)
            foot_tilt=jp.sum(jp.where(low < c.tilt_h, jp.where(contact & info["contact_prev"], 0.0,
                                                                (1.0 + (pad_sp < 0)) * pad_sp ** 2) + pad_sr ** 2, 0.0)),
            ang_acc=jp.sum(((w_body[:2] - info["w_prev"]) / c.ctrl_dt) ** 2),
            action_acc=jp.sum((action - 2 * info["last_act"] + info["last_act2"]) ** 2),
            clear=clear_err,
            # boards turned toe-in / toe-out relative to the pelvis heading (sin^2 of each board's yaw): toe-in brings the
            # board ends together while the centres stay apart (c6n_T15: boards overlapping 2-3 mm at 59 mm centre gap)
            board_yaw=jp.sum(jax.vmap(lambda R: _quat_rot_t(quat, R[:, 0])[1] ** 2)(data.geom_xmat[self.tip_gid])),
            roll_lim=(jp.maximum(jp.abs(jp.arctan2(g_body[1], -g_body[2])) - c.roll_lim, 0.0) * 57.3) ** 2,
            tilt_lim=(jp.maximum(jp.sqrt(jp.arctan2(g_body[1], -g_body[2]) ** 2 + (jp.arctan2(-g_body[0], -g_body[2])
                      * jp.where(g_body[0] < 0, 1.0, 0.5)) ** 2) - c.tilt_lim, 0.0) * 57.3) ** 2,
            narrow=(jp.maximum(c.narrow_min - jp.abs(_quat_rot_t(quat, centre[0] - centre[1])[1]), 0.0) * 100.0) ** 2,
            alive=1.0,
            termination=0.0,
        )
        # ---- termination
        knee_z = data.xpos[self.knee_bid][:, 2]
        fallen = (tilt2 > jp.sin(c.max_tilt) ** 2) | (z < c.min_height_frac * self.base_z) | \
                 jp.any(knee_z < self.knee_r) | (g_body[2] > 0)
        nan = jp.any(jp.isnan(data.qpos)) | jp.any(jp.isnan(data.qvel))
        done = (fallen | nan).astype(float)
        terms["termination"] = done
        reward = sum(rw[k] * v for k, v in terms.items())
        reward = jp.where(nan, -rw["alive"], reward)

        # ---- commands
        info["cmd_timer"] = info["cmd_timer"] - 1
        resample = info["cmd_timer"] <= 0
        new_cmd = self._sample_cmd(k_cmd)
        goal = jp.where(resample, new_cmd, info["cmd_goal"])
        info["cmd_goal"] = goal
        if c.cmd_vx_slew > 0:
            ds = c.cmd_vx_slew * c.ctrl_dt
            goal = goal.at[0].set(cmd[0] + jp.clip(goal[0] - cmd[0], -ds, ds))
        info["cmd"] = goal
        yaw_now = jp.arctan2(2 * (quat[0] * quat[3] + quat[1] * quat[2]), 1 - 2 * (quat[2] ** 2 + quat[3] ** 2))
        if c.heading_cmd:
            # sampled wz becomes a heading offset; the command the policy sees is the corrective yaw rate
            info["heading"] = jp.where(resample, yaw_now + new_cmd[2] * 2.0, info["heading"])
            err = jp.mod(info["heading"] - yaw_now + jp.pi, 2 * jp.pi) - jp.pi
            info["cmd"] = info["cmd"].at[2].set(jp.clip(c.heading_gain * err, -0.3, 0.3))
        info["cmd_timer"] = jp.where(resample, self._steps(k_ct, c.cmd_resample_s), info["cmd_timer"])
        info["line_p0"] = jp.where(resample, data.qpos[0:2], info["line_p0"])
        info["line_yc"] = jp.where(resample, 0.0, info["line_yc"])
        info["y_est"] = jp.where(resample, 0.0, info["y_est"])
        info["y_true"] = jp.where(resample, 0.0, info["y_true"])

        info.update(rng=rng, last_act=action, last_act2=info["last_act"], w_prev=w_body[:2], prev_cmd=q_cmd, q_tgt=q_tgt, v_tgt=v_tgt, cmd_buf=new_buf, air_time=air,
                    contact_prev=contact, tip_prev=centre, lift_pos=lift_pos, step=info["step"] + 1)
        metrics = dict(state.metrics)
        for k, v in terms.items():
            metrics["r_" + k] = rw[k] * v
        metrics.update(sat_frac=acc["sat"], overspeed_frac=acc["over"], peak_tau_frac=acc["peak"],
                       touchdowns=jp.sum(touchdown).astype(float), both_contact=jp.all(contact).astype(float),
                       vx=v_body[0], height=z, vy_avg_abs=jp.abs(v_avg[1]),
                    air_frac=jp.mean(~contact), swing_clear=jp.max(jp.where(contact, 0.0, low)))
        if c.gyro_lpf > 0:
            w_m = data.qvel[3:6]
            if c.gyro_range > 0:
                w_m = jp.clip(w_m, -c.gyro_range, c.gyro_range)
            info["w_f"] = info["w_f"] + (1.0 - np.exp(-2 * np.pi * c.gyro_lpf * c.ctrl_dt)) * (w_m - info["w_f"])
        obs, frame = self._obs(data, info, action, acc["tau"], k_obs)
        if c.obs_hist:
            info["hist"] = jp.concatenate([info["hist"][1:], frame[None]], 0)
        return state.replace(pipeline_state=data, obs=obs, reward=reward, done=done, metrics=metrics, info=info)

    # ------------------------------------------------------------------ observations
    def _obs(self, data, info, action, tau, rng):
        c = self.cfg
        quat = data.qpos[3:7]
        g_body = info["g_est"] if c.imu_filter else _quat_rot_t(quat, jp.array([0.0, 0.0, -1.0]))
        g_body = _tilt_obs(g_body, info["imu_off"])
        w_body = data.qvel[3:6]
        if c.gyro_range > 0:
            w_body = jp.clip(w_body, -c.gyro_range, c.gyro_range)
        if c.gyro_lpf > 0:
            w_body = info["w_f"]
        q = data.qpos[7:7 + self.nj] + info["flex"] + info["q_off"] - self.q_nom
        qd = data.qvel[6:6 + self.nj]
        k = jax.random.split(rng, 4)
        n = c.obs_noise
        g_n = g_body + n * 0.03 * jax.random.normal(k[0], (3,))
        w_n = w_body + n * 0.15 * jax.random.normal(k[1], (3,))
        q_n = q + n * c.noise_q * jax.random.normal(k[2], (self.nj,))
        qd_n = qd + n * c.noise_qd * jax.random.normal(k[3], (self.nj,))
        clock = jp.array([jp.sin(info["phase"]), jp.cos(info["phase"])])
        mir = info["mirror"]
        fy = jp.where(mir, jp.array([1.0, -1.0, 1.0]), 1.0)      # polar vectors (gravity, velocity, acceleration)
        fw = jp.where(mir, jp.array([-1.0, 1.0, -1.0]), 1.0)     # axial vectors (angular velocity)
        fc = jp.where(mir, jp.array([1.0, -1.0, -1.0]), 1.0)     # command (vx, vy, wz)
        sw = lambda x: jp.where(mir, self._swap(x), x)  # noqa: E731
        clock = jp.where(mir, -clock, clock)                      # phase + pi: the other leg's half of the cycle
        cmd = info["cmd"] * fc
        g_n, w_n, q_n, qd_n = g_n * fy, w_n * fw, sw(q_n), sw(qd_n)
        frame = jp.concatenate([g_n, w_n, q_n, 0.1 * qd_n, action])   # action is already in the policy's frame
        extra = []
        if c.obs_vel == "oracle":
            yaw = jp.arctan2(2 * (quat[0] * quat[3] + quat[1] * quat[2]), 1 - 2 * (quat[2] ** 2 + quat[3] ** 2))
            vw = data.qvel[0:2]
            extra.append(jp.array([jp.cos(yaw) * vw[0] + jp.sin(yaw) * vw[1], -jp.sin(yaw) * vw[0] + jp.cos(yaw) * vw[1]])
                         * fy[:2])
        elif c.obs_vel == "odo":
            extra.append(info["odo_v"] * fy[:2])
        if c.obs_accel:
            extra.append(info["acc"] * fy)
        if c.obs_line:
            extra.append(jp.clip(info["y_est"], -0.5, 0.5)[None] * fy[1])
        if c.obs_hist:
            extra.append(info["hist"].ravel())
        state = jp.concatenate(extra + [frame, cmd, clock])
        low, centre = self._tip_low(data)
        v_body = _quat_rot_t(quat, data.qvel[0:3])
        tip_rel = jax.vmap(lambda p: _quat_rot_t(quat, p - data.qpos[0:3]))(centre) * fy
        tip_rel = jp.where(mir, tip_rel[::-1], tip_rel).ravel()
        con = (low < 0.0015).astype(float)
        s_ = info["servo"]
        priv = jp.concatenate([
            (jp.concatenate([info["v_avg"], info["odo_v"], jp.clip(jp.array([info["y_true"], info["y_est"]]), -0.5, 0.5)])
             * jp.concatenate([fy[:2], fy[:2], fy[1:2], fy[1:2]]))[:self._priv_extra],
            jp.concatenate([g_body * fy, w_body * fw, sw(q), 0.1 * sw(qd), action, cmd, clock]),
            v_body * fy, data.qpos[2:3], jp.where(mir, con[::-1], con), tip_rel,
            jp.array([self.sys.pair_friction[self.tip_pairs[0], 0], jp.sum(self.sys.body_mass)]),
            jp.array([jp.mean(s_["strength"]), jp.mean(s_["speed"]),
                      (s_["latency"] * c.sim_dt + s_["delay"] * c.ctrl_dt) * 100,      # total command delay
                      jp.mean(s_["deadzone"]) * 100]),
            sw(tau / self.ts), sw(s_["kp"]), sw(s_["deadzone"]) * 100,
        ])
        return {"state": state, "privileged_state": priv}, frame


TIP_PAIRS = jp.array([0, 1])  # set by SlenderBipedEnv from pair names (tip-floor pairs)
FLOOR_DR = dict(friction=(0.5, 1.2), tc=(0.004, 0.004), damp=(1.0, 1.0), tc_scale=1.0)  # set by SlenderBipedEnv
from .feet import PAD_AREA_REF  # noqa: E402  (rug softness reference area)


def randomization_fn(sys, rng, num_envs=None):
    """Per-env model randomization: tip friction, link masses/inertias, armature, gear friction."""
    def rand(key):
        k = jax.random.split(key, 7)
        fr = jax.random.uniform(k[0], minval=FLOOR_DR["friction"][0], maxval=FLOOR_DR["friction"][1])
        pair_friction = sys.pair_friction.at[TIP_PAIRS, 0:2].set(fr)
        # softness: log-uniform time constant (most mats are mildly soft), one per episode for both pads
        lo, hi = np.log(FLOOR_DR["tc"][0]), np.log(FLOOR_DR["tc"][1])
        tc = jp.maximum(jp.exp(jax.random.uniform(k[5], minval=lo, maxval=hi)) * FLOOR_DR["tc_scale"], 0.004)
        dmp = jax.random.uniform(k[6], minval=FLOOR_DR["damp"][0], maxval=FLOOR_DR["damp"][1])
        pair_solref = sys.pair_solref.at[TIP_PAIRS].set(jp.array([tc, dmp]))
        ms = jax.random.uniform(k[1], sys.body_mass.shape, minval=0.85, maxval=1.15).at[0].set(1.0)
        body_mass = sys.body_mass * ms
        body_inertia = sys.body_inertia * ms[:, None]
        pel_off = jax.random.uniform(k[2], (3,), minval=-0.005, maxval=0.005)
        body_ipos = sys.body_ipos.at[1].add(pel_off)
        arm = sys.dof_armature.at[6:].multiply(jax.random.uniform(k[3], (sys.nv - 6,), minval=0.6, maxval=1.6))
        fl = sys.dof_frictionloss.at[6:].multiply(jax.random.uniform(k[4], (sys.nv - 6,), minval=0.5, maxval=2.0))
        return pair_friction, body_mass, body_inertia, body_ipos, arm, fl, pair_solref

    keys = rng if num_envs is None else jax.random.split(rng, num_envs)
    pf, bm, bi, bp, arm, fl, ps = jax.vmap(rand)(keys)
    in_axes = jax.tree_util.tree_map(lambda x: None, sys)
    in_axes = in_axes.tree_replace({"pair_friction": 0, "body_mass": 0, "body_inertia": 0, "body_ipos": 0,
                                    "dof_armature": 0, "dof_frictionloss": 0, "pair_solref": 0})
    sys_v = sys.tree_replace({"pair_friction": pf, "body_mass": bm, "body_inertia": bi, "body_ipos": bp,
                              "dof_armature": arm, "dof_frictionloss": fl, "pair_solref": ps})
    return sys_v, in_axes
