SeanEZhou/slender-biped/(commit log)

2026-10-23 Baseline A ball-tip biped stands and walks without falling in sim
    8-DoF footless biped under hobby-servo limits (MuJoCo/MJX + Brax PPO).
    Selected policy walk_A8_v6b_ft passes all gates on 100 held-out seeds:
    stand 100/100, walk >=2 m 100/100, start/stop 79/100, RMS torque
    <= 0.82x rated. Includes README GIFs, full experiment log E0-E22.
2026-10-24 Feet control experiment and flat-pad tip: feet stop stepping, ball tip cannot stand still
    Footed control frames (40/60/90 mm soles, ankle and rigid) stand without
    lifting a foot; the ball tip steps under every reward and ideal control.
    A 30x18 mm flat pad at the shin tip stands still (1 of 2 seeds) and walks
    with 2x longer steps. New best ball policy cadence_A8_ft: start/stop 98%.
    Experiment log E23-E39, gait/stillness metrics, larger README GIFs.
2026-10-25 Restructure README as a portfolio write-up: concept, design, training, results
    Concept art vs physical model, design-phase actuator and candidate screening,
    policy iteration and control experiments, results with ball-tip and 30 mm pad
    GIFs. New README figures (policy progression, contact comparison, training
    curves, contact candidates) generated by scripts/make_readme_figures.py.
2026-10-26 Add P0 printable leg CAD: direct-drive knee, 30 mm pad, bench fixture
    Parametric build123d model of one 4-DoF leg (4x STS3215-C001) on a desk-clamped
    pelvis fixture, with STL/3MF/STEP exports, mirrored right-leg parts, fit-test
    coupons, interference and range-of-motion checks, renders, BOM, beginner
    assembly guide and a cautious Feetech bench-test script.
    [A_case_pocket_gauge.step, A_case_pocket_gauge.stl, BOM.csv, B_C_horn_and_idler_arms.step, B_C_horn_and_idler_arms.stl, D_hole_and_nut_gauge.step, D_hole_and_nut_gauge.stl, E_pad_socket_coupon.step]
2026-10-27 Fix P0 servo fit from first print; add servo zero/jog/sweep bench tools
    CAD (checked against the SO-ARM100 follower STEP, same STS3215-C001):
    - Case bump widths from the vendor STEP (horn 7.0, idler 9.1 half-width);
    the old idler recess jammed the servo. Zero overlap with the real servo
    in all four joints.
    - Horn screws are M3x6 (3.4 mm holes, 3.5 mm plastic under the head);
    case screws M2x6 with counterbores leaving a 2.0 mm wall.
    - P03: saddle extended flush to the front web, bottom-arm counterbores stop
    at the arm face, and the horn holes are re-cut through the bridge boss.
    - Regenerated exports, renders, coupons and the verification report.
    Bench tool (feetech_bench.py):
    - zero: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
    [A_case_pocket_gauge.step, A_case_pocket_gauge.stl, BOM.csv, B_C_horn_and_idler_arms.step, B_C_horn_and_idler_arms.stl, D_hole_and_nut_gauge.step, E_pad_socket_coupon.step, NOT_PRINTABLE_servo_dummy_STS3215.step]
2026-10-28 Hip yaw + roll bring-up; print-ready STLs for P03, P04, P05
    - build.py exports print-oriented copies to exports/stl/print_ready/
    (PRINT_DOWN table, centred on a 256 mm bed): P03 front web down,
    P04 cradle back face down, P05 thigh on its side with one fork arm on
    the bed. README print table updated; PLA is fine for the bench P0.
    - feetech_bench.py: sweep moves several joints together and reports
    missed targets per joint; set-id verifies the new ID and always
    re-locks the EEPROM (the servo replies from the new ID).
    - bench_config.yaml: hip_yaw (id 1) and hip_roll (id 2) zeroed square;
    roll counts run opposite to +roll, so direction -1. Both joints
    verified in single and combined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
    [P03_yaw_bracket_print.stl, P04_roll_bracket_print.stl, P05_thigh_print.stl]
2026-10-29 Full-leg bring-up: all four joints calibrated, whole-leg routines, solid shin
    Shin (P06):
    - Modelled solid (shin.wall: null). The 2.2 mm modelled shell let the
    10 mm pad socket break into the cavity (stem held by 3 mm, loose above)
    and, printed lying down, trapped tree supports inside. The slicer's
    walls + infill now hollow it.
    - Print-ready copy lying on its side like the thigh.
    - routine: whole-leg keyframe sequences (check, stance, squat, knee_lift,
    kick, step, circle, look); all joints arrive together, every pose is
    limit-checked before moving, ends at neutral. All 57 poses and
    midpoints are collision-free in the CAD.
    - Bus: retries on missed r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
    [NOT_PRINTABLE_servo_dummy_STS3215.step, P01_pelvis_plate.3mf, P01_pelvis_plate.step, P02_clamp_tongue.3mf, P02_clamp_tongue.step, P03_yaw_bracket.3mf, P03_yaw_bracket.step, P04_roll_bracket.3mf]
2026-10-30 Round 3: as-built two-leg model from the CAD, P08 biped pelvis, retrained policies, power audit
    Hardware:
    - P08 two-leg pelvis (both yaw cups in one plate, 80 mm hips; at the sim's
    60 mm the real legs are 12.8 mm apart and collide when both adduct).
    cad/biped.py builds it with a left + mirrored right leg and checks
    inter-leg clearance. Print-ready copies of P01, P02, P07, P08 and the
    right-leg parts; the yaw cup is shared code in leg.py (P01 unchanged).
    - power.md: servo current while standing and walking, supply/wiring sizing.
    Simulation (docs/experiments.md E40-E45):
    - cad/sim_model.py: MuJoCo model of the as-built robot from the CAD
    (per-link mass/inertia with a print model, re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
    [L_pelvis.stl, L_roll.stl, L_shin.stl, L_thigh.stl, L_yaw.stl, P01_pelvis_plate_print.stl, P02_clamp_tongue_print.stl, P03_yaw_bracket_RIGHT_print.stl]
2026-10-30 Bench-tested P0 leg: photo and GIFs in README, load-bearing on 5 V, demo mode
    README:
    - Hero: real-hardware row with the assembled leg photo and three bench
    GIFs (sit-up on its own pad, kick, hip yaw).
    - Section 5: assembled-leg photo; 5.1 the first print's fit failures
    (M2 holes for M3 horn screws, jammed idler recess, through-counterbore)
    and the fix from the SO-101 arm's STEP and screw sizes; 5.2 bench
    tests with GIFs. The PLA leg stands, squats and rises on its pad by
    itself on a 5 V supply with no visible flex, so it bears load.
    - leg_p0 README and verification.md: load-bearing notes updated, weak-arm
    risk retired by test.
    - Raw phone footage (assets/bench_test/) is gitignor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
    [feetech_bench.py]
2026-10-30 Round 4: real-step walking by reference-gait imitation, catwalk variant, walk-to-stand hand-over
    - ref_gait.py: IK reference gait from the as-built leg, indexed by speed and phase; residual actions
    - duty factor 0.65 fixes yaw circling; tip condim 4 enables the pad's specified torsional friction
    - catwalk curriculum (d65_w60 -> d65_cat -> width penalty): 72 mm step width, 6.2 cm steps, 160 ms air
    - switch_eval.py: walker -> hw_stand_push2 hand-over at zero command (85-88 % success)
    - gait_quality.py metrics; README section 7, experiments E46-E56, power.md round-4 rows
    [evaluation.py, mjx_env.py, ref_gait.py]
2026-10-31 Round 5: walking on a line (drift feedback, optical flow); printed STS3215 horns
    Round-4 walkers crabbed sideways (22% stay within 0.2 m of the line over 2 m). Round 5 adds
    sideways-drift sensing and feedback:
    - env/evaluator: velocity inputs (oracle, stance-leg odometry, optical flow), accelerometer,
    observation history, path-offset estimate (heading or path frame), cycle-averaged lateral
    velocity and line rewards, mirror augmentation; separate estimator RNG so older evaluations
    reproduce exactly
    - train.py widen() to fine-tune policies with new inputs
    - drift_eval / drift_mjx / plot_paths / screen_r5 scripts
    - results: r5p_flow (optical flow) 100% on the line, 0.04 m offset; r5q_legs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
    [STS3215_driven_loose.step, STS3215_driven_loose.stl, STS3215_driven_nominal.step, STS3215_driven_nominal.stl, STS3215_driven_round_5p7.step, STS3215_driven_round_5p7.stl, STS3215_driven_round_5p8.step, STS3215_driven_round_5p8.stl]
2026-10-31 Add printable torso: slim shell, triangular hip panels, four-tube stack
    Six parts for a Bambu A1, checked against leg motion in CAD, not yet printed.
    Includes print-ready STLs, an M3 thread test plate, renders and a README section.
    [BOM.csv, T01_hip_front_print.stl, T02_hip_rear_print.stl, T03_pelvis_ring_print.stl, T04_midriff_print.stl, T05_chest_print.stl, T06_shoulders_print.stl, m3_thread_test_print.stl]
2026-11-01 Torso: tested 2.9 mm pilots, neck head mount, sloped chest seam
    Set M3_PILOT to 2.9 mm from the thread test. Add three screw points to the
    T06 neck for a head fitted over its top 8 mm, keeping an 18.5 mm clear bore.
    At the T05/T06 seam the sleeve now follows the chest slope and the screws sit
    square to the wall. M3x6 screws at the two front holes couldn't reach T05
    before. Tube seams now use M3x8. The seam change doesn't affect T01-T04.
    Correct the assembly order so every nut can be reached.
    [BOM.csv, T01_hip_front_print.stl, T03_pelvis_ring_print.stl, T04_midriff_print.stl, T05_chest_print.stl, T06_shoulders_print.stl]
2026-11-01 Document power requirements and plan wiring around voltage drop
    Add per-servo current requirements from the latest walkers to the power doc,
    and a README section on power delivery.
    Add power_wiring.py to compare wiring layouts using simulated current and an
    estimated 0.1 ohm per lead. A single daisy chain leaves the worst servo more
    than 10 % low for 51-69 % of a walk, and one branch per leg still drops 1.4 V.
    Plan separate power feeds for hips and knees, with data left on the chain, and
    raise the supply recommendation to 15 A peak.
    The layout is planned, not built, and the lead resistance is not yet measured.
2026-11-02 Add printable head H1: face part and bolt-on hair cap
    Two parts split on a vertical bore so the cap lifts straight off, leaving the
    head open for later parts such as a camera. Three horizontal M3x12 screws at
    the back and sides hold the cap and stay visible, matching the torso seams.
    Includes the generator, print STLs, fit report, renders and paint previews. Not
    yet printed.
    README: add the head design section; power delivery moves to section 11.
    [BOM.csv, H01_face_print.stl, H02_hair_print.stl]
2026-11-03 Add head H2 "Rebel Princess": sticker face and four hair versions
    Head H2 in hardware/head_p1 mounts like H1: a face part over the T06 neck
    and a hair cap that lifts straight off on three M3 screws. The eyes, brows
    and mouth are stickers, so the face models bone structure, with
    flat-floored eye sockets for the stickers.
    Each design pass is kept in versions/ with its build script, print STLs,
    fit report and renders:
    - v1: ear units
    - v2: no ears; broad triangular locks drawn into a V at the nape
    - v3: v1's layered sides and back; its face part is printed
    - v4 (current): v2's side locks, v1's straight back, tips at least 2.5 mm
    wide; its face file is byte-identical to v3's
    The main README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
    [H11_face_print.stl, H12_hair_print.stl, H13_ear_left_print.stl, H13_ear_right_print.stl]
2026-11-05 Bring up the right leg and add two-leg bench control
    Right leg: bench_config_right.yaml puts it on IDs 5-8 with the same joint
    names and sign conventions as the left. Each servo was zeroed with jog and
    its direction verified by `routine check`. All four directions are flipped
    relative to the left leg, because the mirrored pockets turn each servo
    180 deg.
    Left knee: a new servo replaced the old one. It was zeroed straight
    (offset -1974) and swept clean.
    biped_bench.py drives both legs from one bus as L_* / R_* joints, reusing
    feetech_bench's playback. Routines: home, check, stance, squat, sway,
    turn, march, walk, plus `stand` (stance and hold) and `off`. Before
    anything moves, every pose an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
    [biped_bench.py, feetech_bench.py]
2026-11-06 Document the full-body build, load test and IMU; add README hero and menu
    - Hero row under the title: the assembled robot and a GIF of it marching
    in place, plus a grouped contents menu linking every section.
    - New section 12, full-body assembly and load test: right-leg bring-up
    (IDs 5-8, all four directions opposite to the left's because of the
    mirrored mounts), the left knee servo swap, two-leg control with
    biped_bench.py and its collision rule, and the march load test. The
    marching is open-loop keyframes with no self-balancing, so a hand
    steadies the head. Measured full-body current moves here from
    section 11: 55 mA mean standing, 123 mA mean and 273 mA peak marching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
    [imu_live.py]
2026-11-07 Stand policies on the robot: fitted servo model, recovery training, hip-pitch swap
    - policy_stand.py runs trained stand policies on the robot with IMU safety stops and logging, plus imu-calib,
    imu-check, step-test, timing, reset-gains and a --pitch-trim for the IMU zero
    - Step tests show the servo firmware's motion profile (~400 deg/s^2 on 1:345 hips); the sim servo model now has
    profile acceleration, dead time and voltage scaling, fitted to the tests (fit_servo.py)
    - Retrained stand policies on the fitted model; recovery training shows stepping needs fast hips
    - New hw_p0p191 model (both hip pitches on 1:191) and the hw_recover_p191 policy now running on the robot
    - IMU streaming firmwa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
    [imu_slab.3mf, imu_slab.stl, servo_fit.json]
2026-11-09 Join the pad to the shin with two M3 screws
    The single M2 screw between shin (P06) and pad stem (P07) was too weak. The stem is now held by two M3 screws,
    front and back: 3.4 mm clearance holes through the shin walls with 6.4 mm spot faces, 2.9 mm self-tap pilots
    through the pad stem. Holes verified coaxial (mesh circle fits); left and right pads are identical. Coupon E, BOM
    (2 x M3x10 per leg) and the assembly guide updated.
    [BOM.csv, E_pad_socket_coupon.step, E_pad_socket_coupon.stl, P06_shin.3mf, P06_shin.step, P06_shin.stl, P06_shin_RIGHT.stl, P06_shin_RIGHT_print.stl]
2026-11-09 Big snowboard pads, walking experiments on them, and what we learned
    Foot pads (docs/foot_pads.md, hardware/feet_p1): a rug floor model, thirteen pad designs on the existing stem,
    the F_board150w snowboard recommended and stand policies trained for it (legs only and full body). IMU firmware runs
    the gyro at +-1000 deg/s and gates the accelerometer during hard motion; the simulator can emulate that filter.
    Walking (docs/walking.md, docs/walking_b150.md, README section 16), not yet walking on the robot:
    - RL walkers on a level-sole reference gait; skiing runs (impossible without ankles)
    - step-and-settle walkers: ready-pose start, forward-command ramp, settle gate, pelvis lean; progress and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
    [F_board120.3mf, F_board120.stl, F_board120w.3mf, F_board120w.stl, F_board150.3mf, F_board150.stl, F_board150w.3mf, F_board150w.stl]
2026-11-09 Shift-and-step walking, one-foot balance, and an ankle-roll design study
    Shift-and-step (slender_biped/shift_gait.py): a hip-roll weight shift built into every slow step with a full
    rebalance in between, as an open-loop controller (shiftwalk) and as the reference for RL walkers with a settle gate.
    On the frame as built the best policy (b150_shift2_L 10 M) takes six steps in about a quarter of simulated
    hard-floor walks; one-foot balance lasts ~0.2 s; making falls expensive or adding realistic IMU sensing made it worse.
    Ankle roll study (scripts/make_ankle_model.py, scripts/ankle_study.py): one STS3215 C001 per leg on the board's long
    axis. Scripted, the robot balances on one foot; with RL i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
2026-11-10 Ankle roll on the new leg: CAD, retraining, pad study and slow steps
    - hardware/ankle_p1: shin (A01) with the roll fork and foot (A02) with the servo
    socket, reusing the leg_p0 servo, horn and screw dimensions. Straight shin with
    the fork pitched 16 deg so the bent stance keeps the board flat; clear to
    +-30 deg roll. Socket recesses run out to the open end so the servo slides in.
    - Sim models hw_ank2_* (straight rest pose) and hw_ank3_* (bent stance) for seven
    pads, built from the CAD by scripts/make_ankle2_model.py.
    - Straight legs with flat feet can't lift a foot (no ankle pitch); the bent
    stance can. The 150x50 board walks on hard floor and rugs with no falls; the
    foot-shaped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
    [A01_shin_ankle.3mf, A01_shin_ankle.step, A01_shin_ankle.stl, A01_shin_ankle_RIGHT.stl, A01_shin_ankle_RIGHT_print.stl, A01_shin_ankle_print.stl, A02_foot_ankle.3mf, A02_foot_ankle.step]
2026-11-11 First walks on the robot: ankle roll, clean-step training, full-body marching
    - c3m_T12 is the first policy that walks on the robot: legs and pelvis with the new
    ankle-roll legs, 10+ steps in most trials. c6_T15 stepped on its own foot and c5i_big
    tipped about every other step, though all three scored 0/16 falls in simulation.
    - What made it work: an ankle roll servo per leg (the weight moves over one flat board),
    a continuous 1.2 s shift-and-step reference, imitation anchoring (ref_contact, ref_q),
    and new clean-step penalties (scuff, foot_tilt, ang_acc, action_acc, clear, narrow,
    board_yaw) at the steadiness x2 sweet spot.
    - c3f_T12: c3m fine-tuned with torso and head. It balance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
2026-11-11 Collect the project's lessons in docs/lessons.md
    One place for what we have learned, each lesson linked to the doc with the data:
    - Design for margin, not precision: the sim-to-real lesson of the tip foot and the
    ankle-less pads.
    - What led to the first walk, at a glance: the ankle, then imitating a continuous
    gait (joints and foot up/down timing), then moderate clean-step penalties, then
    choosing on the robot. Key training lesson: imitation first, penalties second.
    - Techniques borrowed from Open Duck Mini, humanoid-gym and unitree_rl_gym, and
    whether each worked.
    - Training recipe, servo and floor modelling, mechanics, policy selection, robot
    bring-up, process and open questions.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
2026-11-12 Measure the robot, fit the hip give into the simulator, and walk steadier than c3m
    After c3m_T12, about fifteen fine-tunes beat it in simulation and fell on the robot:
    c3m had been lucky, and the gap was the simulator. Measuring exercises (E0-E6,
    docs/measuring.md) showed the robot tips sideways at 6-7 deg where the rigid model
    says 14.9: the hips give where the encoders can't see, and each sway narrows the
    stance. That give, fitted to the tilt test (4 N*m/rad), makes the simulator rank
    the old policies as the robot does. Policies trained on it (s7_narrow, s8_push,
    s10_robust) all walk on the robot from the first step and outlast c3m; the new
    failure is a slow backward lean.
    - exercises.py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
    [F_outer_strip15.3mf, F_outer_strip15.stl, F_outer_strip25.3mf, F_outer_strip25.stl, imu_slab.3mf, imu_slab.stl]
2026-11-13 Round 5 on the robot: centred stance and toe catches, cables off the robot, full body shaking at 5 Hz
    The simulator gains encoder zero offsets the servos can't see (the knee offset stands the model 3.7 deg back, as the
    robot stands) and a backward pull at the pelvis. The pull turned out to be mostly the cables: hovered above the robot
    they no longer pull, and trials became consistent. Trained on the lean, the b policies stand centred and walk on the
    robot for minutes (b7_seed2 122 s, the best leg policy so far), but their forward lean tips the swing board toe-down,
    so the toes catch the rug. b7's toe-out brings its heels close. The full-body policies step forward, unlike c3f,
    but fall sidewa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
    [evaluation.py, mjx_env.py]
2026-11-14 Rounds 6-7: the full body's 5 Hz shake loop, a ringing simulator, and h4 + action filter walking for minutes
    Robot: the full-body shake is a feedback loop (frame rings at 4-5 Hz, the policy answers the gyro at the hip pitches
    and knees). h4_t05 with --act-lpf 0.6 walked 188 s (299 steps), 74 s and 76 s: the current best full-body policy.
    Round 7's policies trained with the filter tame the ring but lean 7-12 deg forward and catch their toes.
    - Measurements: tap tests (E7), weight, tilt, push and shift (E0-E6), wiggle frequency response (E8,
    exercises.py wiggle with --lean and the squat pattern).
    - Simulator: re-massed models (m2), series give, tilt-limit reward, frame-mode ring fitted to E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
